techav-homebrew/PikaPC/README.md

PikaPC Logo

# PikaPC

A PowerPC 403GA Homebrew Computer
