techav-homebrew/PikaPC/Software/ppcforth-0.42b/ppcforth.pdf

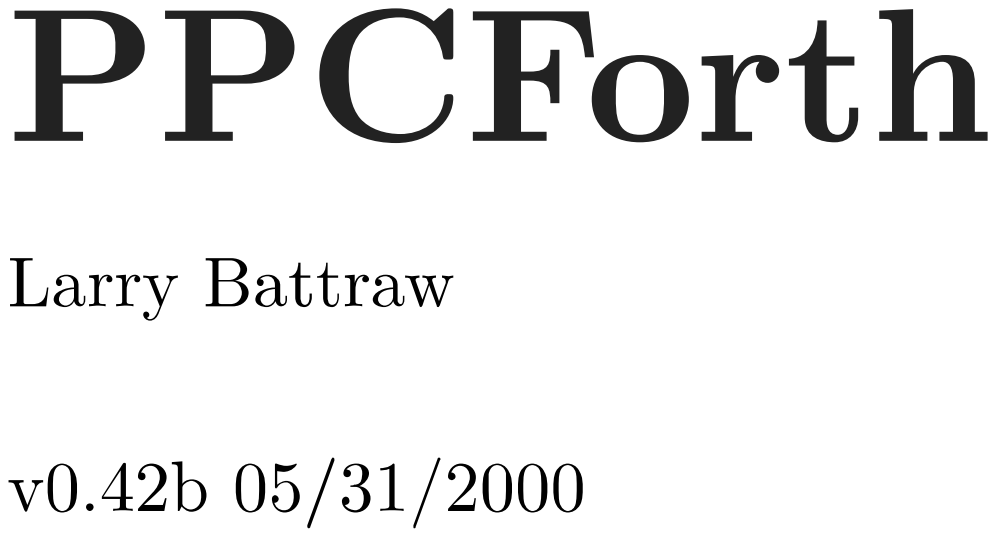
[picture p1: page 1]

@ | ! | emit | key

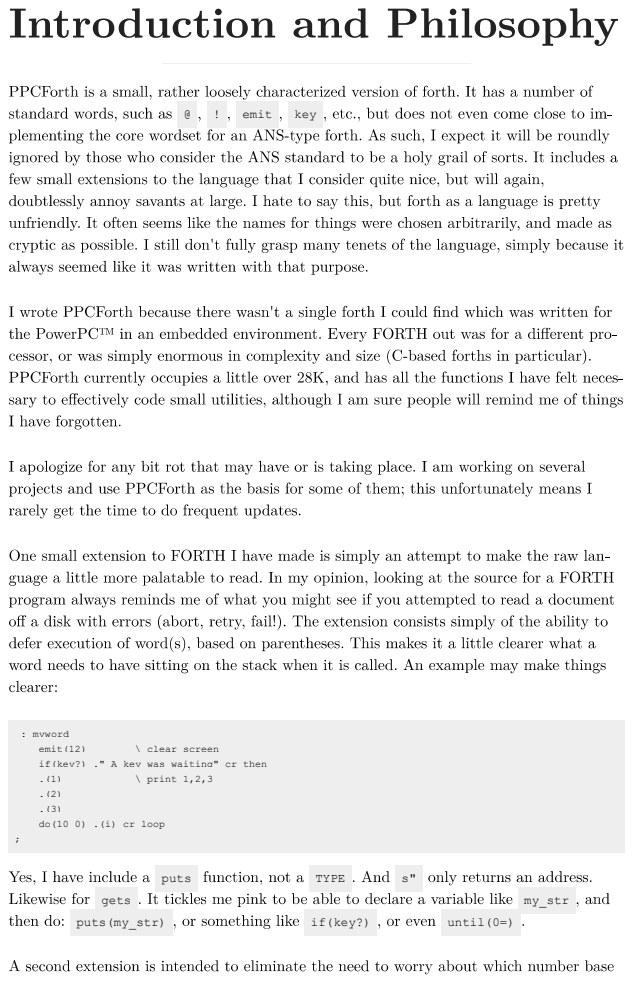
[picture p2: page 2]
emit(12); \ clear screen; \ print 1,2,3; puts; TYPE; gets; my_str; puts(my_str); if(key?); until(0=)

: myword
if(key?) ." A key was waiting" cr then
do(10 0) .(i) cr loop

0x | $
% | # | 0x | $ | #

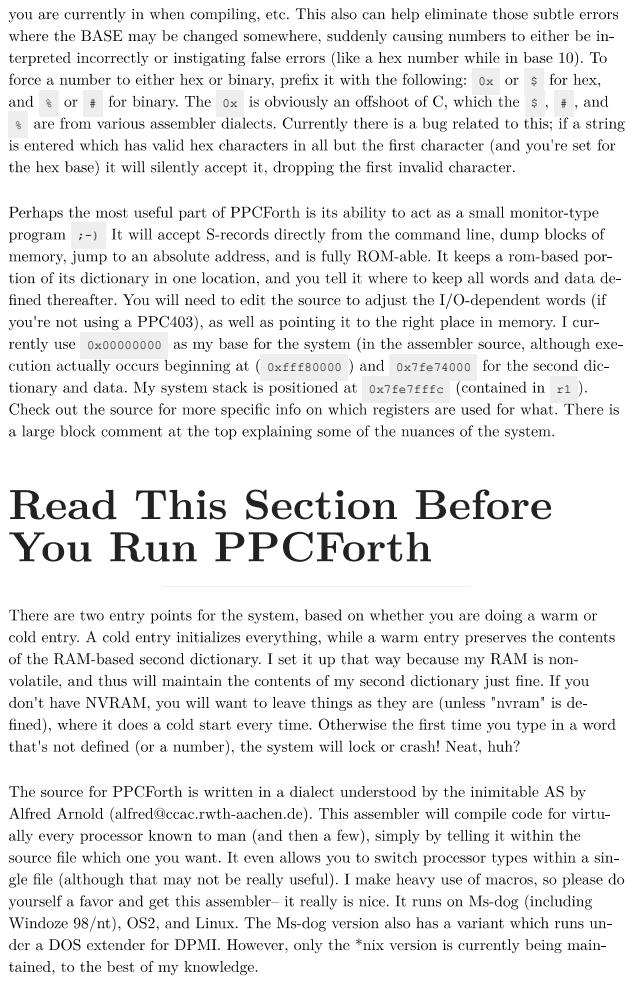
[picture p3: page 3]
0xfff80000; 0x7fe7fffc

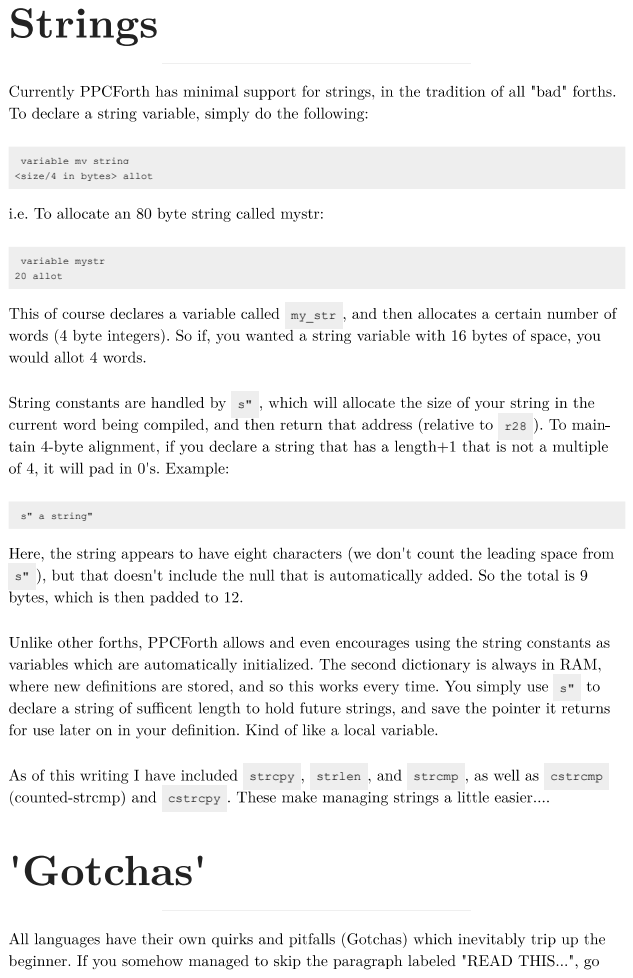
[picture p4: page 4]
variable mystr 20 allot; my_str; s" a string"; strcpy; strlen; strcmp; cstrcmp; cstrcpy

variable my_string
<size/4 in bytes> allot

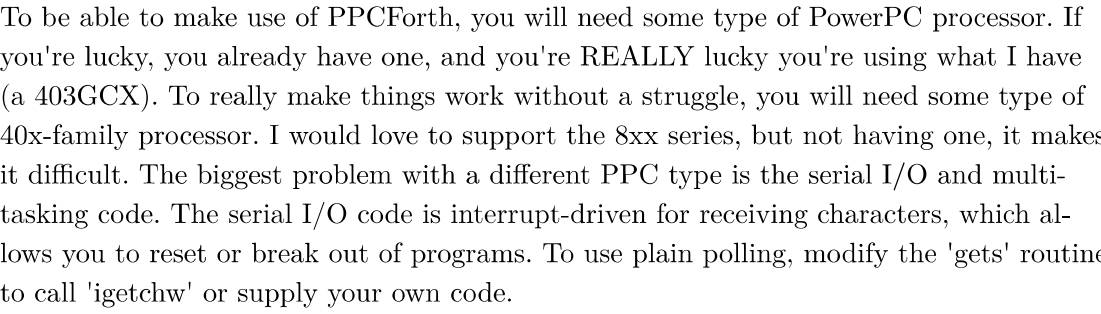
[picture p5: figure]

<32-bit value representing total length of word>
<32-bit value representing combined length of word's name and PFA> <null terminated ASCII string of word's name; padded to 4-alignment> <PFA- parameter field; contains flags specifying the word's type> <data or code field; contains the executable code or data of the word>

<callback time in clock ticks>
<preempt time in clock ticks>
<priority (lower number==greater priority)>

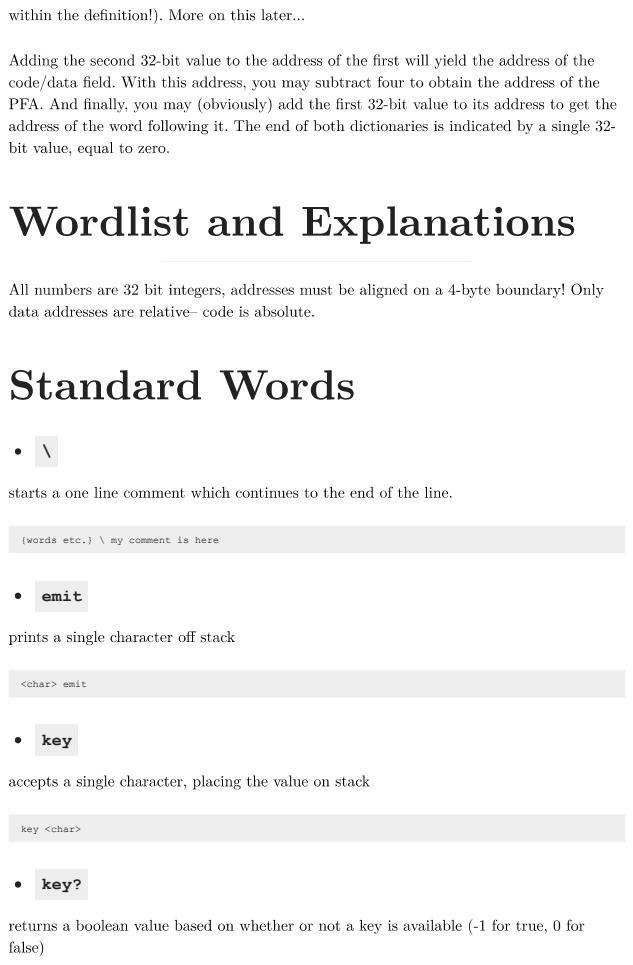
[picture p6: page 6]
emit; <char> emit; key; key <char>; key?

{words etc.} \ my comment is here

## cls

## puts

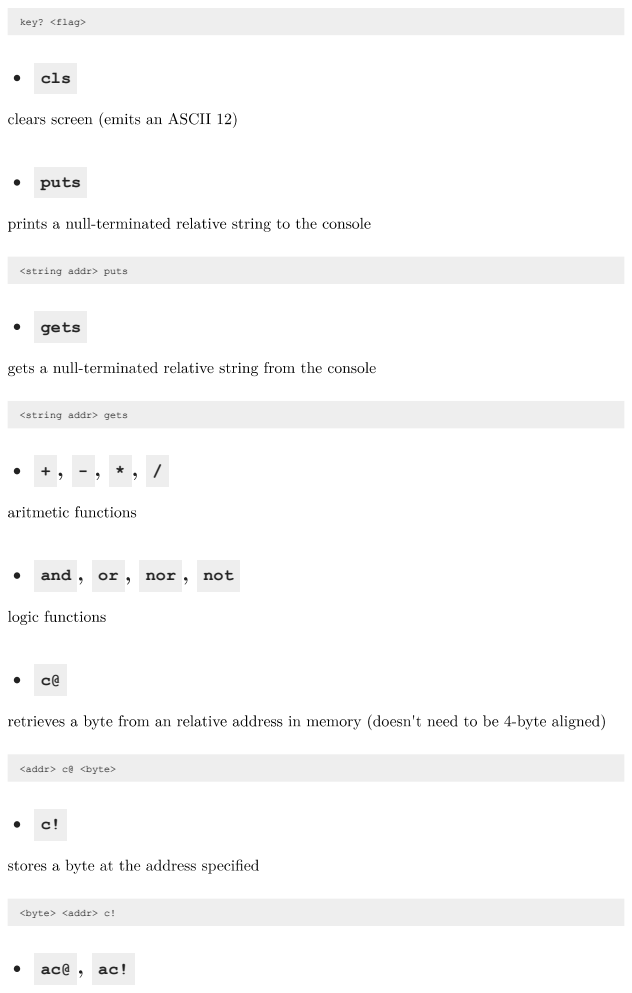
[picture p7: page 7]
key? <flag>; gets; and; nor; not; <addr> c@ <byte>; <byte> <addr> c!

<string addr> puts

<string addr> gets

@

!

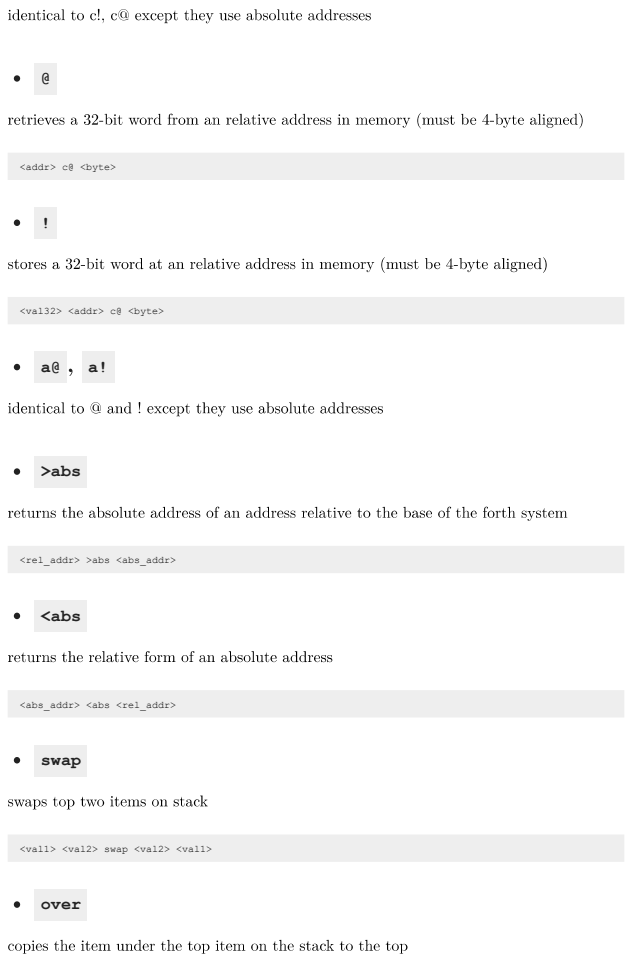
[picture p8: page 8]
<addr> c@ <byte>; <val32> <addr> c@ <byte>; >abs; <rel_addr> >abs <abs_addr>; <abs; <abs_addr> <abs <rel_addr>; swap; <val1> <val2> swap <val2> <val1>; over

>R

R>

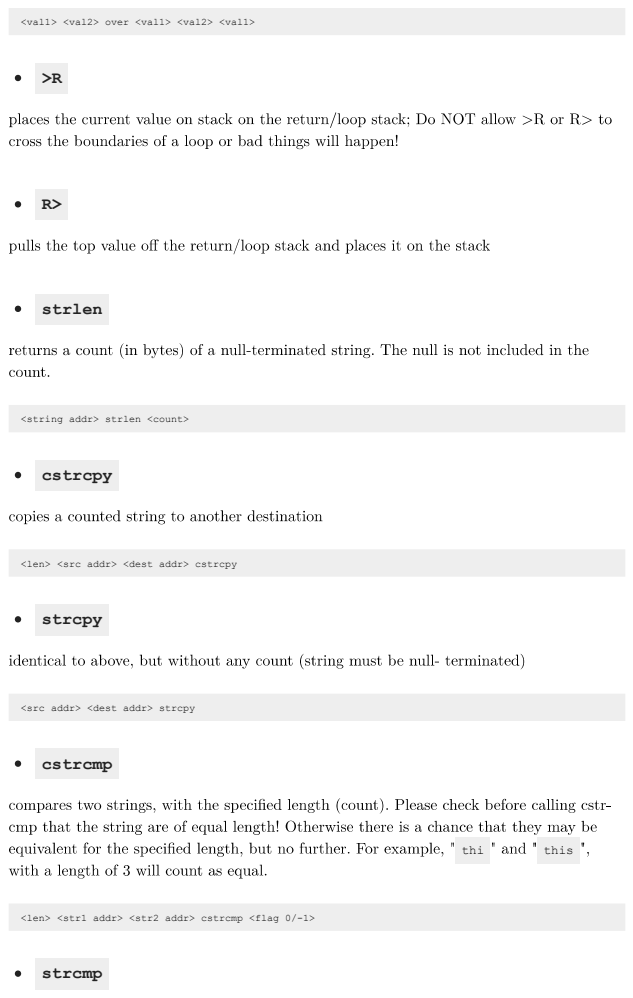
[picture p9: page 9]
<val1> <val2> over <val1> <val2> <val1>; strlen; cstrcpy; strcpy; cstrcmp; thi; this; strcmp

<string addr> strlen <count>

<len> <src addr> <dest addr> cstrcpy

<src addr> <dest addr> strcpy

<len> <str1 addr> <str2 addr> cstrcmp <flag 0/-1>

1- | 2- | 4- | 1+ | 2+ | 4+

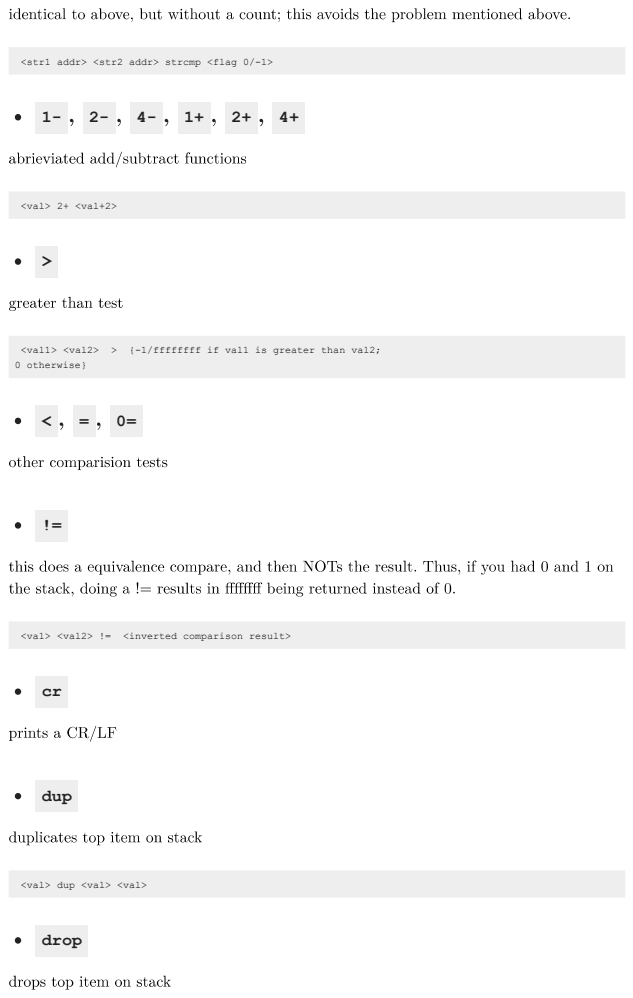
[picture p10: page 10]
<val> 2+ <val+2>; dup; drop

<str1 addr> <str2 addr> strcmp <flag 0/-1>

<val1> <val2> > {-1/ffffffff if val1 is greater than val2;
0 otherwise}

<va1> <val2> != <inverted comparison result>

<val> dup <val> <val>

## sbuf

## base

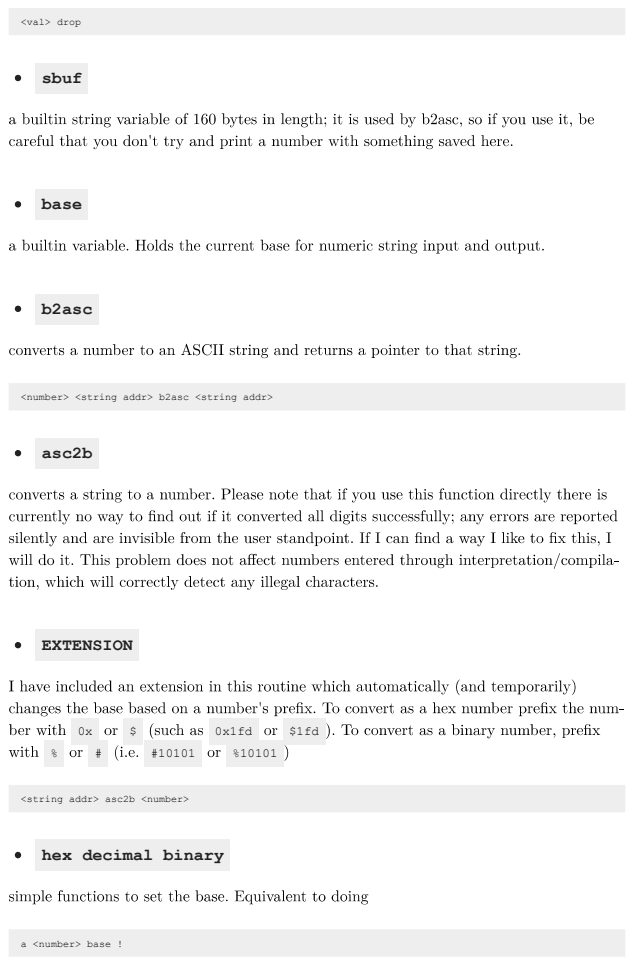
[picture p11: page 11]
<val> drop; b2asc; asc2b; EXTENSION; a <number> base !

<number> <string addr> b2asc <string addr>

<string addr> asc2b <number>

hex decimal binary

,

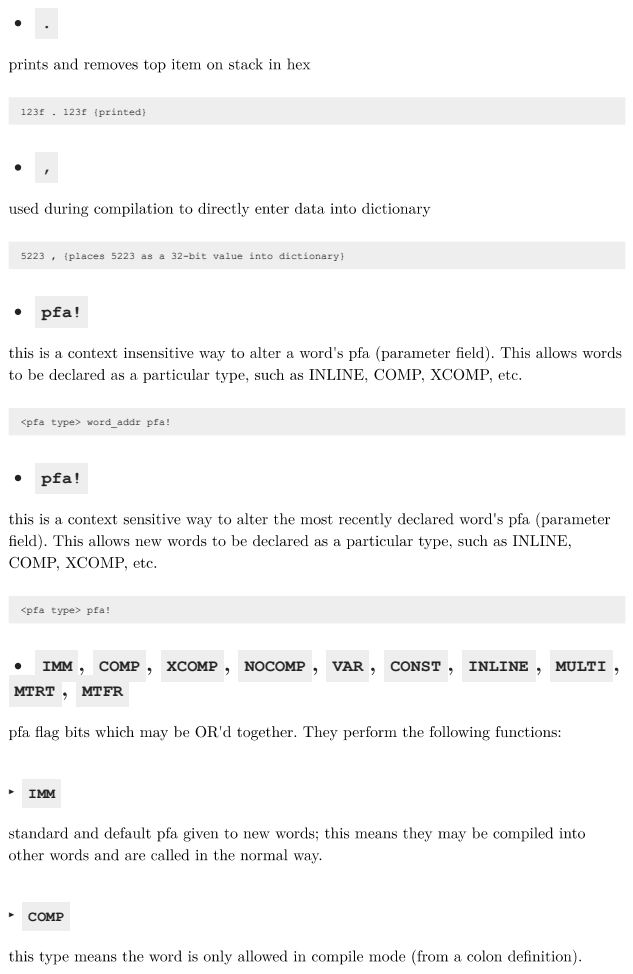
[picture p12: page 12]
123f . 123f {printed}; pfa!; IMM; COMP; XCOMP; NOCOMP; VAR; CONST; INLINE; MULTI; MTRT; MTFR; ‣ IMM; ‣ COMP

5223 , {places 5223 as a 32-bit value into dictionary}

<pfa type> word_addr pfa!

<pfa type> pfa!

## - XCOMP

## - NOCOMP

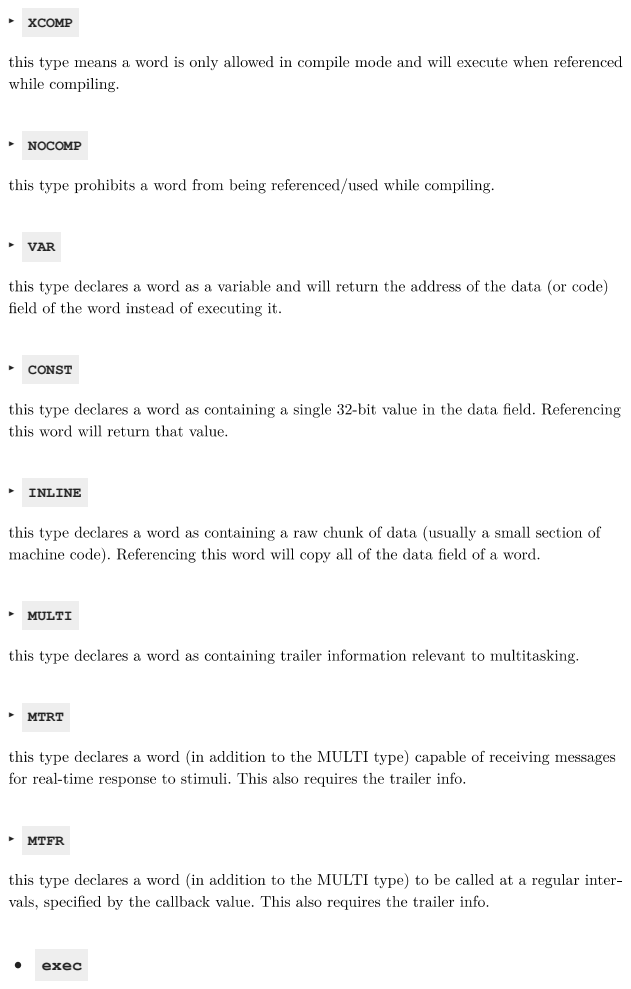
[picture p13: page 13]
‣ VAR; ‣ CONST; ‣ INLINE; ‣ MULTI; ‣ MTRT; ‣ MTFR; exec

## create

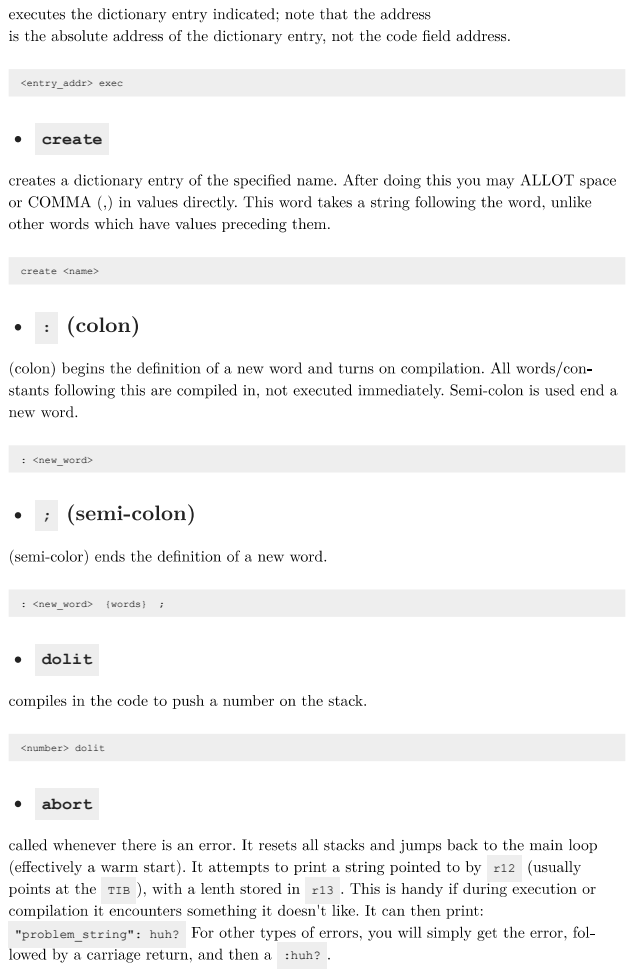
[picture p14: page 14]
<entry_addr> exec; create <name>; : <new_word>; : <new_word> {words} ;; dolit; <number> dolit; abort; TIB; "problem_string": huh?; :huh?

## if else then

### <flag> if {code} else {code} then

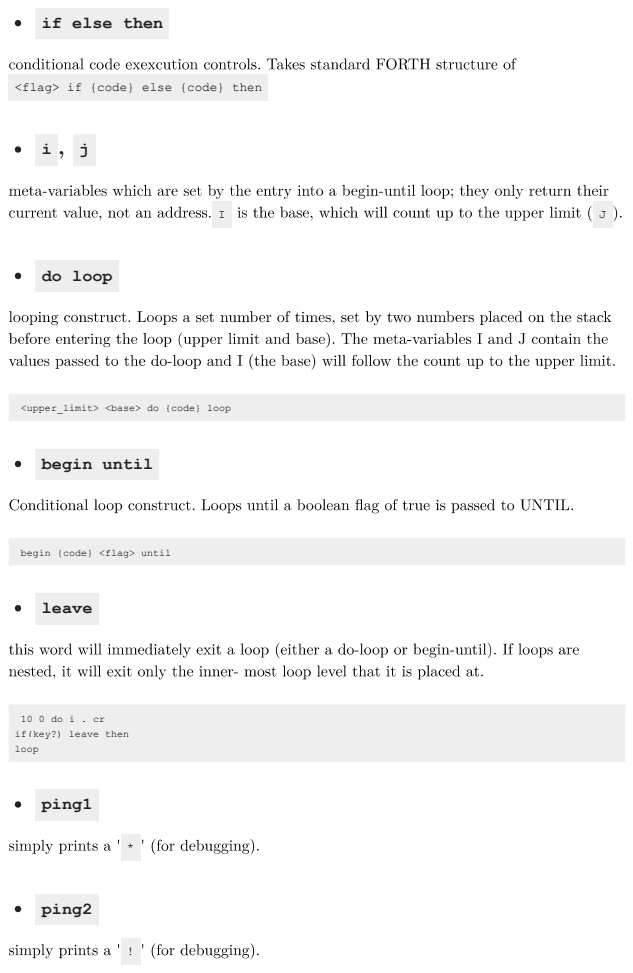
[picture p15: page 15]
do loop; begin until; leave; ping1; ping2

<upper_limit> <base> do {code} loop

begin {code} <flag> until

if(key?) leave then
loop

## words

.s

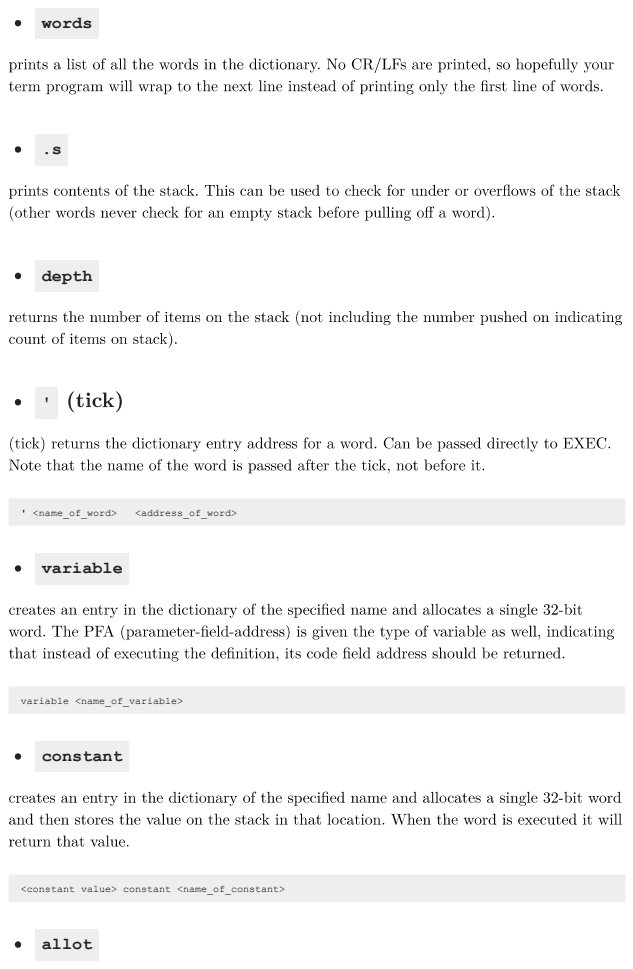
[picture p16: page 16]
depth; ' <name_of_word>; <address_of_word>; variable; variable <name_of_variable>; constant; allot

<constant value> constant <name_of_constant>

## string

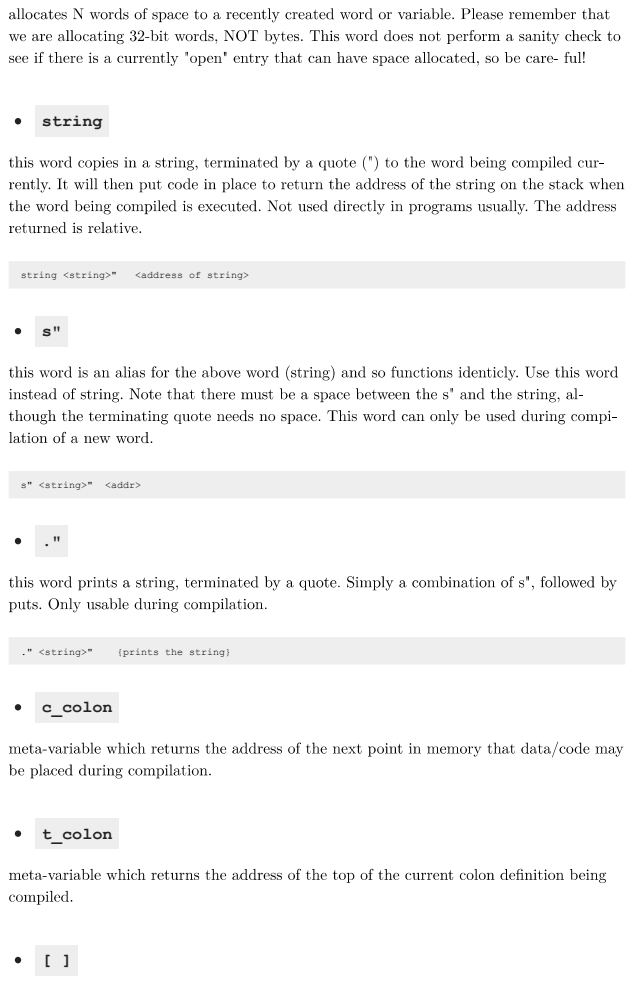
[picture p17: page 17]
string <string>"; <address of string>; s" <string>" <addr>; ." <string>"; {prints the string}; c_colon; t_colon

## forget

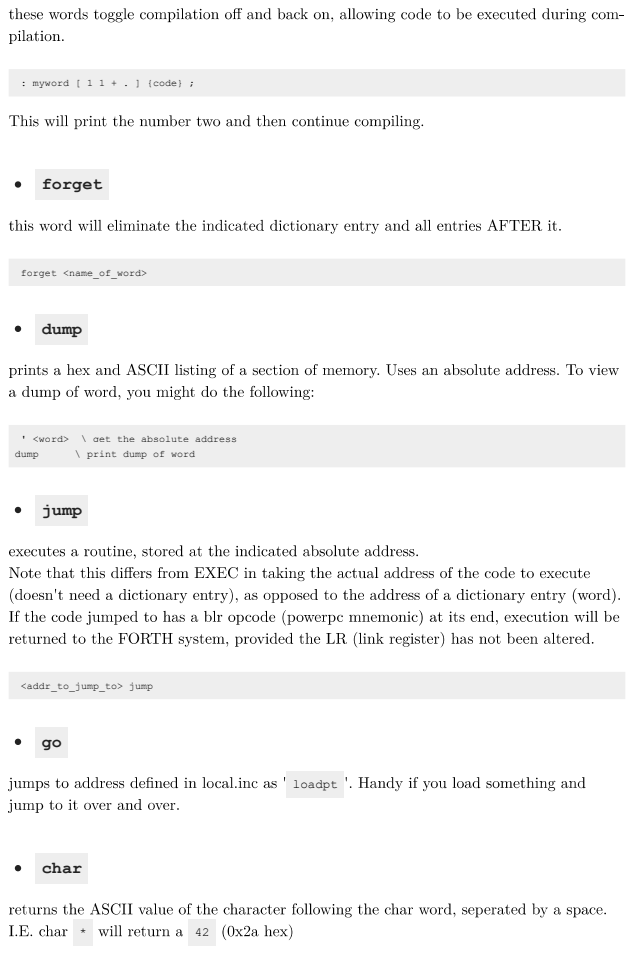
[picture p18: page 18]
: myword [ 1 1 + . ] {code} ;; forget <name_of_word>; dump; \ print dump of word; jump; <addr_to_jump_to> jump; loadpt; char

' <word> \ get the absolute address

## cold

## warm

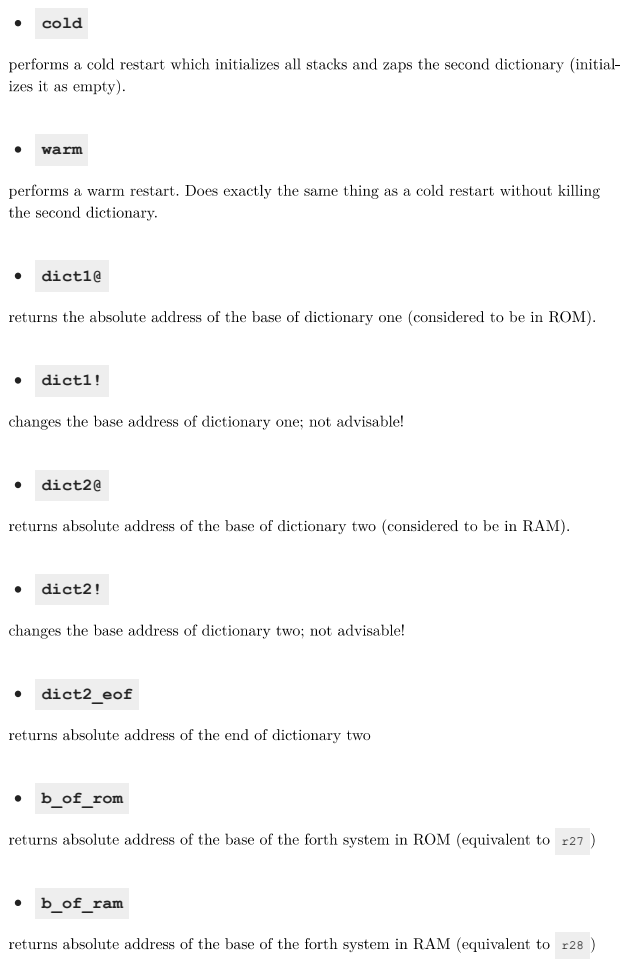
[picture p19: page 19]
dict1@; dict1!; dict2@; dict2!; dict2_eof; b_of_rom; b_of_ram

## <S Record>

S3 | S0

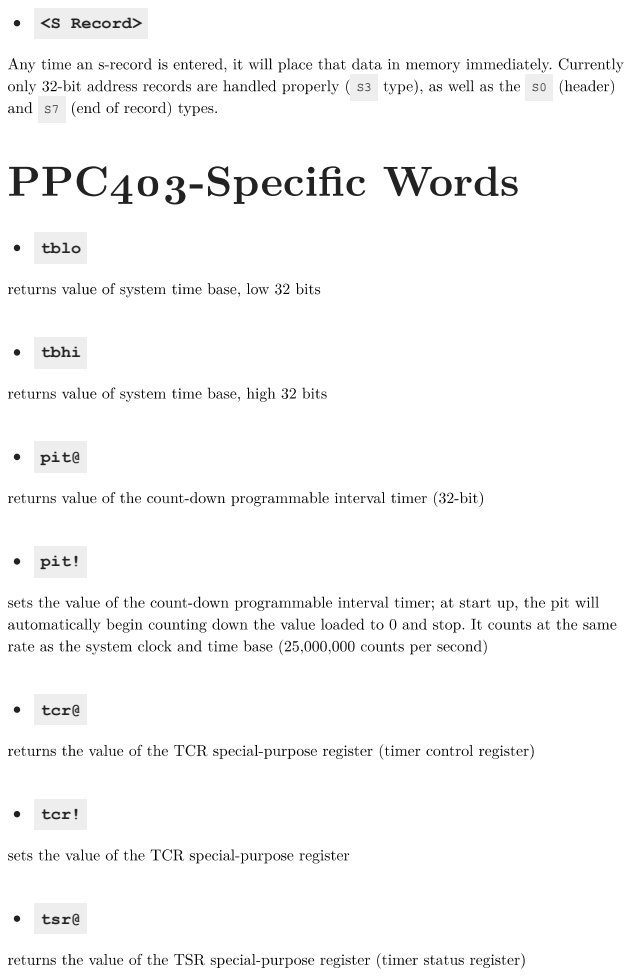
[picture p20: page 20]
tblo; tbhi; pit@; pit!; tcr@; tcr!; tsr@

## tsr!

## msr@

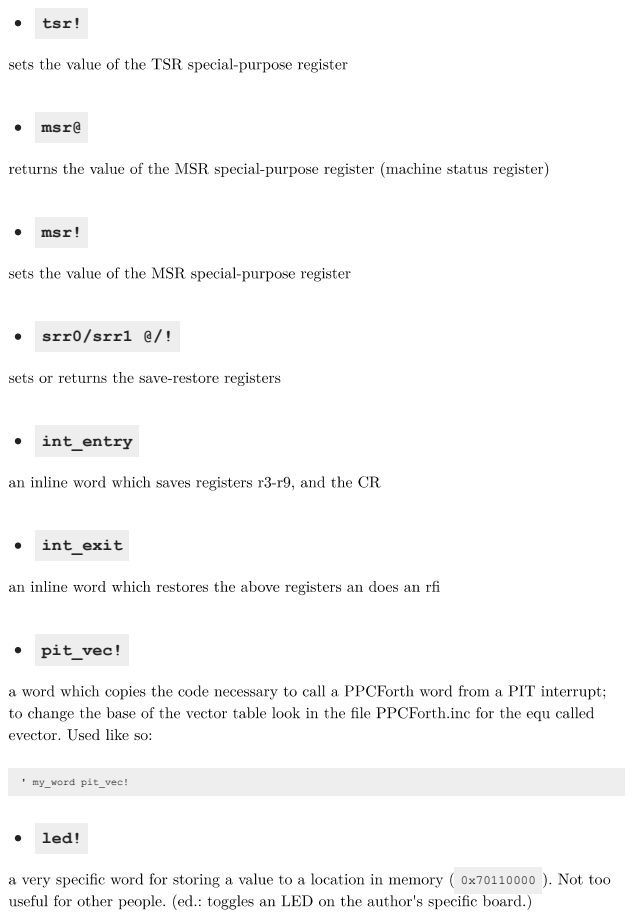
[picture p21: page 21]
msr!; srr0/srr1 @/!; int_entry; int_exit; pit_vec!; ' my_word pit_vec!; led!

## memcpy

## flashc!

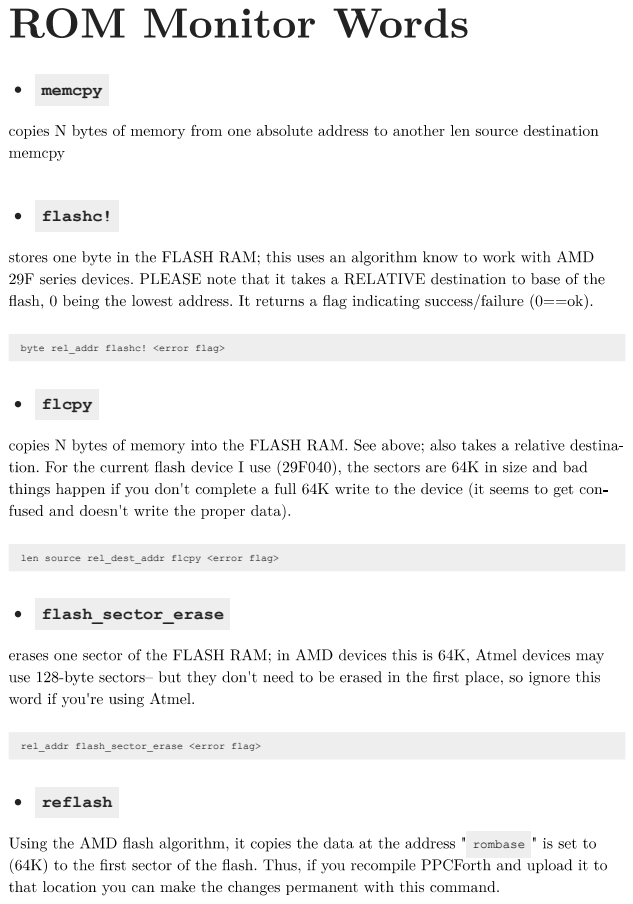
[picture p22: page 22]
flcpy; flash_sector_erase; rel_addr flash_sector_erase <error flag>; reflash; rombase

byte rel_addr flashc! <error flag>

len source rel_dest_addr flcpy <error flag>

## atmel_fwrite

### flcpy

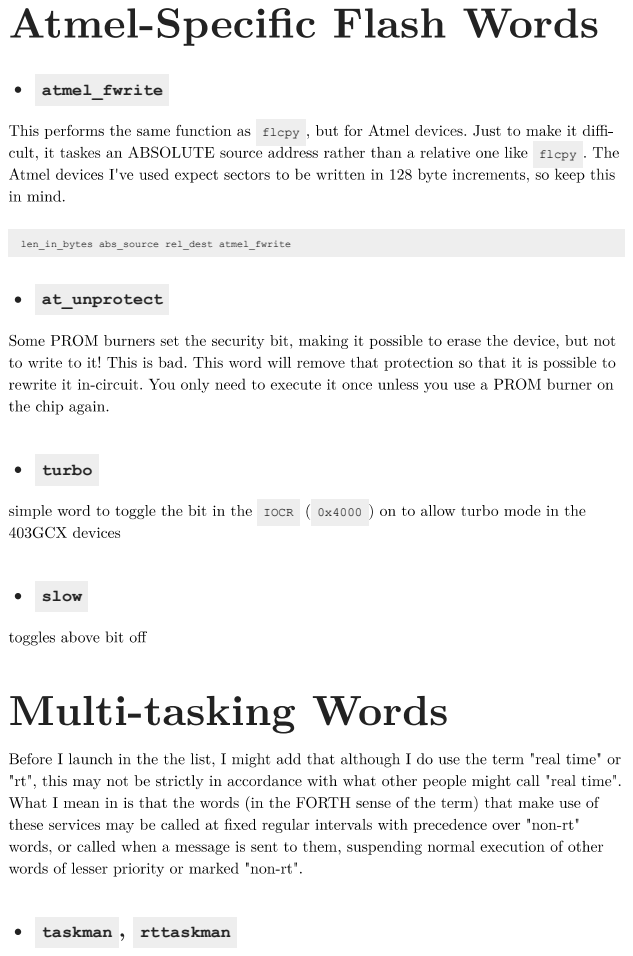
[picture p23: page 23]
flcpy; len_in_bytes abs_source rel_dest atmel_fwrite; at_unprotect; turbo; IOCR; slow; taskman; rttaskman

## sendmsg

### MTRT

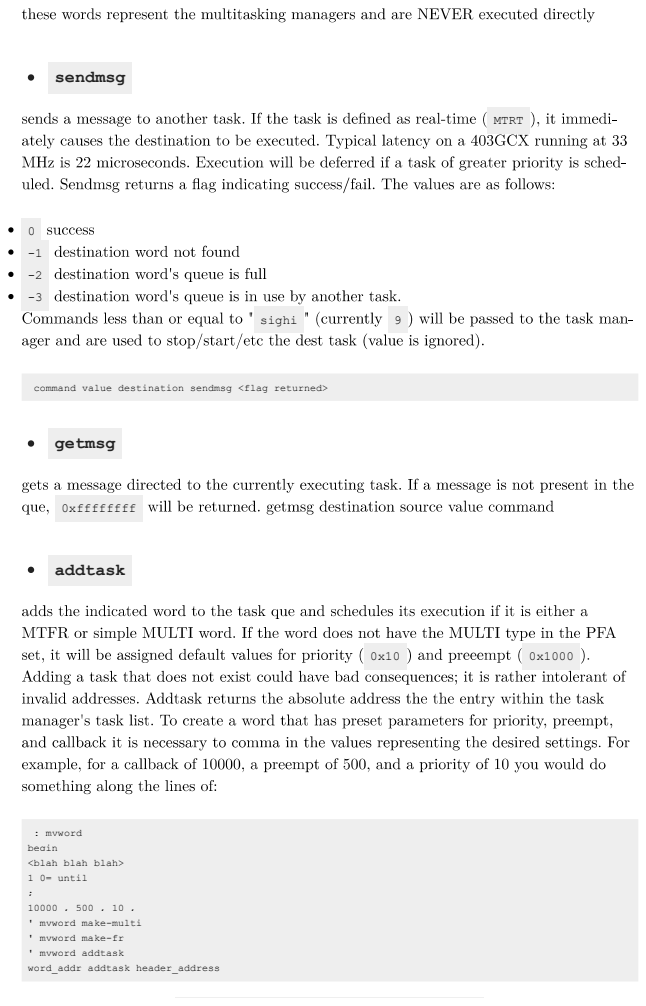
[picture p24: page 24]
sighi; getmsg; 0xffffffff; addtask

command value destination sendmsg <flag returned>

: myword
begin
<blah blah blah>
1 0= until
' myword make-multi
' myword make-fr
' myword addtask
word_addr addtask header_address
