techav-homebrew/PikaPC/Hardware/PikaPC_SRAM/PikaPC_SRAM.kicad_pcb

## KiCad design Hardware/PikaPC_SRAM/PikaPC_SRAM.kicad_pcb (2026-05-26)

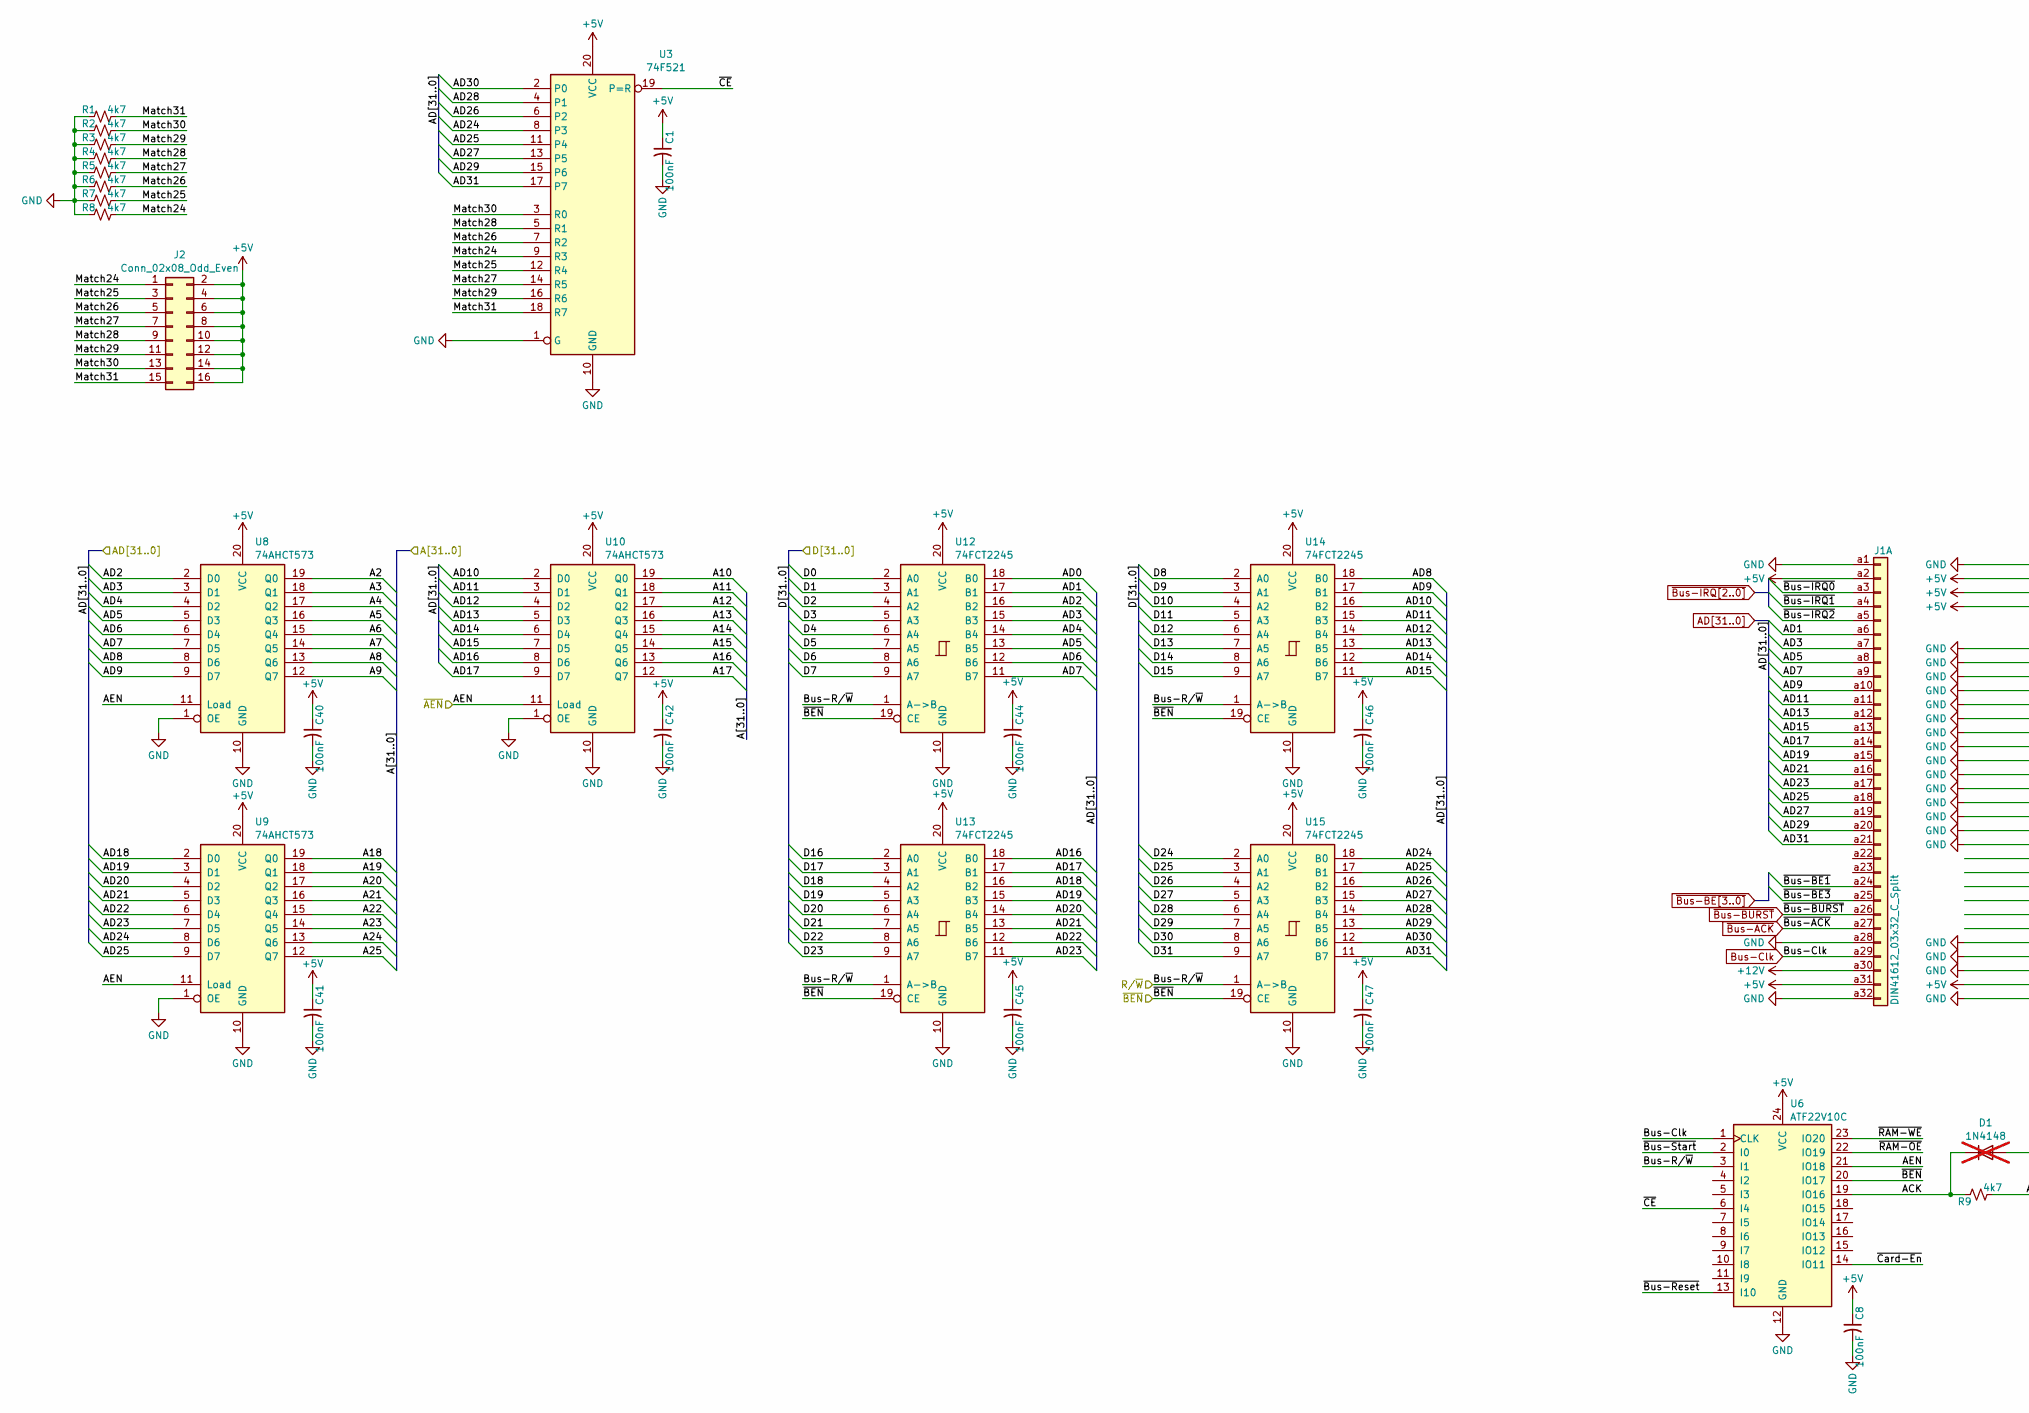
[picture p25: schematic PikaPC_SRAM.kicad_sch, part in row 1, column 1]

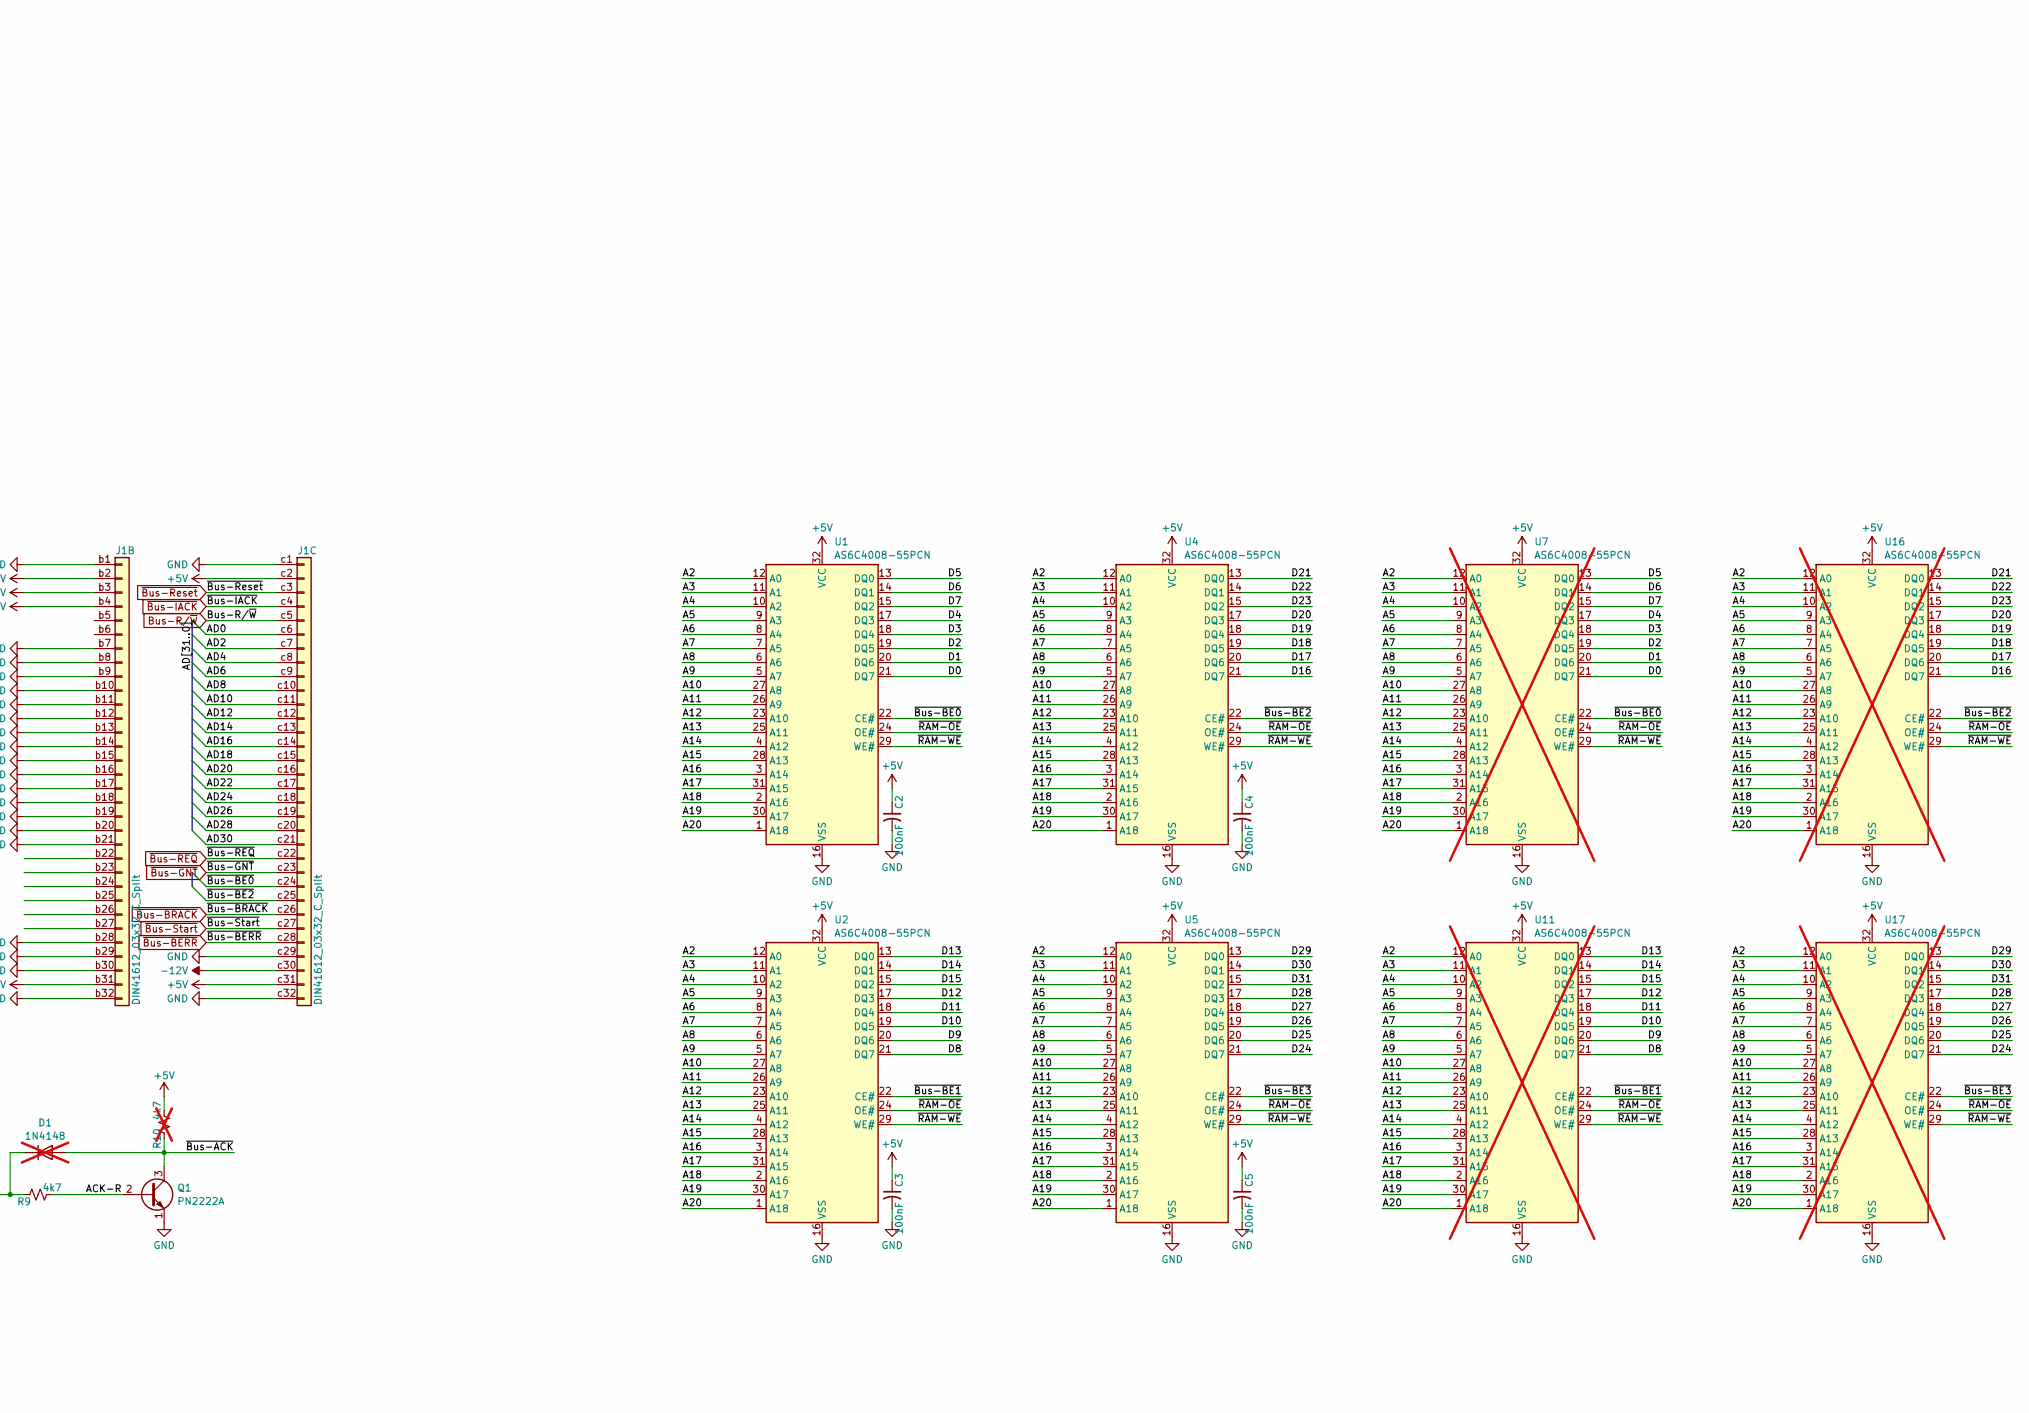
[picture p26: schematic PikaPC_SRAM.kicad_sch, part in row 1, column 2]

Parts:
C1, C2, C3, C4, C5, C8, C40, C41, C42, C44, C45, C46, C47: 100nF; C_0805_2012Metric; Mouser 187-CL21B104KACNNNC
D1: 1N4148; D_DO-35_SOD27_P7.62mm_Horizontal; not fitted
J1: DIN41612_03x32_C_Split; DIN41612_C_3x32_Male_Horizontal_THT
J2: Conn_02x08_Odd_Even; PinHeader_2x08_P2.54mm_Vertical
Q1: PN2222A; TO-92_Inline
R1, R2, R3, R4, R5, R6, R7, R8, R9: 4k7; R_0805_2012Metric; Mouser 303-0805W8J0472T5E
R10: 4k7; R_0805_2012Metric; Mouser 303-0805W8J0472T5E; not fitted
U1, U2, U4, U5: AS6C4008-55PCN; DIP-32_W15.24mm
U3: 74F521; SOIC-20W_7.5x12.8mm_P1.27mm; Mouser 595-SN74F521DWR
U6: ATF22V10C; DIP-24_W7.62mm_Socket; Mouser 556-ATF22V10C-10PU
U7, U11, U16, U17: AS6C4008-55PCN; SOP-32_11.305x20.495mm_P1.27mm; not fitted
U8, U9, U10: 74AHCT573; TSSOP-20_4.4x6.5mm_P0.65mm; Mouser 771-74AHCT573PW-T
U12, U13, U14, U15: 74FCT2245; SOIC-20W_7.5x12.8mm_P1.27mm; Mouser 595-CY74FCT2245TSOCT

Connections:
+5V: C1.1, C2.1, C3.1, C4.1, C5.1, C8.1, C40.1, C41.1, C42.1, C44.1, C45.1, C46.1, C47.1, J1.a2, J1.a31, J1.b2, J1.b3, J1.b4, J1.b31, J1.c2, J1.c31, J2.2, J2.4, J2.6, J2.8, J2.10, J2.12, J2.14, J2.16, R10.2, U1.32 (VCC), U2.32 (VCC), U3.20 (VCC), U4.32 (VCC), U5.32 (VCC), U6.24 (VCC), U7.32 (VCC), U8.20 (VCC), U9.20 (VCC), U10.20 (VCC), U11.32 (VCC), U12.20 (VCC), U13.20 (VCC), U14.20 (VCC), U15.20 (VCC), U16.32 (VCC), U17.32 (VCC)
+12V: J1.a30
-12V: J1.c30
/A2: U1.12 (A0), U2.12 (A0), U4.12 (A0), U5.12 (A0), U7.12 (A0), U8.19 (Q0), U11.12 (A0), U16.12 (A0), U17.12 (A0)
/A3: U1.11 (A1), U2.11 (A1), U4.11 (A1), U5.11 (A1), U7.11 (A1), U8.18 (Q1), U11.11 (A1), U16.11 (A1), U17.11 (A1)
/A4: U1.10 (A2), U2.10 (A2), U4.10 (A2), U5.10 (A2), U7.10 (A2), U8.17 (Q2), U11.10 (A2), U16.10 (A2), U17.10 (A2)
/A5: U1.9 (A3), U2.9 (A3), U4.9 (A3), U5.9 (A3), U7.9 (A3), U8.16 (Q3), U11.9 (A3), U16.9 (A3), U17.9 (A3)
/A6: U1.8 (A4), U2.8 (A4), U4.8 (A4), U5.8 (A4), U7.8 (A4), U8.15 (Q4), U11.8 (A4), U16.8 (A4), U17.8 (A4)
/A7: U1.7 (A5), U2.7 (A5), U4.7 (A5), U5.7 (A5), U7.7 (A5), U8.14 (Q5), U11.7 (A5), U16.7 (A5), U17.7 (A5)
/A8: U1.6 (A6), U2.6 (A6), U4.6 (A6), U5.6 (A6), U7.6 (A6), U8.13 (Q6), U11.6 (A6), U16.6 (A6), U17.6 (A6)
/A9: U1.5 (A7), U2.5 (A7), U4.5 (A7), U5.5 (A7), U7.5 (A7), U8.12 (Q7), U11.5 (A7), U16.5 (A7), U17.5 (A7)
/A10: U1.27 (A8), U2.27 (A8), U4.27 (A8), U5.27 (A8), U7.27 (A8), U10.19 (Q0), U11.27 (A8), U16.27 (A8), U17.27 (A8)
/A11: U1.26 (A9), U2.26 (A9), U4.26 (A9), U5.26 (A9), U7.26 (A9), U10.18 (Q1), U11.26 (A9), U16.26 (A9), U17.26 (A9)
/A12: U1.23 (A10), U2.23 (A10), U4.23 (A10), U5.23 (A10), U7.23 (A10), U10.17 (Q2), U11.23 (A10), U16.23 (A10), U17.23 (A10)
/A13: U1.25 (A11), U2.25 (A11), U4.25 (A11), U5.25 (A11), U7.25 (A11), U10.16 (Q3), U11.25 (A11), U16.25 (A11), U17.25 (A11)
/A14: U1.4 (A12), U2.4 (A12), U4.4 (A12), U5.4 (A12), U7.4 (A12), U10.15 (Q4), U11.4 (A12), U16.4 (A12), U17.4 (A12)
/A15: U1.28 (A13), U2.28 (A13), U4.28 (A13), U5.28 (A13), U7.28 (A13), U10.14 (Q5), U11.28 (A13), U16.28 (A13), U17.28 (A13)
/A16: U1.3 (A14), U2.3 (A14), U4.3 (A14), U5.3 (A14), U7.3 (A14), U10.13 (Q6), U11.3 (A14), U16.3 (A14), U17.3 (A14)
/A17: U1.31 (A15), U2.31 (A15), U4.31 (A15), U5.31 (A15), U7.31 (A15), U10.12 (Q7), U11.31 (A15), U16.31 (A15), U17.31 (A15)
/A18: U1.2 (A16), U2.2 (A16), U4.2 (A16), U5.2 (A16), U7.2 (A16), U9.19 (Q0), U11.2 (A16), U16.2 (A16), U17.2 (A16)
/A19: U1.30 (A17), U2.30 (A17), U4.30 (A17), U5.30 (A17), U7.30 (A17), U9.18 (Q1), U11.30 (A17), U16.30 (A17), U17.30 (A17)
/A20: U1.1 (A18), U2.1 (A18), U4.1 (A18), U5.1 (A18), U7.1 (A18), U9.17 (Q2), U11.1 (A18), U16.1 (A18), U17.1 (A18)
/A21: U9.16 (Q3)
/A22: U9.15 (Q4)
/A23: U9.14 (Q5)
/A24: U9.13 (Q6)
/A25: U9.12 (Q7)
/ACK: D1.1 (K), R9.1, U6.19 (IO16)
/ACK-R: Q1.2 (B), R9.2
/AEN: U6.21 (IO18), U8.11 (Load), U9.11 (Load), U10.11 (Load)
/D0: U1.21 (DQ7), U7.21 (DQ7), U12.2 (A0)
/D1: U1.20 (DQ6), U7.20 (DQ6), U12.3 (A1)
/D2: U1.19 (DQ5), U7.19 (DQ5), U12.4 (A2)
/D3: U1.18 (DQ4), U7.18 (DQ4), U12.5 (A3)
/D4: U1.17 (DQ3), U7.17 (DQ3), U12.6 (A4)
/D5: U1.13 (DQ0), U7.13 (DQ0), U12.7 (A5)
/D6: U1.14 (DQ1), U7.14 (DQ1), U12.8 (A6)
/D7: U1.15 (DQ2), U7.15 (DQ2), U12.9 (A7)
/D8: U2.21 (DQ7), U11.21 (DQ7), U14.2 (A0)
/D9: U2.20 (DQ6), U11.20 (DQ6), U14.3 (A1)
/D10: U2.19 (DQ5), U11.19 (DQ5), U14.4 (A2)
/D11: U2.18 (DQ4), U11.18 (DQ4), U14.5 (A3)
/D12: U2.17 (DQ3), U11.17 (DQ3), U14.6 (A4)
/D13: U2.13 (DQ0), U11.13 (DQ0), U14.7 (A5)
/D14: U2.14 (DQ1), U11.14 (DQ1), U14.8 (A6)
/D15: U2.15 (DQ2), U11.15 (DQ2), U14.9 (A7)
/D16: U4.21 (DQ7), U13.2 (A0), U16.21 (DQ7)
/D17: U4.20 (DQ6), U13.3 (A1), U16.20 (DQ6)
/D18: U4.19 (DQ5), U13.4 (A2), U16.19 (DQ5)
/D19: U4.18 (DQ4), U13.5 (A3), U16.18 (DQ4)
/D20: U4.17 (DQ3), U13.6 (A4), U16.17 (DQ3)
/D21: U4.13 (DQ0), U13.7 (A5), U16.13 (DQ0)
/D22: U4.14 (DQ1), U13.8 (A6), U16.14 (DQ1)
/D23: U4.15 (DQ2), U13.9 (A7), U16.15 (DQ2)
/D24: U5.21 (DQ7), U15.2 (A0), U17.21 (DQ7)
/D25: U5.20 (DQ6), U15.3 (A1), U17.20 (DQ6)
/D26: U5.19 (DQ5), U15.4 (A2), U17.19 (DQ5)
/D27: U5.18 (DQ4), U15.5 (A3), U17.18 (DQ4)
/D28: U5.17 (DQ3), U15.6 (A4), U17.17 (DQ3)
/D29: U5.13 (DQ0), U15.7 (A5), U17.13 (DQ0)
/D30: U5.14 (DQ1), U15.8 (A6), U17.14 (DQ1)
/D31: U5.15 (DQ2), U15.9 (A7), U17.15 (DQ2)
/Match24: J2.1, R8.2, U3.9 (R3)
/Match25: J2.3, R7.2, U3.12 (R4)
/Match26: J2.5, R6.2, U3.7 (R2)
/Match27: J2.7, R5.2, U3.14 (R5)
/Match28: J2.9, R4.2, U3.5 (R1)
/Match29: J2.11, R3.2, U3.16 (R6)
/Match30: J2.13, R2.2, U3.3 (R0)
/Match31: J2.15, R1.2, U3.18 (R7)
/~BEN: U6.20 (IO17), U12.19 (CE), U13.19 (CE), U14.19 (CE), U15.19 (CE)
/~CE: U3.19 (P=R), U6.6 (I4)
/~Card-En: U6.14 (IO11)
/~RAM-OE: U1.24 (OE#), U2.24 (OE#), U4.24 (OE#), U5.24 (OE#), U6.22 (IO19), U7.24 (OE#), U11.24 (OE#), U16.24 (OE#), U17.24 (OE#)
/~RAM-WE: U1.29 (WE#), U2.29 (WE#), U4.29 (WE#), U5.29 (WE#), U6.23 (IO20), U7.29 (WE#), U11.29 (WE#), U16.29 (WE#), U17.29 (WE#)
AD0: J1.c6, U12.18 (B0)
AD1: J1.a6, U12.17 (B1)
AD2: J1.c7, U8.2 (D0), U12.16 (B2)
AD3: J1.a7, U8.3 (D1), U12.15 (B3)
AD4: J1.c8, U8.4 (D2), U12.14 (B4)
AD5: J1.a8, U8.5 (D3), U12.13 (B5)
AD6: J1.c9, U8.6 (D4), U12.12 (B6)
AD7: J1.a9, U8.7 (D5), U12.11 (B7)
AD8: J1.c10, U8.8 (D6), U14.18 (B0)
AD9: J1.a10, U8.9 (D7), U14.17 (B1)
AD10: J1.c11, U10.2 (D0), U14.16 (B2)
AD11: J1.a11, U10.3 (D1), U14.15 (B3)
AD12: J1.c12, U10.4 (D2), U14.14 (B4)
AD13: J1.a12, U10.5 (D3), U14.13 (B5)
AD14: J1.c13, U10.6 (D4), U14.12 (B6)
AD15: J1.a13, U10.7 (D5), U14.11 (B7)
AD16: J1.c14, U10.8 (D6), U13.18 (B0)
AD17: J1.a14, U10.9 (D7), U13.17 (B1)
AD18: J1.c15, U9.2 (D0), U13.16 (B2)
AD19: J1.a15, U9.3 (D1), U13.15 (B3)
AD20: J1.c16, U9.4 (D2), U13.14 (B4)
AD21: J1.a16, U9.5 (D3), U13.13 (B5)
AD22: J1.c17, U9.6 (D4), U13.12 (B6)
AD23: J1.a17, U9.7 (D5), U13.11 (B7)
AD24: J1.c18, U3.8 (P3), U9.8 (D6), U15.18 (B0)
AD25: J1.a18, U3.11 (P4), U9.9 (D7), U15.17 (B1)
AD26: J1.c19, U3.6 (P2), U15.16 (B2)
AD27: J1.a19, U3.13 (P5), U15.15 (B3)
AD28: J1.c20, U3.4 (P1), U15.14 (B4)
AD29: J1.a20, U3.15 (P6), U15.13 (B5)
AD30: J1.c21, U3.2 (P0), U15.12 (B6)
AD31: J1.a21, U3.17 (P7), U15.11 (B7)
Bus-Clk: J1.a29, U6.1 (CLK)
Bus-R/~W: J1.c5, U6.3 (I1), U12.1 (A->B), U13.1 (A->B), U14.1 (A->B), U15.1 (A->B)
GND: C1.2, C2.2, C3.2, C4.2, C5.2, C8.2, C40.2, C41.2, C42.2, C44.2, C45.2, C46.2, C47.2, J1.a1, J1.a28, J1.a32, J1.b1, J1.b7, J1.b8, J1.b9, J1.b10, J1.b11, J1.b12, J1.b13, J1.b14, J1.b15, J1.b16, J1.b17, J1.b18, J1.b19, J1.b20, J1.b21, J1.b28, J1.b29, J1.b30, J1.b32, J1.c1, J1.c29, J1.c32, Q1.1 (E), R1.1, R2.1, R3.1, R4.1, R5.1, R6.1, R7.1, R8.1, U1.16 (VSS), U2.16 (VSS), U3.1 (G), U3.10 (GND), U4.16 (VSS), U5.16 (VSS), U6.12 (GND), U7.16 (VSS), U8.1 (OE), U8.10 (GND), U9.1 (OE), U9.10 (GND), U10.1 (OE), U10.10 (GND), U11.16 (VSS), U12.10 (GND), U13.10 (GND), U14.10 (GND), U15.10 (GND), U16.16 (VSS), U17.16 (VSS)
~Bus-ACK: D1.2 (A), J1.a27, Q1.3 (C), R10.1
~Bus-BE0: J1.c24, U1.22 (CE#), U7.22 (CE#)
~Bus-BE1: J1.a24, U2.22 (CE#), U11.22 (CE#)
~Bus-BE2: J1.c25, U4.22 (CE#), U16.22 (CE#)
~Bus-BE3: J1.a25, U5.22 (CE#), U17.22 (CE#)
~Bus-BERR: J1.c28
~Bus-BRACK: J1.c26
~Bus-BURST: J1.a26
~Bus-GNT: J1.c23
~Bus-IACK: J1.c4
~Bus-IRQ0: J1.a3
~Bus-IRQ1: J1.a4
~Bus-IRQ2: J1.a5
~Bus-REQ: J1.c22
~Bus-Reset: J1.c3, U6.13 (I10)
~Bus-Start: J1.c27, U6.2 (I0)

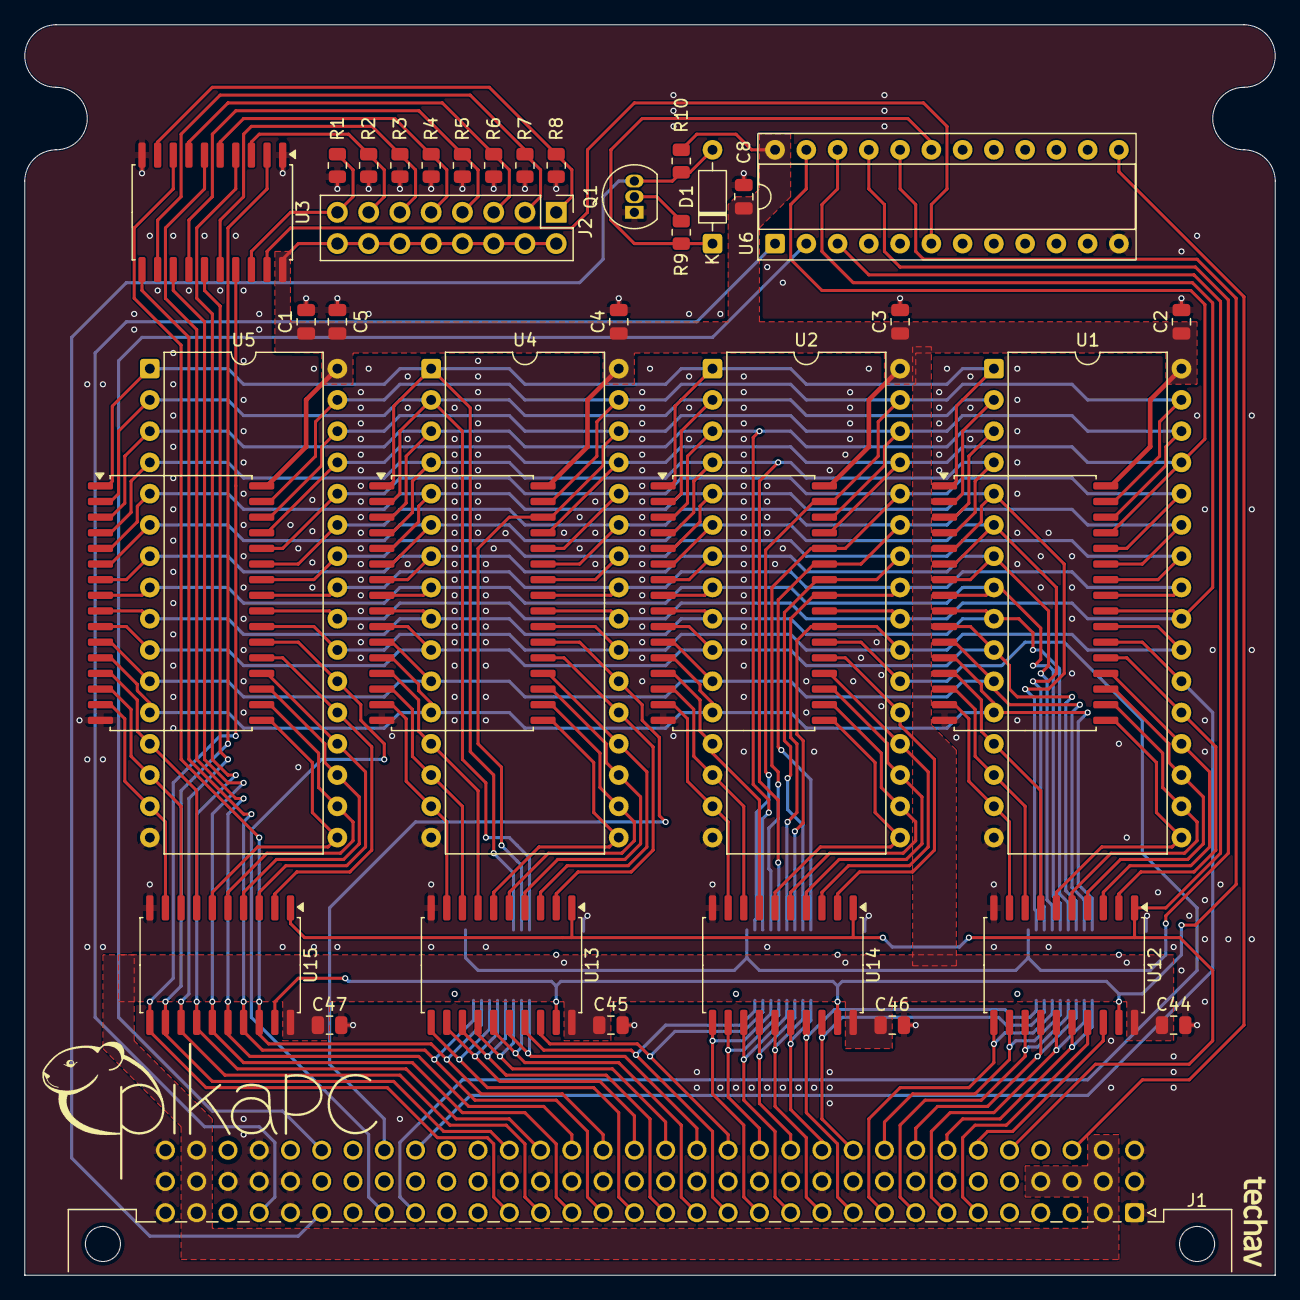
[picture p27: board PikaPC_SRAM.kicad_pcb from above]

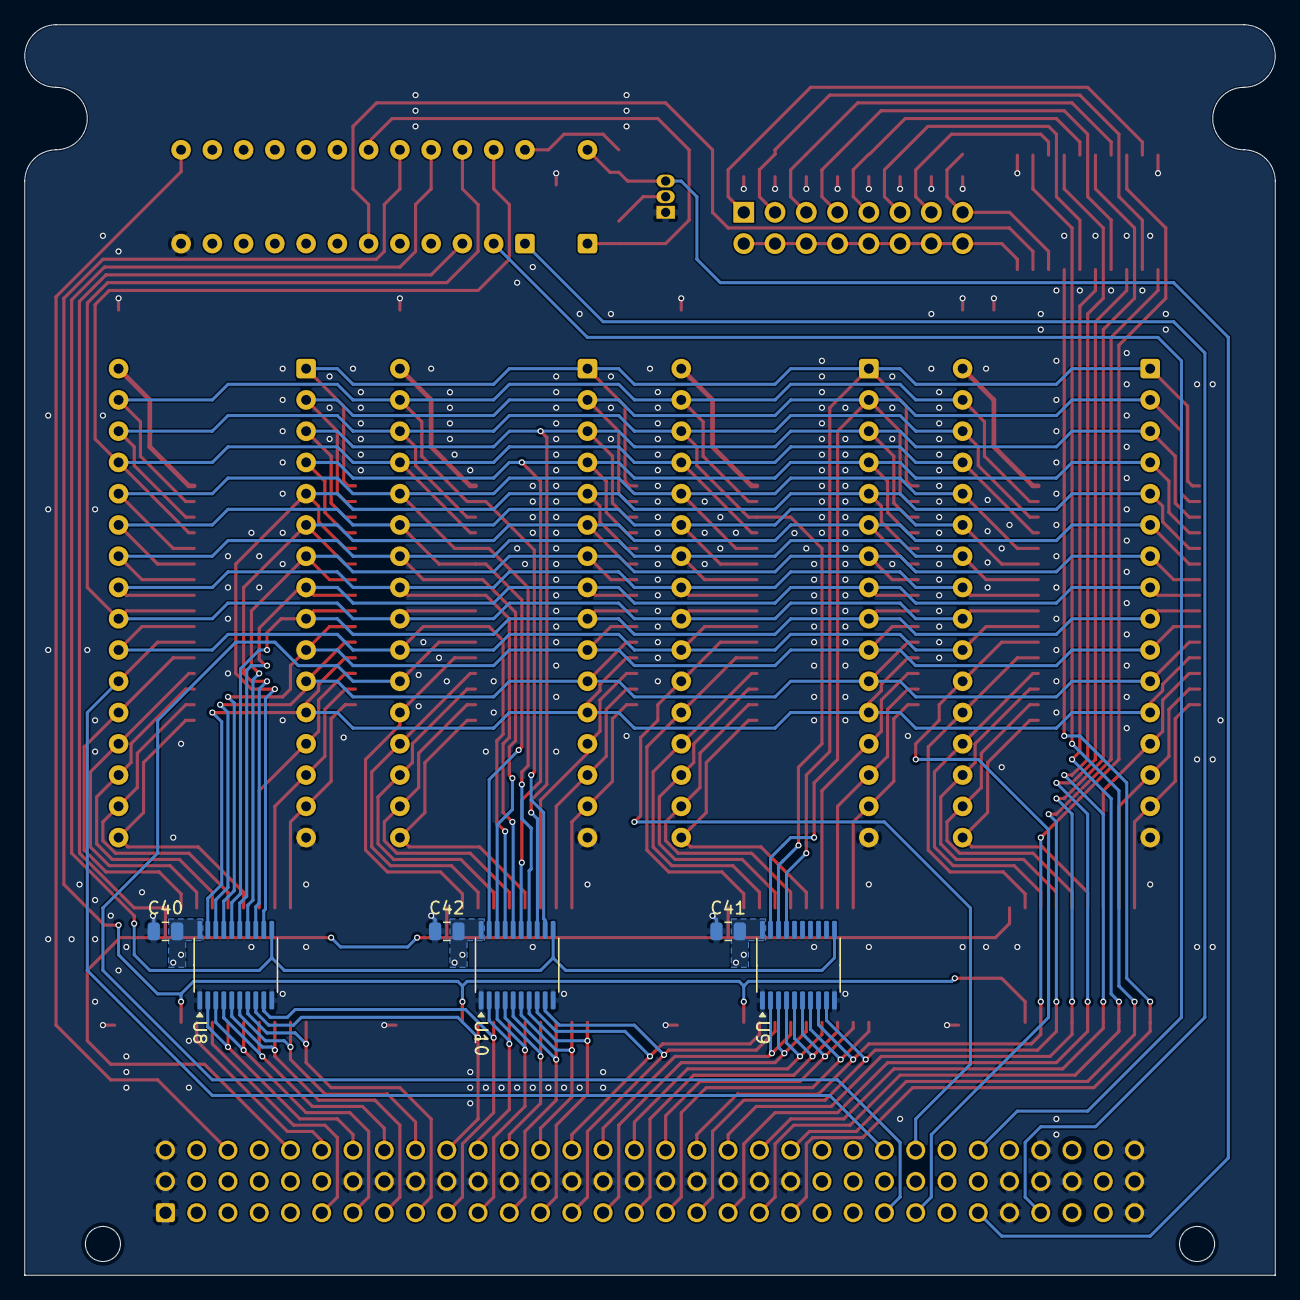
[picture p28: board PikaPC_SRAM.kicad_pcb from below]

Board: 2 copper layers, 101.6 x 101.6 mm, 44 parts (6 on the bottom side), 109 nets.
