techav-homebrew/PikaPC/Hardware/PikaPC_MiniBus/PikaPC_MiniBus.kicad_pcb

## KiCad design Hardware/PikaPC_MiniBus/PikaPC_MiniBus.kicad_pcb (2026-05-26)

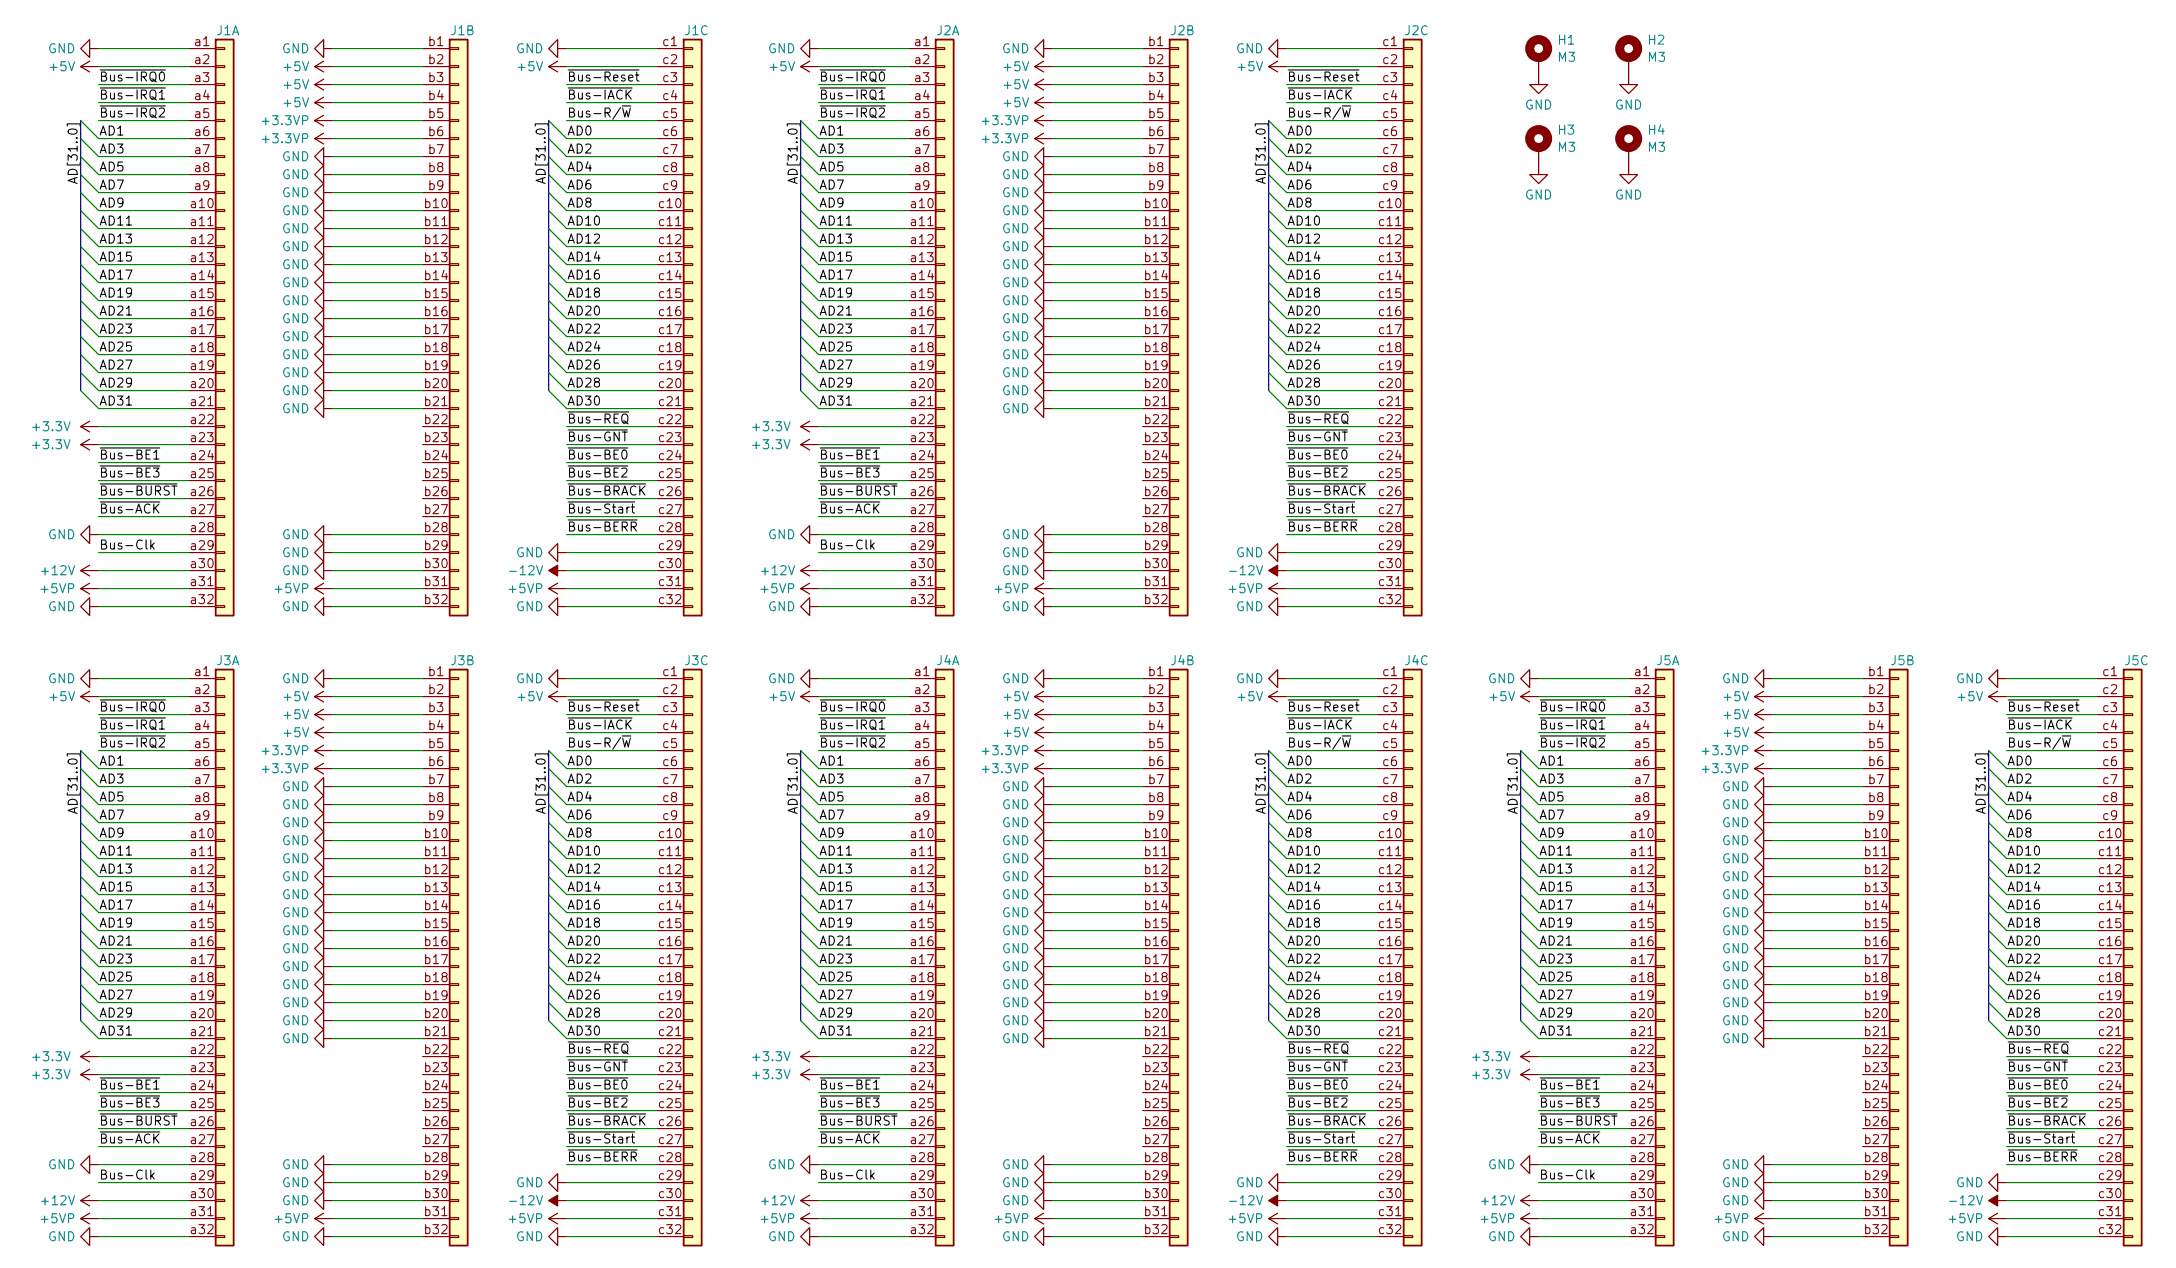
[picture p29: schematic PikaPC_MiniBus.kicad_sch]

Parts:
H1, H2, H3, H4: M3; MountingHole_3.2mm_M3_Pad_Via
J1, J2, J3, J4, J5: DIN41612_03x32_C_Split; DIN41612_C_3x32_Female_Vertical_THT

Connections:
+3.3V: J1.a22, J1.a23, J2.a22, J2.a23, J3.a22, J3.a23, J4.a22, J4.a23, J5.a22, J5.a23
+3.3VP: J1.b5, J1.b6, J2.b5, J2.b6, J3.b5, J3.b6, J4.b5, J4.b6, J5.b5, J5.b6
+5V: J1.a2, J1.b2, J1.b3, J1.b4, J1.c2, J2.a2, J2.b2, J2.b3, J2.b4, J2.c2, J3.a2, J3.b2, J3.b3, J3.b4, J3.c2, J4.a2, J4.b2, J4.b3, J4.b4, J4.c2, J5.a2, J5.b2, J5.b3, J5.b4, J5.c2
+5VP: J1.a31, J1.b31, J1.c31, J2.a31, J2.b31, J2.c31, J3.a31, J3.b31, J3.c31, J4.a31, J4.b31, J4.c31, J5.a31, J5.b31, J5.c31
+12V: J1.a30, J2.a30, J3.a30, J4.a30, J5.a30
-12V: J1.c30, J2.c30, J3.c30, J4.c30, J5.c30
/AD0: J1.c6, J2.c6, J3.c6, J4.c6, J5.c6
/AD1: J1.a6, J2.a6, J3.a6, J4.a6, J5.a6
/AD2: J1.c7, J2.c7, J3.c7, J4.c7, J5.c7
/AD3: J1.a7, J2.a7, J3.a7, J4.a7, J5.a7
/AD4: J1.c8, J2.c8, J3.c8, J4.c8, J5.c8
/AD5: J1.a8, J2.a8, J3.a8, J4.a8, J5.a8
/AD6: J1.c9, J2.c9, J3.c9, J4.c9, J5.c9
/AD7: J1.a9, J2.a9, J3.a9, J4.a9, J5.a9
/AD8: J1.c10, J2.c10, J3.c10, J4.c10, J5.c10
/AD9: J1.a10, J2.a10, J3.a10, J4.a10, J5.a10
/AD10: J1.c11, J2.c11, J3.c11, J4.c11, J5.c11
/AD11: J1.a11, J2.a11, J3.a11, J4.a11, J5.a11
/AD12: J1.c12, J2.c12, J3.c12, J4.c12, J5.c12
/AD13: J1.a12, J2.a12, J3.a12, J4.a12, J5.a12
/AD14: J1.c13, J2.c13, J3.c13, J4.c13, J5.c13
/AD15: J1.a13, J2.a13, J3.a13, J4.a13, J5.a13
/AD16: J1.c14, J2.c14, J3.c14, J4.c14, J5.c14
/AD17: J1.a14, J2.a14, J3.a14, J4.a14, J5.a14
/AD18: J1.c15, J2.c15, J3.c15, J4.c15, J5.c15
/AD19: J1.a15, J2.a15, J3.a15, J4.a15, J5.a15
/AD20: J1.c16, J2.c16, J3.c16, J4.c16, J5.c16
/AD21: J1.a16, J2.a16, J3.a16, J4.a16, J5.a16
/AD22: J1.c17, J2.c17, J3.c17, J4.c17, J5.c17
/AD23: J1.a17, J2.a17, J3.a17, J4.a17, J5.a17
/AD24: J1.c18, J2.c18, J3.c18, J4.c18, J5.c18
/AD25: J1.a18, J2.a18, J3.a18, J4.a18, J5.a18
/AD26: J1.c19, J2.c19, J3.c19, J4.c19, J5.c19
/AD27: J1.a19, J2.a19, J3.a19, J4.a19, J5.a19
/AD28: J1.c20, J2.c20, J3.c20, J4.c20, J5.c20
/AD29: J1.a20, J2.a20, J3.a20, J4.a20, J5.a20
/AD30: J1.c21, J2.c21, J3.c21, J4.c21, J5.c21
/AD31: J1.a21, J2.a21, J3.a21, J4.a21, J5.a21
/Bus-Clk: J1.a29, J2.a29, J3.a29, J4.a29, J5.a29
/Bus-R/~W: J1.c5, J2.c5, J3.c5, J4.c5, J5.c5
/~Bus-ACK: J1.a27, J2.a27, J3.a27, J4.a27, J5.a27
/~Bus-BE0: J1.c24, J2.c24, J3.c24, J4.c24, J5.c24
/~Bus-BE1: J1.a24, J2.a24, J3.a24, J4.a24, J5.a24
/~Bus-BE2: J1.c25, J2.c25, J3.c25, J4.c25, J5.c25
/~Bus-BE3: J1.a25, J2.a25, J3.a25, J4.a25, J5.a25
/~Bus-BERR: J1.c28, J2.c28, J3.c28, J4.c28, J5.c28
/~Bus-BRACK: J1.c26, J2.c26, J3.c26, J4.c26, J5.c26
/~Bus-BURST: J1.a26, J2.a26, J3.a26, J4.a26, J5.a26
/~Bus-GNT: J1.c23, J2.c23, J3.c23, J4.c23, J5.c23
/~Bus-IACK: J1.c4, J2.c4, J3.c4, J4.c4, J5.c4
/~Bus-IRQ0: J1.a3, J2.a3, J3.a3, J4.a3, J5.a3
/~Bus-IRQ1: J1.a4, J2.a4, J3.a4, J4.a4, J5.a4
/~Bus-IRQ2: J1.a5, J2.a5, J3.a5, J4.a5, J5.a5
/~Bus-REQ: J1.c22, J2.c22, J3.c22, J4.c22, J5.c22
/~Bus-Reset: J1.c3, J2.c3, J3.c3, J4.c3, J5.c3
/~Bus-Start: J1.c27, J2.c27, J3.c27, J4.c27, J5.c27
GND: H1.1, H2.1, H3.1, H4.1, J1.a1, J1.a28, J1.a32, J1.b1, J1.b7, J1.b8, J1.b9, J1.b10, J1.b11, J1.b12, J1.b13, J1.b14, J1.b15, J1.b16, J1.b17, J1.b18, J1.b19, J1.b20, J1.b21, J1.b28, J1.b29, J1.b30, J1.b32, J1.c1, J1.c29, J1.c32, J2.a1, J2.a28, J2.a32, J2.b1, J2.b7, J2.b8, J2.b9, J2.b10, J2.b11, J2.b12, J2.b13, J2.b14, J2.b15, J2.b16, J2.b17, J2.b18, J2.b19, J2.b20, J2.b21, J2.b28, J2.b29, J2.b30, J2.b32, J2.c1, J2.c29, J2.c32, J3.a1, J3.a28, J3.a32, J3.b1, J3.b7, J3.b8, J3.b9, J3.b10, J3.b11, J3.b12, J3.b13, J3.b14, J3.b15, J3.b16, J3.b17, J3.b18, J3.b19, J3.b20, J3.b21, J3.b28, J3.b29, J3.b30, J3.b32, J3.c1, J3.c29, J3.c32, J4.a1, J4.a28, J4.a32, J4.b1, J4.b7, J4.b8, J4.b9, J4.b10, J4.b11, J4.b12, J4.b13, J4.b14, J4.b15, J4.b16, J4.b17, J4.b18, J4.b19, J4.b20, J4.b21, J4.b28, J4.b29, J4.b30, J4.b32, J4.c1, J4.c29, J4.c32, J5.a1, J5.a28, J5.a32, J5.b1, J5.b7, J5.b8, J5.b9, J5.b10, J5.b11, J5.b12, J5.b13, J5.b14, J5.b15, J5.b16, J5.b17, J5.b18, J5.b19, J5.b20, J5.b21, J5.b28, J5.b29, J5.b30, J5.b32, J5.c1, J5.c29, J5.c32

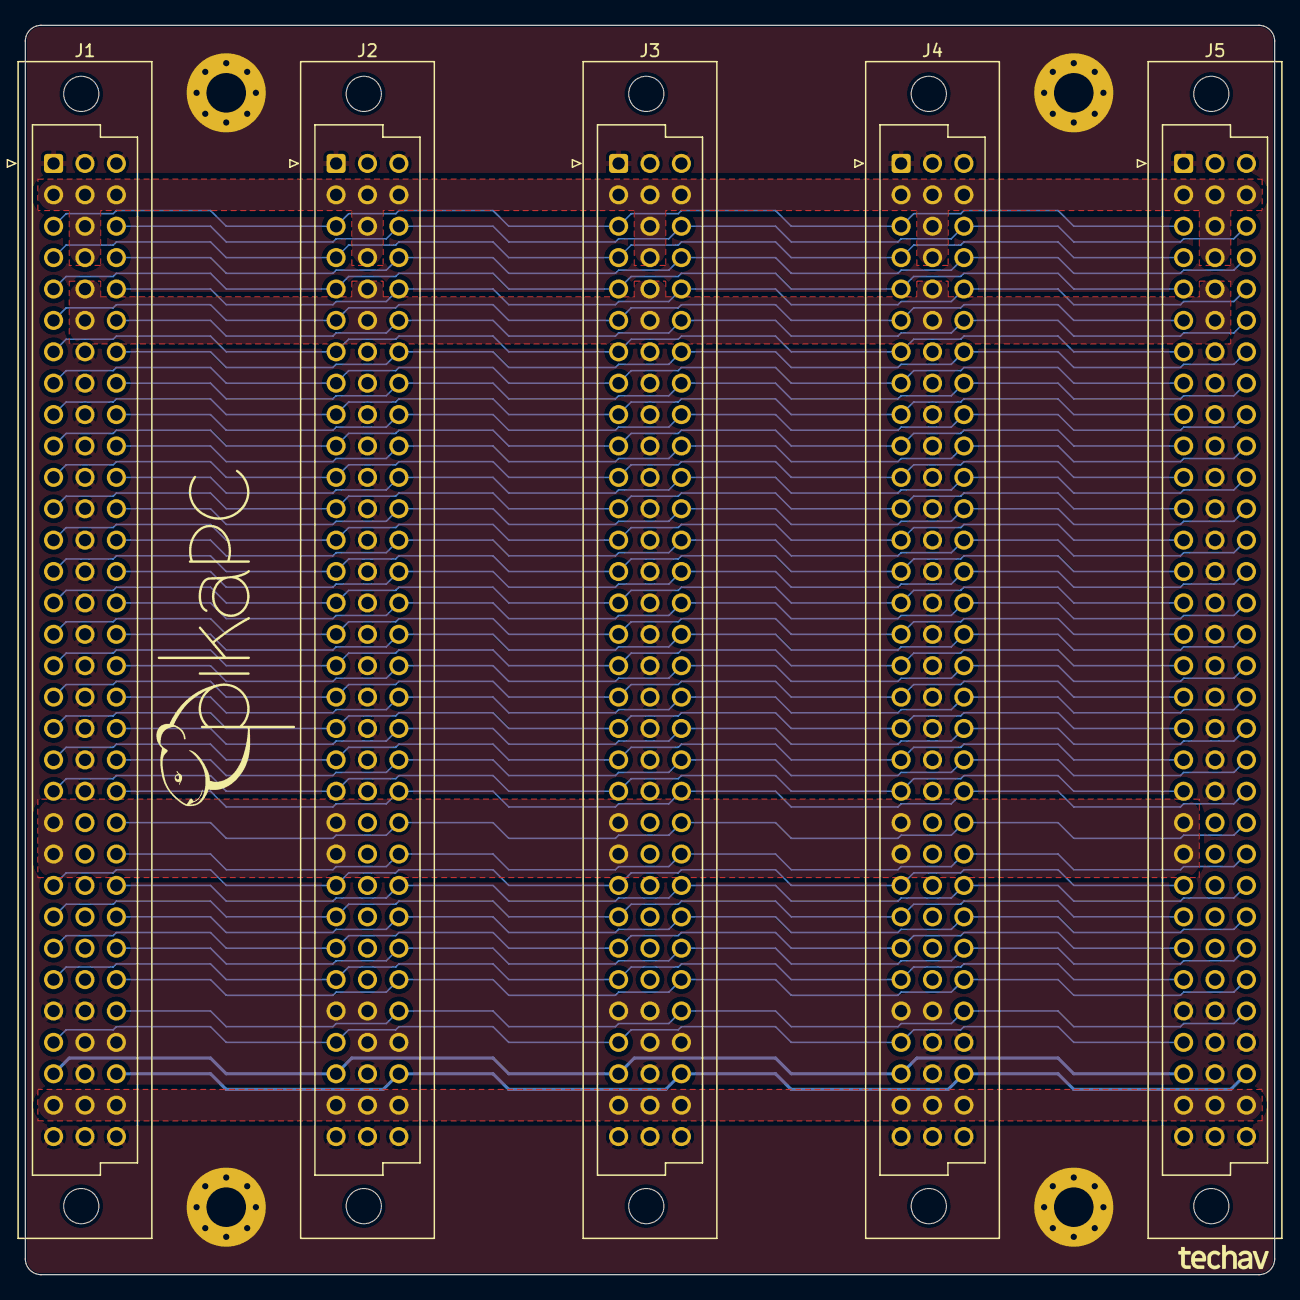
[picture p30: board PikaPC_MiniBus.kicad_pcb from above]

Board: 2 copper layers, 101.1 x 101.1 mm, 9 parts (0 on the bottom side), 57 nets.
