techav-homebrew/PikaPC/Hardware/PikaPC_Host/PikaPC_Host.kicad_pcb

## KiCad design Hardware/PikaPC_Host/PikaPC_Host.kicad_pcb (2026-05-26)

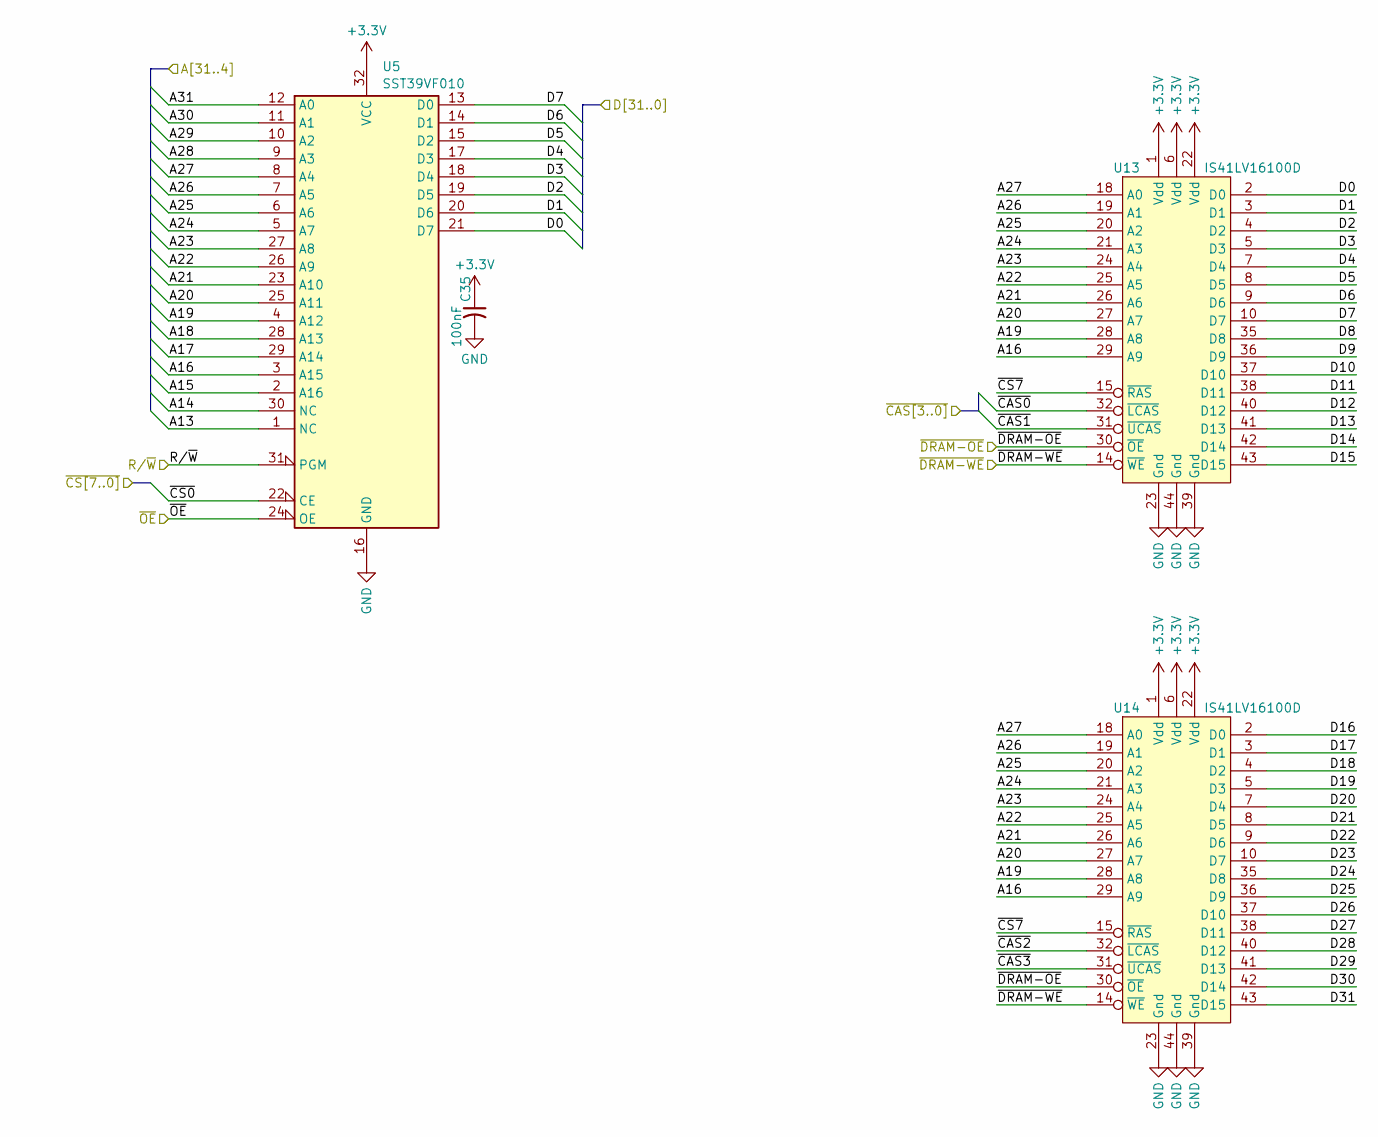
[picture p31: schematic rom.kicad_sch, PikaPC Host Card]

Parts:
C35: 100nF; C_0805_2012Metric; Mouser 187-CL21B104KACNNNC
U5: SST39VF010; PLCC-32_THT-Socket; Mouser 804-39VF0107INHE-T
U13, U14: IS41LV16100D; TSOP-II-44

Connections:
+3.3V: C35.1, U5.32 (VCC), U13.1 (Vdd), U13.6 (Vdd), U13.22 (Vdd), U14.1 (Vdd), U14.6 (Vdd), U14.22 (Vdd); also elsewhere on the board
/CPU Bus/D0: U5.21 (D7), U13.2 (D0); also elsewhere on the board
/CPU Bus/D1: U5.20 (D6), U13.3 (D1); also elsewhere on the board
/CPU Bus/D2: U5.19 (D5), U13.4 (D2); also elsewhere on the board
/CPU Bus/D3: U5.18 (D4), U13.5 (D3); also elsewhere on the board
/CPU Bus/D4: U5.17 (D3), U13.7 (D4); also elsewhere on the board
/CPU Bus/D5: U5.15 (D2), U13.8 (D5); also elsewhere on the board
/CPU Bus/D6: U5.14 (D1), U13.9 (D6); also elsewhere on the board
/CPU Bus/D7: U5.13 (D0), U13.10 (D7); also elsewhere on the board
/CPU Bus/D8: U13.35 (D8); also elsewhere on the board
/CPU Bus/D9: U13.36 (D9); also elsewhere on the board
/CPU Bus/D10: U13.37 (D10); also elsewhere on the board
/CPU Bus/D11: U13.38 (D11); also elsewhere on the board
/CPU Bus/D12: U13.40 (D12); also elsewhere on the board
/CPU Bus/D13: U13.41 (D13); also elsewhere on the board
/CPU Bus/D14: U13.42 (D14); also elsewhere on the board
/CPU Bus/D15: U13.43 (D15); also elsewhere on the board
/CPU Bus/D16: U14.2 (D0); also elsewhere on the board
/CPU Bus/D17: U14.3 (D1); also elsewhere on the board
/CPU Bus/D18: U14.4 (D2); also elsewhere on the board
/CPU Bus/D19: U14.5 (D3); also elsewhere on the board
/CPU Bus/D20: U14.7 (D4); also elsewhere on the board
/CPU Bus/D21: U14.8 (D5); also elsewhere on the board
/CPU Bus/D22: U14.9 (D6); also elsewhere on the board
/CPU Bus/D23: U14.10 (D7); also elsewhere on the board
/CPU Bus/D24: U14.35 (D8); also elsewhere on the board
/CPU Bus/D25: U14.36 (D9); also elsewhere on the board
/CPU Bus/D26: U14.37 (D10); also elsewhere on the board
/CPU Bus/D27: U14.38 (D11); also elsewhere on the board
/CPU Bus/D28: U14.40 (D12); also elsewhere on the board
/CPU Bus/D29: U14.41 (D13); also elsewhere on the board
/CPU Bus/D30: U14.42 (D14); also elsewhere on the board
/CPU Bus/D31: U14.43 (D15); also elsewhere on the board
/CPU Bus/~CAS0: U13.32 (~LCAS); also elsewhere on the board
/CPU Bus/~CAS1: U13.31 (~UCAS); also elsewhere on the board
/CPU Bus/~CAS2: U14.32 (~LCAS); also elsewhere on the board
/CPU Bus/~CAS3: U14.31 (~UCAS); also elsewhere on the board
/CPU Bus/~CS0: U5.22 (CE); also elsewhere on the board
/CPU Bus/~CS7: U13.15 (~RAS), U14.15 (~RAS); also elsewhere on the board
/CPU Bus/~DRAM-OE: U13.30 (~OE), U14.30 (~OE); also elsewhere on the board
/CPU Bus/~DRAM-WE: U13.14 (~WE), U14.14 (~WE); also elsewhere on the board
/CPU Bus/~OE: U5.24 (OE); also elsewhere on the board
/Main Bus/A13: U5.1 (NC); also elsewhere on the board
/Main Bus/A14: U5.30 (NC); also elsewhere on the board
/Main Bus/A15: U5.2 (A16); also elsewhere on the board
/Main Bus/A16: U5.3 (A15), U13.29 (A9), U14.29 (A9); also elsewhere on the board
/Main Bus/A17: U5.29 (A14); also elsewhere on the board
/Main Bus/A18: U5.28 (A13); also elsewhere on the board
/Main Bus/A19: U5.4 (A12), U13.28 (A8), U14.28 (A8); also elsewhere on the board
/Main Bus/A20: U5.25 (A11), U13.27 (A7), U14.27 (A7); also elsewhere on the board
/Main Bus/A21: U5.23 (A10), U13.26 (A6), U14.26 (A6); also elsewhere on the board
/Main Bus/A22: U5.26 (A9), U13.25 (A5), U14.25 (A5); also elsewhere on the board
/Main Bus/A23: U5.27 (A8), U13.24 (A4), U14.24 (A4); also elsewhere on the board
/Main Bus/A24: U5.5 (A7), U13.21 (A3), U14.21 (A3); also elsewhere on the board
/Main Bus/A25: U5.6 (A6), U13.20 (A2), U14.20 (A2); also elsewhere on the board
/Main Bus/A26: U5.7 (A5), U13.19 (A1), U14.19 (A1); also elsewhere on the board
/Main Bus/A27: U5.8 (A4), U13.18 (A0), U14.18 (A0); also elsewhere on the board
/Main Bus/A28: U5.9 (A3); also elsewhere on the board
/Main Bus/A29: U5.10 (A2); also elsewhere on the board
/Main Bus/A30: U5.11 (A1); also elsewhere on the board
/Main Bus/A31: U5.12 (A0); also elsewhere on the board
/R/~W: U5.31 (PGM); also elsewhere on the board
GND: C35.2, U5.16 (GND), U13.23 (Gnd), U13.39 (Gnd), U13.44 (Gnd), U14.23 (Gnd), U14.39 (Gnd), U14.44 (Gnd); also elsewhere on the board

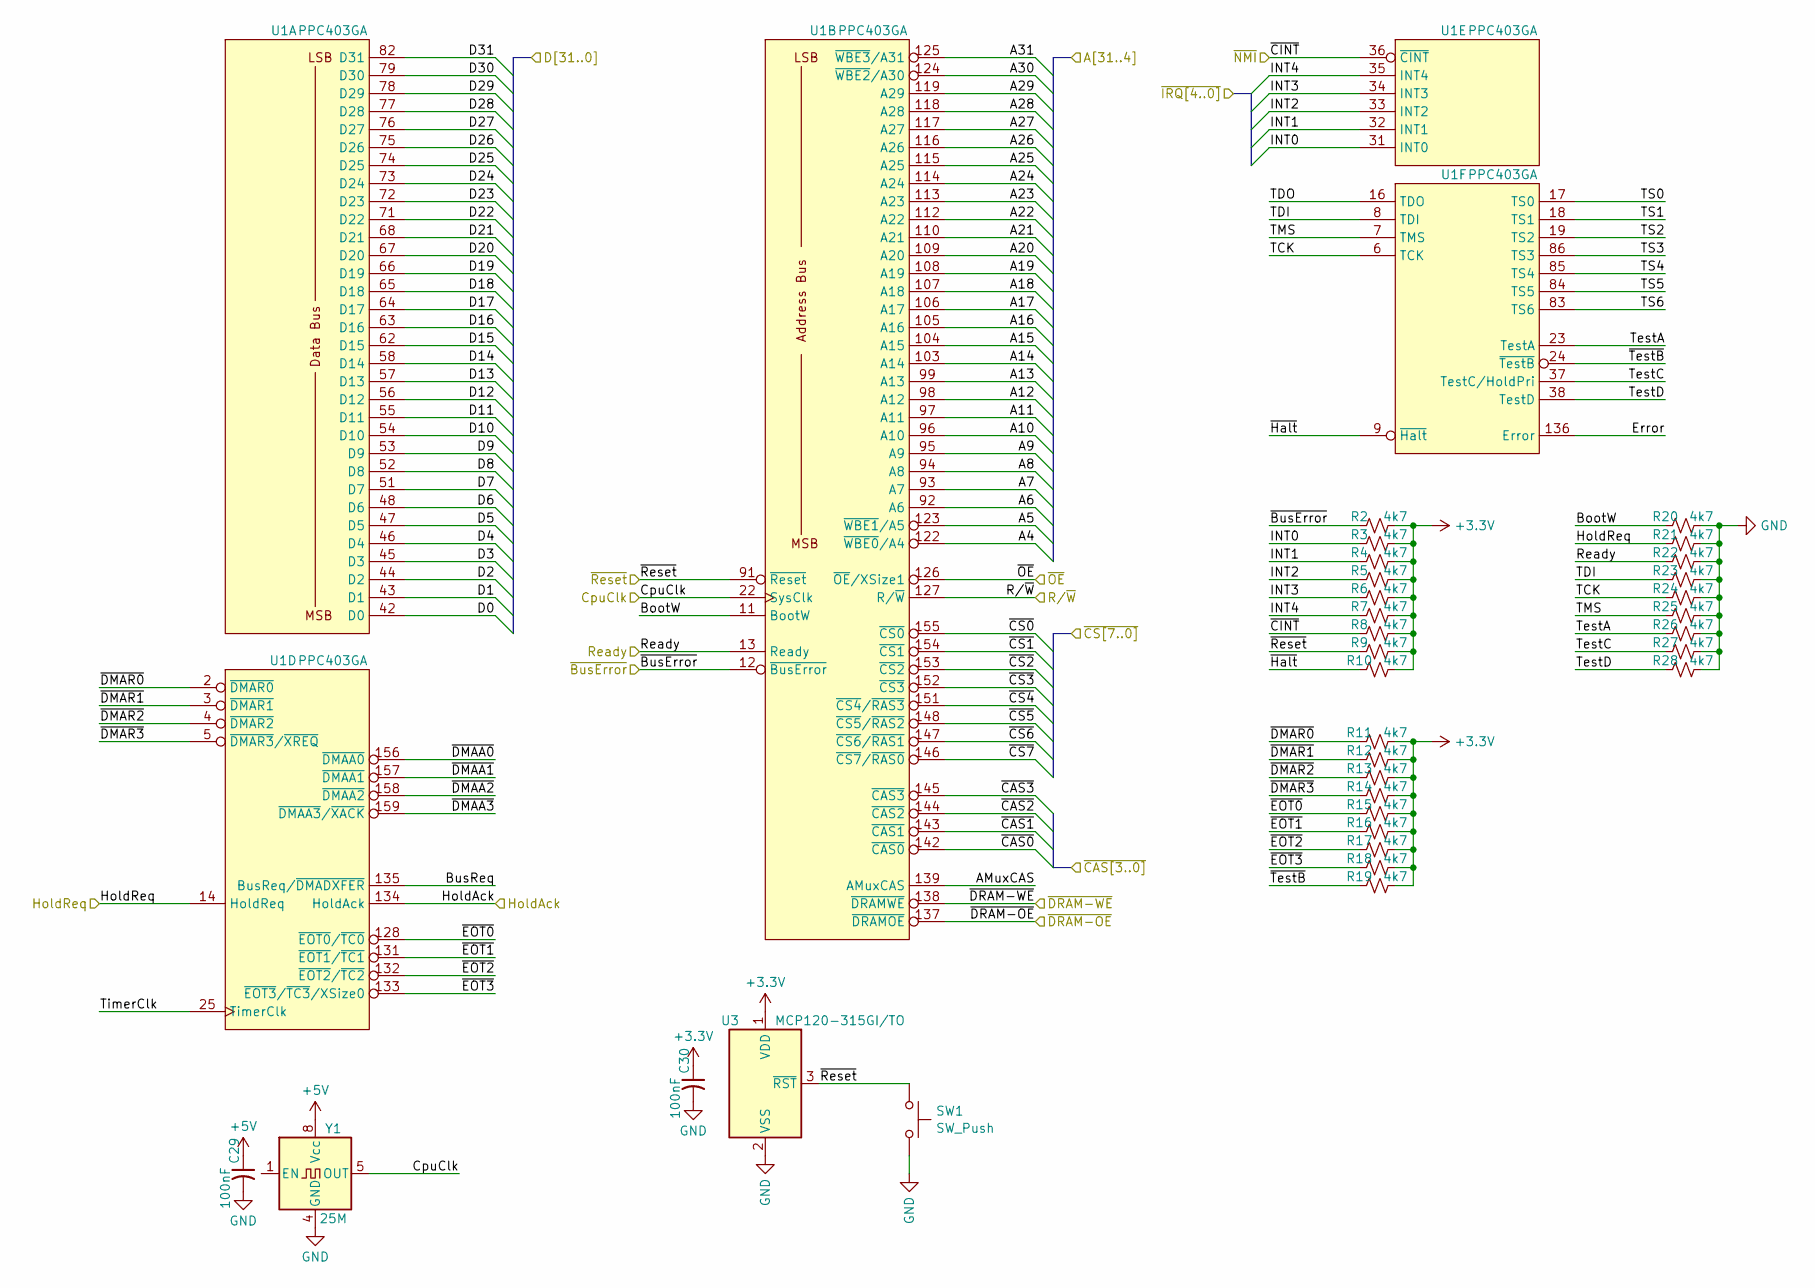
[picture p32: schematic cpu_bus.kicad_sch, PikaPC Host Card]

Parts:
C29, C30: 100nF; C_0805_2012Metric; Mouser 187-CL21B104KACNNNC
R2, R3, R4, R5, R6, R7, R8, R9, R10, R11, R12, R13, R14, R15, R16, R17, R18, R19, R20, R21, R22, R23, R24, R25, R26, R27, R28: 4k7; R_0805_2012Metric; Mouser 303-0805W8J0472T5E
SW1: SW_Push; SW_PUSH_6mm_H7.3mm
U1: PPC403GA; PQFP-160_28x28mm_P0.65mm
U3: MCP120-315GI/TO; TO-92_Inline_Wide; Mouser 579-MCP120-315GI/TO
Y1: 25M; Oscillator_DIP-8

Connections:
+3.3V: C30.1, R2.2, R3.2, R4.2, R5.2, R6.2, R7.2, R8.2, R9.2, R10.2, R11.2, R12.2, R13.2, R14.2, R15.2, R16.2, R17.2, R18.2, R19.2, U3.1 (VDD); also elsewhere on the board
+5V: C29.1, Y1.8 (Vcc); also elsewhere on the board
/CPU Bus/AMuxCAS: U1.139 (AMuxCAS)
/CPU Bus/BootW: R20.1, U1.11 (BootW)
/CPU Bus/BusReq: U1.135 (BusReq/~DMADXFER)
/CPU Bus/D0: U1.42 (D0); also elsewhere on the board
/CPU Bus/D1: U1.43 (D1); also elsewhere on the board
/CPU Bus/D2: U1.44 (D2); also elsewhere on the board
/CPU Bus/D3: U1.45 (D3); also elsewhere on the board
/CPU Bus/D4: U1.46 (D4); also elsewhere on the board
/CPU Bus/D5: U1.47 (D5); also elsewhere on the board
/CPU Bus/D6: U1.48 (D6); also elsewhere on the board
/CPU Bus/D7: U1.51 (D7); also elsewhere on the board
/CPU Bus/D8: U1.52 (D8); also elsewhere on the board
/CPU Bus/D9: U1.53 (D9); also elsewhere on the board
/CPU Bus/D10: U1.54 (D10); also elsewhere on the board
/CPU Bus/D11: U1.55 (D11); also elsewhere on the board
/CPU Bus/D12: U1.56 (D12); also elsewhere on the board
/CPU Bus/D13: U1.57 (D13); also elsewhere on the board
/CPU Bus/D14: U1.58 (D14); also elsewhere on the board
/CPU Bus/D15: U1.62 (D15); also elsewhere on the board
/CPU Bus/D16: U1.63 (D16); also elsewhere on the board
/CPU Bus/D17: U1.64 (D17); also elsewhere on the board
/CPU Bus/D18: U1.65 (D18); also elsewhere on the board
/CPU Bus/D19: U1.66 (D19); also elsewhere on the board
/CPU Bus/D20: U1.67 (D20); also elsewhere on the board
/CPU Bus/D21: U1.68 (D21); also elsewhere on the board
/CPU Bus/D22: U1.71 (D22); also elsewhere on the board
/CPU Bus/D23: U1.72 (D23); also elsewhere on the board
/CPU Bus/D24: U1.73 (D24); also elsewhere on the board
/CPU Bus/D25: U1.74 (D25); also elsewhere on the board
/CPU Bus/D26: U1.75 (D26); also elsewhere on the board
/CPU Bus/D27: U1.76 (D27); also elsewhere on the board
/CPU Bus/D28: U1.77 (D28); also elsewhere on the board
/CPU Bus/D29: U1.78 (D29); also elsewhere on the board
/CPU Bus/D30: U1.79 (D30); also elsewhere on the board
/CPU Bus/D31: U1.82 (D31); also elsewhere on the board
/CPU Bus/Error: U1.136 (Error)
/CPU Bus/HoldAck: U1.134 (HoldAck); also elsewhere on the board
/CPU Bus/HoldReq: R21.1, U1.14 (HoldReq); also elsewhere on the board
/CPU Bus/INT0: R3.1, U1.31 (INT0)
/CPU Bus/INT1: R4.1, U1.32 (INT1)
/CPU Bus/INT2: R5.1, U1.33 (INT2)
/CPU Bus/INT3: R6.1, U1.34 (INT3)
/CPU Bus/INT4: R7.1, U1.35 (INT4)
/CPU Bus/Ready: R22.1, U1.13 (Ready); also elsewhere on the board
/CPU Bus/TCK: R24.1, U1.6 (TCK)
/CPU Bus/TDI: R23.1, U1.8 (TDI)
/CPU Bus/TDO: U1.16 (TDO)
/CPU Bus/TMS: R25.1, U1.7 (TMS)
/CPU Bus/TS0: U1.17 (TS0)
/CPU Bus/TS1: U1.18 (TS1)
/CPU Bus/TS2: U1.19 (TS2)
/CPU Bus/TS3: U1.86 (TS3)
/CPU Bus/TS4: U1.85 (TS4)
/CPU Bus/TS5: U1.84 (TS5)
/CPU Bus/TS6: U1.83 (TS6)
/CPU Bus/TestA: R26.1, U1.23 (TestA)
/CPU Bus/TestC: R27.1, U1.37 (TestC/HoldPri)
/CPU Bus/TestD: R28.1, U1.38 (TestD)
/CPU Bus/TimerClk: U1.25 (TimerClk)
/CPU Bus/~BusError: R2.1, U1.12 (~BusError); also elsewhere on the board
/CPU Bus/~CAS0: U1.142 (~CAS0); also elsewhere on the board
/CPU Bus/~CAS1: U1.143 (~CAS1); also elsewhere on the board
/CPU Bus/~CAS2: U1.144 (~CAS2); also elsewhere on the board
/CPU Bus/~CAS3: U1.145 (~CAS3); also elsewhere on the board
/CPU Bus/~CINT: R8.1, U1.36 (~CINT); also elsewhere on the board
/CPU Bus/~CS0: U1.155 (~CS0); also elsewhere on the board
/CPU Bus/~CS1: U1.154 (~CS1); also elsewhere on the board
/CPU Bus/~CS2: U1.153 (~CS2); also elsewhere on the board
/CPU Bus/~CS3: U1.152 (~CS3); also elsewhere on the board
/CPU Bus/~CS4: U1.151 (~CS4/~RAS3); also elsewhere on the board
/CPU Bus/~CS5: U1.148 (~CS5/~RAS2); also elsewhere on the board
/CPU Bus/~CS6: U1.147 (~CS6/~RAS1); also elsewhere on the board
/CPU Bus/~CS7: U1.146 (~CS7/~RAS0); also elsewhere on the board
/CPU Bus/~DMAA0: U1.156 (~DMAA0)
/CPU Bus/~DMAA1: U1.157 (~DMAA1)
/CPU Bus/~DMAA2: U1.158 (~DMAA2)
/CPU Bus/~DMAA3: U1.159 (~DMAA3/~XACK)
/CPU Bus/~DMAR0: R11.1, U1.2 (~DMAR0)
/CPU Bus/~DMAR1: R12.1, U1.3 (~DMAR1)
/CPU Bus/~DMAR2: R13.1, U1.4 (~DMAR2)
/CPU Bus/~DMAR3: R14.1, U1.5 (~DMAR3/~XREQ)
/CPU Bus/~DRAM-OE: U1.137 (~DRAMOE); also elsewhere on the board
/CPU Bus/~DRAM-WE: U1.138 (~DRAMWE); also elsewhere on the board
/CPU Bus/~EOT0: R15.1, U1.128 (~EOT0/~TC0)
/CPU Bus/~EOT1: R16.1, U1.131 (~EOT1/~TC1)
/CPU Bus/~EOT2: R17.1, U1.132 (~EOT2/~TC2)
/CPU Bus/~EOT3: R18.1, U1.133 (~EOT3/~TC3/XSize0)
/CPU Bus/~Halt: R10.1, U1.9 (~Halt)
/CPU Bus/~OE: U1.126 (~OE/XSize1); also elsewhere on the board
/CPU Bus/~TestB: R19.1, U1.24 (~TestB)
/CpuClk: U1.22 (SysClk), Y1.5 (OUT); also elsewhere on the board
/Main Bus/A4: U1.122 (~WBE0/A4); also elsewhere on the board
/Main Bus/A5: U1.123 (~WBE1/A5); also elsewhere on the board
/Main Bus/A6: U1.92 (A6); also elsewhere on the board
/Main Bus/A7: U1.93 (A7); also elsewhere on the board
/Main Bus/A8: U1.94 (A8); also elsewhere on the board
/Main Bus/A9: U1.95 (A9); also elsewhere on the board
/Main Bus/A10: U1.96 (A10); also elsewhere on the board
/Main Bus/A11: U1.97 (A11); also elsewhere on the board
/Main Bus/A12: U1.98 (A12); also elsewhere on the board
/Main Bus/A13: U1.99 (A13); also elsewhere on the board
/Main Bus/A14: U1.103 (A14); also elsewhere on the board
/Main Bus/A15: U1.104 (A15); also elsewhere on the board
/Main Bus/A16: U1.105 (A16); also elsewhere on the board
/Main Bus/A17: U1.106 (A17); also elsewhere on the board
/Main Bus/A18: U1.107 (A18); also elsewhere on the board
/Main Bus/A19: U1.108 (A19); also elsewhere on the board
/Main Bus/A20: U1.109 (A20); also elsewhere on the board
/Main Bus/A21: U1.110 (A21); also elsewhere on the board
/Main Bus/A22: U1.112 (A22); also elsewhere on the board
/Main Bus/A23: U1.113 (A23); also elsewhere on the board
/Main Bus/A24: U1.114 (A24); also elsewhere on the board
/Main Bus/A25: U1.115 (A25); also elsewhere on the board
/Main Bus/A26: U1.116 (A26); also elsewhere on the board
/Main Bus/A27: U1.117 (A27); also elsewhere on the board
/Main Bus/A28: U1.118 (A28); also elsewhere on the board
/Main Bus/A29: U1.119 (A29); also elsewhere on the board
/Main Bus/A30: U1.124 (~WBE2/A30); also elsewhere on the board
/Main Bus/A31: U1.125 (~WBE3/A31); also elsewhere on the board
/R/~W: U1.127 (R/~W); also elsewhere on the board
/~Reset: R9.1, SW1.2, U1.91 (~Reset), U3.3 (~RST); also elsewhere on the board
GND: C29.2, C30.2, R20.2, R21.2, R22.2, R23.2, R24.2, R25.2, R26.2, R27.2, R28.2, SW1.1, U3.2 (VSS), Y1.4 (GND); also elsewhere on the board

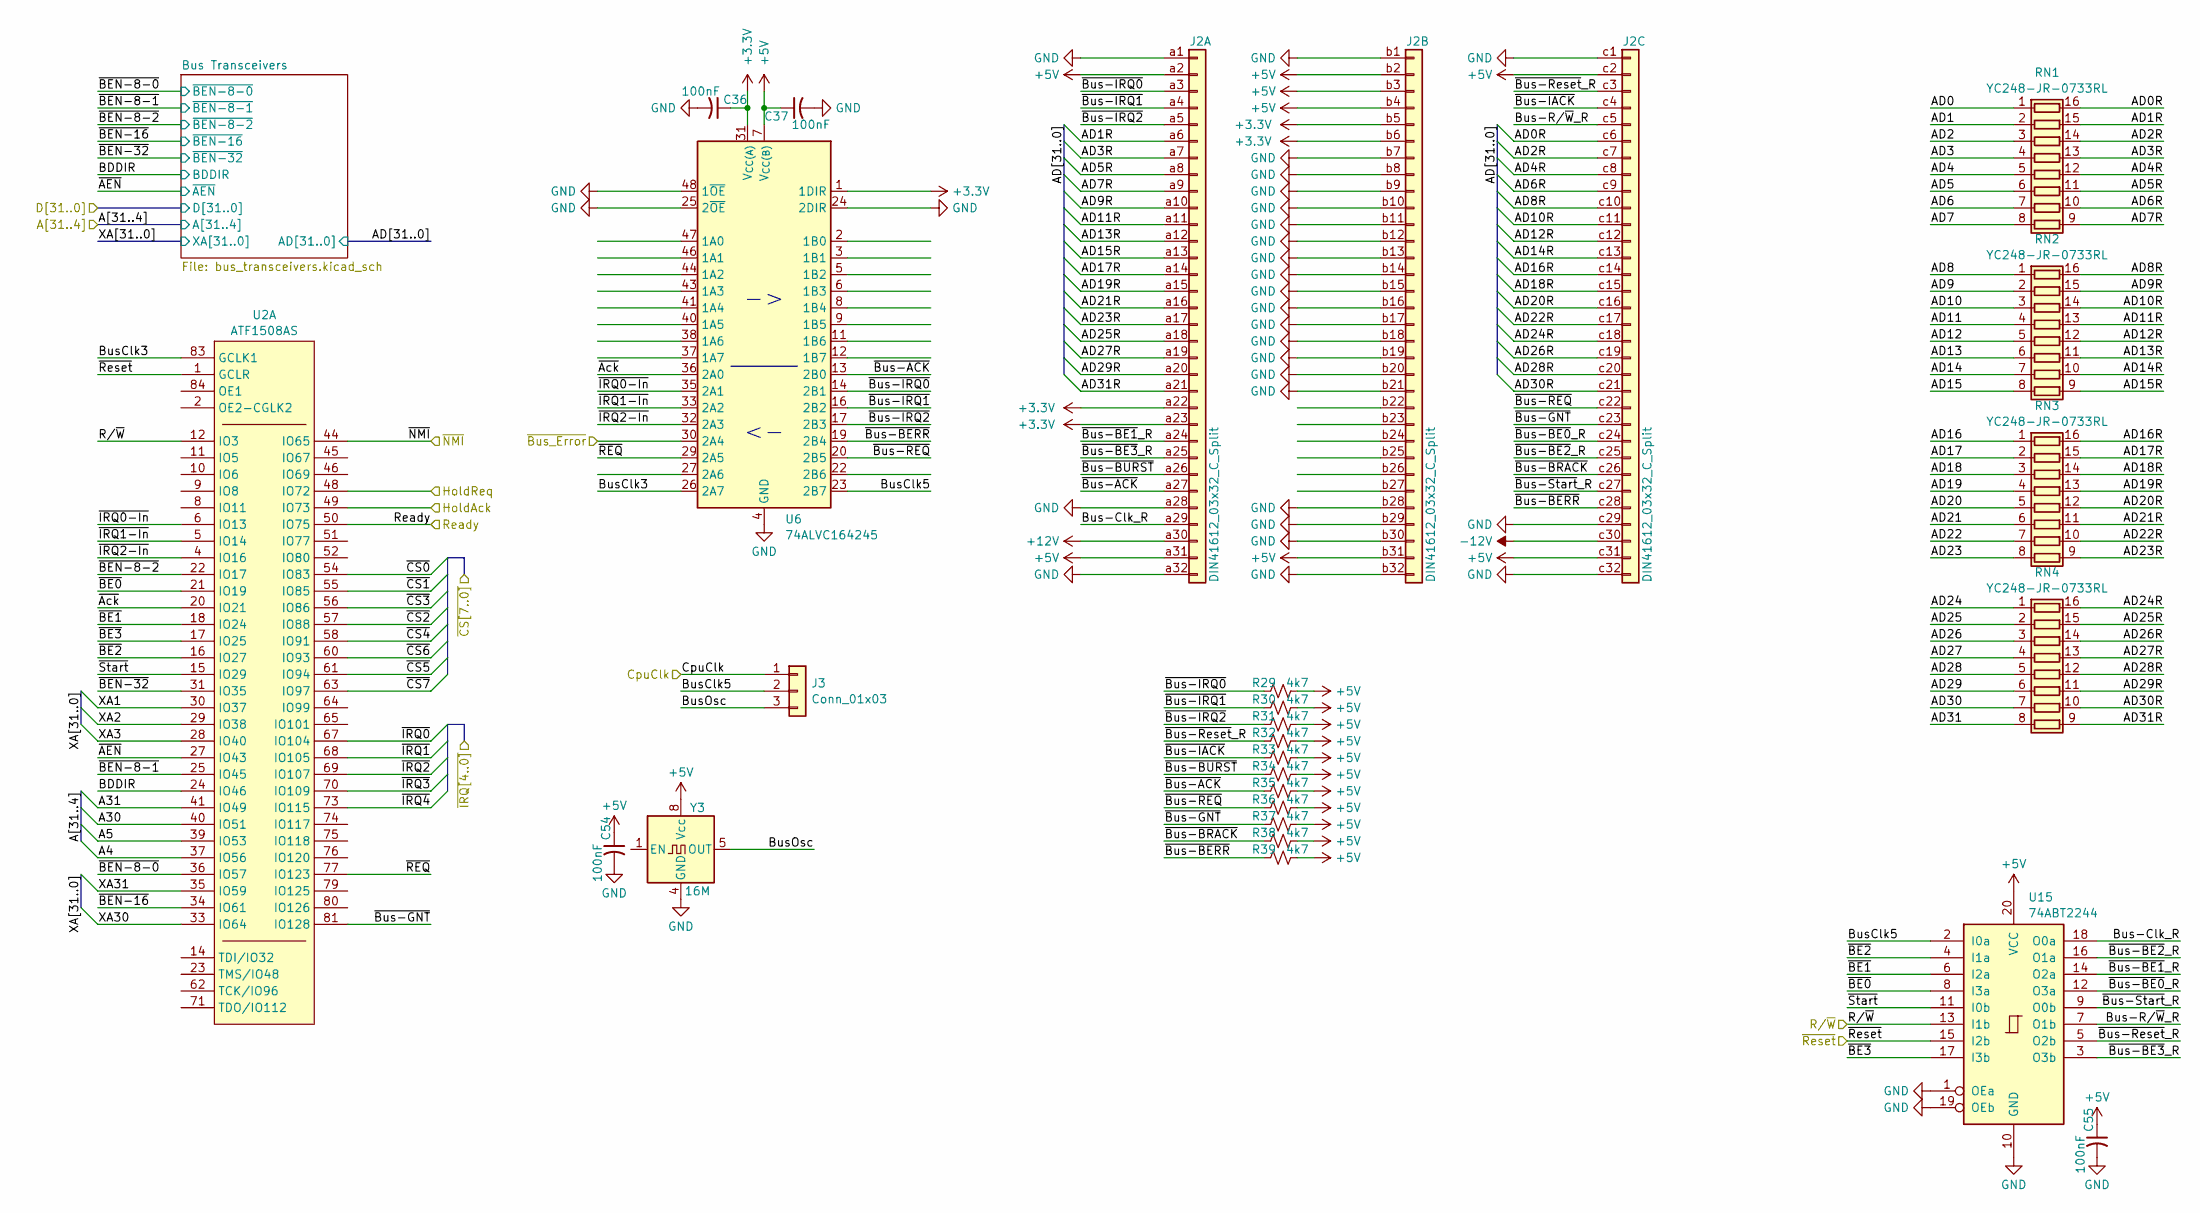
[picture p33: schematic main_bus.kicad_sch, PikaPC Host Card]

Parts:
C36, C37, C54, C55: 100nF; C_0805_2012Metric; Mouser 187-CL21B104KACNNNC
J2: DIN41612_03x32_C_Split; DIN41612_C_3x32_Male_Horizontal_THT
J3: Conn_01x03; PinHeader_1x03_P2.54mm_Vertical
R29, R30, R31, R32, R33, R34, R35, R36, R37, R38, R39: 4k7; R_0805_2012Metric; Mouser 303-0805W8J0472T5E
RN1, RN2, RN3, RN4: YC248-JR-0733RL; R_Array_Convex_8x0602
U2: ATF1508AS; PLCC-84_THT-Socket
U6: 74ALVC164245; TSSOP-48_6.1x12.5mm_P0.5mm; Mouser 972-74ALVC164245PAG8
U15: 74ABT2244; SOIC-20W_7.5x12.8mm_P1.27mm
Y3: 16M; Oscillator_DIP-8

Connections:
+3.3V: C36.1, J2.a22, J2.a23, J2.b5, J2.b6, U6.1 (1DIR), U6.31 (V_{CC(A)}), U6.42 (V_{CC(A)}); also elsewhere on the board
+5V: C37.1, C54.1, C55.1, J2.a2, J2.a31, J2.b2, J2.b3, J2.b4, J2.b31, J2.c2, J2.c31, R29.2, R30.2, R31.2, R32.2, R33.2, R34.2, R35.2, R36.2, R37.2, R38.2, R39.2, U6.7 (V_{CC(B)}), U6.18 (V_{CC(B)}), U15.20 (VCC), Y3.8 (Vcc); also elsewhere on the board
+12V: J2.a30; also elsewhere on the board
-12V: J2.c30; also elsewhere on the board
/CPU Bus/HoldAck: U2.49 (IO73); also elsewhere on the board
/CPU Bus/HoldReq: U2.48 (IO72); also elsewhere on the board
/CPU Bus/Ready: U2.50 (IO75); also elsewhere on the board
/CPU Bus/~BusError: U6.30 (2A4); also elsewhere on the board
/CPU Bus/~CINT: U2.44 (IO65); also elsewhere on the board
/CPU Bus/~CS0: U2.54 (IO83); also elsewhere on the board
/CPU Bus/~CS1: U2.55 (IO85); also elsewhere on the board
/CPU Bus/~CS2: U2.57 (IO88); also elsewhere on the board
/CPU Bus/~CS3: U2.56 (IO86); also elsewhere on the board
/CPU Bus/~CS4: U2.58 (IO91); also elsewhere on the board
/CPU Bus/~CS5: U2.61 (IO94); also elsewhere on the board
/CPU Bus/~CS6: U2.60 (IO93); also elsewhere on the board
/CPU Bus/~CS7: U2.63 (IO97); also elsewhere on the board
/CPU Bus/~IRQ0: U2.67 (IO104)
/CPU Bus/~IRQ1: U2.68 (IO105)
/CPU Bus/~IRQ2: U2.69 (IO107)
/CPU Bus/~IRQ3: U2.70 (IO109)
/CPU Bus/~IRQ4: U2.73 (IO115)
/CpuClk: J3.1; also elsewhere on the board
/Main Bus/A4: U2.37 (IO56); also elsewhere on the board
/Main Bus/A5: U2.39 (IO53); also elsewhere on the board
/Main Bus/A30: U2.40 (IO51); also elsewhere on the board
/Main Bus/A31: U2.41 (IO49); also elsewhere on the board
/Main Bus/AD0: RN1.1 (R1.1); also elsewhere on the board
/Main Bus/AD0R: J2.c6, RN1.16 (R1.2)
/Main Bus/AD1: RN1.2 (R2.1); also elsewhere on the board
/Main Bus/AD1R: J2.a6, RN1.15 (R2.2)
/Main Bus/AD2: RN1.3 (R3.1); also elsewhere on the board
/Main Bus/AD2R: J2.c7, RN1.14 (R3.2)
/Main Bus/AD3: RN1.4 (R4.1); also elsewhere on the board
/Main Bus/AD3R: J2.a7, RN1.13 (R4.2)
/Main Bus/AD4: RN1.5 (R5.1); also elsewhere on the board
/Main Bus/AD4R: J2.c8, RN1.12 (R5.2)
/Main Bus/AD5: RN1.6 (R6.1); also elsewhere on the board
/Main Bus/AD5R: J2.a8, RN1.11 (R6.2)
/Main Bus/AD6: RN1.7 (R7.1); also elsewhere on the board
/Main Bus/AD6R: J2.c9, RN1.10 (R7.2)
/Main Bus/AD7: RN1.8 (R8.1); also elsewhere on the board
/Main Bus/AD7R: J2.a9, RN1.9 (R8.2)
/Main Bus/AD8: RN2.1 (R1.1); also elsewhere on the board
/Main Bus/AD8R: J2.c10, RN2.16 (R1.2)
/Main Bus/AD9: RN2.2 (R2.1); also elsewhere on the board
/Main Bus/AD9R: J2.a10, RN2.15 (R2.2)
/Main Bus/AD10: RN2.3 (R3.1); also elsewhere on the board
/Main Bus/AD10R: J2.c11, RN2.14 (R3.2)
/Main Bus/AD11: RN2.4 (R4.1); also elsewhere on the board
/Main Bus/AD11R: J2.a11, RN2.13 (R4.2)
/Main Bus/AD12: RN2.5 (R5.1); also elsewhere on the board
/Main Bus/AD12R: J2.c12, RN2.12 (R5.2)
/Main Bus/AD13: RN2.6 (R6.1); also elsewhere on the board
/Main Bus/AD13R: J2.a12, RN2.11 (R6.2)
/Main Bus/AD14: RN2.7 (R7.1); also elsewhere on the board
/Main Bus/AD14R: J2.c13, RN2.10 (R7.2)
/Main Bus/AD15: RN2.8 (R8.1); also elsewhere on the board
/Main Bus/AD15R: J2.a13, RN2.9 (R8.2)
/Main Bus/AD16: RN3.1 (R1.1); also elsewhere on the board
/Main Bus/AD16R: J2.c14, RN3.16 (R1.2)
/Main Bus/AD17: RN3.2 (R2.1); also elsewhere on the board
/Main Bus/AD17R: J2.a14, RN3.15 (R2.2)
/Main Bus/AD18: RN3.3 (R3.1); also elsewhere on the board
/Main Bus/AD18R: J2.c15, RN3.14 (R3.2)
/Main Bus/AD19: RN3.4 (R4.1); also elsewhere on the board
/Main Bus/AD19R: J2.a15, RN3.13 (R4.2)
/Main Bus/AD20: RN3.5 (R5.1); also elsewhere on the board
/Main Bus/AD20R: J2.c16, RN3.12 (R5.2)
/Main Bus/AD21: RN3.6 (R6.1); also elsewhere on the board
/Main Bus/AD21R: J2.a16, RN3.11 (R6.2)
/Main Bus/AD22: RN3.7 (R7.1); also elsewhere on the board
/Main Bus/AD22R: J2.c17, RN3.10 (R7.2)
/Main Bus/AD23: RN3.8 (R8.1); also elsewhere on the board
/Main Bus/AD23R: J2.a17, RN3.9 (R8.2)
/Main Bus/AD24: RN4.1 (R1.1); also elsewhere on the board
/Main Bus/AD24R: J2.c18, RN4.16 (R1.2)
/Main Bus/AD25: RN4.2 (R2.1); also elsewhere on the board
/Main Bus/AD25R: J2.a18, RN4.15 (R2.2)
/Main Bus/AD26: RN4.3 (R3.1); also elsewhere on the board
/Main Bus/AD26R: J2.c19, RN4.14 (R3.2)
/Main Bus/AD27: RN4.4 (R4.1); also elsewhere on the board
/Main Bus/AD27R: J2.a19, RN4.13 (R4.2)
/Main Bus/AD28: RN4.5 (R5.1); also elsewhere on the board
/Main Bus/AD28R: J2.c20, RN4.12 (R5.2)
/Main Bus/AD29: RN4.6 (R6.1); also elsewhere on the board
/Main Bus/AD29R: J2.a20, RN4.11 (R6.2)
/Main Bus/AD30: RN4.7 (R7.1); also elsewhere on the board
/Main Bus/AD30R: J2.c21, RN4.10 (R7.2)
/Main Bus/AD31: RN4.8 (R8.1); also elsewhere on the board
/Main Bus/AD31R: J2.a21, RN4.9 (R8.2)
/Main Bus/BDDIR: U2.24 (IO46); also elsewhere on the board
/Main Bus/Bus-Clk_R: J2.a29, U15.18 (O0a)
/Main Bus/Bus-R/~W_R: J2.c5, U15.7 (O1b)
/Main Bus/BusClk3: U2.83 (GCLK1), U6.26 (2A7)
/Main Bus/BusClk5: J3.2, U6.23 (2B7), U15.2 (I0a)
/Main Bus/BusOsc: J3.3, Y3.5 (OUT)
/Main Bus/XA1: U2.30 (IO37); also elsewhere on the board
/Main Bus/XA2: U2.29 (IO38); also elsewhere on the board
/Main Bus/XA3: U2.28 (IO40); also elsewhere on the board
/Main Bus/XA30: U2.33 (IO64); also elsewhere on the board
/Main Bus/XA31: U2.35 (IO59); also elsewhere on the board
/Main Bus/~AEN: U2.27 (IO43); also elsewhere on the board
/Main Bus/~Ack: U2.20 (IO21), U6.36 (2A0)
/Main Bus/~BE0: U2.21 (IO19), U15.8 (I3a)
/Main Bus/~BE1: U2.18 (IO24), U15.6 (I2a)
/Main Bus/~BE2: U2.16 (IO27), U15.4 (I1a)
/Main Bus/~BE3: U2.17 (IO25), U15.17 (I3b)
/Main Bus/~BEN-8-0: U2.36 (IO57); also elsewhere on the board
/Main Bus/~BEN-8-1: U2.25 (IO45); also elsewhere on the board
/Main Bus/~BEN-8-2: U2.22 (IO17); also elsewhere on the board
/Main Bus/~BEN-16: U2.34 (IO61); also elsewhere on the board
/Main Bus/~BEN-32: U2.31 (IO35); also elsewhere on the board
/Main Bus/~Bus-ACK: J2.a27, R35.1, U6.13 (2B0)
/Main Bus/~Bus-BE0_R: J2.c24, U15.12 (O3a)
/Main Bus/~Bus-BE1_R: J2.a24, U15.14 (O2a)
/Main Bus/~Bus-BE2_R: J2.c25, U15.16 (O1a)
/Main Bus/~Bus-BE3_R: J2.a25, U15.3 (O3b)
/Main Bus/~Bus-BERR: J2.c28, R39.1, U6.19 (2B4)
/Main Bus/~Bus-BRACK: J2.c26, R38.1
/Main Bus/~Bus-BURST: J2.a26, R34.1
/Main Bus/~Bus-GNT: J2.c23, R37.1, U2.81 (IO128)
/Main Bus/~Bus-IACK: J2.c4, R33.1
/Main Bus/~Bus-IRQ0: J2.a3, R29.1, U6.14 (2B1)
/Main Bus/~Bus-IRQ1: J2.a4, R30.1, U6.16 (2B2)
/Main Bus/~Bus-IRQ2: J2.a5, R31.1, U6.17 (2B3)
/Main Bus/~Bus-REQ: J2.c22, R36.1, U6.20 (2B5)
/Main Bus/~Bus-Reset_R: J2.c3, R32.1, U15.5 (O2b)
/Main Bus/~Bus-Start_R: J2.c27, U15.9 (O0b)
/Main Bus/~IRQ0-In: U2.6 (IO13), U6.35 (2A1)
/Main Bus/~IRQ1-In: U2.5 (IO14), U6.33 (2A2)
/Main Bus/~IRQ2-In: U2.4 (IO16), U6.32 (2A3)
/Main Bus/~REQ: U2.77 (IO123), U6.29 (2A5)
/Main Bus/~Start: U2.15 (IO29), U15.11 (I0b)
/R/~W: U2.12 (IO3), U15.13 (I1b); also elsewhere on the board
/~Reset: U2.1 (GCLR), U15.15 (I2b); also elsewhere on the board
GND: C36.2, C37.2, C54.2, C55.2, J2.a1, J2.a28, J2.a32, J2.b1, J2.b7, J2.b8, J2.b9, J2.b10, J2.b11, J2.b12, J2.b13, J2.b14, J2.b15, J2.b16, J2.b17, J2.b18, J2.b19, J2.b20, J2.b21, J2.b28, J2.b29, J2.b30, J2.b32, J2.c1, J2.c29, J2.c32, U6.4 (GND), U6.10 (GND), U6.15 (GND), U6.21 (GND), U6.24 (2DIR), U6.25 (2~OE), U6.28 (GND), U6.34 (GND), U6.39 (GND), U6.45 (GND), U6.48 (1~OE), U15.1 (OEa), U15.10 (GND), U15.19 (OEb), Y3.4 (GND); also elsewhere on the board

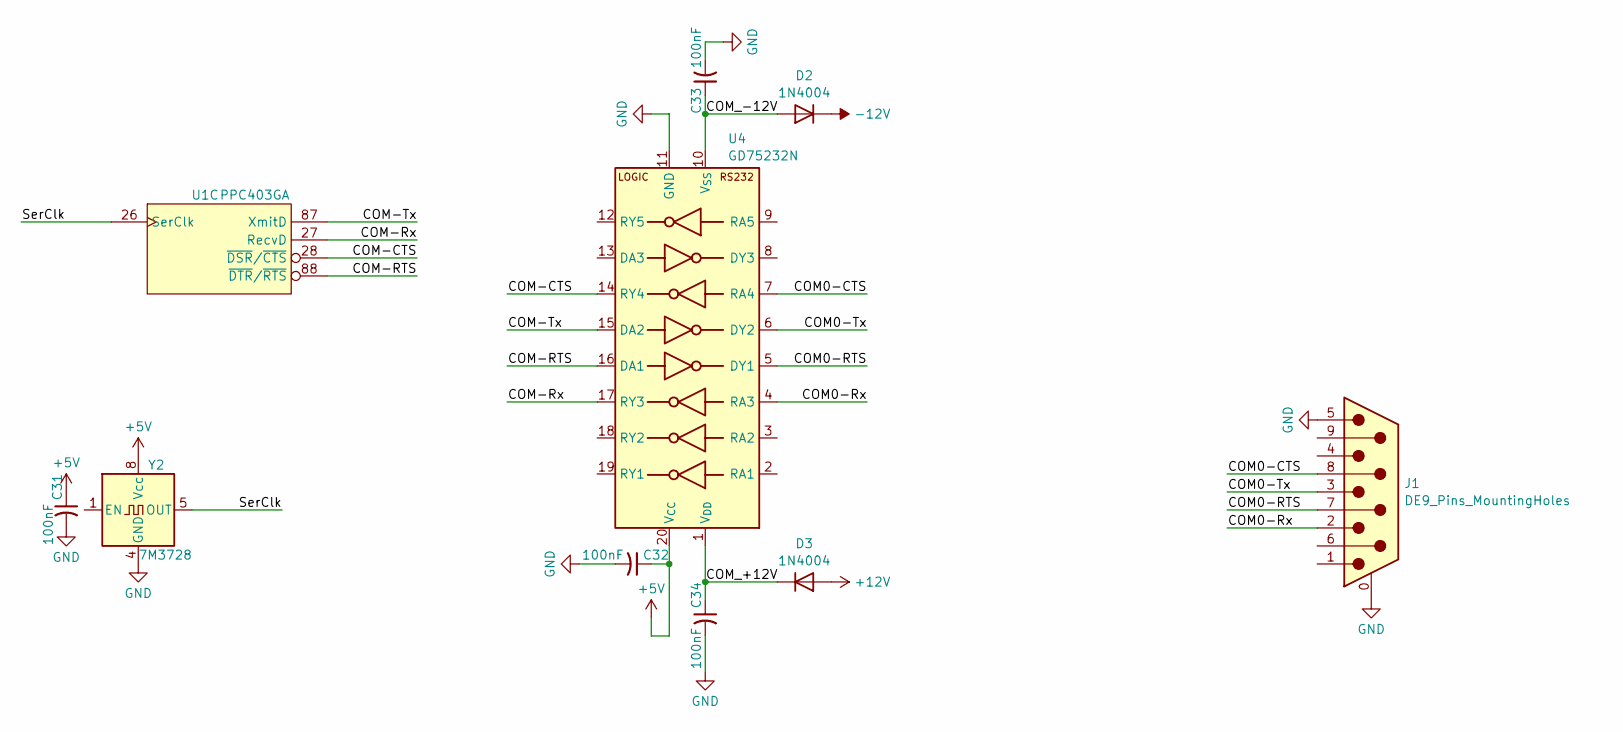
[picture p34: schematic serial.kicad_sch, PikaPC Host Card]

Parts:
C31, C32, C33, C34: 100nF; C_0805_2012Metric; Mouser 187-CL21B104KACNNNC
D2, D3: 1N4004; D_DO-41_SOD81_P7.62mm_Horizontal; Mouser 750-1N4004-G
J1: DE9_Pins_MountingHoles; DSUB-9_Pins_Horizontal_P2.77x2.84mm_EdgePinOffset4.94mm_Hou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
U1: PPC403GA; PQFP-160_28x28mm_P0.65mm
U4: GD75232N; DIP-20_W7.62mm; Mouser 595-GD75232N
Y2: 7M3728; Oscillator_DIP-8

Connections:
+5V: C31.1, C32.1, U4.20 (V_{CC}), Y2.8 (Vcc); also elsewhere on the board
+12V: D3.2 (A); also elsewhere on the board
-12V: D2.1 (K); also elsewhere on the board
/Serial/COM0-CTS: J1.8, U4.7 (RA4)
/Serial/COM0-RTS: J1.7, U4.5 (DY1)
/Serial/COM0-Rx: J1.2, U4.4 (RA3)
/Serial/COM0-Tx: J1.3, U4.6 (DY2)
/Serial/COM-CTS: U1.28 (~DSR/~CTS), U4.14 (RY4)
/Serial/COM-RTS: U1.88 (~DTR/~RTS), U4.16 (DA1)
/Serial/COM-Rx: U1.27 (RecvD), U4.17 (RY3)
/Serial/COM-Tx: U1.87 (XmitD), U4.15 (DA2)
/Serial/COM_+12V: C34.1, D3.1 (K), U4.1 (V_{DD})
/Serial/COM_-12V: C33.1, D2.2 (A), U4.10 (V_{SS})
/Serial/SerClk: U1.26 (SerClk), Y2.5 (OUT)
GND: C31.2, C32.2, C33.2, C34.2, J1.0 (PAD), J1.5, U4.11 (GND), Y2.4 (GND); also elsewhere on the board

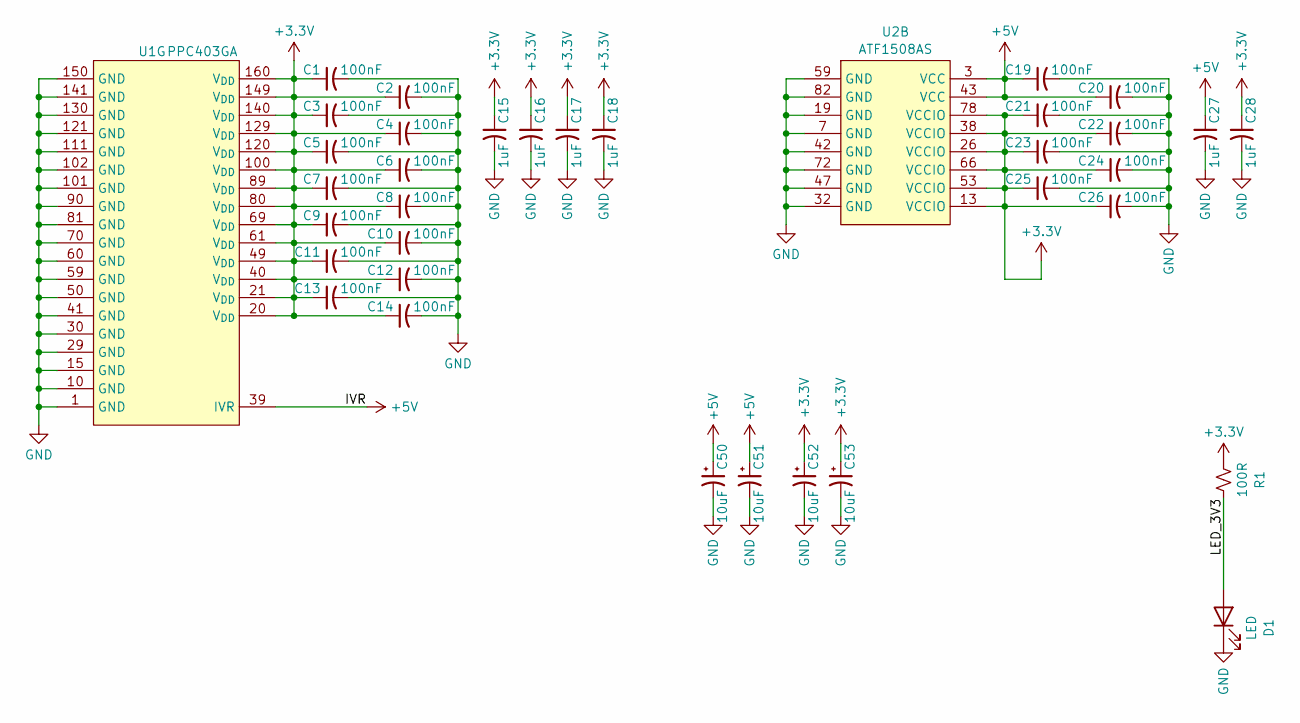
[picture p35: schematic power.kicad_sch, PikaPC Host Card]

Parts:
C1, C2, C3, C4, C5, C6, C7, C8, C9, C10, C11, C12, C13, C14, C19, C20, C21, C22, C23, C24, C25, C26: 100nF; C_0805_2012Metric; Mouser 187-CL21B104KACNNNC
C15, C16, C17, C18, C27, C28: 1uF; C_0805_2012Metric; Mouser 187-CL21B105KOFNNNG
C50, C51, C52, C53: 10uF; CP_Elec_4x5.7; Mouser 80-EDK106M016A9BAA
D1: LED; LED_D5.0mm_Horizontal_O3.81mm_Z3.0mm
R1: 100R; R_0805_2012Metric
U1: PPC403GA; PQFP-160_28x28mm_P0.65mm
U2: ATF1508AS; PLCC-84_THT-Socket

Connections:
+3.3V: C1.1, C2.1, C3.1, C4.1, C5.1, C6.1, C7.1, C8.1, C9.1, C10.1, C11.1, C12.1, C13.1, C14.1, C15.1, C16.1, C17.1, C18.1, C21.1, C22.1, C23.1, C24.1, C25.1, C26.1, C28.1, C52.1, C53.1, R1.1, U1.20 (V_{DD}), U1.21 (V_{DD}), U1.40 (V_{DD}), U1.49 (V_{DD}), U1.61 (V_{DD}), U1.69 (V_{DD}), U1.80 (V_{DD}), U1.89 (V_{DD}), U1.100 (V_{DD}), U1.120 (V_{DD}), U1.129 (V_{DD}), U1.140 (V_{DD}), U1.149 (V_{DD}), U1.160 (V_{DD}), U2.13 (VCCIO), U2.26 (VCCIO), U2.38 (VCCIO), U2.53 (VCCIO), U2.66 (VCCIO), U2.78 (VCCIO); also elsewhere on the board
+5V: C19.1, C20.1, C27.1, C50.1, C51.1, U1.39 (IVR), U2.3 (VCC), U2.43 (VCC); also elsewhere on the board
/Power/LED_3V3: D1.2 (A), R1.2
GND: C1.2, C2.2, C3.2, C4.2, C5.2, C6.2, C7.2, C8.2, C9.2, C10.2, C11.2, C12.2, C13.2, C14.2, C15.2, C16.2, C17.2, C18.2, C19.2, C20.2, C21.2, C22.2, C23.2, C24.2, C25.2, C26.2, C27.2, C28.2, C50.2, C51.2, C52.2, C53.2, D1.1 (K), U1.1 (GND), U1.10 (GND), U1.15 (GND), U1.29 (GND), U1.30 (GND), U1.41 (GND), U1.50 (GND), U1.59 (GND), U1.60 (GND), U1.70 (GND), U1.81 (GND), U1.90 (GND), U1.101 (GND), U1.102 (GND), U1.111 (GND), U1.121 (GND), U1.130 (GND), U1.141 (GND), U1.150 (GND), U2.7 (GND), U2.19 (GND), U2.32 (GND), U2.42 (GND), U2.47 (GND), U2.59 (GND), U2.72 (GND), U2.82 (GND); also elsewhere on the board
