techav-homebrew/PikaPC/Hardware/PikaPC_Host/PikaPC_Host.kicad_pcb

## KiCad design Hardware/PikaPC_Host/PikaPC_Host.kicad_pcb (continued)

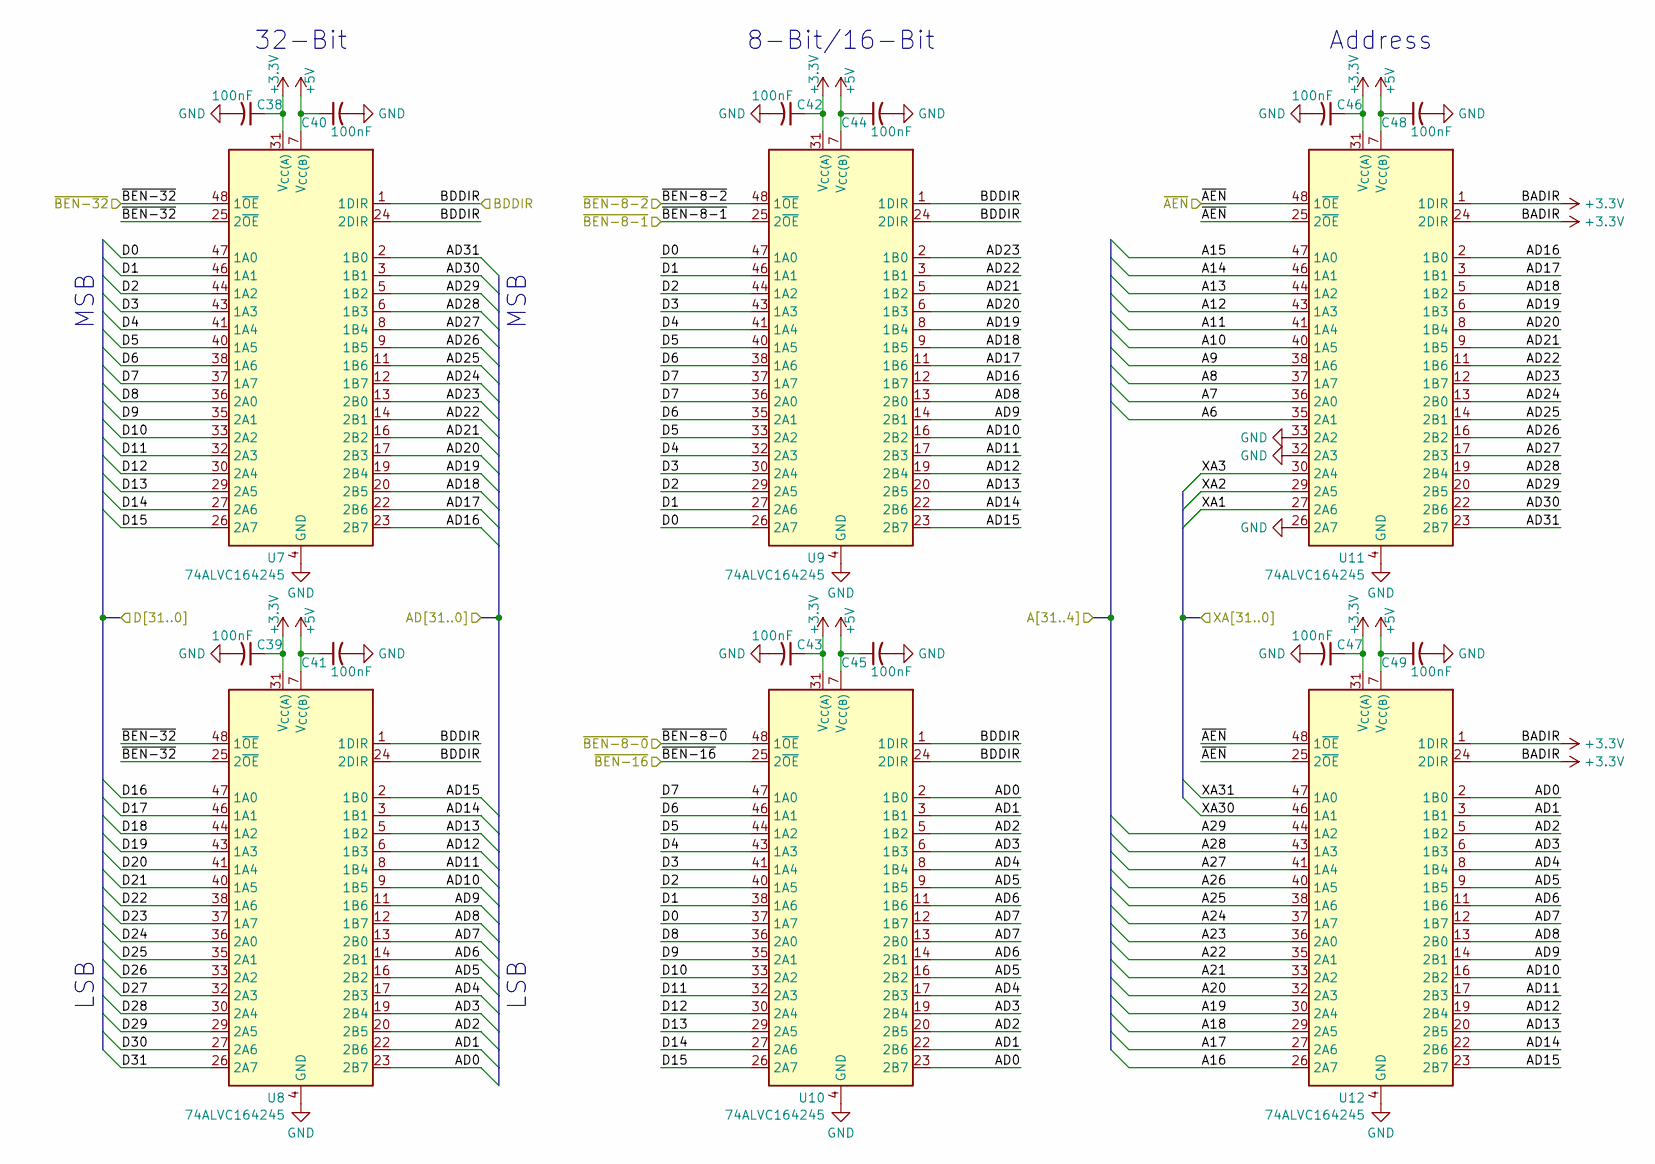
[picture p36: schematic bus_transceivers.kicad_sch, PikaPC Host Card]

Parts:
C38, C39, C40, C41, C42, C43, C44, C45, C46, C47, C48, C49: 100nF; C_0805_2012Metric; Mouser 187-CL21B104KACNNNC
U7, U8, U9, U10, U11, U12: 74ALVC164245; TSSOP-48_6.1x12.5mm_P0.5mm; Mouser 972-74ALVC164245PAG8

Connections:
+3.3V: C38.1, C39.1, C42.1, C43.1, C46.1, C47.1, U7.31 (V_{CC(A)}), U7.42 (V_{CC(A)}), U8.31 (V_{CC(A)}), U8.42 (V_{CC(A)}), U9.31 (V_{CC(A)}), U9.42 (V_{CC(A)}), U10.31 (V_{CC(A)}), U10.42 (V_{CC(A)}), U11.1 (1DIR), U11.24 (2DIR), U11.31 (V_{CC(A)}), U11.42 (V_{CC(A)}), U12.1 (1DIR), U12.24 (2DIR), U12.31 (V_{CC(A)}), U12.42 (V_{CC(A)}); also elsewhere on the board
+5V: C40.1, C41.1, C44.1, C45.1, C48.1, C49.1, U7.7 (V_{CC(B)}), U7.18 (V_{CC(B)}), U8.7 (V_{CC(B)}), U8.18 (V_{CC(B)}), U9.7 (V_{CC(B)}), U9.18 (V_{CC(B)}), U10.7 (V_{CC(B)}), U10.18 (V_{CC(B)}), U11.7 (V_{CC(B)}), U11.18 (V_{CC(B)}), U12.7 (V_{CC(B)}), U12.18 (V_{CC(B)}); also elsewhere on the board
/CPU Bus/D0: U7.47 (1A0), U9.26 (2A7), U9.47 (1A0), U10.37 (1A7); also elsewhere on the board
/CPU Bus/D1: U7.46 (1A1), U9.27 (2A6), U9.46 (1A1), U10.38 (1A6); also elsewhere on the board
/CPU Bus/D2: U7.44 (1A2), U9.29 (2A5), U9.44 (1A2), U10.40 (1A5); also elsewhere on the board
/CPU Bus/D3: U7.43 (1A3), U9.30 (2A4), U9.43 (1A3), U10.41 (1A4); also elsewhere on the board
/CPU Bus/D4: U7.41 (1A4), U9.32 (2A3), U9.41 (1A4), U10.43 (1A3); also elsewhere on the board
/CPU Bus/D5: U7.40 (1A5), U9.33 (2A2), U9.40 (1A5), U10.44 (1A2); also elsewhere on the board
/CPU Bus/D6: U7.38 (1A6), U9.35 (2A1), U9.38 (1A6), U10.46 (1A1); also elsewhere on the board
/CPU Bus/D7: U7.37 (1A7), U9.36 (2A0), U9.37 (1A7), U10.47 (1A0); also elsewhere on the board
/CPU Bus/D8: U7.36 (2A0), U10.36 (2A0); also elsewhere on the board
/CPU Bus/D9: U7.35 (2A1), U10.35 (2A1); also elsewhere on the board
/CPU Bus/D10: U7.33 (2A2), U10.33 (2A2); also elsewhere on the board
/CPU Bus/D11: U7.32 (2A3), U10.32 (2A3); also elsewhere on the board
/CPU Bus/D12: U7.30 (2A4), U10.30 (2A4); also elsewhere on the board
/CPU Bus/D13: U7.29 (2A5), U10.29 (2A5); also elsewhere on the board
/CPU Bus/D14: U7.27 (2A6), U10.27 (2A6); also elsewhere on the board
/CPU Bus/D15: U7.26 (2A7), U10.26 (2A7); also elsewhere on the board
/CPU Bus/D16: U8.47 (1A0); also elsewhere on the board
/CPU Bus/D17: U8.46 (1A1); also elsewhere on the board
/CPU Bus/D18: U8.44 (1A2); also elsewhere on the board
/CPU Bus/D19: U8.43 (1A3); also elsewhere on the board
/CPU Bus/D20: U8.41 (1A4); also elsewhere on the board
/CPU Bus/D21: U8.40 (1A5); also elsewhere on the board
/CPU Bus/D22: U8.38 (1A6); also elsewhere on the board
/CPU Bus/D23: U8.37 (1A7); also elsewhere on the board
/CPU Bus/D24: U8.36 (2A0); also elsewhere on the board
/CPU Bus/D25: U8.35 (2A1); also elsewhere on the board
/CPU Bus/D26: U8.33 (2A2); also elsewhere on the board
/CPU Bus/D27: U8.32 (2A3); also elsewhere on the board
/CPU Bus/D28: U8.30 (2A4); also elsewhere on the board
/CPU Bus/D29: U8.29 (2A5); also elsewhere on the board
/CPU Bus/D30: U8.27 (2A6); also elsewhere on the board
/CPU Bus/D31: U8.26 (2A7); also elsewhere on the board
/Main Bus/A6: U11.35 (2A1); also elsewhere on the board
/Main Bus/A7: U11.36 (2A0); also elsewhere on the board
/Main Bus/A8: U11.37 (1A7); also elsewhere on the board
/Main Bus/A9: U11.38 (1A6); also elsewhere on the board
/Main Bus/A10: U11.40 (1A5); also elsewhere on the board
/Main Bus/A11: U11.41 (1A4); also elsewhere on the board
/Main Bus/A12: U11.43 (1A3); also elsewhere on the board
/Main Bus/A13: U11.44 (1A2); also elsewhere on the board
/Main Bus/A14: U11.46 (1A1); also elsewhere on the board
/Main Bus/A15: U11.47 (1A0); also elsewhere on the board
/Main Bus/A16: U12.26 (2A7); also elsewhere on the board
/Main Bus/A17: U12.27 (2A6); also elsewhere on the board
/Main Bus/A18: U12.29 (2A5); also elsewhere on the board
/Main Bus/A19: U12.30 (2A4); also elsewhere on the board
/Main Bus/A20: U12.32 (2A3); also elsewhere on the board
/Main Bus/A21: U12.33 (2A2); also elsewhere on the board
/Main Bus/A22: U12.35 (2A1); also elsewhere on the board
/Main Bus/A23: U12.36 (2A0); also elsewhere on the board
/Main Bus/A24: U12.37 (1A7); also elsewhere on the board
/Main Bus/A25: U12.38 (1A6); also elsewhere on the board
/Main Bus/A26: U12.40 (1A5); also elsewhere on the board
/Main Bus/A27: U12.41 (1A4); also elsewhere on the board
/Main Bus/A28: U12.43 (1A3); also elsewhere on the board
/Main Bus/A29: U12.44 (1A2); also elsewhere on the board
/Main Bus/AD0: U8.23 (2B7), U10.2 (1B0), U10.23 (2B7), U12.2 (1B0); also elsewhere on the board
/Main Bus/AD1: U8.22 (2B6), U10.3 (1B1), U10.22 (2B6), U12.3 (1B1); also elsewhere on the board
/Main Bus/AD2: U8.20 (2B5), U10.5 (1B2), U10.20 (2B5), U12.5 (1B2); also elsewhere on the board
/Main Bus/AD3: U8.19 (2B4), U10.6 (1B3), U10.19 (2B4), U12.6 (1B3); also elsewhere on the board
/Main Bus/AD4: U8.17 (2B3), U10.8 (1B4), U10.17 (2B3), U12.8 (1B4); also elsewhere on the board
/Main Bus/AD5: U8.16 (2B2), U10.9 (1B5), U10.16 (2B2), U12.9 (1B5); also elsewhere on the board
/Main Bus/AD6: U8.14 (2B1), U10.11 (1B6), U10.14 (2B1), U12.11 (1B6); also elsewhere on the board
/Main Bus/AD7: U8.13 (2B0), U10.12 (1B7), U10.13 (2B0), U12.12 (1B7); also elsewhere on the board
/Main Bus/AD8: U8.12 (1B7), U9.13 (2B0), U12.13 (2B0); also elsewhere on the board
/Main Bus/AD9: U8.11 (1B6), U9.14 (2B1), U12.14 (2B1); also elsewhere on the board
/Main Bus/AD10: U8.9 (1B5), U9.16 (2B2), U12.16 (2B2); also elsewhere on the board
/Main Bus/AD11: U8.8 (1B4), U9.17 (2B3), U12.17 (2B3); also elsewhere on the board
/Main Bus/AD12: U8.6 (1B3), U9.19 (2B4), U12.19 (2B4); also elsewhere on the board
/Main Bus/AD13: U8.5 (1B2), U9.20 (2B5), U12.20 (2B5); also elsewhere on the board
/Main Bus/AD14: U8.3 (1B1), U9.22 (2B6), U12.22 (2B6); also elsewhere on the board
/Main Bus/AD15: U8.2 (1B0), U9.23 (2B7), U12.23 (2B7); also elsewhere on the board
/Main Bus/AD16: U7.23 (2B7), U9.12 (1B7), U11.2 (1B0); also elsewhere on the board
/Main Bus/AD17: U7.22 (2B6), U9.11 (1B6), U11.3 (1B1); also elsewhere on the board
/Main Bus/AD18: U7.20 (2B5), U9.9 (1B5), U11.5 (1B2); also elsewhere on the board
/Main Bus/AD19: U7.19 (2B4), U9.8 (1B4), U11.6 (1B3); also elsewhere on the board
/Main Bus/AD20: U7.17 (2B3), U9.6 (1B3), U11.8 (1B4); also elsewhere on the board
/Main Bus/AD21: U7.16 (2B2), U9.5 (1B2), U11.9 (1B5); also elsewhere on the board
/Main Bus/AD22: U7.14 (2B1), U9.3 (1B1), U11.11 (1B6); also elsewhere on the board
/Main Bus/AD23: U7.13 (2B0), U9.2 (1B0), U11.12 (1B7); also elsewhere on the board
/Main Bus/AD24: U7.12 (1B7), U11.13 (2B0); also elsewhere on the board
/Main Bus/AD25: U7.11 (1B6), U11.14 (2B1); also elsewhere on the board
/Main Bus/AD26: U7.9 (1B5), U11.16 (2B2); also elsewhere on the board
/Main Bus/AD27: U7.8 (1B4), U11.17 (2B3); also elsewhere on the board
/Main Bus/AD28: U7.6 (1B3), U11.19 (2B4); also elsewhere on the board
/Main Bus/AD29: U7.5 (1B2), U11.20 (2B5); also elsewhere on the board
/Main Bus/AD30: U7.3 (1B1), U11.22 (2B6); also elsewhere on the board
/Main Bus/AD31: U7.2 (1B0), U11.23 (2B7); also elsewhere on the board
/Main Bus/BDDIR: U7.1 (1DIR), U7.24 (2DIR), U8.1 (1DIR), U8.24 (2DIR), U9.1 (1DIR), U9.24 (2DIR), U10.1 (1DIR), U10.24 (2DIR); also elsewhere on the board
/Main Bus/XA1: U11.27 (2A6); also elsewhere on the board
/Main Bus/XA2: U11.29 (2A5); also elsewhere on the board
/Main Bus/XA3: U11.30 (2A4); also elsewhere on the board
/Main Bus/XA30: U12.46 (1A1); also elsewhere on the board
/Main Bus/XA31: U12.47 (1A0); also elsewhere on the board
/Main Bus/~AEN: U11.25 (2~OE), U11.48 (1~OE), U12.25 (2~OE), U12.48 (1~OE); also elsewhere on the board
/Main Bus/~BEN-8-0: U10.48 (1~OE); also elsewhere on the board
/Main Bus/~BEN-8-1: U9.25 (2~OE); also elsewhere on the board
/Main Bus/~BEN-8-2: U9.48 (1~OE); also elsewhere on the board
/Main Bus/~BEN-16: U10.25 (2~OE); also elsewhere on the board
/Main Bus/~BEN-32: U7.25 (2~OE), U7.48 (1~OE), U8.25 (2~OE), U8.48 (1~OE); also elsewhere on the board
GND: C38.2, C39.2, C40.2, C41.2, C42.2, C43.2, C44.2, C45.2, C46.2, C47.2, C48.2, C49.2, U7.4 (GND), U7.10 (GND), U7.15 (GND), U7.21 (GND), U7.28 (GND), U7.34 (GND), U7.39 (GND), U7.45 (GND), U8.4 (GND), U8.10 (GND), U8.15 (GND), U8.21 (GND), U8.28 (GND), U8.34 (GND), U8.39 (GND), U8.45 (GND), U9.4 (GND), U9.10 (GND), U9.15 (GND), U9.21 (GND), U9.28 (GND), U9.34 (GND), U9.39 (GND), U9.45 (GND), U10.4 (GND), U10.10 (GND), U10.15 (GND), U10.21 (GND), U10.28 (GND), U10.34 (GND), U10.39 (GND), U10.45 (GND), U11.4 (GND), U11.10 (GND), U11.15 (GND), U11.21 (GND), U11.26 (2A7), U11.28 (GND), U11.32 (2A3), U11.33 (2A2), U11.34 (GND), U11.39 (GND), U11.45 (GND), U12.4 (GND), U12.10 (GND), U12.15 (GND), U12.21 (GND), U12.28 (GND), U12.34 (GND), U12.39 (GND), U12.45 (GND); also elsewhere on the board

Notes on the sheet:
LSB
MSB
8-Bit/16-Bit
Address
32-Bit

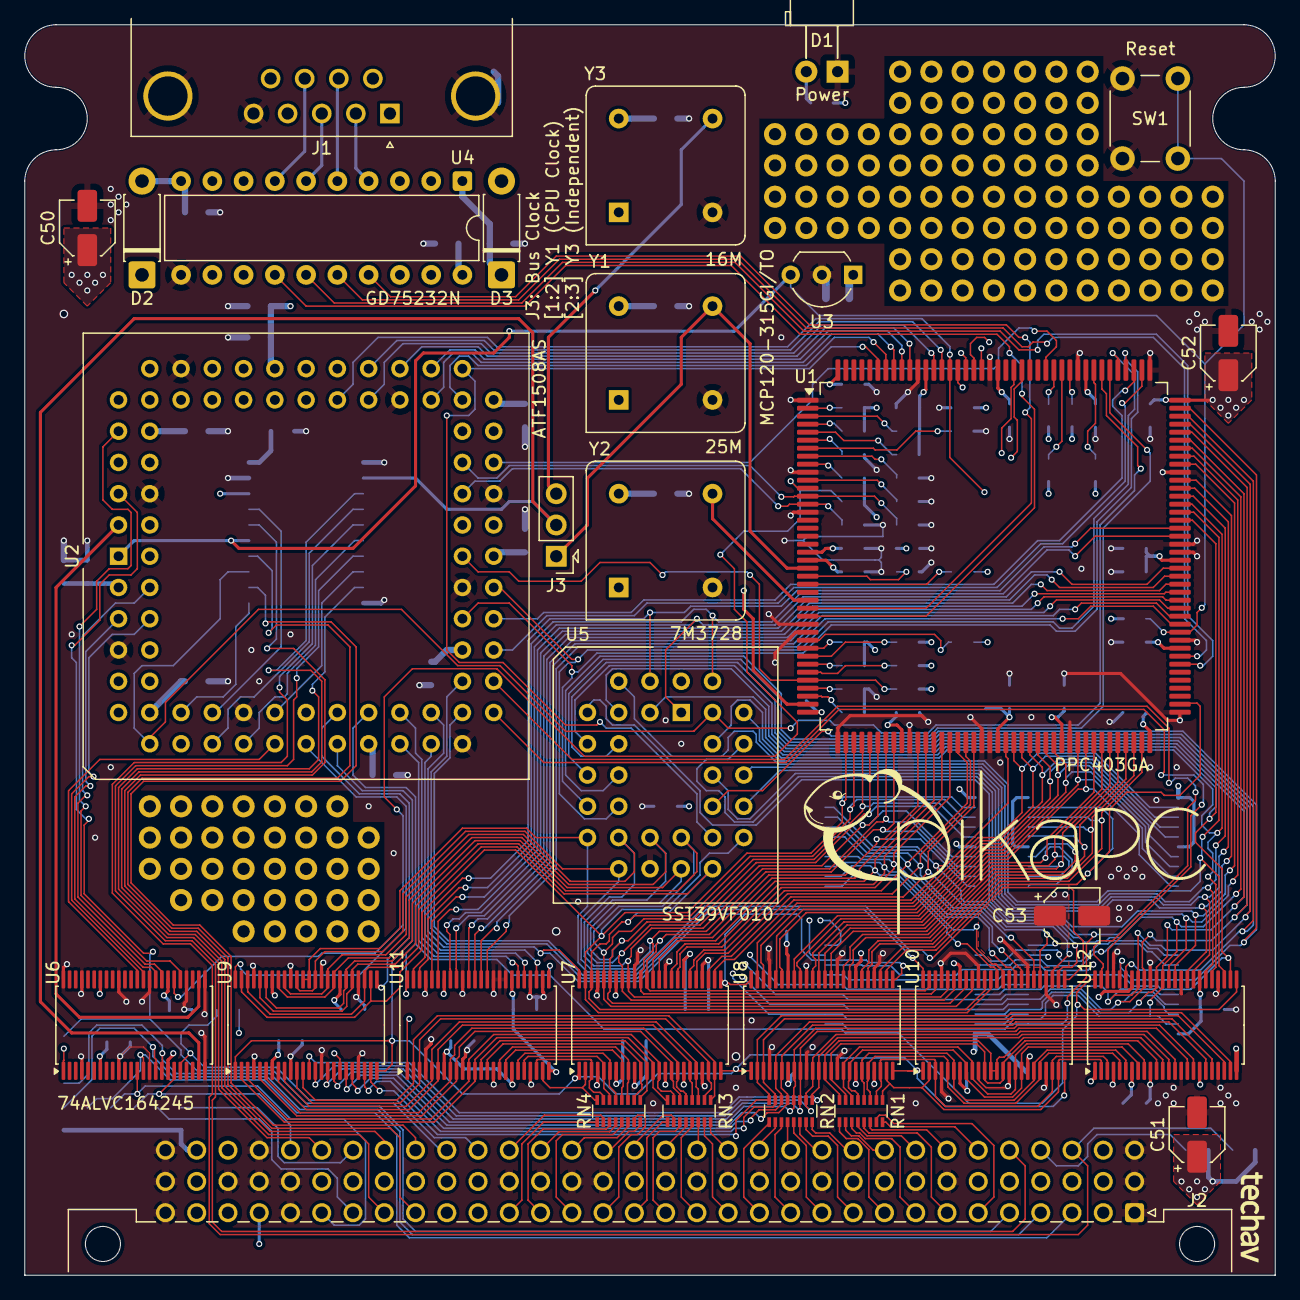
[picture p37: board PikaPC_Host.kicad_pcb from above]

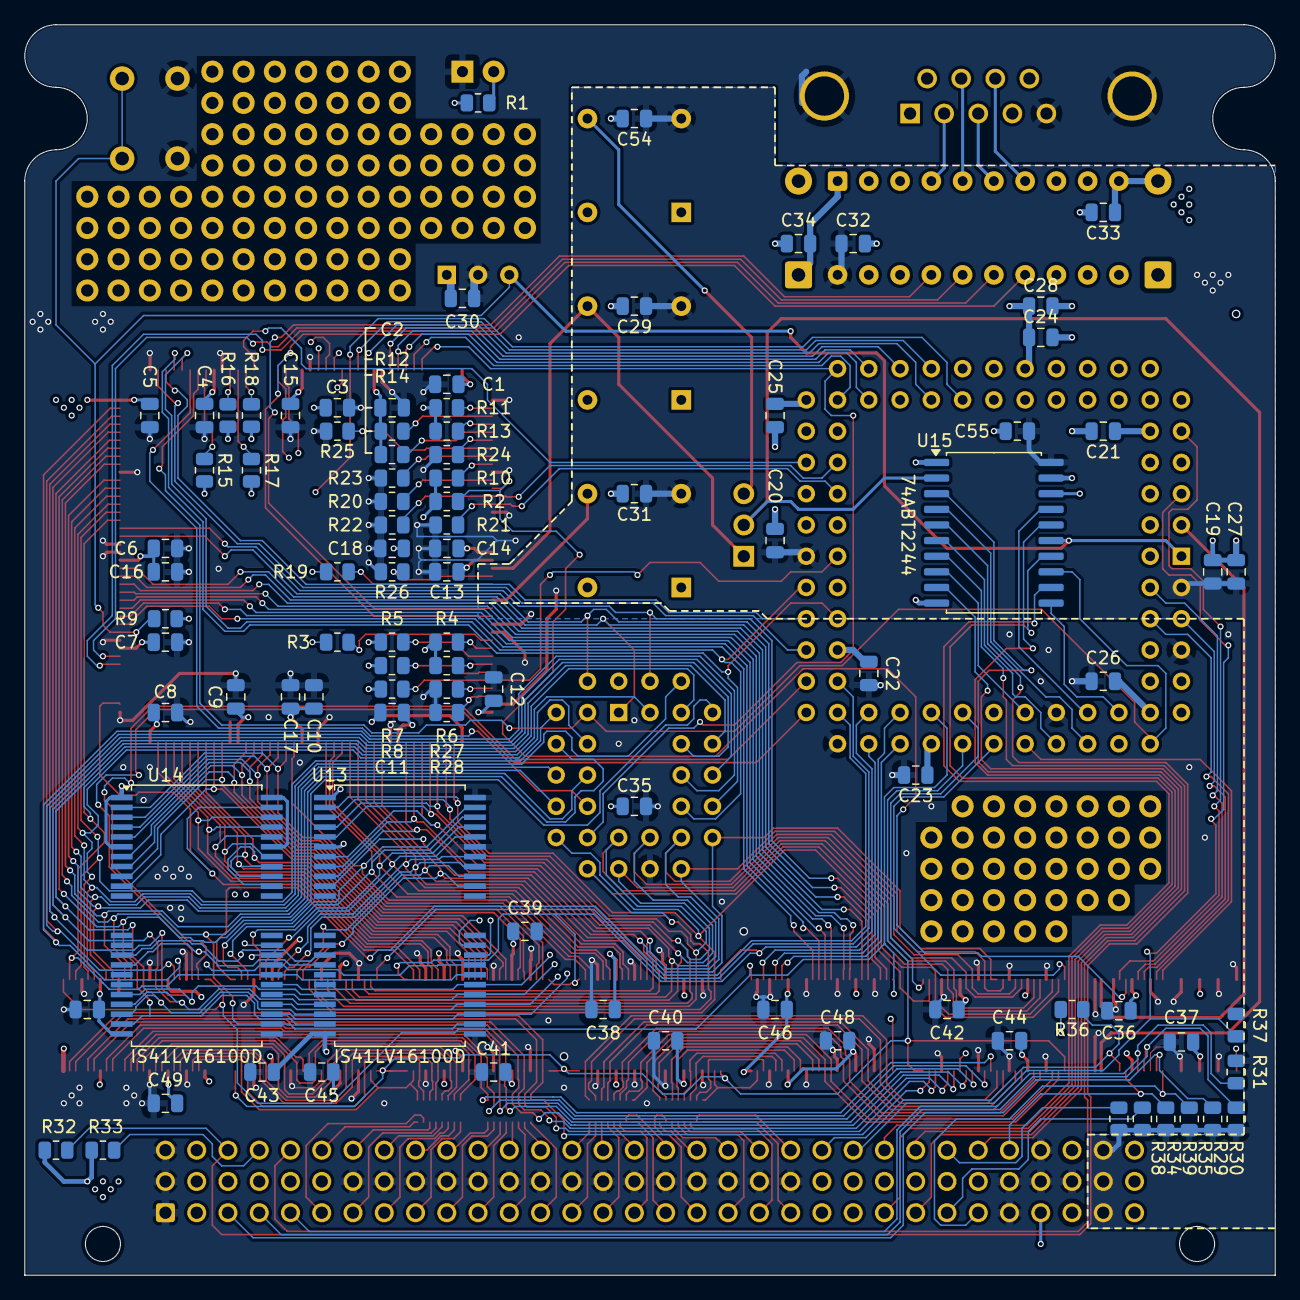
[picture p38: board PikaPC_Host.kicad_pcb from below]

Board: 4 copper layers, 101.6 x 101.6 mm, 123 parts (93 on the bottom side), 229 nets.
