techav-homebrew/PikaPC/Hardware/PikaPC_SIMM72/PikaPC_SIMM72.kicad_pcb

## KiCad design Hardware/PikaPC_SIMM72/PikaPC_SIMM72.kicad_pcb (2026-05-26)

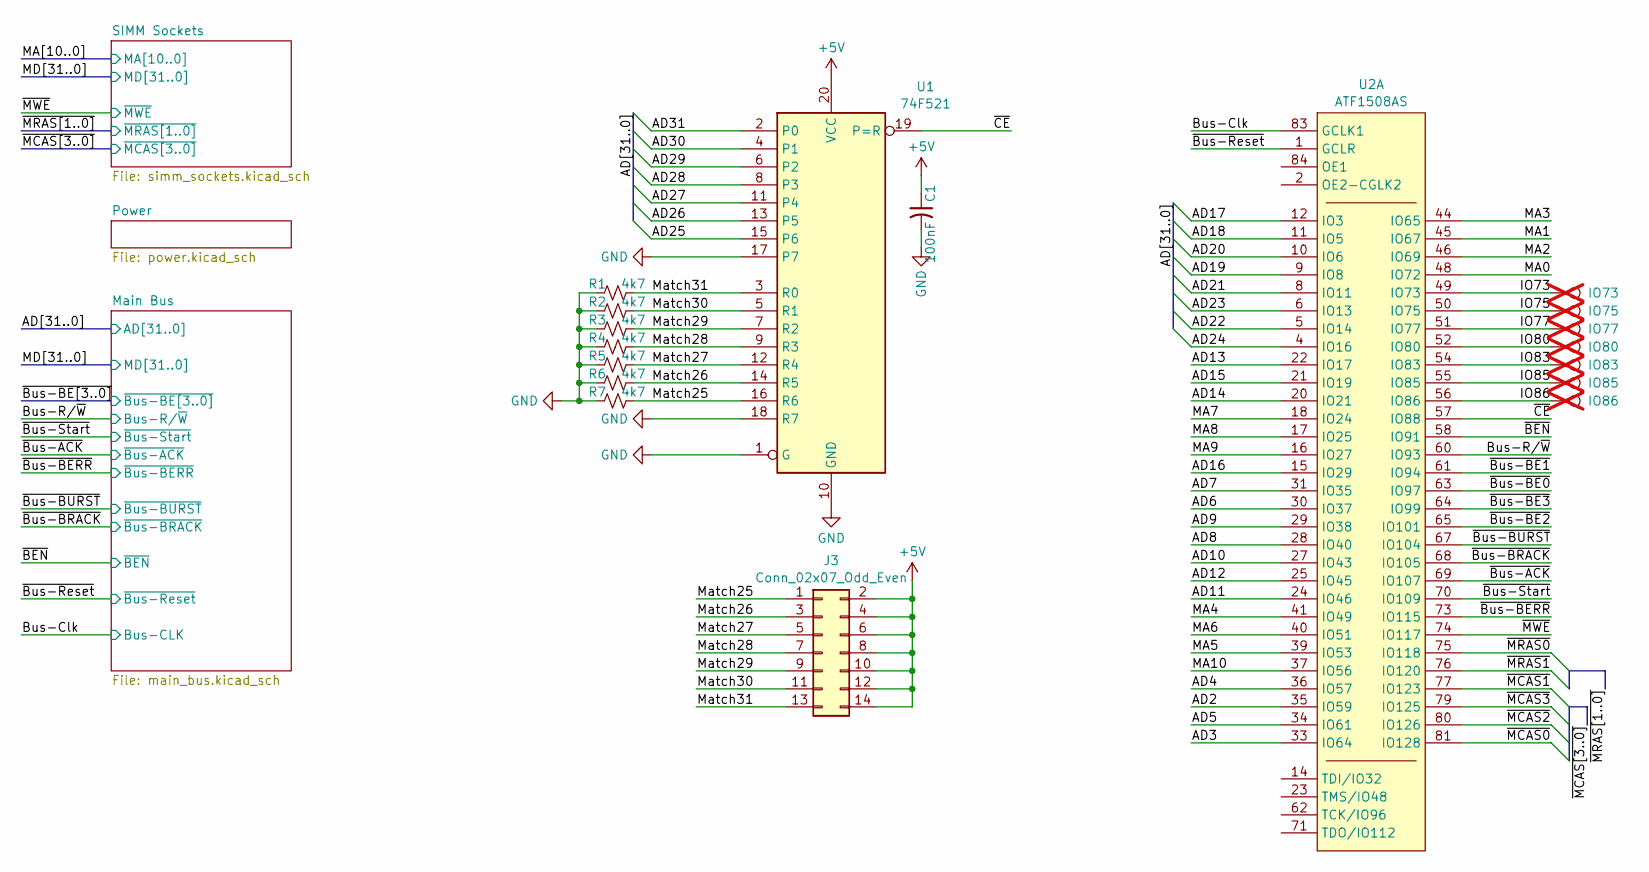
[picture p39: schematic PikaPC_SIMM72.kicad_sch, PikaPC 72-Pin SIMM Card]

Parts:
C1: 100nF; C_0805_2012Metric; Mouser 187-CL21B104KACNNNC
IO73, IO75, IO77, IO80, IO83, IO85, IO86: TestPoint; PinHeader_1x01_P2.54mm_Vertical; not fitted
J3: Conn_02x07_Odd_Even; PinHeader_2x07_P2.54mm_Vertical
R1, R2, R3, R4, R5, R6, R7: 4k7; R_0805_2012Metric; Mouser 303-0805W8J0472T5E
U1: 74F521; SOIC-20W_7.5x12.8mm_P1.27mm; Mouser 595-SN74F521DWR
U2: ATF1508AS; PLCC-84_THT-Socket

Connections:
+5V: C1.1, J3.2, J3.4, J3.6, J3.8, J3.10, J3.12, J3.14, U1.20 (VCC); also elsewhere on the board
/AD2: U2.35 (IO59); also elsewhere on the board
/AD3: U2.33 (IO64); also elsewhere on the board
/AD4: U2.36 (IO57); also elsewhere on the board
/AD5: U2.34 (IO61); also elsewhere on the board
/AD6: U2.30 (IO37); also elsewhere on the board
/AD7: U2.31 (IO35); also elsewhere on the board
/AD8: U2.28 (IO40); also elsewhere on the board
/AD9: U2.29 (IO38); also elsewhere on the board
/AD10: U2.27 (IO43); also elsewhere on the board
/AD11: U2.24 (IO46); also elsewhere on the board
/AD12: U2.25 (IO45); also elsewhere on the board
/AD13: U2.22 (IO17); also elsewhere on the board
/AD14: U2.20 (IO21); also elsewhere on the board
/AD15: U2.21 (IO19); also elsewhere on the board
/AD16: U2.15 (IO29); also elsewhere on the board
/AD17: U2.12 (IO3); also elsewhere on the board
/AD18: U2.11 (IO5); also elsewhere on the board
/AD19: U2.9 (IO8); also elsewhere on the board
/AD20: U2.10 (IO6); also elsewhere on the board
/AD21: U2.8 (IO11); also elsewhere on the board
/AD22: U2.5 (IO14); also elsewhere on the board
/AD23: U2.6 (IO13); also elsewhere on the board
/AD24: U2.4 (IO16); also elsewhere on the board
/AD25: U1.15 (P6); also elsewhere on the board
/AD26: U1.13 (P5); also elsewhere on the board
/AD27: U1.11 (P4); also elsewhere on the board
/AD28: U1.8 (P3); also elsewhere on the board
/AD29: U1.6 (P2); also elsewhere on the board
/AD30: U1.4 (P1); also elsewhere on the board
/AD31: U1.2 (P0); also elsewhere on the board
/Bus-Clk: U2.83 (GCLK1); also elsewhere on the board
/Bus-R/~W: U2.60 (IO93); also elsewhere on the board
/IO73: IO73.1, U2.49 (IO73)
/IO75: IO75.1, U2.50 (IO75)
/IO77: IO77.1, U2.51 (IO77)
/IO80: IO80.1, U2.52 (IO80)
/IO83: IO83.1, U2.54 (IO83)
/IO85: IO85.1, U2.55 (IO85)
/IO86: IO86.1, U2.56 (IO86)
/MA0: U2.48 (IO72); also elsewhere on the board
/MA1: U2.45 (IO67); also elsewhere on the board
/MA2: U2.46 (IO69); also elsewhere on the board
/MA3: U2.44 (IO65); also elsewhere on the board
/MA4: U2.41 (IO49); also elsewhere on the board
/MA5: U2.39 (IO53); also elsewhere on the board
/MA6: U2.40 (IO51); also elsewhere on the board
/MA7: U2.18 (IO24); also elsewhere on the board
/MA8: U2.17 (IO25); also elsewhere on the board
/MA9: U2.16 (IO27); also elsewhere on the board
/MA10: U2.37 (IO56); also elsewhere on the board
/Match25: J3.1, R7.2, U1.16 (R6)
/Match26: J3.3, R6.2, U1.14 (R5)
/Match27: J3.5, R5.2, U1.12 (R4)
/Match28: J3.7, R4.2, U1.9 (R3)
/Match29: J3.9, R3.2, U1.7 (R2)
/Match30: J3.11, R2.2, U1.5 (R1)
/Match31: J3.13, R1.2, U1.3 (R0)
/~BEN: U2.58 (IO91); also elsewhere on the board
/~Bus-ACK: U2.69 (IO107); also elsewhere on the board
/~Bus-BE0: U2.63 (IO97); also elsewhere on the board
/~Bus-BE1: U2.61 (IO94); also elsewhere on the board
/~Bus-BE2: U2.65 (IO101); also elsewhere on the board
/~Bus-BE3: U2.64 (IO99); also elsewhere on the board
/~Bus-BERR: U2.73 (IO115); also elsewhere on the board
/~Bus-BRACK: U2.68 (IO105); also elsewhere on the board
/~Bus-BURST: U2.67 (IO104); also elsewhere on the board
/~Bus-Reset: U2.1 (GCLR); also elsewhere on the board
/~Bus-Start: U2.70 (IO109); also elsewhere on the board
/~CE: U1.19 (P=R), U2.57 (IO88)
/~MCAS0: U2.81 (IO128); also elsewhere on the board
/~MCAS1: U2.77 (IO123); also elsewhere on the board
/~MCAS2: U2.80 (IO126); also elsewhere on the board
/~MCAS3: U2.79 (IO125); also elsewhere on the board
/~MRAS0: U2.75 (IO118); also elsewhere on the board
/~MRAS1: U2.76 (IO120); also elsewhere on the board
/~MWE: U2.74 (IO117); also elsewhere on the board
GND: C1.2, R1.1, R2.1, R3.1, R4.1, R5.1, R6.1, R7.1, U1.1 (G), U1.10 (GND), U1.17 (P7), U1.18 (R7); also elsewhere on the board

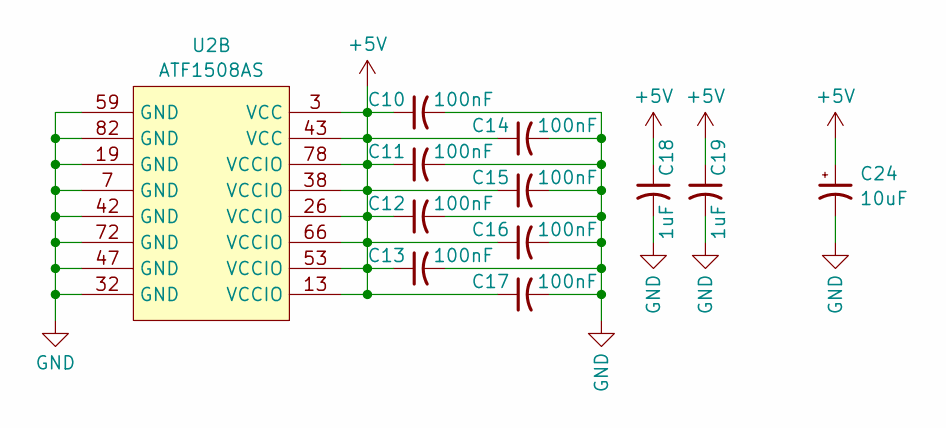
[picture p40: schematic power.kicad_sch]

Parts:
C10, C11, C12, C13, C14, C15, C16, C17: 100nF; C_0805_2012Metric; Mouser 187-CL21B104KACNNNC
C18, C19: 1uF; C_0805_2012Metric; Mouser 187-CL21B105KOFNNNG
C24: 10uF; CP_Elec_4x5.7; Mouser 80-EDK106M016A9BAA
U2: ATF1508AS; PLCC-84_THT-Socket

Connections:
+5V: C10.1, C11.1, C12.1, C13.1, C14.1, C15.1, C16.1, C17.1, C18.1, C19.1, C24.1, U2.3 (VCC), U2.13 (VCCIO), U2.26 (VCCIO), U2.38 (VCCIO), U2.43 (VCC), U2.53 (VCCIO), U2.66 (VCCIO), U2.78 (VCCIO); also elsewhere on the board
GND: C10.2, C11.2, C12.2, C13.2, C14.2, C15.2, C16.2, C17.2, C18.2, C19.2, C24.2, U2.7 (GND), U2.19 (GND), U2.32 (GND), U2.42 (GND), U2.47 (GND), U2.59 (GND), U2.72 (GND), U2.82 (GND); also elsewhere on the board

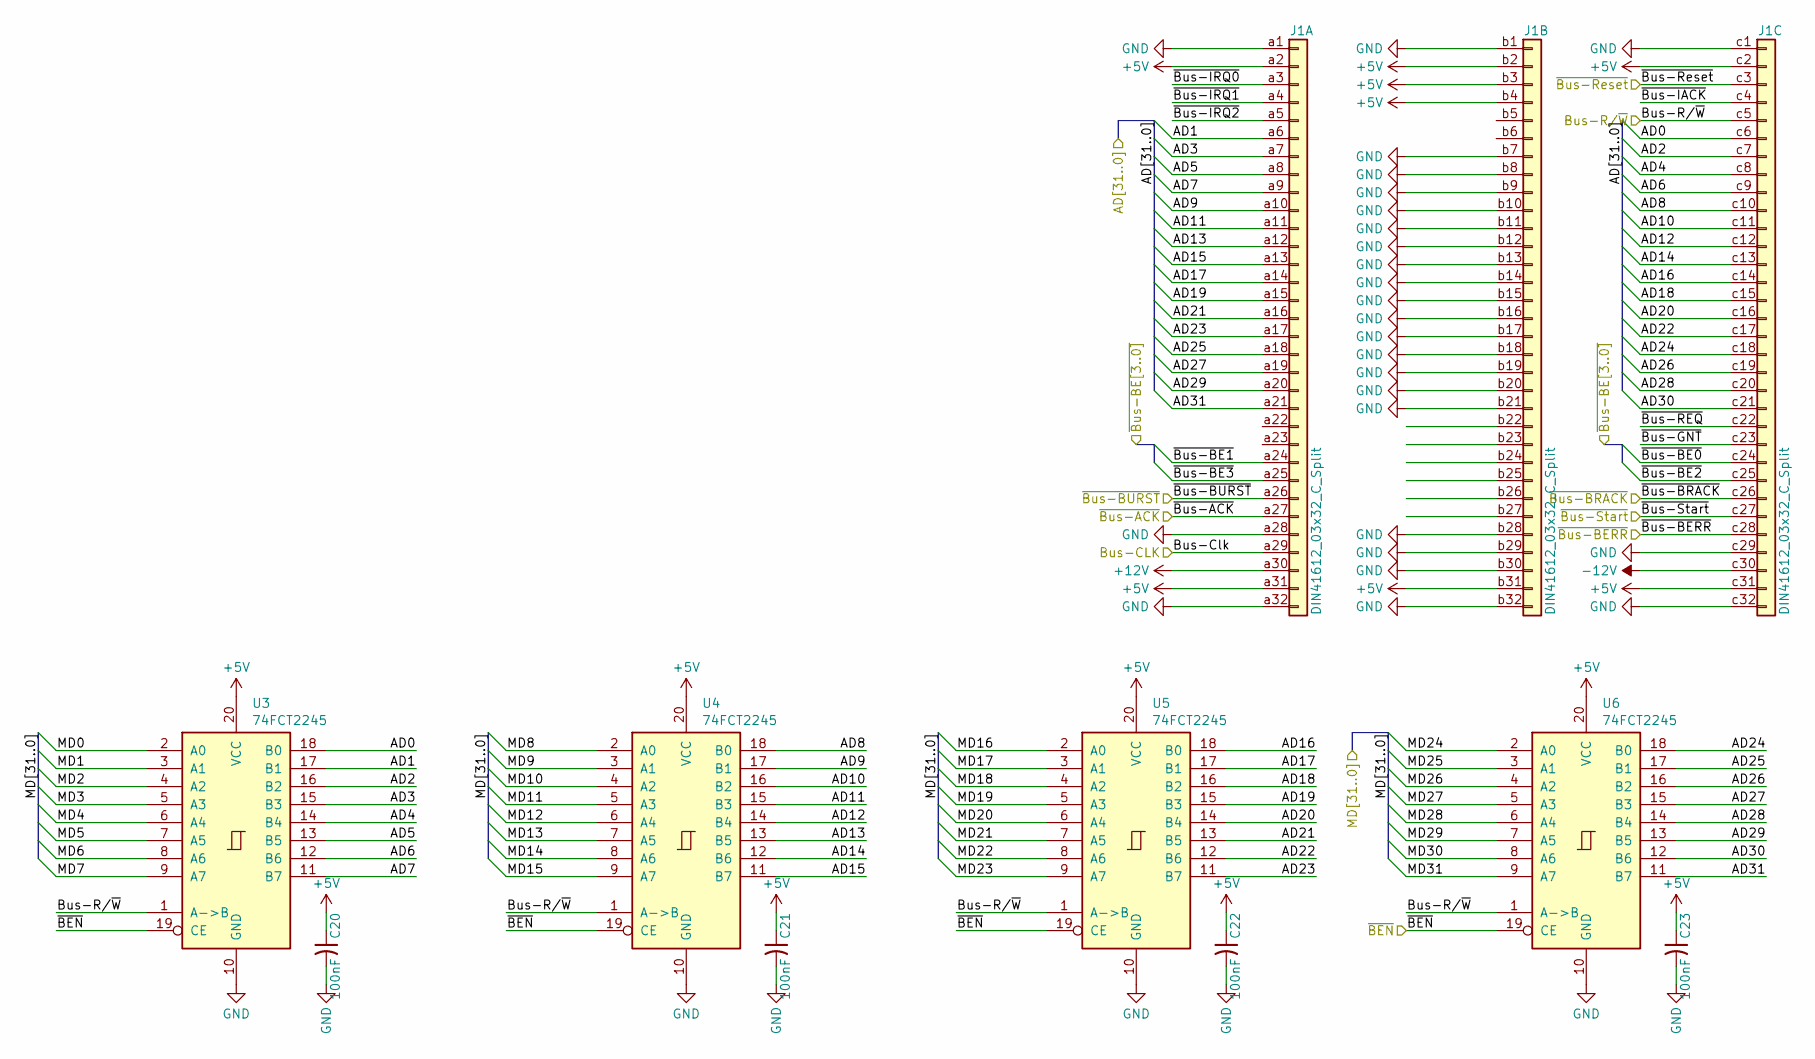
[picture p41: schematic main_bus.kicad_sch]

Parts:
C20, C21, C22, C23: 100nF; C_0805_2012Metric; Mouser 187-CL21B104KACNNNC
J1: DIN41612_03x32_C_Split; DIN41612_C_3x32_Male_Horizontal_THT
U3, U4, U5, U6: 74FCT2245; SOIC-20W_7.5x12.8mm_P1.27mm; Mouser 595-CY74FCT2245TSOCT

Connections:
+5V: C20.1, C21.1, C22.1, C23.1, J1.a2, J1.a31, J1.b2, J1.b3, J1.b4, J1.b31, J1.c2, J1.c31, U3.20 (VCC), U4.20 (VCC), U5.20 (VCC), U6.20 (VCC); also elsewhere on the board
+12V: J1.a30
-12V: J1.c30
/AD0: J1.c6, U3.18 (B0)
/AD1: J1.a6, U3.17 (B1)
/AD2: J1.c7, U3.16 (B2); also elsewhere on the board
/AD3: J1.a7, U3.15 (B3); also elsewhere on the board
/AD4: J1.c8, U3.14 (B4); also elsewhere on the board
/AD5: J1.a8, U3.13 (B5); also elsewhere on the board
/AD6: J1.c9, U3.12 (B6); also elsewhere on the board
/AD7: J1.a9, U3.11 (B7); also elsewhere on the board
/AD8: J1.c10, U4.18 (B0); also elsewhere on the board
/AD9: J1.a10, U4.17 (B1); also elsewhere on the board
/AD10: J1.c11, U4.16 (B2); also elsewhere on the board
/AD11: J1.a11, U4.15 (B3); also elsewhere on the board
/AD12: J1.c12, U4.14 (B4); also elsewhere on the board
/AD13: J1.a12, U4.13 (B5); also elsewhere on the board
/AD14: J1.c13, U4.12 (B6); also elsewhere on the board
/AD15: J1.a13, U4.11 (B7); also elsewhere on the board
/AD16: J1.c14, U5.18 (B0); also elsewhere on the board
/AD17: J1.a14, U5.17 (B1); also elsewhere on the board
/AD18: J1.c15, U5.16 (B2); also elsewhere on the board
/AD19: J1.a15, U5.15 (B3); also elsewhere on the board
/AD20: J1.c16, U5.14 (B4); also elsewhere on the board
/AD21: J1.a16, U5.13 (B5); also elsewhere on the board
/AD22: J1.c17, U5.12 (B6); also elsewhere on the board
/AD23: J1.a17, U5.11 (B7); also elsewhere on the board
/AD24: J1.c18, U6.18 (B0); also elsewhere on the board
/AD25: J1.a18, U6.17 (B1); also elsewhere on the board
/AD26: J1.c19, U6.16 (B2); also elsewhere on the board
/AD27: J1.a19, U6.15 (B3); also elsewhere on the board
/AD28: J1.c20, U6.14 (B4); also elsewhere on the board
/AD29: J1.a20, U6.13 (B5); also elsewhere on the board
/AD30: J1.c21, U6.12 (B6); also elsewhere on the board
/AD31: J1.a21, U6.11 (B7); also elsewhere on the board
/Bus-Clk: J1.a29; also elsewhere on the board
/Bus-R/~W: J1.c5, U3.1 (A->B), U4.1 (A->B), U5.1 (A->B), U6.1 (A->B); also elsewhere on the board
/MD0: U3.2 (A0); also elsewhere on the board
/MD1: U3.3 (A1); also elsewhere on the board
/MD2: U3.4 (A2); also elsewhere on the board
/MD3: U3.5 (A3); also elsewhere on the board
/MD4: U3.6 (A4); also elsewhere on the board
/MD5: U3.7 (A5); also elsewhere on the board
/MD6: U3.8 (A6); also elsewhere on the board
/MD7: U3.9 (A7); also elsewhere on the board
/MD8: U4.2 (A0); also elsewhere on the board
/MD9: U4.3 (A1); also elsewhere on the board
/MD10: U4.4 (A2); also elsewhere on the board
/MD11: U4.5 (A3); also elsewhere on the board
/MD12: U4.6 (A4); also elsewhere on the board
/MD13: U4.7 (A5); also elsewhere on the board
/MD14: U4.8 (A6); also elsewhere on the board
/MD15: U4.9 (A7); also elsewhere on the board
/MD16: U5.2 (A0); also elsewhere on the board
/MD17: U5.3 (A1); also elsewhere on the board
/MD18: U5.4 (A2); also elsewhere on the board
/MD19: U5.5 (A3); also elsewhere on the board
/MD20: U5.6 (A4); also elsewhere on the board
/MD21: U5.7 (A5); also elsewhere on the board
/MD22: U5.8 (A6); also elsewhere on the board
/MD23: U5.9 (A7); also elsewhere on the board
/MD24: U6.2 (A0); also elsewhere on the board
/MD25: U6.3 (A1); also elsewhere on the board
/MD26: U6.4 (A2); also elsewhere on the board
/MD27: U6.5 (A3); also elsewhere on the board
/MD28: U6.6 (A4); also elsewhere on the board
/MD29: U6.7 (A5); also elsewhere on the board
/MD30: U6.8 (A6); also elsewhere on the board
/MD31: U6.9 (A7); also elsewhere on the board
/Main Bus/~Bus-GNT: J1.c23
/Main Bus/~Bus-IACK: J1.c4
/Main Bus/~Bus-IRQ0: J1.a3
/Main Bus/~Bus-IRQ1: J1.a4
/Main Bus/~Bus-IRQ2: J1.a5
/Main Bus/~Bus-REQ: J1.c22
/~BEN: U3.19 (CE), U4.19 (CE), U5.19 (CE), U6.19 (CE); also elsewhere on the board
/~Bus-ACK: J1.a27; also elsewhere on the board
/~Bus-BE0: J1.c24; also elsewhere on the board
/~Bus-BE1: J1.a24; also elsewhere on the board
/~Bus-BE2: J1.c25; also elsewhere on the board
/~Bus-BE3: J1.a25; also elsewhere on the board
/~Bus-BERR: J1.c28; also elsewhere on the board
/~Bus-BRACK: J1.c26; also elsewhere on the board
/~Bus-BURST: J1.a26; also elsewhere on the board
/~Bus-Reset: J1.c3; also elsewhere on the board
/~Bus-Start: J1.c27; also elsewhere on the board
GND: C20.2, C21.2, C22.2, C23.2, J1.a1, J1.a28, J1.a32, J1.b1, J1.b7, J1.b8, J1.b9, J1.b10, J1.b11, J1.b12, J1.b13, J1.b14, J1.b15, J1.b16, J1.b17, J1.b18, J1.b19, J1.b20, J1.b21, J1.b28, J1.b29, J1.b30, J1.b32, J1.c1, J1.c29, J1.c32, U3.10 (GND), U4.10 (GND), U5.10 (GND), U6.10 (GND); also elsewhere on the board
