techav-homebrew/PikaPC/Hardware/PikaPC_SIMM72/PikaPC_SIMM72.kicad_pcb

## KiCad design Hardware/PikaPC_SIMM72/PikaPC_SIMM72.kicad_pcb (continued)

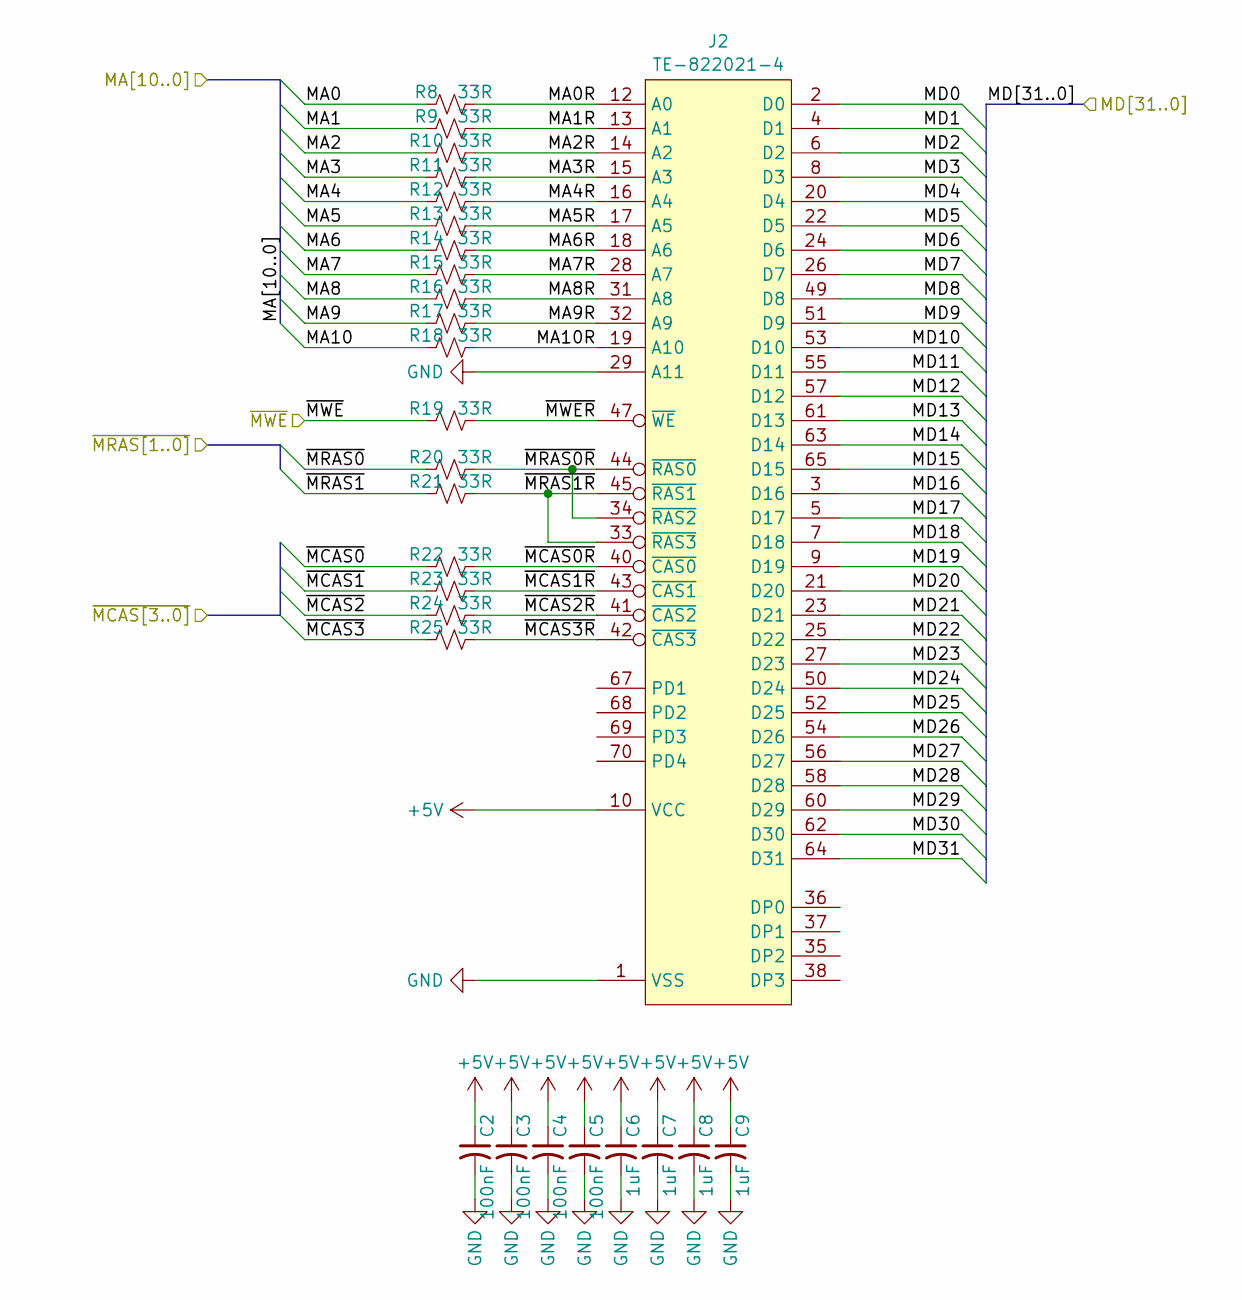
[picture p42: schematic simm_sockets.kicad_sch]

Parts:
C2, C3, C4, C5: 100nF; C_0805_2012Metric; Mouser 187-CL21B104KACNNNC
C6, C7, C8, C9: 1uF; C_0805_2012Metric; Mouser 187-CL21B105KOFNNNG
J2: TE-822021-4; SIMM72
R8, R9, R10, R11, R12, R13, R14, R15, R16, R17, R18, R19, R20, R21, R22, R23, R24, R25: 33R; R_0805_2012Metric; Mouser 603-RC0805JR-1033RL

Connections:
+5V: C2.1, C3.1, C4.1, C5.1, C6.1, C7.1, C8.1, C9.1, J2.10 (VCC), J2.30 (VCC), J2.59 (VCC); also elsewhere on the board
/MA0: R8.1; also elsewhere on the board
/MA1: R9.1; also elsewhere on the board
/MA2: R10.1; also elsewhere on the board
/MA3: R11.1; also elsewhere on the board
/MA4: R12.1; also elsewhere on the board
/MA5: R13.1; also elsewhere on the board
/MA6: R14.1; also elsewhere on the board
/MA7: R15.1; also elsewhere on the board
/MA8: R16.1; also elsewhere on the board
/MA9: R17.1; also elsewhere on the board
/MA10: R18.1; also elsewhere on the board
/MD0: J2.2 (D0); also elsewhere on the board
/MD1: J2.4 (D1); also elsewhere on the board
/MD2: J2.6 (D2); also elsewhere on the board
/MD3: J2.8 (D3); also elsewhere on the board
/MD4: J2.20 (D4); also elsewhere on the board
/MD5: J2.22 (D5); also elsewhere on the board
/MD6: J2.24 (D6); also elsewhere on the board
/MD7: J2.26 (D7); also elsewhere on the board
/MD8: J2.49 (D8); also elsewhere on the board
/MD9: J2.51 (D9); also elsewhere on the board
/MD10: J2.53 (D10); also elsewhere on the board
/MD11: J2.55 (D11); also elsewhere on the board
/MD12: J2.57 (D12); also elsewhere on the board
/MD13: J2.61 (D13); also elsewhere on the board
/MD14: J2.63 (D14); also elsewhere on the board
/MD15: J2.65 (D15); also elsewhere on the board
/MD16: J2.3 (D16); also elsewhere on the board
/MD17: J2.5 (D17); also elsewhere on the board
/MD18: J2.7 (D18); also elsewhere on the board
/MD19: J2.9 (D19); also elsewhere on the board
/MD20: J2.21 (D20); also elsewhere on the board
/MD21: J2.23 (D21); also elsewhere on the board
/MD22: J2.25 (D22); also elsewhere on the board
/MD23: J2.27 (D23); also elsewhere on the board
/MD24: J2.50 (D24); also elsewhere on the board
/MD25: J2.52 (D25); also elsewhere on the board
/MD26: J2.54 (D26); also elsewhere on the board
/MD27: J2.56 (D27); also elsewhere on the board
/MD28: J2.58 (D28); also elsewhere on the board
/MD29: J2.60 (D29); also elsewhere on the board
/MD30: J2.62 (D30); also elsewhere on the board
/MD31: J2.64 (D31); also elsewhere on the board
/SIMM Sockets/MA0R: J2.12 (A0), R8.2
/SIMM Sockets/MA1R: J2.13 (A1), R9.2
/SIMM Sockets/MA2R: J2.14 (A2), R10.2
/SIMM Sockets/MA3R: J2.15 (A3), R11.2
/SIMM Sockets/MA4R: J2.16 (A4), R12.2
/SIMM Sockets/MA5R: J2.17 (A5), R13.2
/SIMM Sockets/MA6R: J2.18 (A6), R14.2
/SIMM Sockets/MA7R: J2.28 (A7), R15.2
/SIMM Sockets/MA8R: J2.31 (A8), R16.2
/SIMM Sockets/MA9R: J2.32 (A9), R17.2
/SIMM Sockets/MA10R: J2.19 (A10), R18.2
/SIMM Sockets/~MCAS0R: J2.40 (~CAS0), R22.2
/SIMM Sockets/~MCAS1R: J2.43 (~CAS1), R23.2
/SIMM Sockets/~MCAS2R: J2.41 (~CAS2), R24.2
/SIMM Sockets/~MCAS3R: J2.42 (~CAS3), R25.2
/SIMM Sockets/~MRAS0R: J2.34 (~RAS2), J2.44 (~RAS0), R20.2
/SIMM Sockets/~MRAS1R: J2.33 (~RAS3), J2.45 (~RAS1), R21.2
/SIMM Sockets/~MWER: J2.47 (~WE), R19.2
/~MCAS0: R22.1; also elsewhere on the board
/~MCAS1: R23.1; also elsewhere on the board
/~MCAS2: R24.1; also elsewhere on the board
/~MCAS3: R25.1; also elsewhere on the board
/~MRAS0: R20.1; also elsewhere on the board
/~MRAS1: R21.1; also elsewhere on the board
/~MWE: R19.1; also elsewhere on the board
GND: C2.2, C3.2, C4.2, C5.2, C6.2, C7.2, C8.2, C9.2, J2.1 (VSS), J2.29 (A11), J2.39 (VSS), J2.72 (VSS); also elsewhere on the board

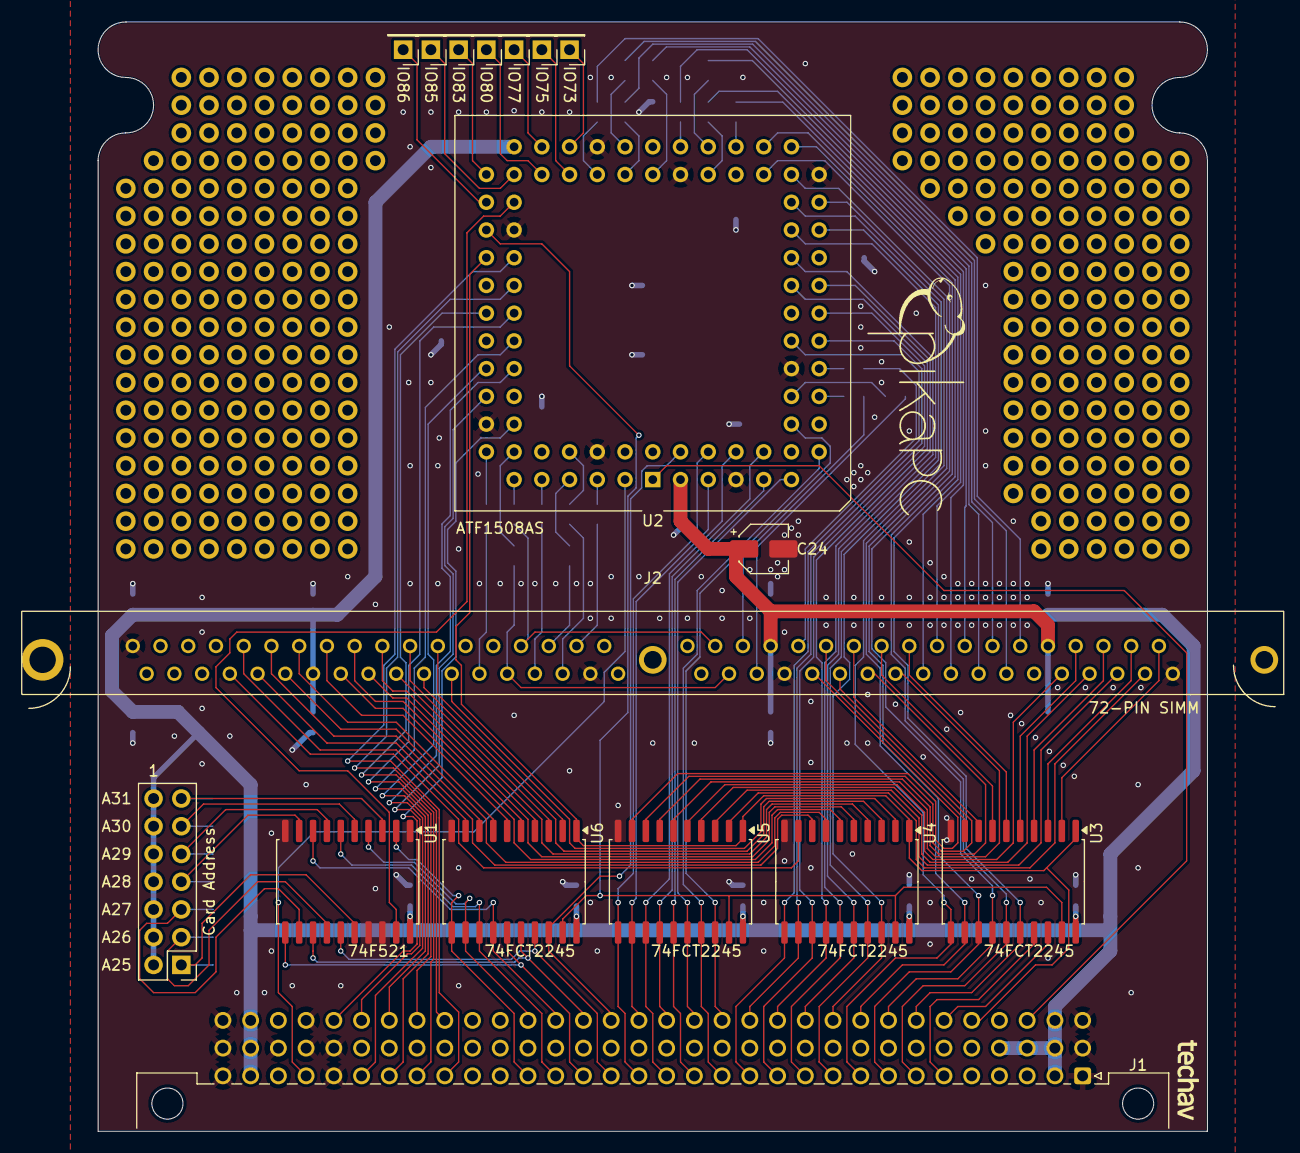
[picture p43: board PikaPC_SIMM72.kicad_pcb from above]

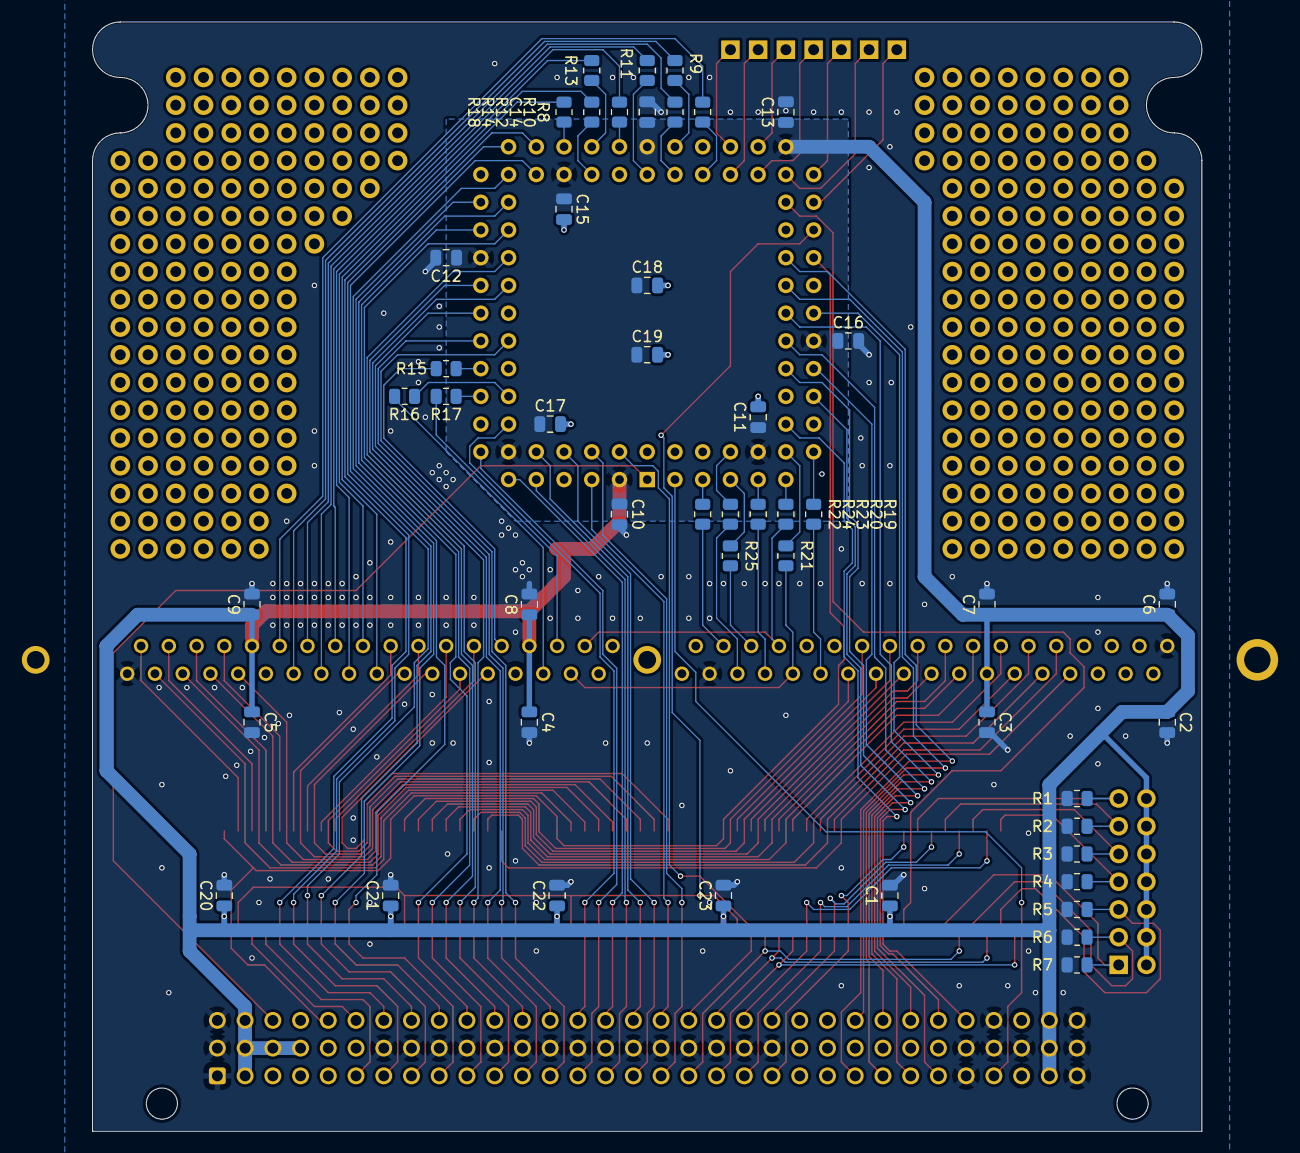
[picture p44: board PikaPC_SIMM72.kicad_pcb from below]

Board: 2 copper layers, 101.6 x 101.6 mm, 65 parts (48 on the bottom side), 130 nets.
