techav-homebrew/PikaPC/Mainboard/PikaPC_Mainboard.kicad_pcb

## KiCad design Mainboard/PikaPC_Mainboard.kicad_pcb (2026-05-26)

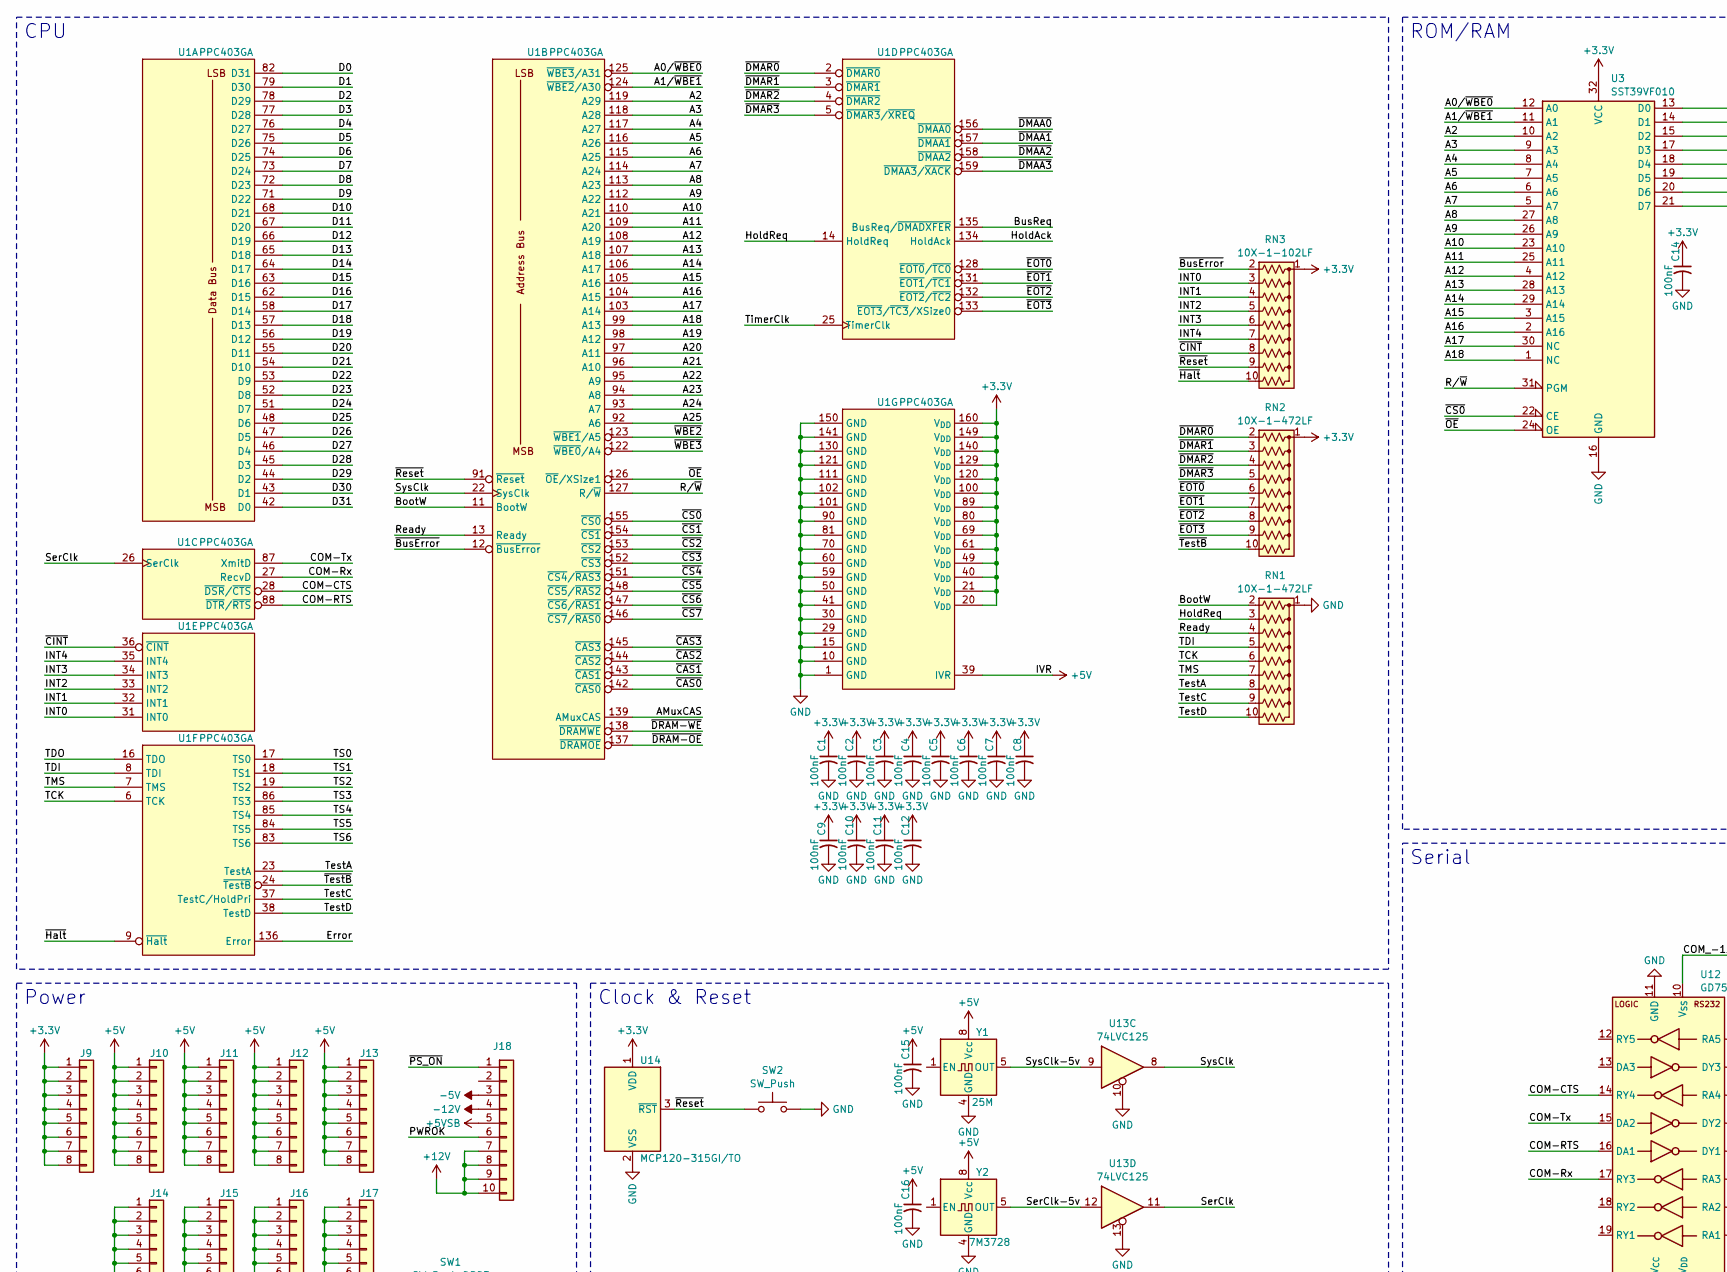
[picture p45: schematic PikaPC_Mainboard.kicad_sch, part in row 1, column 1]

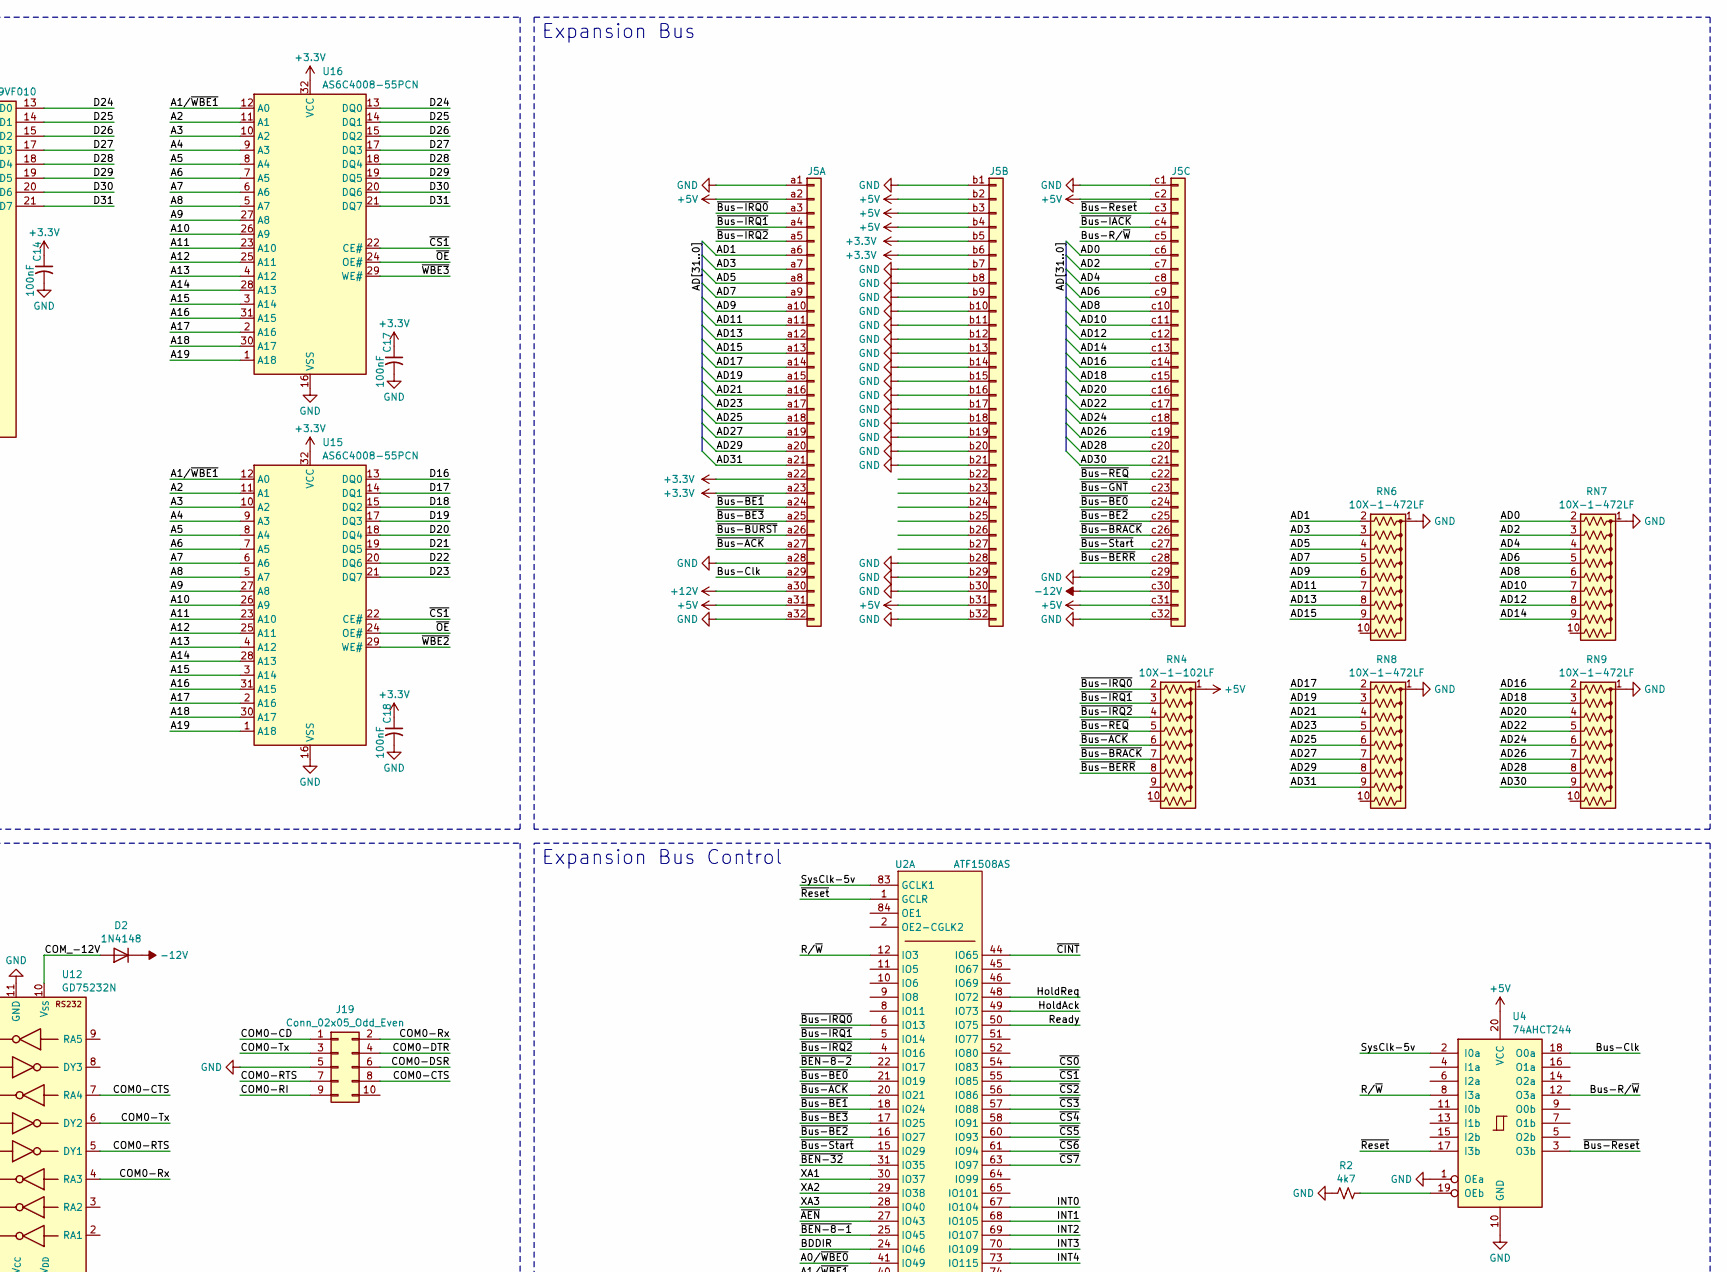
[picture p46: schematic PikaPC_Mainboard.kicad_sch, part in row 1, column 2]

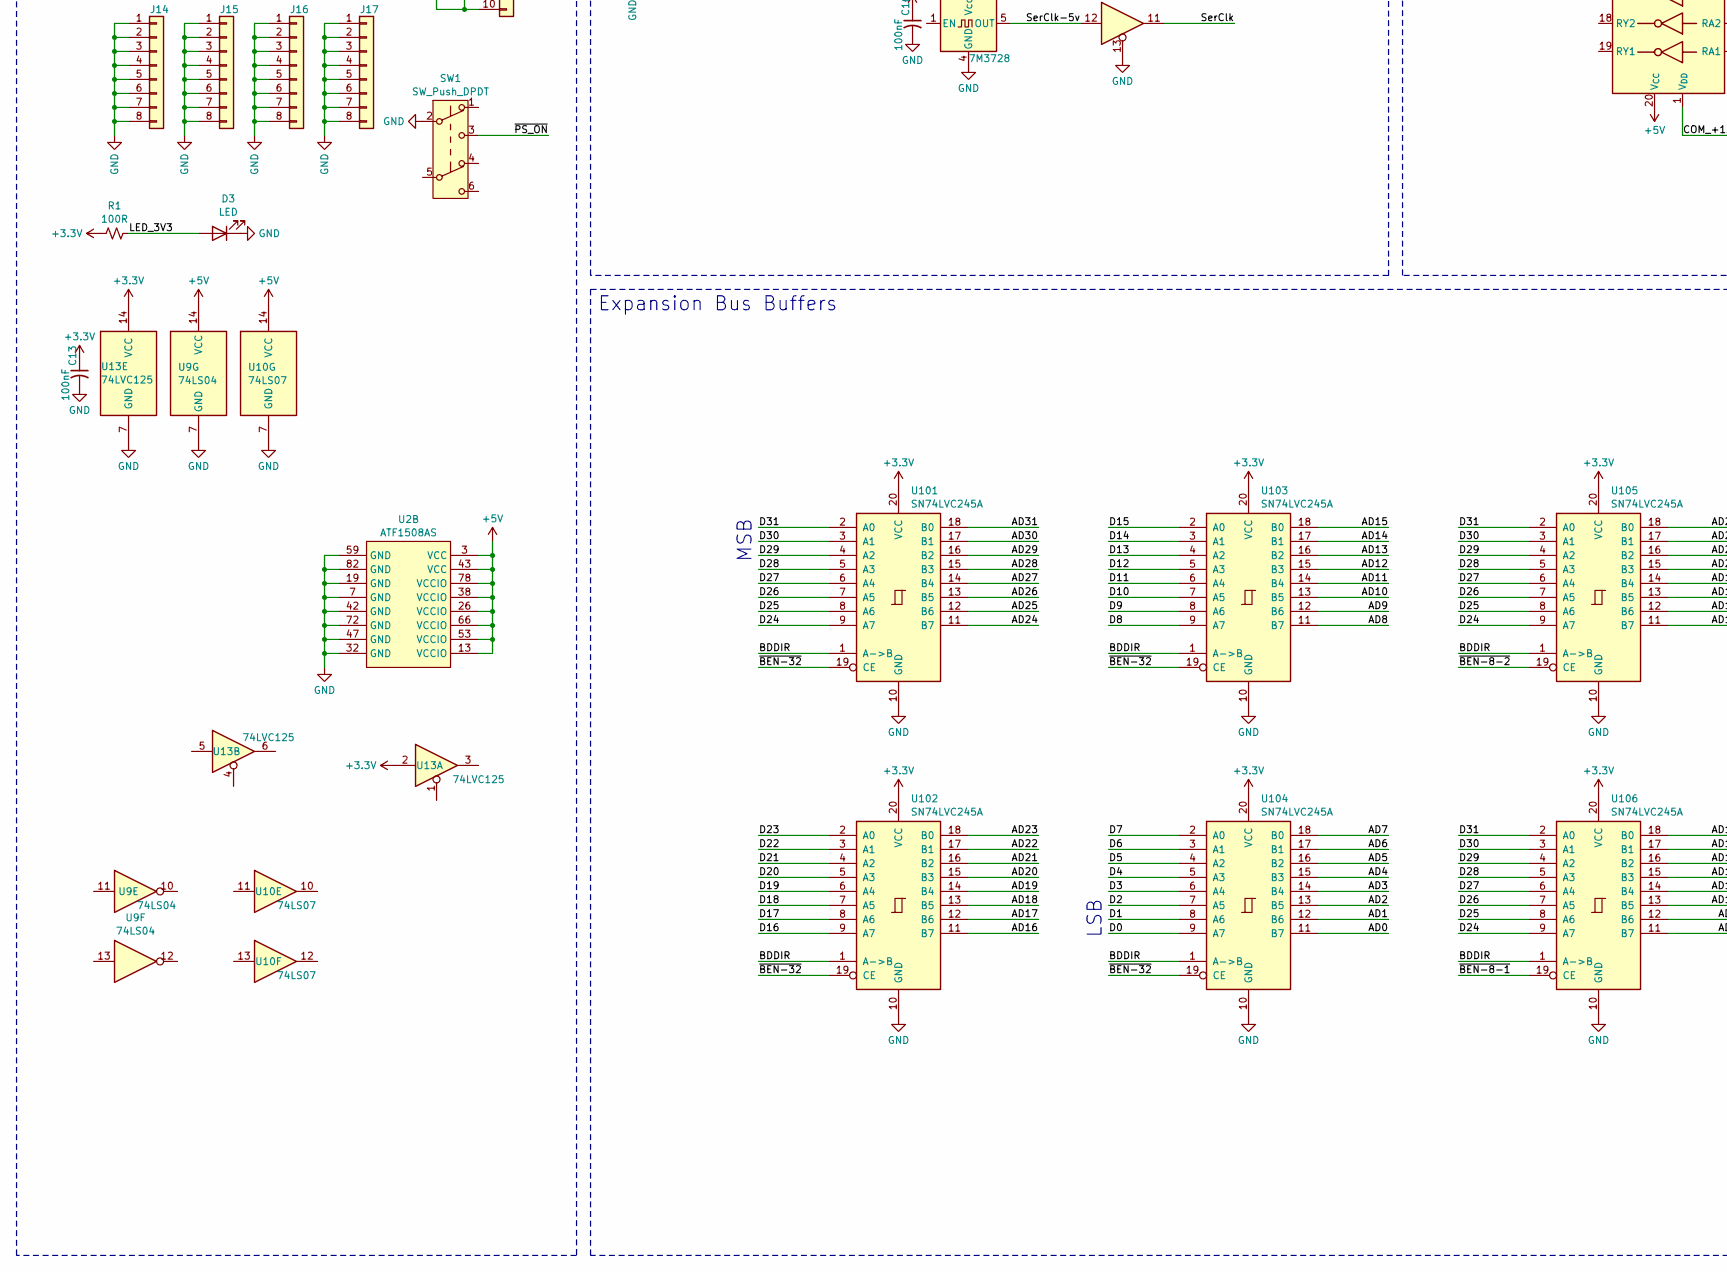
[picture p47: schematic PikaPC_Mainboard.kicad_sch, part in row 2, column 1]

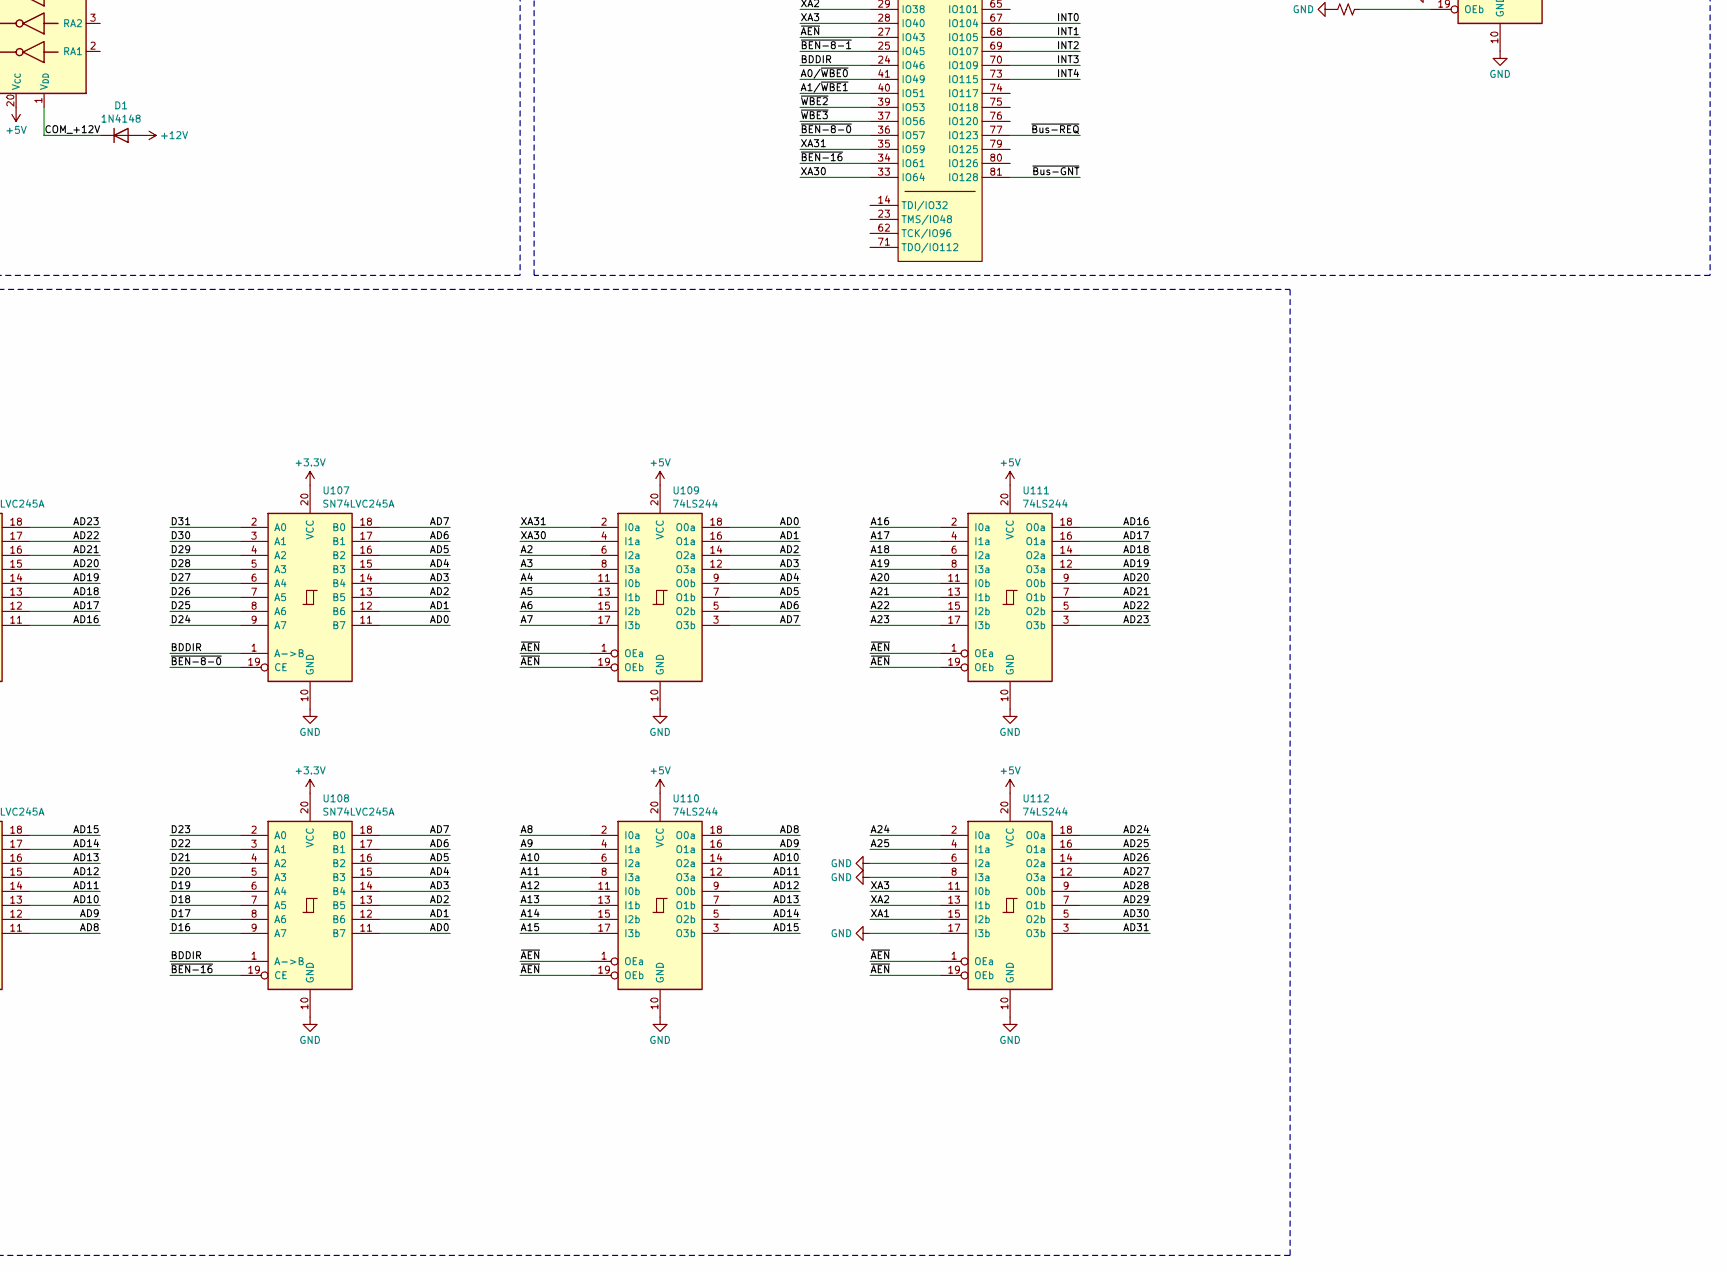
[picture p48: schematic PikaPC_Mainboard.kicad_sch, part in row 2, column 2]

Parts:
C1, C2, C3, C4, C5, C6, C7, C8: 100nF; C_0805_2012Metric
C9, C10, C11, C12, C13: 100nF; C_Disc_D7.5mm_W5.0mm_P7.50mm
C14, C15, C16, C17, C18: 100nF; C_Disc_D3.0mm_W2.0mm_P2.50mm
D1, D2: 1N4148; D_DO-35_SOD27_P7.62mm_Horizontal
D3: LED; LED_D5.0mm
J5: DIN41612_03x32_C_Split; DIN41612_C_3x32_Female_Vertical_THT
J9, J10, J11, J12, J13, J14, J15, J16, J17: Conn_01x08; PinHeader_1x08_P2.54mm_Vertical
J18: Conn_01x10; PinHeader_1x10_P2.54mm_Vertical
J19: Conn_02x05_Odd_Even; PinHeader_2x05_P2.54mm_Vertical
R1: 100R; R_Axial_DIN0204_L3.6mm_D1.6mm_P2.54mm_Vertical
R2: 4k7; R_Axial_DIN0204_L3.6mm_D1.6mm_P7.62mm_Horizontal
RN1, RN2, RN6, RN7, RN8, RN9: 10X-1-472LF; R_Array_SIP10
RN3, RN4: 10X-1-102LF; R_Array_SIP10
SW1: SW_Push_DPDT; SW_CK_JS202011CQN_DPDT_Straight
SW2: SW_Push; SW_PUSH_6mm_H7.3mm
U1: PPC403GA; PQFP-160_28x28mm_P0.65mm
U2: ATF1508AS; PLCC-84_THT-Socket
U3: SST39VF010; PLCC-32_THT-Socket
U4: 74AHCT244; DIP-20_W7.62mm_Socket
U9: 74LS04; DIP-14_W7.62mm_Socket
U10: 74LS07; DIP-14_W7.62mm_Socket
U12: GD75232N; DIP-20_W7.62mm
U13: 74LVC125; DIP-14_W7.62mm_Socket
U14: MCP120-315GI/TO; TO-92_Inline_Wide
U15, U16: AS6C4008-55PCN; DIP-32_W15.24mm
U101, U102, U103, U104, U105, U106, U107, U108: SN74LVC245A; DIP-20_W7.62mm_Socket
U109, U110, U111, U112: 74LS244; DIP-20_W7.62mm_Socket
Y1: 25M; Oscillator_DIP-8
Y2: 7M3728; Oscillator_DIP-8

Connections:
+3.3V: C1.1, C2.1, C3.1, C4.1, C5.1, C6.1, C7.1, C8.1, C9.1, C10.1, C11.1, C12.1, C13.1, C14.1, C17.1, C18.1, J5.a22, J5.a23, J5.b5, J5.b6, J9.1, J9.2, J9.3, J9.4, J9.5, J9.6, J9.7, J9.8, R1.1, RN2.1 (common), RN3.1 (common), U1.20 (V_{DD}), U1.21 (V_{DD}), U1.40 (V_{DD}), U1.49 (V_{DD}), U1.61 (V_{DD}), U1.69 (V_{DD}), U1.80 (V_{DD}), U1.89 (V_{DD}), U1.100 (V_{DD}), U1.120 (V_{DD}), U1.129 (V_{DD}), U1.140 (V_{DD}), U1.149 (V_{DD}), U1.160 (V_{DD}), U3.32 (VCC), U13.2, U13.14 (VCC), U14.1 (VDD), U15.32 (VCC), U16.32 (VCC), U101.20 (VCC), U102.20 (VCC), U103.20 (VCC), U104.20 (VCC), U105.20 (VCC), U106.20 (VCC), U107.20 (VCC), U108.20 (VCC)
+5V: C15.1, C16.1, J5.a2, J5.a31, J5.b2, J5.b3, J5.b4, J5.b31, J5.c2, J5.c31, J10.1, J10.2, J10.3, J10.4, J10.5, J10.6, J10.7, J10.8, J11.1, J11.2, J11.3, J11.4, J11.5, J11.6, J11.7, J11.8, J12.1, J12.2, J12.3, J12.4, J12.5, J12.6, J12.7, J12.8, J13.1, J13.2, J13.3, J13.4, J13.5, J13.6, J13.7, J13.8, RN4.1 (common), U1.39 (IVR), U2.3 (VCC), U2.13 (VCCIO), U2.26 (VCCIO), U2.38 (VCCIO), U2.43 (VCC), U2.53 (VCCIO), U2.66 (VCCIO), U2.78 (VCCIO), U4.20 (VCC), U9.14 (VCC), U10.14 (VCC), U12.20 (V_{CC}), U109.20 (VCC), U110.20 (VCC), U111.20 (VCC), U112.20 (VCC), Y1.8 (Vcc), Y2.8 (Vcc)
+5VSB: J18.5
+12V: D1.2 (A), J5.a30, J18.7, J18.8, J18.9, J18.10
-5V: J18.3
-12V: D2.1 (K), J5.c30, J18.4
/A0/~WBE0: U1.125 (~WBE3/A31), U2.41 (IO49), U3.12 (A0)
/A1/~WBE1: U1.124 (~WBE2/A30), U2.40 (IO51), U3.11 (A1), U15.12 (A0), U16.12 (A0)
/A2: U1.119 (A29), U3.10 (A2), U15.11 (A1), U16.11 (A1), U109.6 (I2a)
/A3: U1.118 (A28), U3.9 (A3), U15.10 (A2), U16.10 (A2), U109.8 (I3a)
/A4: U1.117 (A27), U3.8 (A4), U15.9 (A3), U16.9 (A3), U109.11 (I0b)
/A5: U1.116 (A26), U3.7 (A5), U15.8 (A4), U16.8 (A4), U109.13 (I1b)
/A6: U1.115 (A25), U3.6 (A6), U15.7 (A5), U16.7 (A5), U109.15 (I2b)
/A7: U1.114 (A24), U3.5 (A7), U15.6 (A6), U16.6 (A6), U109.17 (I3b)
/A8: U1.113 (A23), U3.27 (A8), U15.5 (A7), U16.5 (A7), U110.2 (I0a)
/A9: U1.112 (A22), U3.26 (A9), U15.27 (A8), U16.27 (A8), U110.4 (I1a)
/A10: U1.110 (A21), U3.23 (A10), U15.26 (A9), U16.26 (A9), U110.6 (I2a)
/A11: U1.109 (A20), U3.25 (A11), U15.23 (A10), U16.23 (A10), U110.8 (I3a)
/A12: U1.108 (A19), U3.4 (A12), U15.25 (A11), U16.25 (A11), U110.11 (I0b)
/A13: U1.107 (A18), U3.28 (A13), U15.4 (A12), U16.4 (A12), U110.13 (I1b)
/A14: U1.106 (A17), U3.29 (A14), U15.28 (A13), U16.28 (A13), U110.15 (I2b)
/A15: U1.105 (A16), U3.3 (A15), U15.3 (A14), U16.3 (A14), U110.17 (I3b)
/A16: U1.104 (A15), U3.2 (A16), U15.31 (A15), U16.31 (A15), U111.2 (I0a)
/A17: U1.103 (A14), U3.30 (NC), U15.2 (A16), U16.2 (A16), U111.4 (I1a)
/A18: U1.99 (A13), U3.1 (NC), U15.30 (A17), U16.30 (A17), U111.6 (I2a)
/A19: U1.98 (A12), U15.1 (A18), U16.1 (A18), U111.8 (I3a)
/A20: U1.97 (A11), U111.11 (I0b)
/A21: U1.96 (A10), U111.13 (I1b)
/A22: U1.95 (A9), U111.15 (I2b)
/A23: U1.94 (A8), U111.17 (I3b)
/A24: U1.93 (A7), U112.2 (I0a)
/A25: U1.92 (A6), U112.4 (I1a)
/AD0: J5.c6, RN7.2 (R1), U104.11 (B7), U107.11 (B7), U108.11 (B7), U109.18 (O0a)
/AD1: J5.a6, RN6.2 (R1), U104.12 (B6), U107.12 (B6), U108.12 (B6), U109.16 (O1a)
/AD2: J5.c7, RN7.3 (R2), U104.13 (B5), U107.13 (B5), U108.13 (B5), U109.14 (O2a)
/AD3: J5.a7, RN6.3 (R2), U104.14 (B4), U107.14 (B4), U108.14 (B4), U109.12 (O3a)
/AD4: J5.c8, RN7.4 (R3), U104.15 (B3), U107.15 (B3), U108.15 (B3), U109.9 (O0b)
/AD5: J5.a8, RN6.4 (R3), U104.16 (B2), U107.16 (B2), U108.16 (B2), U109.7 (O1b)
/AD6: J5.c9, RN7.5 (R4), U104.17 (B1), U107.17 (B1), U108.17 (B1), U109.5 (O2b)
/AD7: J5.a9, RN6.5 (R4), U104.18 (B0), U107.18 (B0), U108.18 (B0), U109.3 (O3b)
/AD8: J5.c10, RN7.6 (R5), U103.11 (B7), U106.11 (B7), U110.18 (O0a)
/AD9: J5.a10, RN6.6 (R5), U103.12 (B6), U106.12 (B6), U110.16 (O1a)
/AD10: J5.c11, RN7.7 (R6), U103.13 (B5), U106.13 (B5), U110.14 (O2a)
/AD11: J5.a11, RN6.7 (R6), U103.14 (B4), U106.14 (B4), U110.12 (O3a)
/AD12: J5.c12, RN7.8 (R7), U103.15 (B3), U106.15 (B3), U110.9 (O0b)
/AD13: J5.a12, RN6.8 (R7), U103.16 (B2), U106.16 (B2), U110.7 (O1b)
/AD14: J5.c13, RN7.9 (R8), U103.17 (B1), U106.17 (B1), U110.5 (O2b)
/AD15: J5.a13, RN6.9 (R8), U103.18 (B0), U106.18 (B0), U110.3 (O3b)
/AD16: J5.c14, RN9.2 (R1), U102.11 (B7), U105.11 (B7), U111.18 (O0a)
/AD17: J5.a14, RN8.2 (R1), U102.12 (B6), U105.12 (B6), U111.16 (O1a)
/AD18: J5.c15, RN9.3 (R2), U102.13 (B5), U105.13 (B5), U111.14 (O2a)
/AD19: J5.a15, RN8.3 (R2), U102.14 (B4), U105.14 (B4), U111.12 (O3a)
/AD20: J5.c16, RN9.4 (R3), U102.15 (B3), U105.15 (B3), U111.9 (O0b)
/AD21: J5.a16, RN8.4 (R3), U102.16 (B2), U105.16 (B2), U111.7 (O1b)
/AD22: J5.c17, RN9.5 (R4), U102.17 (B1), U105.17 (B1), U111.5 (O2b)
/AD23: J5.a17, RN8.5 (R4), U102.18 (B0), U105.18 (B0), U111.3 (O3b)
/AD24: J5.c18, RN9.6 (R5), U101.11 (B7), U112.18 (O0a)
/AD25: J5.a18, RN8.6 (R5), U101.12 (B6), U112.16 (O1a)
/AD26: J5.c19, RN9.7 (R6), U101.13 (B5), U112.14 (O2a)
/AD27: J5.a19, RN8.7 (R6), U101.14 (B4), U112.12 (O3a)
/AD28: J5.c20, RN9.8 (R7), U101.15 (B3), U112.9 (O0b)
/AD29: J5.a20, RN8.8 (R7), U101.16 (B2), U112.7 (O1b)
/AD30: J5.c21, RN9.9 (R8), U101.17 (B1), U112.5 (O2b)
/AD31: J5.a21, RN8.9 (R8), U101.18 (B0), U112.3 (O3b)
/AMuxCAS: U1.139 (AMuxCAS)
/BDDIR: U2.24 (IO46), U101.1 (A->B), U102.1 (A->B), U103.1 (A->B), U104.1 (A->B), U105.1 (A->B), U106.1 (A->B), U107.1 (A->B), U108.1 (A->B)
/BootW: RN1.2 (R1), U1.11 (BootW)
/Bus-Clk: J5.a29, U4.18 (O0a)
/Bus-R/~W: J5.c5, U4.12 (O3a)
/BusReq: U1.135 (BusReq/~DMADXFER)
/COM0-CD: J19.1
/COM0-CTS: J19.8, U12.7 (RA4)
/COM0-DSR: J19.6
/COM0-DTR: J19.4
/COM0-RI: J19.9
/COM0-RTS: J19.7, U12.5 (DY1)
/COM0-Rx: J19.2, U12.4 (RA3)
/COM0-Tx: J19.3, U12.6 (DY2)
/COM-CTS: U1.28 (~DSR/~CTS), U12.14 (RY4)
/COM-RTS: U1.88 (~DTR/~RTS), U12.16 (DA1)
/COM-Rx: U1.27 (RecvD), U12.17 (RY3)
/COM-Tx: U1.87 (XmitD), U12.15 (DA2)
/COM_+12V: D1.1 (K), U12.1 (V_{DD})
/COM_-12V: D2.2 (A), U12.10 (V_{SS})
/D0: U1.82 (D31), U104.9 (A7)
/D1: U1.79 (D30), U104.8 (A6)
/D2: U1.78 (D29), U104.7 (A5)
/D3: U1.77 (D28), U104.6 (A4)
/D4: U1.76 (D27), U104.5 (A3)
/D5: U1.75 (D26), U104.4 (A2)
/D6: U1.74 (D25), U104.3 (A1)
/D7: U1.73 (D24), U104.2 (A0)
/D8: U1.72 (D23), U103.9 (A7)
/D9: U1.71 (D22), U103.8 (A6)
/D10: U1.68 (D21), U103.7 (A5)
/D11: U1.67 (D20), U103.6 (A4)
/D12: U1.66 (D19), U103.5 (A3)
/D13: U1.65 (D18), U103.4 (A2)
/D14: U1.64 (D17), U103.3 (A1)
/D15: U1.63 (D16), U103.2 (A0)
/D16: U1.62 (D15), U15.13 (DQ0), U102.9 (A7), U108.9 (A7)
/D17: U1.58 (D14), U15.14 (DQ1), U102.8 (A6), U108.8 (A6)
/D18: U1.57 (D13), U15.15 (DQ2), U102.7 (A5), U108.7 (A5)
/D19: U1.56 (D12), U15.17 (DQ3), U102.6 (A4), U108.6 (A4)
/D20: U1.55 (D11), U15.18 (DQ4), U102.5 (A3), U108.5 (A3)
/D21: U1.54 (D10), U15.19 (DQ5), U102.4 (A2), U108.4 (A2)
/D22: U1.53 (D9), U15.20 (DQ6), U102.3 (A1), U108.3 (A1)
/D23: U1.52 (D8), U15.21 (DQ7), U102.2 (A0), U108.2 (A0)
/D24: U1.51 (D7), U3.13 (D0), U16.13 (DQ0), U101.9 (A7), U105.9 (A7), U106.9 (A7), U107.9 (A7)
/D25: U1.48 (D6), U3.14 (D1), U16.14 (DQ1), U101.8 (A6), U105.8 (A6), U106.8 (A6), U107.8 (A6)
/D26: U1.47 (D5), U3.15 (D2), U16.15 (DQ2), U101.7 (A5), U105.7 (A5), U106.7 (A5), U107.7 (A5)
/D27: U1.46 (D4), U3.17 (D3), U16.17 (DQ3), U101.6 (A4), U105.6 (A4), U106.6 (A4), U107.6 (A4)
/D28: U1.45 (D3), U3.18 (D4), U16.18 (DQ4), U101.5 (A3), U105.5 (A3), U106.5 (A3), U107.5 (A3)
/D29: U1.44 (D2), U3.19 (D5), U16.19 (DQ5), U101.4 (A2), U105.4 (A2), U106.4 (A2), U107.4 (A2)
/D30: U1.43 (D1), U3.20 (D6), U16.20 (DQ6), U101.3 (A1), U105.3 (A1), U106.3 (A1), U107.3 (A1)
/D31: U1.42 (D0), U3.21 (D7), U16.21 (DQ7), U101.2 (A0), U105.2 (A0), U106.2 (A0), U107.2 (A0)
/Error: U1.136 (Error)
/HoldAck: U1.134 (HoldAck), U2.49 (IO73)
/HoldReq: RN1.3 (R2), U1.14 (HoldReq), U2.48 (IO72)
/INT0: RN3.3 (R2), U1.31 (INT0), U2.67 (IO104); also elsewhere on the board
/INT1: RN3.4 (R3), U1.32 (INT1), U2.68 (IO105); also elsewhere on the board
/INT2: RN3.5 (R4), U1.33 (INT2), U2.69 (IO107); also elsewhere on the board
/INT3: RN3.6 (R5), U1.34 (INT3), U2.70 (IO109)
/INT4: RN3.7 (R6), U1.35 (INT4), U2.73 (IO115)
/LED_3V3: D3.2 (A), R1.2
/PWROK: J18.6
/Ready: RN1.4 (R3), U1.13 (Ready), U2.50 (IO75)
/R/~W: U1.127 (R/~W), U2.12 (IO3), U3.31 (PGM), U4.8 (I3a)
/SerClk: U1.26 (SerClk), U13.11
/SerClk-5v: U13.12, Y2.5 (OUT)
/SysClk: U1.22 (SysClk), U13.8
/SysClk-5v: U2.83 (GCLK1), U4.2 (I0a), U13.9, Y1.5 (OUT)
/TCK: RN1.6 (R5), U1.6 (TCK)
/TDI: RN1.5 (R4), U1.8 (TDI)
/TDO: U1.16 (TDO)
/TMS: RN1.7 (R6), U1.7 (TMS)
/TS0: U1.17 (TS0)
/TS1: U1.18 (TS1)
/TS2: U1.19 (TS2)
/TS3: U1.86 (TS3)
/TS4: U1.85 (TS4)
/TS5: U1.84 (TS5)
/TS6: U1.83 (TS6)
/TestA: RN1.8 (R7), U1.23 (TestA)
/TestC: RN1.9 (R8), U1.37 (TestC/HoldPri)
/TestD: RN1.10 (R9), U1.38 (TestD)
/TimerClk: U1.25 (TimerClk)
/XA1: U2.30 (IO37), U112.15 (I2b)
/XA2: U2.29 (IO38), U112.13 (I1b)
/XA3: U2.28 (IO40), U112.11 (I0b)
/XA30: U2.33 (IO64), U109.4 (I1a)
/XA31: U2.35 (IO59), U109.2 (I0a)
/~AEN: U2.27 (IO43), U109.1 (OEa), U109.19 (OEb), U110.1 (OEa), U110.19 (OEb), U111.1 (OEa), U111.19 (OEb), U112.1 (OEa), U112.19 (OEb)
/~BEN-8-0: U2.36 (IO57), U107.19 (CE)
/~BEN-8-1: U2.25 (IO45), U106.19 (CE)
/~BEN-8-2: U2.22 (IO17), U105.19 (CE)
/~BEN-16: U2.34 (IO61), U108.19 (CE)
/~BEN-32: U2.31 (IO35), U101.19 (CE), U102.19 (CE), U103.19 (CE), U104.19 (CE)
/~Bus-ACK: J5.a27, RN4.6 (R5), U2.20 (IO21)
/~Bus-BE0: J5.c24, U2.21 (IO19)
/~Bus-BE1: J5.a24, U2.18 (IO24)
/~Bus-BE2: J5.c25, U2.16 (IO27)
/~Bus-BE3: J5.a25, U2.17 (IO25)
/~Bus-BERR: J5.c28, RN4.8 (R7)
/~Bus-BRACK: J5.c26, RN4.7 (R6)
/~Bus-BURST: J5.a26
/~Bus-GNT: J5.c23, U2.81 (IO128)
/~Bus-IACK: J5.c4
/~Bus-IRQ0: J5.a3, RN4.2 (R1), U2.6 (IO13)
/~Bus-IRQ1: J5.a4, RN4.3 (R2), U2.5 (IO14)
/~Bus-IRQ2: J5.a5, RN4.4 (R3), U2.4 (IO16)
/~Bus-REQ: J5.c22, RN4.5 (R4), U2.77 (IO123)
/~Bus-Reset: J5.c3, U4.3 (O3b)
/~Bus-Start: J5.c27, U2.15 (IO29)
/~BusError: RN3.2 (R1), U1.12 (~BusError)
/~CAS0: U1.142 (~CAS0)
/~CAS1: U1.143 (~CAS1)
/~CAS2: U1.144 (~CAS2)
/~CAS3: U1.145 (~CAS3)
/~CINT: RN3.8 (R7), U1.36 (~CINT), U2.44 (IO65)
/~CS0: U1.155 (~CS0), U2.54 (IO83), U3.22 (CE)
/~CS1: U1.154 (~CS1), U2.55 (IO85), U15.22 (CE#), U16.22 (CE#)
/~CS2: U1.153 (~CS2), U2.56 (IO86)
/~CS3: U1.152 (~CS3), U2.57 (IO88)
/~CS4: U1.151 (~CS4/~RAS3), U2.58 (IO91)
/~CS5: U1.148 (~CS5/~RAS2), U2.60 (IO93)
/~CS6: U1.147 (~CS6/~RAS1), U2.61 (IO94)
/~CS7: U1.146 (~CS7/~RAS0), U2.63 (IO97)
/~DMAA0: U1.156 (~DMAA0)
/~DMAA1: U1.157 (~DMAA1)
/~DMAA2: U1.158 (~DMAA2)
/~DMAA3: U1.159 (~DMAA3/~XACK)
/~DMAR0: RN2.2 (R1), U1.2 (~DMAR0)
/~DMAR1: RN2.3 (R2), U1.3 (~DMAR1)
/~DMAR2: RN2.4 (R3), U1.4 (~DMAR2)
/~DMAR3: RN2.5 (R4), U1.5 (~DMAR3/~XREQ)
/~DRAM-OE: U1.137 (~DRAMOE)
/~DRAM-WE: U1.138 (~DRAMWE)
/~EOT0: RN2.6 (R5), U1.128 (~EOT0/~TC0)
/~EOT1: RN2.7 (R6), U1.131 (~EOT1/~TC1)
/~EOT2: RN2.8 (R7), U1.132 (~EOT2/~TC2)
/~EOT3: RN2.9 (R8), U1.133 (~EOT3/~TC3/XSize0)
/~Halt: RN3.10 (R9), U1.9 (~Halt)
/~OE: U1.126 (~OE/XSize1), U3.24 (OE), U15.24 (OE#), U16.24 (OE#)
/~PS_ON: J18.1, SW1.3 (C)
/~Reset: RN3.9 (R8), SW2.2, U1.91 (~Reset), U2.1 (GCLR), U4.17 (I3b), U14.3 (~RST)
/~TestB: RN2.10 (R9), U1.24 (~TestB)
/~WBE2: U1.123 (~WBE1/A5), U2.39 (IO53), U15.29 (WE#)
/~WBE3: U1.122 (~WBE0/A4), U2.37 (IO56), U16.29 (WE#)
GND: C1.2, C2.2, C3.2, C4.2, C5.2, C6.2, C7.2, C8.2, C9.2, C10.2, C11.2, C12.2, C13.2, C14.2, C15.2, C16.2, C17.2, C18.2, D3.1 (K), J5.a1, J5.a28, J5.a32, J5.b1, J5.b7, J5.b8, J5.b9, J5.b10, J5.b11, J5.b12, J5.b13, J5.b14, J5.b15, J5.b16, J5.b17, J5.b18, J5.b19, J5.b20, J5.b21, J5.b28, J5.b29, J5.b30, J5.b32, J5.c1, J5.c29, J5.c32, J14.1, J14.2, J14.3, J14.4, J14.5, J14.6, J14.7, J14.8, J15.1, J15.2, J15.3, J15.4, J15.5, J15.6, J15.7, J15.8, J16.1, J16.2, J16.3, J16.4, J16.5, J16.6, J16.7, J16.8, J17.1, J17.2, J17.3, J17.4, J17.5, J17.6, J17.7, J17.8, J19.5, R2.1, RN1.1 (common), RN6.1 (common), RN7.1 (common), RN8.1 (common), RN9.1 (common), SW1.2 (B), SW2.1, U1.1 (GND), U1.10 (GND), U1.15 (GND), U1.29 (GND), U1.30 (GND), U1.41 (GND), U1.50 (GND), U1.59 (GND), U1.60 (GND), U1.70 (GND), U1.81 (GND), U1.90 (GND), U1.101 (GND), U1.102 (GND), U1.111 (GND), U1.121 (GND), U1.130 (GND), U1.141 (GND), U1.150 (GND), U2.7 (GND), U2.19 (GND), U2.32 (GND), U2.42 (GND), U2.47 (GND), U2.59 (GND), U2.72 (GND), U2.82 (GND), U3.16 (GND), U4.1 (OEa), U4.10 (GND), U9.7 (GND), U10.7 (GND), U12.11 (GND), U13.7 (GND), U13.10, U13.13, U14.2 (VSS), U15.16 (VSS), U16.16 (VSS), U101.10 (GND), U102.10 (GND), U103.10 (GND), U104.10 (GND), U105.10 (GND), U106.10 (GND), U107.10 (GND), U108.10 (GND), U109.10 (GND), U110.10 (GND), U111.10 (GND), U112.6 (I2a), U112.8 (I3a), U112.10 (GND), U112.17 (I3b), Y1.4 (GND), Y2.4 (GND); also elsewhere on the board
unnamed: R2.2, U4.19 (OEb)

Notes on the sheet:
Power
Expansion Bus Control
LSB
CPU
ROM/RAM
Serial
Expansion Bus
MSB
Clock & Reset
Expansion Bus Buffers

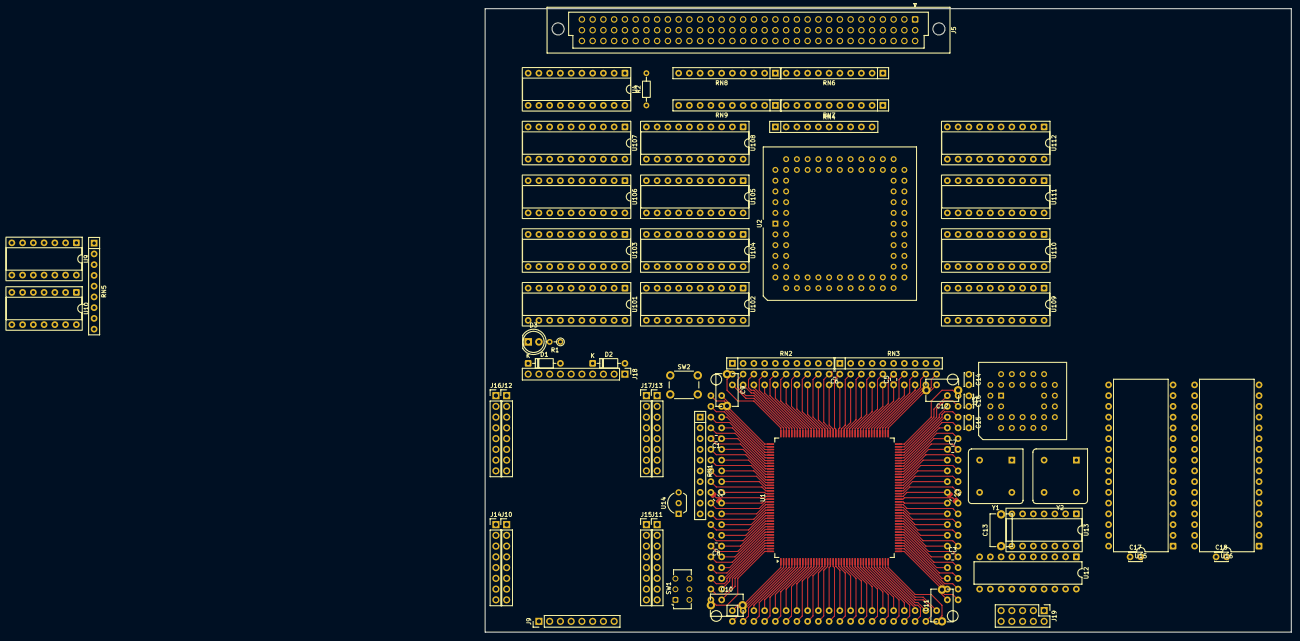
[picture p49: board PikaPC_Mainboard.kicad_pcb from above]

Board: 2 copper layers, 190.5 x 147.3 mm, 71 parts (0 on the bottom side), 180 nets.

Other parts of the board:
RN5: 9A103J; R_Array_SIP9

Their connections:
/INT0: RN5.7 (R6); also elsewhere on the board
/INT1: RN5.8 (R7); also elsewhere on the board
/INT2: RN5.9 (R8); also elsewhere on the board
GND: RN5.1 (common); also elsewhere on the board
