techav-homebrew/PikaPC/Hardware/PikaPC_KBC/PikaPC_KBC.kicad_pcb

## KiCad design Hardware/PikaPC_KBC/PikaPC_KBC.kicad_pcb (2026-05-26)

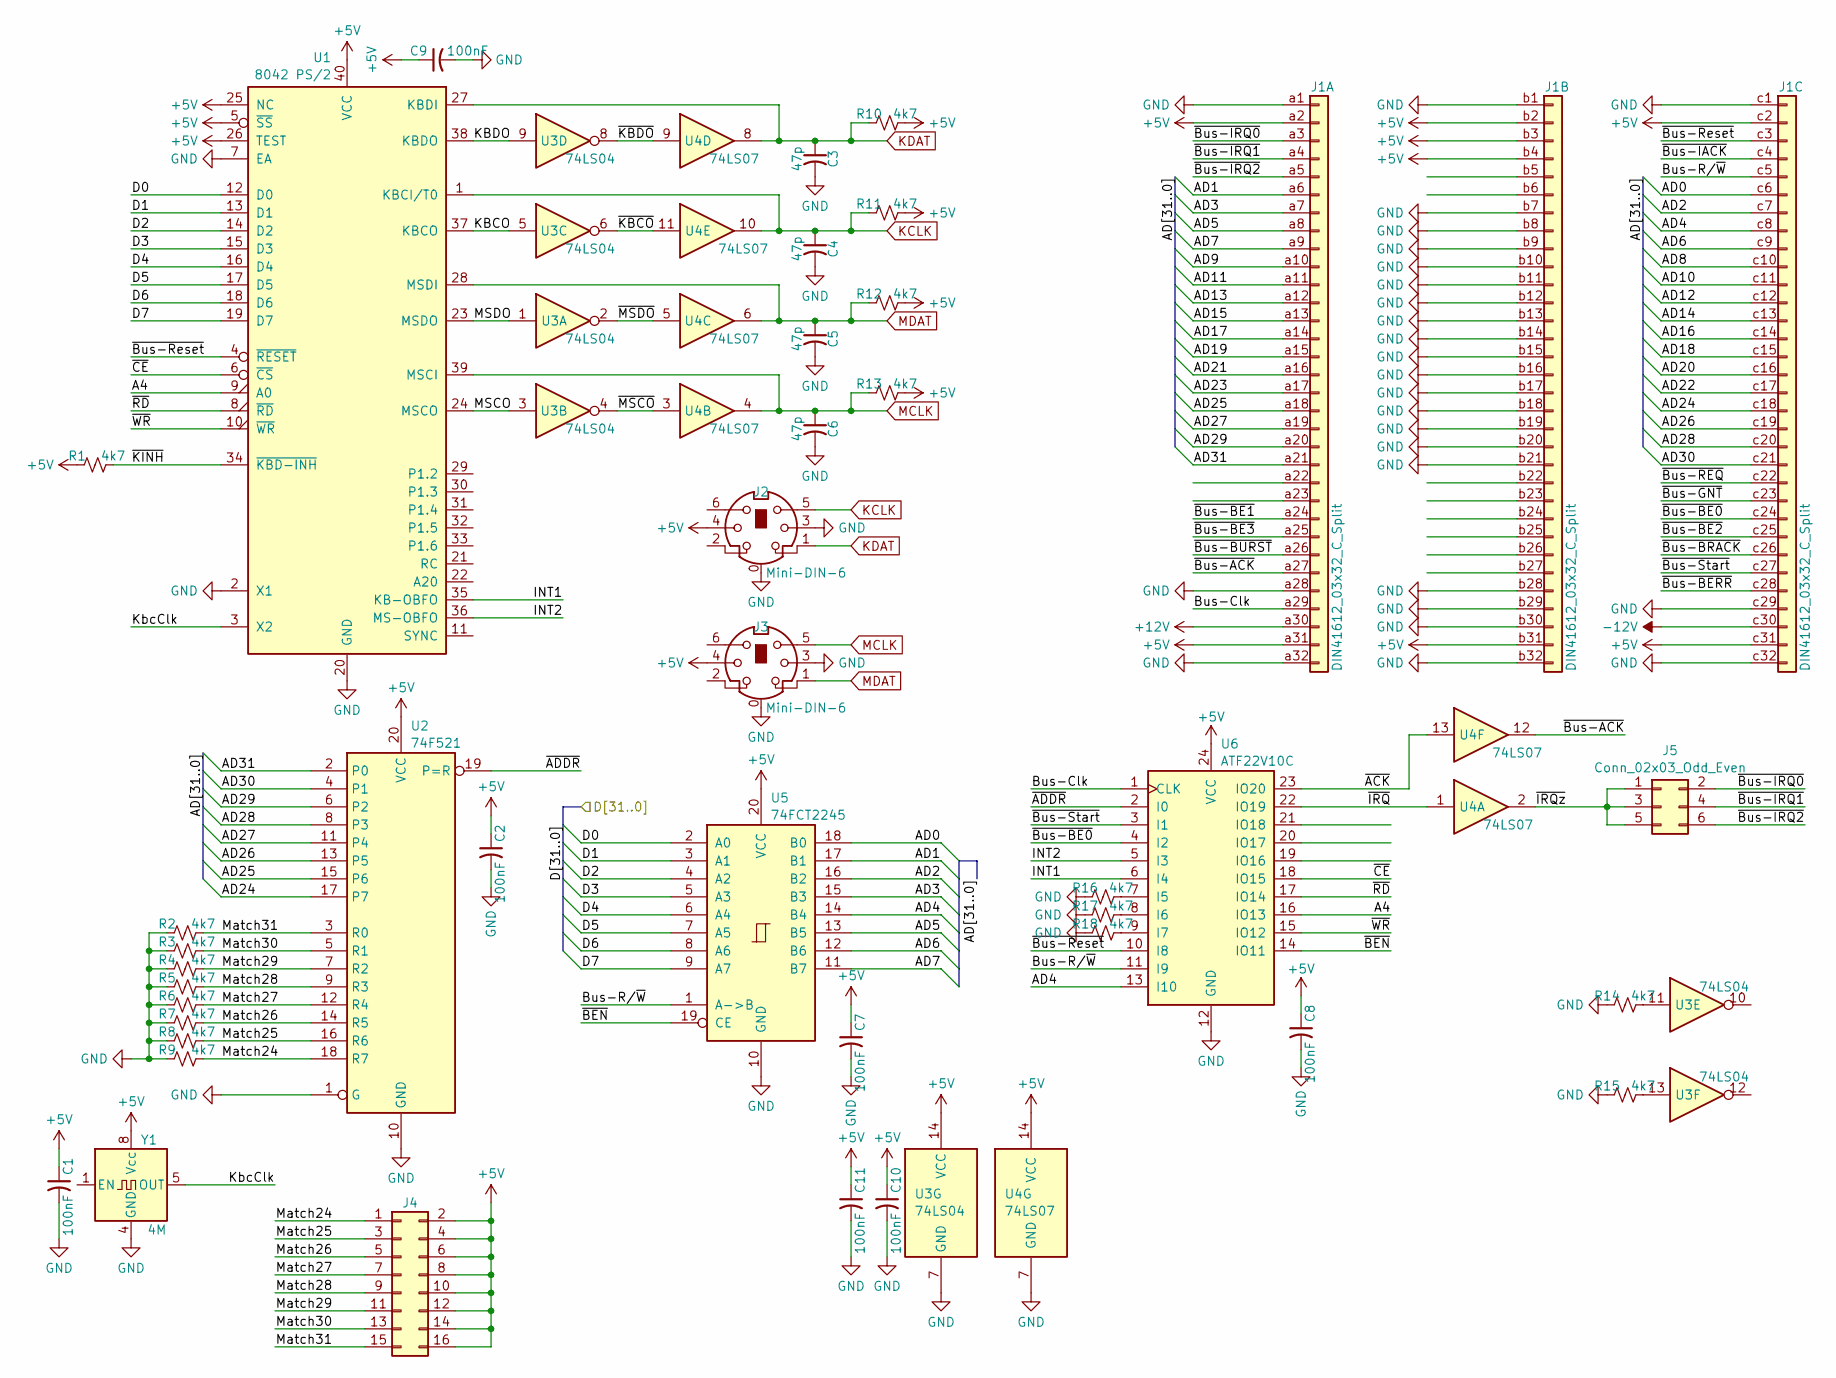
[picture p50: schematic PikaPC_KBC.kicad_sch]

Parts:
C1, C2, C7, C8, C9, C10, C11: 100nF; C_0805_2012Metric; Mouser 187-CL21B104KACNNNC
C3, C4, C5, C6: 47p; C_Disc_D3.0mm_W2.0mm_P2.50mm; Mouser 810-FG18C0G1H470JNT6
J1: DIN41612_03x32_C_Split; DIN41612_C_3x32_Male_Horizontal_THT
J2, J3: Mini-DIN-6; MiniDIN6
J4: Conn_02x08_Odd_Even; PinHeader_2x08_P2.54mm_Vertical
J5: Conn_02x03_Odd_Even; PinHeader_2x03_P2.54mm_Vertical
R1, R2, R3, R4, R5, R6, R7, R8, R9, R10, R11, R12, R13, R14, R15, R16, R17, R18: 4k7; R_0805_2012Metric; Mouser 303-0805W8J0472T5E
U1: 8042 PS/2; DIP-40_W15.24mm_Socket
U2: 74F521; SOIC-20W_7.5x12.8mm_P1.27mm; Mouser 595-SN74F521DWR
U3: 74LS04; DIP-14_W7.62mm_Socket; Mouser 595-SN74LS04N
U4: 74LS07; DIP-14_W7.62mm_Socket; Mouser 595-SN74LS07N
U5: 74FCT2245; SOIC-20W_7.5x12.8mm_P1.27mm; Mouser 595-CY74FCT2245TSOCT
U6: ATF22V10C; DIP-24_W7.62mm_Socket; Mouser 556-ATF22V10C-10PU
Y1: 4M; Oscillator_DIP-8

Connections:
+5V: C1.1, C2.1, C7.1, C8.1, C9.1, C10.1, C11.1, J1.a2, J1.a31, J1.b2, J1.b3, J1.b4, J1.b31, J1.c2, J1.c31, J2.4, J3.4, J4.2, J4.4, J4.6, J4.8, J4.10, J4.12, J4.14, J4.16, R1.1, R10.2, R11.2, R12.2, R13.2, U1.5 (~SS), U1.25 (NC), U1.26 (TEST), U1.40 (VCC), U2.20 (VCC), U3.14 (VCC), U4.14 (VCC), U5.20 (VCC), U6.24 (VCC), Y1.8 (Vcc)
+12V: J1.a30
-12V: J1.c30
/A4: U1.9 (A0), U6.16 (IO13)
/AD0: J1.c6, U5.18 (B0)
/AD1: J1.a6, U5.17 (B1)
/AD2: J1.c7, U5.16 (B2)
/AD3: J1.a7, U5.15 (B3)
/AD4: J1.c8, U5.14 (B4), U6.13 (I10)
/AD5: J1.a8, U5.13 (B5)
/AD6: J1.c9, U5.12 (B6)
/AD7: J1.a9, U5.11 (B7)
/AD8: J1.c10
/AD9: J1.a10
/AD10: J1.c11
/AD11: J1.a11
/AD12: J1.c12
/AD13: J1.a12
/AD14: J1.c13
/AD15: J1.a13
/AD16: J1.c14
/AD17: J1.a14
/AD18: J1.c15
/AD19: J1.a15
/AD20: J1.c16
/AD21: J1.a16
/AD22: J1.c17
/AD23: J1.a17
/AD24: J1.c18, U2.17 (P7)
/AD25: J1.a18, U2.15 (P6)
/AD26: J1.c19, U2.13 (P5)
/AD27: J1.a19, U2.11 (P4)
/AD28: J1.c20, U2.8 (P3)
/AD29: J1.a20, U2.6 (P2)
/AD30: J1.c21, U2.4 (P1)
/AD31: J1.a21, U2.2 (P0)
/Bus-Clk: J1.a29, U6.1 (CLK)
/Bus-R/~W: J1.c5, U5.1 (A->B), U6.11 (I9)
/D0: U1.12 (D0), U5.2 (A0)
/D1: U1.13 (D1), U5.3 (A1)
/D2: U1.14 (D2), U5.4 (A2)
/D3: U1.15 (D3), U5.5 (A3)
/D4: U1.16 (D4), U5.6 (A4)
/D5: U1.17 (D5), U5.7 (A5)
/D6: U1.18 (D6), U5.8 (A6)
/D7: U1.19 (D7), U5.9 (A7)
/INT1: U1.35 (KB-OBFO), U6.6 (I4)
/INT2: U1.36 (MS-OBFO), U6.5 (I3)
/KBCO: U1.37 (KBCO), U3.5
/KBDO: U1.38 (KBDO), U3.9
/KbcClk: U1.3 (X2), Y1.5 (OUT)
/MSCO: U1.24 (MSCO), U3.3
/MSDO: U1.23 (MSDO), U3.1
/Match24: J4.1, R9.2, U2.18 (R7)
/Match25: J4.3, R8.2, U2.16 (R6)
/Match26: J4.5, R7.2, U2.14 (R5)
/Match27: J4.7, R6.2, U2.12 (R4)
/Match28: J4.9, R5.2, U2.9 (R3)
/Match29: J4.11, R4.2, U2.7 (R2)
/Match30: J4.13, R3.2, U2.5 (R1)
/Match31: J4.15, R2.2, U2.3 (R0)
/~ACK: U4.13, U6.23 (IO20)
/~ADDR: U2.19 (P=R), U6.2 (I0)
/~BEN: U5.19 (CE), U6.14 (IO11)
/~Bus-ACK: J1.a27, U4.12
/~Bus-BE0: J1.c24, U6.4 (I2)
/~Bus-BE1: J1.a24
/~Bus-BE2: J1.c25
/~Bus-BE3: J1.a25
/~Bus-BERR: J1.c28
/~Bus-BRACK: J1.c26
/~Bus-BURST: J1.a26
/~Bus-GNT: J1.c23
/~Bus-IACK: J1.c4
/~Bus-IRQ0: J1.a3, J5.2
/~Bus-IRQ1: J1.a4, J5.4
/~Bus-IRQ2: J1.a5, J5.6
/~Bus-REQ: J1.c22
/~Bus-Reset: J1.c3, U1.4 (~RESET), U6.10 (I8)
/~Bus-Start: J1.c27, U6.3 (I1)
/~CE: U1.6 (~CS), U6.18 (IO15)
/~IRQz: J5.1, J5.3, J5.5, U4.2
/~IRQ: U4.1, U6.22 (IO19)
/~KBCO: U3.6, U4.11
/~KBDO: U3.8, U4.9
/~KINH: R1.2, U1.34 (~KBD-INH)
/~MSCO: U3.4, U4.3
/~MSDO: U3.2, U4.5
/~RD: U1.8 (~RD), U6.17 (IO14)
/~WR: U1.10 (~WR), U6.15 (IO12)
GND: C1.2, C2.2, C3.2, C4.2, C5.2, C6.2, C7.2, C8.2, C9.2, C10.2, C11.2, J1.a1, J1.a28, J1.a32, J1.b1, J1.b7, J1.b8, J1.b9, J1.b10, J1.b11, J1.b12, J1.b13, J1.b14, J1.b15, J1.b16, J1.b17, J1.b18, J1.b19, J1.b20, J1.b21, J1.b28, J1.b29, J1.b30, J1.b32, J1.c1, J1.c29, J1.c32, J2.0, J2.3, J3.0, J3.3, R2.1, R3.1, R4.1, R5.1, R6.1, R7.1, R8.1, R9.1, R14.1, R15.1, R16.1, R17.1, R18.1, U1.2 (X1), U1.7 (EA), U1.20 (GND), U2.1 (G), U2.10 (GND), U3.7 (GND), U4.7 (GND), U5.10 (GND), U6.12 (GND), Y1.4 (GND)
KCLK: C4.1, J2.5, R11.1, U1.1 (KBCI/T0), U4.10
KDAT: C3.1, J2.1, R10.1, U1.27 (KBDI), U4.8
MCLK: C6.1, J3.5, R13.1, U1.39 (MSCI), U4.4
MDAT: C5.1, J3.1, R12.1, U1.28 (MSDI), U4.6
unnamed: R14.2, U3.11
unnamed: R15.2, U3.13
unnamed: R16.2, U6.7 (I5)
unnamed: R17.2, U6.8 (I6)
unnamed: R18.2, U6.9 (I7)

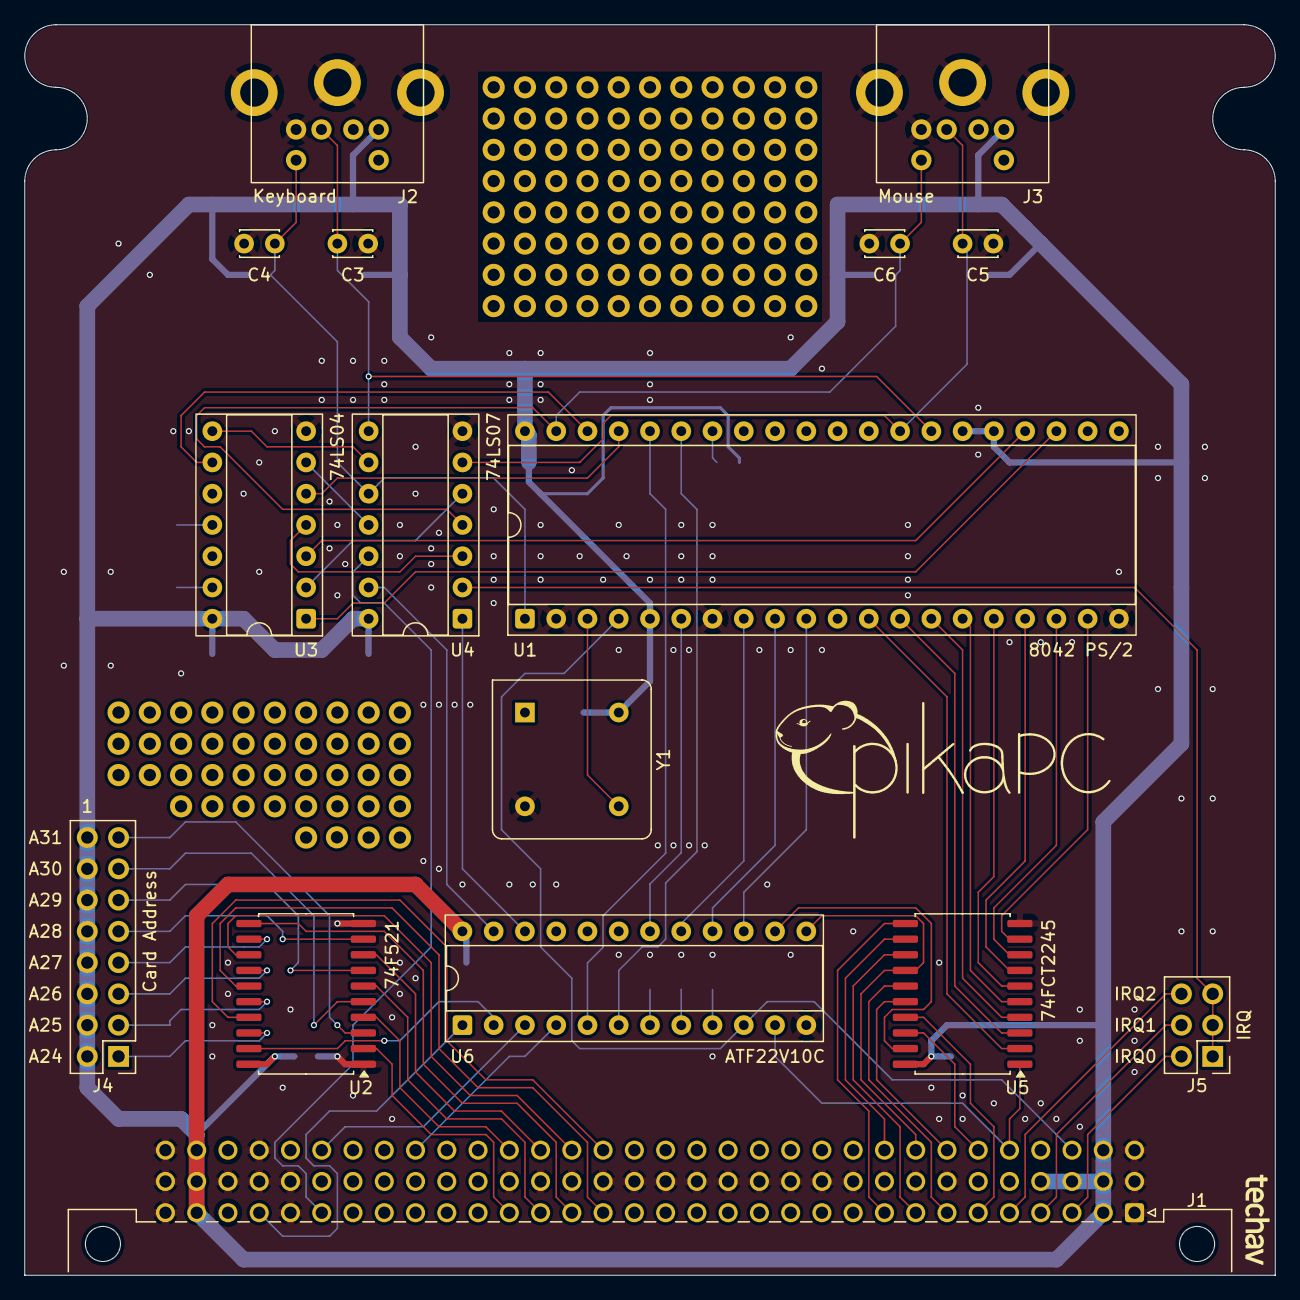
[picture p51: board PikaPC_KBC.kicad_pcb from above]

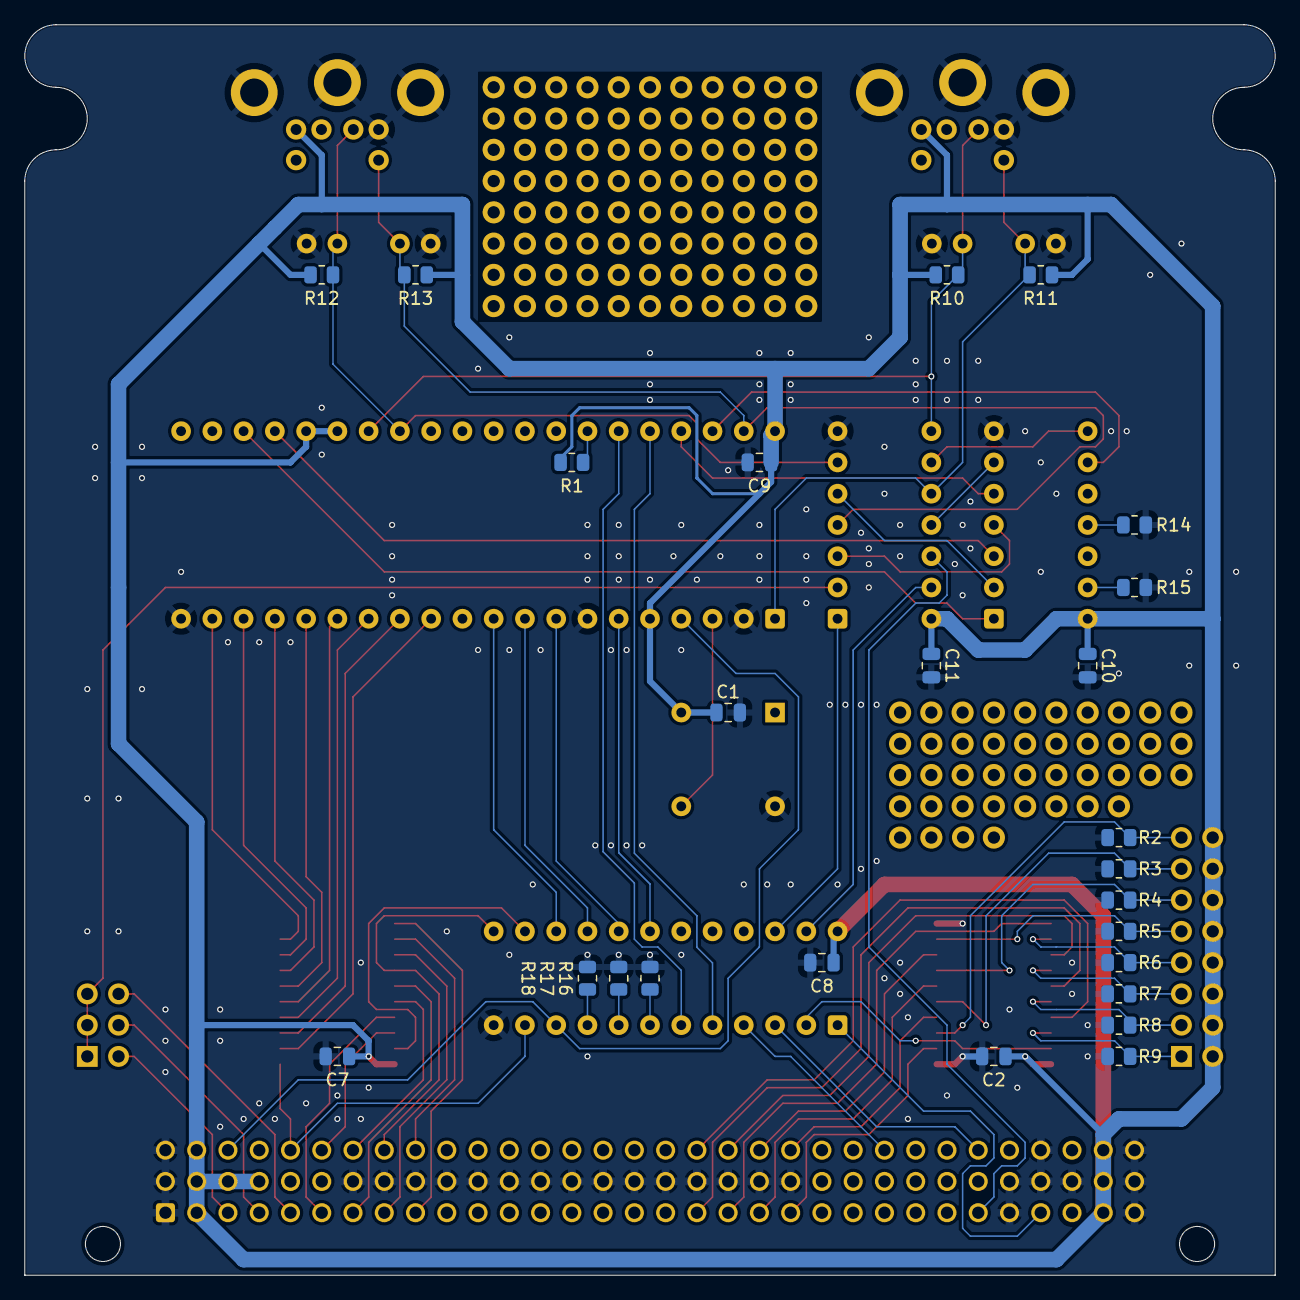
[picture p52: board PikaPC_KBC.kicad_pcb from below]

Board: 2 copper layers, 101.6 x 101.6 mm, 41 parts (25 on the bottom side), 73 nets.
