techav-homebrew/PikaPC/Hardware/PikaPC_Power/PikaPC_Power.kicad_pcb

## KiCad design Hardware/PikaPC_Power/PikaPC_Power.kicad_pcb (2026-05-26)

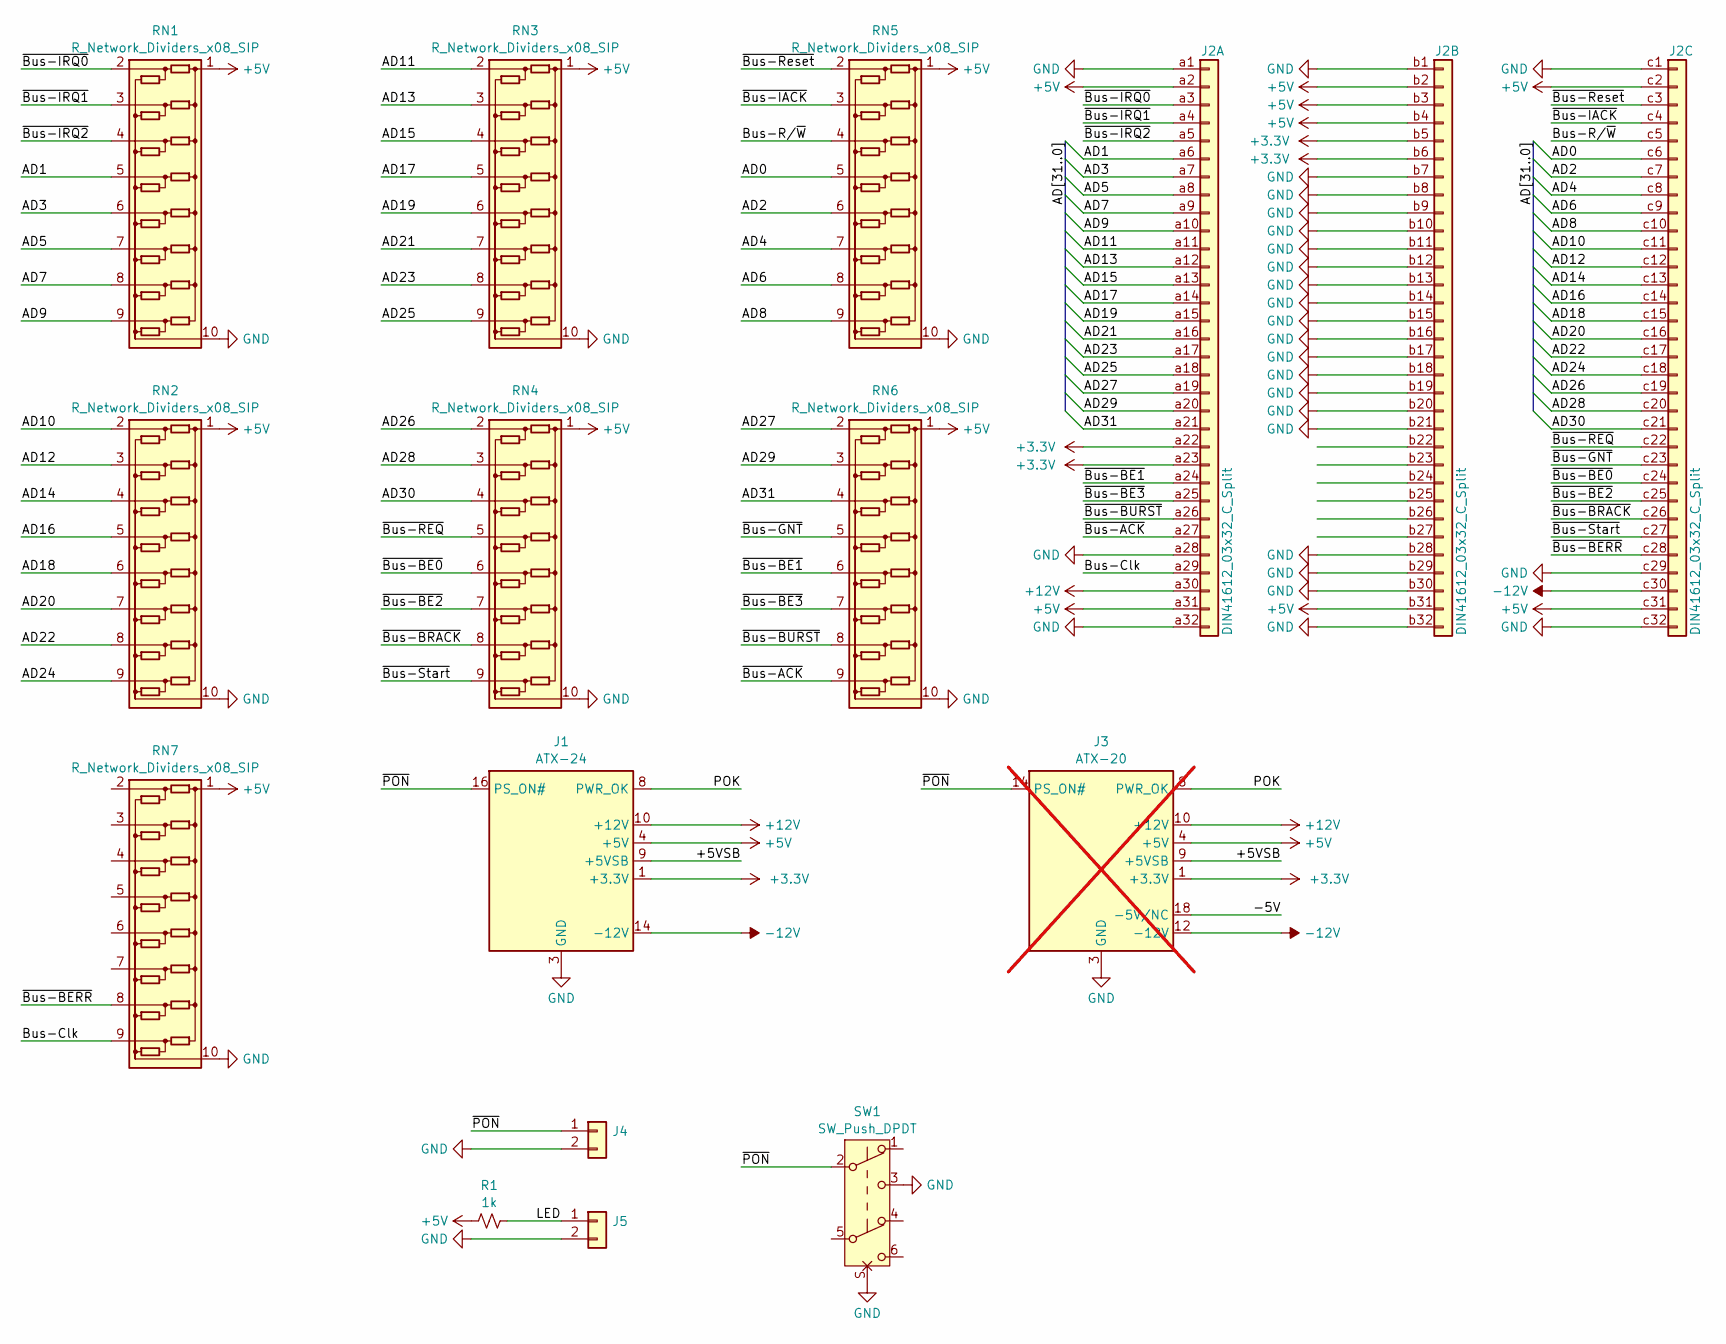
[picture p53: schematic PikaPC_Power.kicad_sch]

Parts:
J1: ATX-24; Molex_Mini-Fit_Jr_5569-24A2_2x12_P4.20mm_Horizontal
J2: DIN41612_03x32_C_Split; DIN41612_C_3x32_Male_Horizontal_THT
J3: ATX-20; Molex_Mini-Fit_Jr_5566-20A2_2x10_P4.20mm_Vertical; not fitted
J4, J5: Conn_01x02; PinHeader_1x02_P2.54mm_Vertical
R1: 1k; R_Axial_DIN0204_L3.6mm_D1.6mm_P7.62mm_Horizontal
RN1, RN2, RN3, RN4, RN5, RN6, RN7: R_Network_Dividers_x08_SIP; R_Array_SIP10
SW1: SW_Push_DPDT; SW_NKK_G1xJP

Connections:
+3.3V: J1.1 (+3.3V), J1.2 (+3.3V), J1.12 (+3.3V), J1.13 (+3.3V), J2.a22, J2.a23, J2.b5, J2.b6, J3.1 (+3.3V), J3.2 (+3.3V), J3.11 (+3.3V)
+5V: J1.4 (+5V), J1.6 (+5V), J1.21 (+5V), J1.22 (+5V), J1.23 (+5V), J2.a2, J2.a31, J2.b2, J2.b3, J2.b4, J2.b31, J2.c2, J2.c31, J3.4 (+5V), J3.6 (+5V), J3.19 (+5V), J3.20 (+5V), R1.1, RN1.1 (COM1), RN2.1 (COM1), RN3.1 (COM1), RN4.1 (COM1), RN5.1 (COM1), RN6.1 (COM1), RN7.1 (COM1)
+12V: J1.10 (+12V), J1.11 (+12V), J2.a30, J3.10 (+12V)
-12V: J1.14 (-12V), J2.c30, J3.12 (-12V)
/+5VSB: J1.9 (+5VSB), J3.9 (+5VSB)
/-5V: J3.18 (-5V/NC)
/AD0: J2.c6, RN5.5 (R4)
/AD1: J2.a6, RN1.5 (R4)
/AD2: J2.c7, RN5.6 (R5)
/AD3: J2.a7, RN1.6 (R5)
/AD4: J2.c8, RN5.7 (R6)
/AD5: J2.a8, RN1.7 (R6)
/AD6: J2.c9, RN5.8 (R7)
/AD7: J2.a9, RN1.8 (R7)
/AD8: J2.c10, RN5.9 (R8)
/AD9: J2.a10, RN1.9 (R8)
/AD10: J2.c11, RN2.2 (R1)
/AD11: J2.a11, RN3.2 (R1)
/AD12: J2.c12, RN2.3 (R2)
/AD13: J2.a12, RN3.3 (R2)
/AD14: J2.c13, RN2.4 (R3)
/AD15: J2.a13, RN3.4 (R3)
/AD16: J2.c14, RN2.5 (R4)
/AD17: J2.a14, RN3.5 (R4)
/AD18: J2.c15, RN2.6 (R5)
/AD19: J2.a15, RN3.6 (R5)
/AD20: J2.c16, RN2.7 (R6)
/AD21: J2.a16, RN3.7 (R6)
/AD22: J2.c17, RN2.8 (R7)
/AD23: J2.a17, RN3.8 (R7)
/AD24: J2.c18, RN2.9 (R8)
/AD25: J2.a18, RN3.9 (R8)
/AD26: J2.c19, RN4.2 (R1)
/AD27: J2.a19, RN6.2 (R1)
/AD28: J2.c20, RN4.3 (R2)
/AD29: J2.a20, RN6.3 (R2)
/AD30: J2.c21, RN4.4 (R3)
/AD31: J2.a21, RN6.4 (R3)
/Bus-Clk: J2.a29, RN7.9 (R8)
/Bus-R/~W: J2.c5, RN5.4 (R3)
/LED: J5.1, R1.2
/POK: J1.8 (PWR_OK), J3.8 (PWR_OK)
/~Bus-ACK: J2.a27, RN6.9 (R8)
/~Bus-BE0: J2.c24, RN4.6 (R5)
/~Bus-BE1: J2.a24, RN6.6 (R5)
/~Bus-BE2: J2.c25, RN4.7 (R6)
/~Bus-BE3: J2.a25, RN6.7 (R6)
/~Bus-BERR: J2.c28, RN7.8 (R7)
/~Bus-BRACK: J2.c26, RN4.8 (R7)
/~Bus-BURST: J2.a26, RN6.8 (R7)
/~Bus-GNT: J2.c23, RN6.5 (R4)
/~Bus-IACK: J2.c4, RN5.3 (R2)
/~Bus-IRQ0: J2.a3, RN1.2 (R1)
/~Bus-IRQ1: J2.a4, RN1.3 (R2)
/~Bus-IRQ2: J2.a5, RN1.4 (R3)
/~Bus-REQ: J2.c22, RN4.5 (R4)
/~Bus-Reset: J2.c3, RN5.2 (R1)
/~Bus-Start: J2.c27, RN4.9 (R8)
/~PON: J1.16 (PS_ON#), J3.14 (PS_ON#), J4.1, SW1.2 (B)
GND: J1.3 (GND), J1.5 (GND), J1.7 (GND), J1.15 (GND), J1.17 (GND), J1.18 (GND), J1.19 (GND), J1.24 (GND), J2.a1, J2.a28, J2.a32, J2.b1, J2.b7, J2.b8, J2.b9, J2.b10, J2.b11, J2.b12, J2.b13, J2.b14, J2.b15, J2.b16, J2.b17, J2.b18, J2.b19, J2.b20, J2.b21, J2.b28, J2.b29, J2.b30, J2.b32, J2.c1, J2.c29, J2.c32, J3.3 (GND), J3.5 (GND), J3.7 (GND), J3.13 (GND), J3.15 (GND), J3.16 (GND), J3.17 (GND), J4.2, J5.2, RN1.10 (COM2), RN2.10 (COM2), RN3.10 (COM2), RN4.10 (COM2), RN5.10 (COM2), RN6.10 (COM2), RN7.10 (COM2), SW1.3 (C), SW1.S

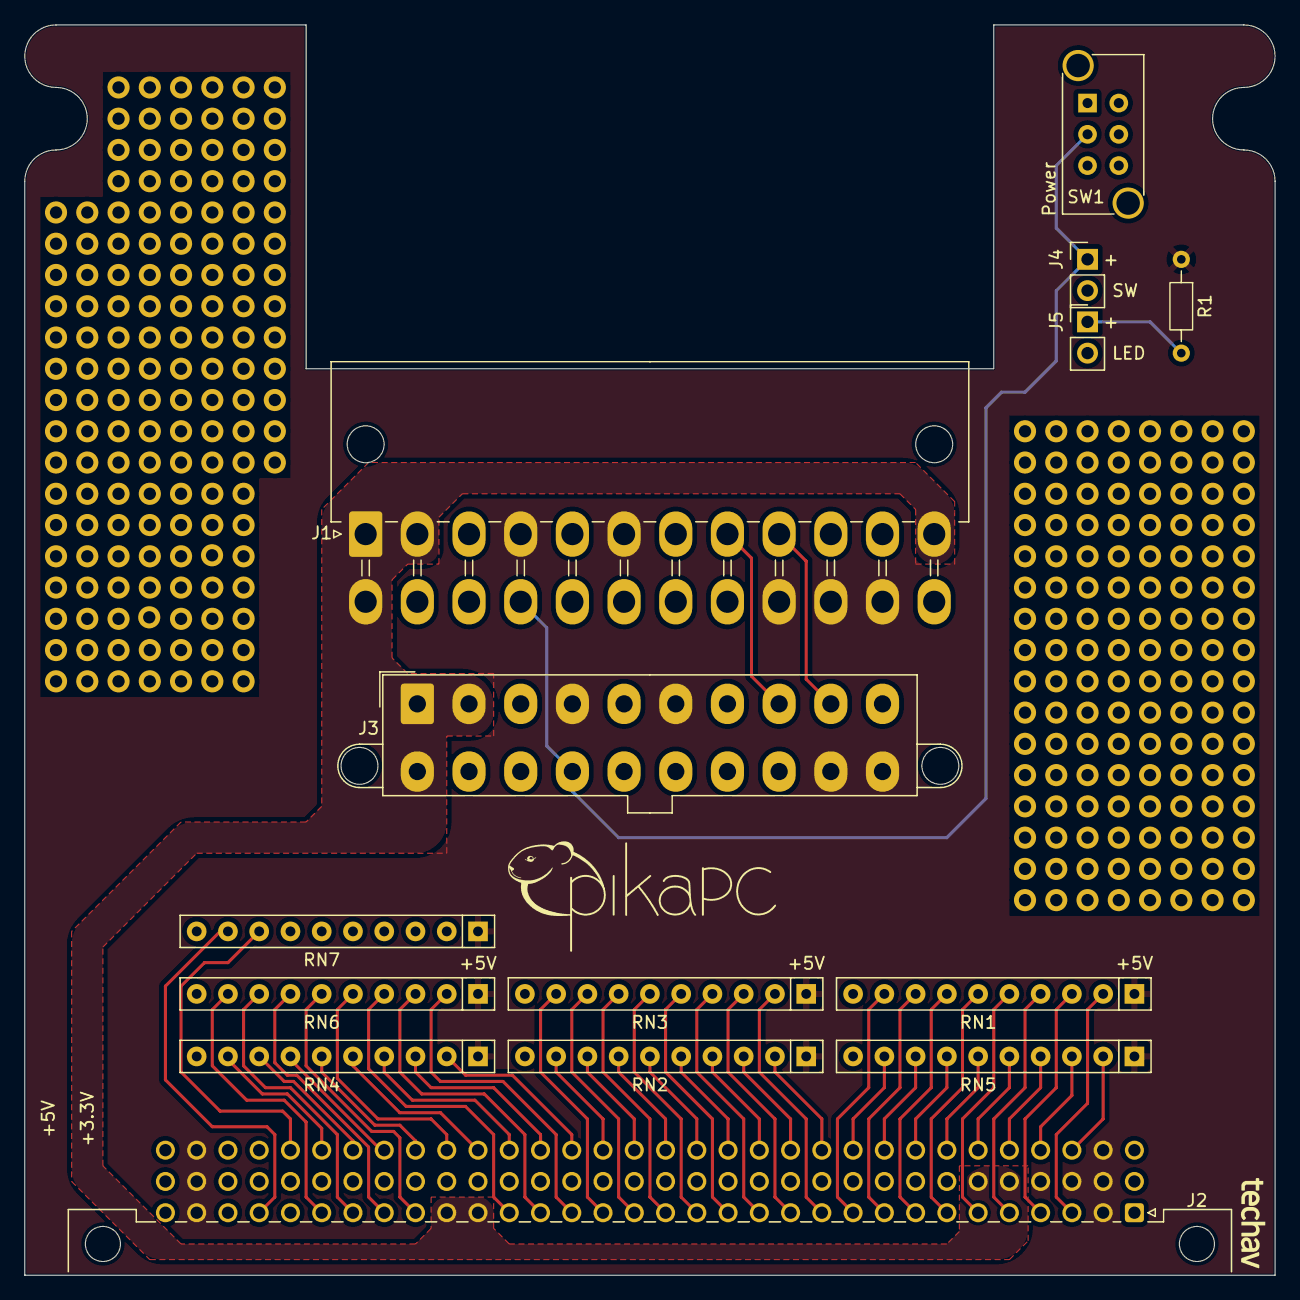
[picture p54: board PikaPC_Power.kicad_pcb from above]

Board: 2 copper layers, 101.6 x 101.6 mm, 14 parts (0 on the bottom side), 59 nets.
