techav-homebrew/PikaPC/Hardware/PikaPC_IDE/PikaPC_IDE.kicad_pcb

## KiCad design Hardware/PikaPC_IDE/PikaPC_IDE.kicad_pcb (2026-05-26)

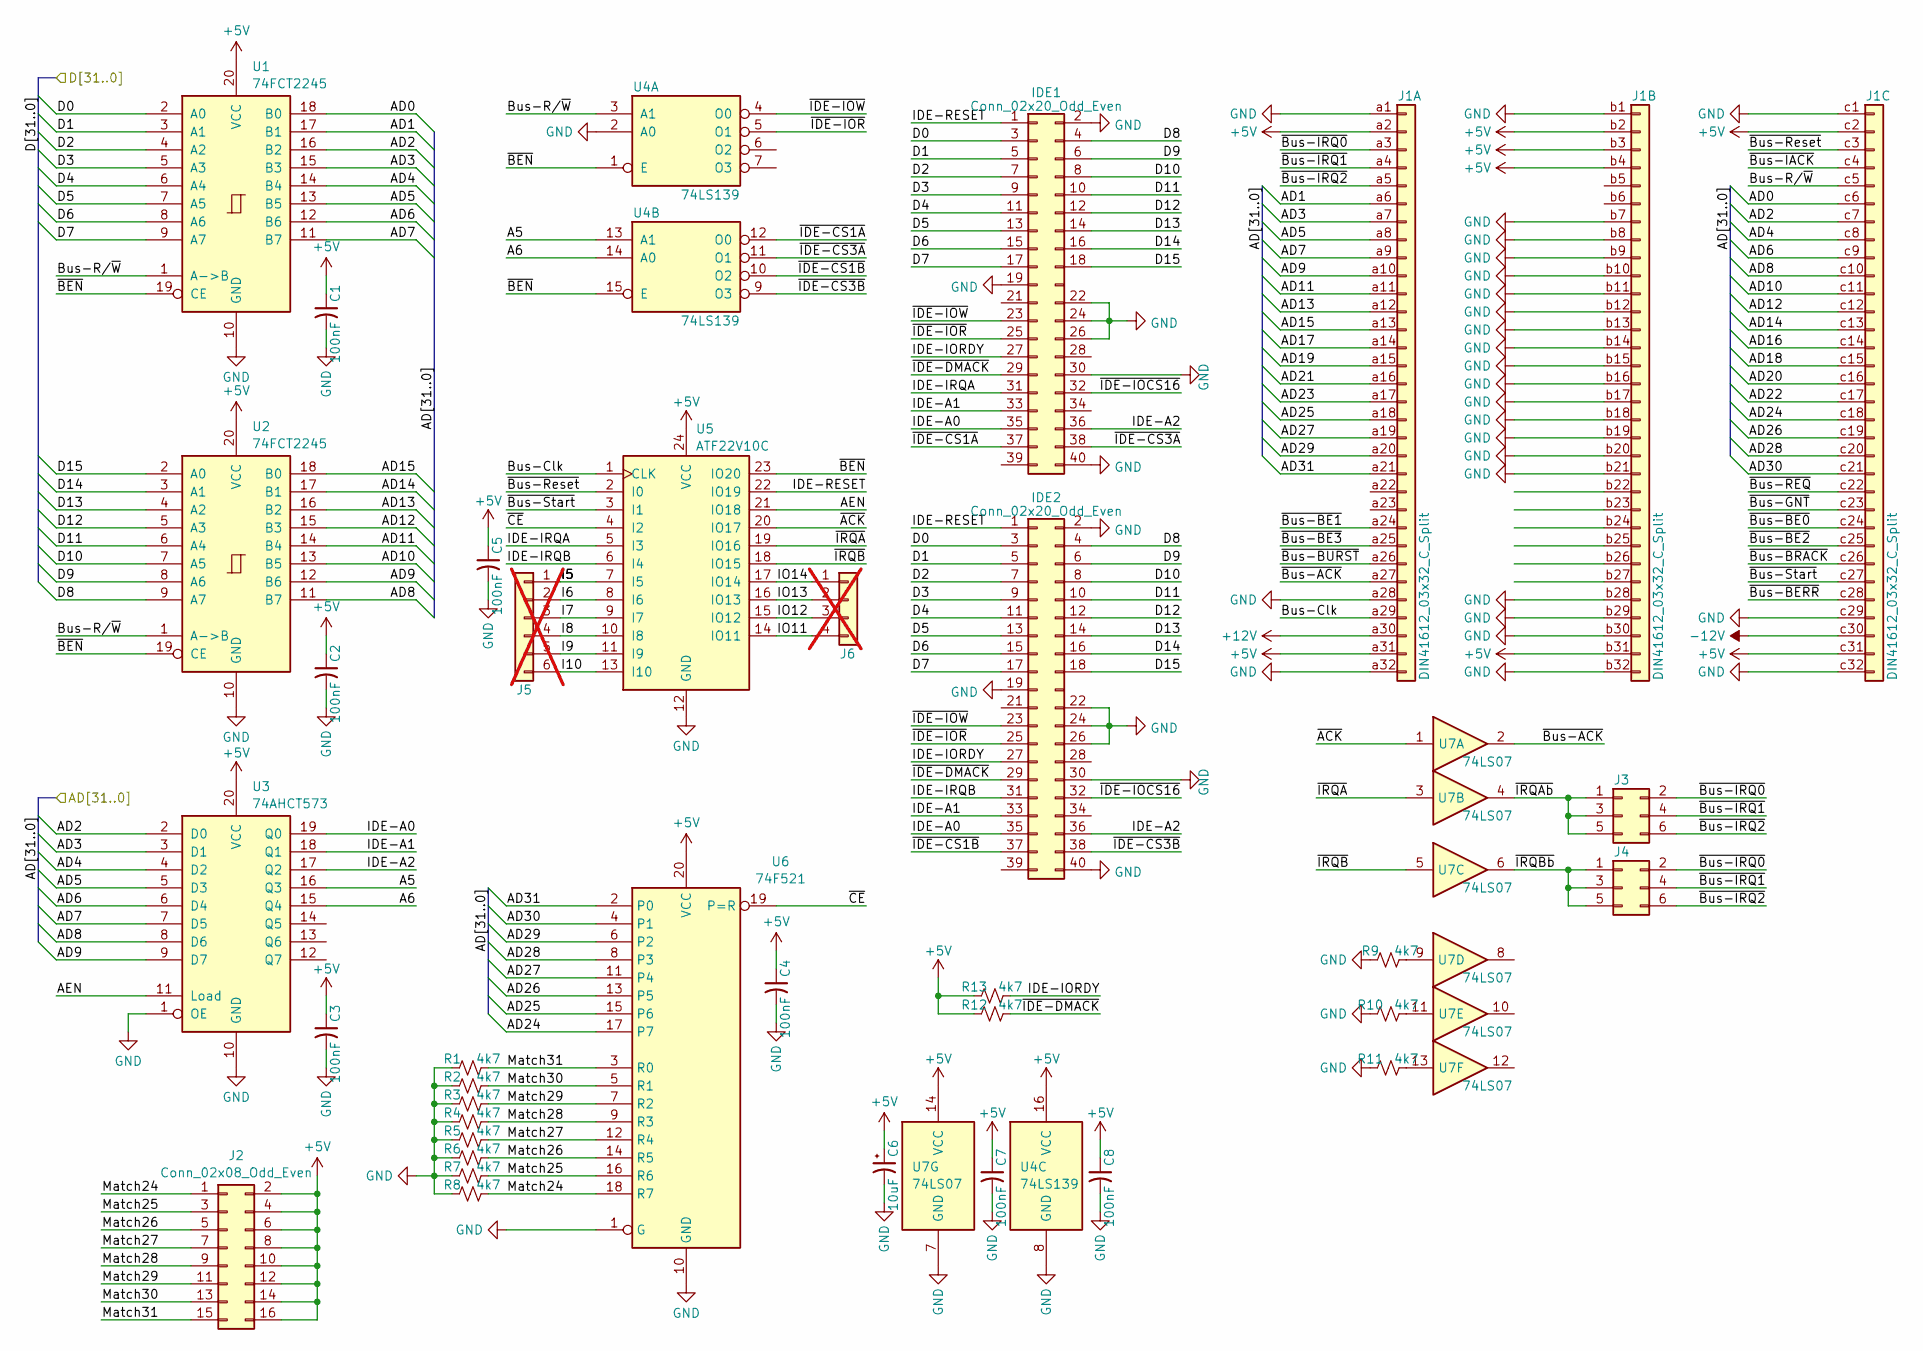
[picture p55: schematic PikaPC_IDE.kicad_sch]

Parts:
C1, C2, C3, C4, C5, C7, C8: 100nF; C_0805_2012Metric; Mouser 187-CL21B104KACNNNC
C6: 10uF; CP_Elec_4x5.7; Mouser 80-EDK106M016A9BAA
IDE1, IDE2: Conn_02x20_Odd_Even; IDC-Header_2x20_P2.54mm_Vertical; Mouser-Part 710-61203921621
J1: DIN41612_03x32_C_Split; DIN41612_C_3x32_Male_Horizontal_THT
J2: Conn_02x08_Odd_Even; PinHeader_2x08_P2.54mm_Vertical
J3, J4: Conn_02x03_Odd_Even; PinHeader_2x03_P2.54mm_Vertical
J5: Conn_01x06; PinHeader_1x06_P2.54mm_Vertical; not fitted
J6: Conn_01x04; PinHeader_1x04_P2.54mm_Vertical; not fitted
R1, R2, R3, R4, R5, R6, R7, R8, R9, R10, R11, R12, R13: 4k7; R_0805_2012Metric; Mouser 303-0805W8J0472T5E
U1, U2: 74FCT2245; SOIC-20W_7.5x12.8mm_P1.27mm; Mouser 595-CY74FCT2245TSOCT
U3: 74AHCT573; TSSOP-20_4.4x6.5mm_P0.65mm; Mouser 771-74AHCT573PW-T
U4: 74LS139; DIP-16_W7.62mm_Socket
U5: ATF22V10C; DIP-24_W7.62mm_Socket; Mouser 556-ATF22V10C-10PU
U6: 74F521; SOIC-20W_7.5x12.8mm_P1.27mm; Mouser 595-SN74F521DWR
U7: 74LS07; DIP-14_W7.62mm_Socket; Mouser 595-SN74LS07N

Connections:
+5V: C1.1, C2.1, C3.1, C4.1, C5.1, C6.1, C7.1, C8.1, J1.a2, J1.a31, J1.b2, J1.b3, J1.b4, J1.b31, J1.c2, J1.c31, J2.2, J2.4, J2.6, J2.8, J2.10, J2.12, J2.14, J2.16, R12.1, R13.1, U1.20 (VCC), U2.20 (VCC), U3.20 (VCC), U4.16 (VCC), U5.24 (VCC), U6.20 (VCC), U7.14 (VCC)
+12V: J1.a30
-12V: J1.c30
/A5: U3.16 (Q3), U4.13 (A1)
/A6: U3.15 (Q4), U4.14 (A0)
/AD0: J1.c6, U1.18 (B0)
/AD1: J1.a6, U1.17 (B1)
/AD2: J1.c7, U1.16 (B2), U3.2 (D0)
/AD3: J1.a7, U1.15 (B3), U3.3 (D1)
/AD4: J1.c8, U1.14 (B4), U3.4 (D2)
/AD5: J1.a8, U1.13 (B5), U3.5 (D3)
/AD6: J1.c9, U1.12 (B6), U3.6 (D4)
/AD7: J1.a9, U1.11 (B7), U3.7 (D5)
/AD8: J1.c10, U2.11 (B7), U3.8 (D6)
/AD9: J1.a10, U2.12 (B6), U3.9 (D7)
/AD10: J1.c11, U2.13 (B5)
/AD11: J1.a11, U2.14 (B4)
/AD12: J1.c12, U2.15 (B3)
/AD13: J1.a12, U2.16 (B2)
/AD14: J1.c13, U2.17 (B1)
/AD15: J1.a13, U2.18 (B0)
/AD16: J1.c14
/AD17: J1.a14
/AD18: J1.c15
/AD19: J1.a15
/AD20: J1.c16
/AD21: J1.a16
/AD22: J1.c17
/AD23: J1.a17
/AD24: J1.c18, U6.17 (P7)
/AD25: J1.a18, U6.15 (P6)
/AD26: J1.c19, U6.13 (P5)
/AD27: J1.a19, U6.11 (P4)
/AD28: J1.c20, U6.8 (P3)
/AD29: J1.a20, U6.6 (P2)
/AD30: J1.c21, U6.4 (P1)
/AD31: J1.a21, U6.2 (P0)
/AEN: U3.11 (Load), U5.21 (IO18)
/Bus-Clk: J1.a29, U5.1 (CLK)
/Bus-R/~W: J1.c5, U1.1 (A->B), U2.1 (A->B), U4.3 (A1)
/D0: IDE1.3, IDE2.3, U1.2 (A0)
/D1: IDE1.5, IDE2.5, U1.3 (A1)
/D2: IDE1.7, IDE2.7, U1.4 (A2)
/D3: IDE1.9, IDE2.9, U1.5 (A3)
/D4: IDE1.11, IDE2.11, U1.6 (A4)
/D5: IDE1.13, IDE2.13, U1.7 (A5)
/D6: IDE1.15, IDE2.15, U1.8 (A6)
/D7: IDE1.17, IDE2.17, U1.9 (A7)
/D8: IDE1.4, IDE2.4, U2.9 (A7)
/D9: IDE1.6, IDE2.6, U2.8 (A6)
/D10: IDE1.8, IDE2.8, U2.7 (A5)
/D11: IDE1.10, IDE2.10, U2.6 (A4)
/D12: IDE1.12, IDE2.12, U2.5 (A3)
/D13: IDE1.14, IDE2.14, U2.4 (A2)
/D14: IDE1.16, IDE2.16, U2.3 (A1)
/D15: IDE1.18, IDE2.18, U2.2 (A0)
/I5: J5.1, U5.7 (I5)
/I6: J5.2, U5.8 (I6)
/I7: J5.3, U5.9 (I7)
/I8: J5.4, U5.10 (I8)
/I9: J5.5, U5.11 (I9)
/I10: J5.6, U5.13 (I10)
/IDE-A0: IDE1.35, IDE2.35, U3.19 (Q0)
/IDE-A1: IDE1.33, IDE2.33, U3.18 (Q1)
/IDE-A2: IDE1.36, IDE2.36, U3.17 (Q2)
/IDE-IORDY: IDE1.27, IDE2.27, R13.2
/IDE-IRQA: IDE1.31, U5.5 (I3)
/IDE-IRQB: IDE2.31, U5.6 (I4)
/IDE-RESET: IDE1.1, IDE2.1, U5.22 (IO19)
/IO11: J6.4, U5.14 (IO11)
/IO12: J6.3, U5.15 (IO12)
/IO13: J6.2, U5.16 (IO13)
/IO14: J6.1, U5.17 (IO14)
/Match24: J2.1, R8.2, U6.18 (R7)
/Match25: J2.3, R7.2, U6.16 (R6)
/Match26: J2.5, R6.2, U6.14 (R5)
/Match27: J2.7, R5.2, U6.12 (R4)
/Match28: J2.9, R4.2, U6.9 (R3)
/Match29: J2.11, R3.2, U6.7 (R2)
/Match30: J2.13, R2.2, U6.5 (R1)
/Match31: J2.15, R1.2, U6.3 (R0)
/~ACK: U5.20 (IO17), U7.1
/~BEN: U1.19 (CE), U2.19 (CE), U4.1 (E), U4.15 (E), U5.23 (IO20)
/~Bus-ACK: J1.a27, U7.2
/~Bus-BE0: J1.c24
/~Bus-BE1: J1.a24
/~Bus-BE2: J1.c25
/~Bus-BE3: J1.a25
/~Bus-BERR: J1.c28
/~Bus-BRACK: J1.c26
/~Bus-BURST: J1.a26
/~Bus-GNT: J1.c23
/~Bus-IACK: J1.c4
/~Bus-IRQ0: J1.a3, J3.2, J4.2
/~Bus-IRQ1: J1.a4, J3.4, J4.4
/~Bus-IRQ2: J1.a5, J3.6, J4.6
/~Bus-REQ: J1.c22
/~Bus-Reset: J1.c3, U5.2 (I0)
/~Bus-Start: J1.c27, U5.3 (I1)
/~CE: U5.4 (I2), U6.19 (P=R)
/~IDE-CS1A: IDE1.37, U4.12 (O0)
/~IDE-CS1B: IDE2.37, U4.10 (O2)
/~IDE-CS3A: IDE1.38, U4.11 (O1)
/~IDE-CS3B: IDE2.38, U4.9 (O3)
/~IDE-DMACK: IDE1.29, IDE2.29, R12.2
/~IDE-IOCS16: IDE1.32, IDE2.32
/~IDE-IOR: IDE1.25, IDE2.25, U4.5 (O1)
/~IDE-IOW: IDE1.23, IDE2.23, U4.4 (O0)
/~IRQAb: J3.1, J3.3, J3.5, U7.4
/~IRQA: U5.19 (IO16), U7.3
/~IRQBb: J4.1, J4.3, J4.5, U7.6
/~IRQB: U5.18 (IO15), U7.5
GND: C1.2, C2.2, C3.2, C4.2, C5.2, C6.2, C7.2, C8.2, IDE1.2, IDE1.19, IDE1.22, IDE1.24, IDE1.26, IDE1.30, IDE1.40, IDE2.2, IDE2.19, IDE2.22, IDE2.24, IDE2.26, IDE2.30, IDE2.40, J1.a1, J1.a28, J1.a32, J1.b1, J1.b7, J1.b8, J1.b9, J1.b10, J1.b11, J1.b12, J1.b13, J1.b14, J1.b15, J1.b16, J1.b17, J1.b18, J1.b19, J1.b20, J1.b21, J1.b28, J1.b29, J1.b30, J1.b32, J1.c1, J1.c29, J1.c32, R1.1, R2.1, R3.1, R4.1, R5.1, R6.1, R7.1, R8.1, R9.1, R10.1, R11.1, U1.10 (GND), U2.10 (GND), U3.1 (OE), U3.10 (GND), U4.2 (A0), U4.8 (GND), U5.12 (GND), U6.1 (G), U6.10 (GND), U7.7 (GND)
unnamed: R9.2, U7.9
unnamed: R10.2, U7.11
unnamed: R11.2, U7.13
