techav-homebrew/PikaPC/Hardware/PikaPC_IDE/PikaPC_IDE.kicad_pcb

## KiCad design Hardware/PikaPC_IDE/PikaPC_IDE.kicad_pcb (continued)

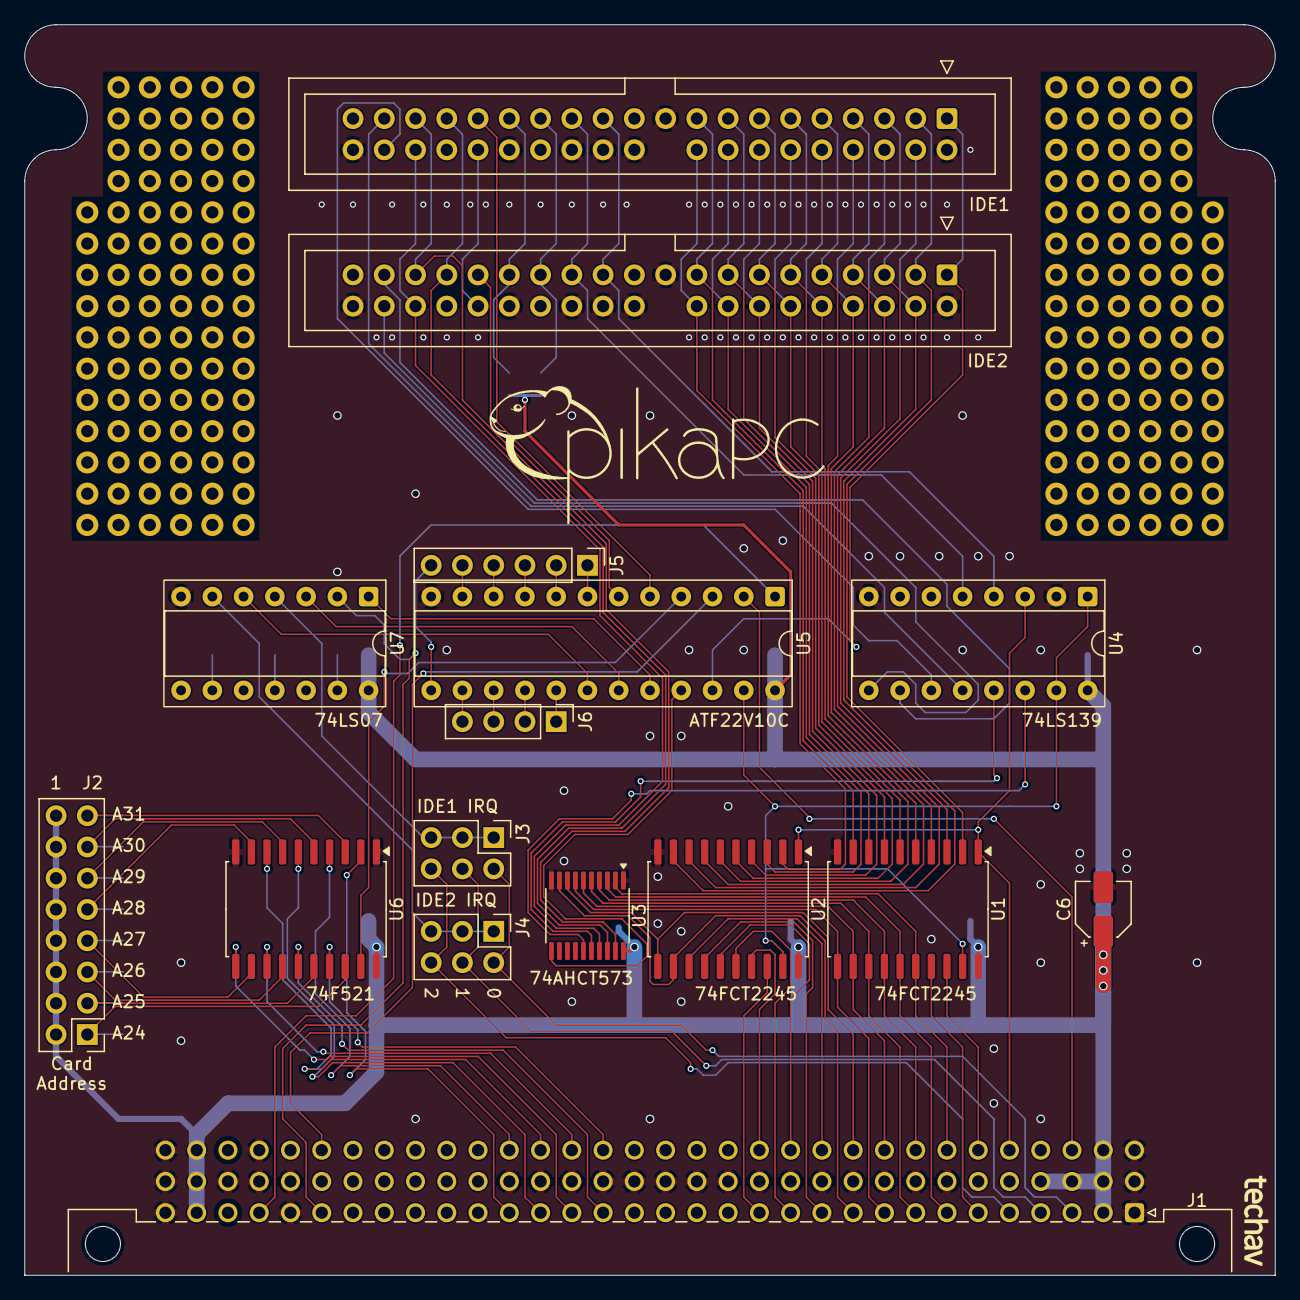
[picture p56: board PikaPC_IDE.kicad_pcb from above]

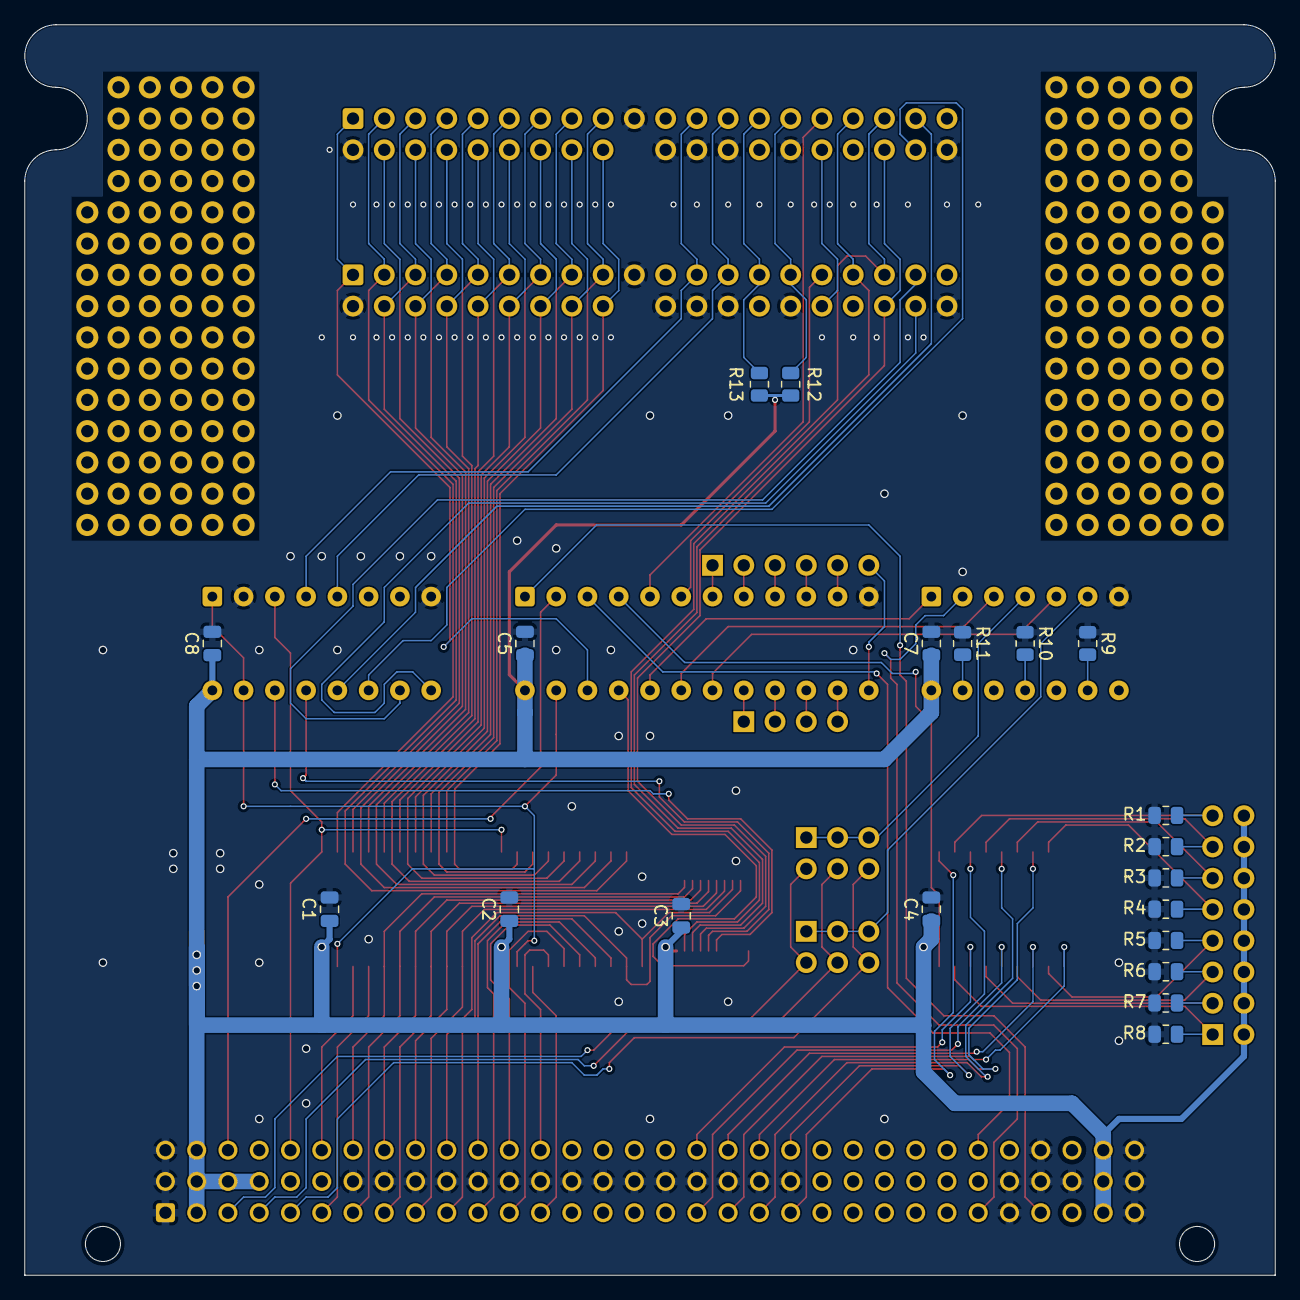
[picture p57: board PikaPC_IDE.kicad_pcb from below]

Board: 2 copper layers, 101.6 x 101.6 mm, 36 parts (20 on the bottom side), 96 nets.
