techav-homebrew/PikaPC/Hardware/PikaPC_ViRGE/PikaPC_ViRGE.kicad_pcb

## KiCad design Hardware/PikaPC_ViRGE/PikaPC_ViRGE.kicad_pcb (2026-05-26)

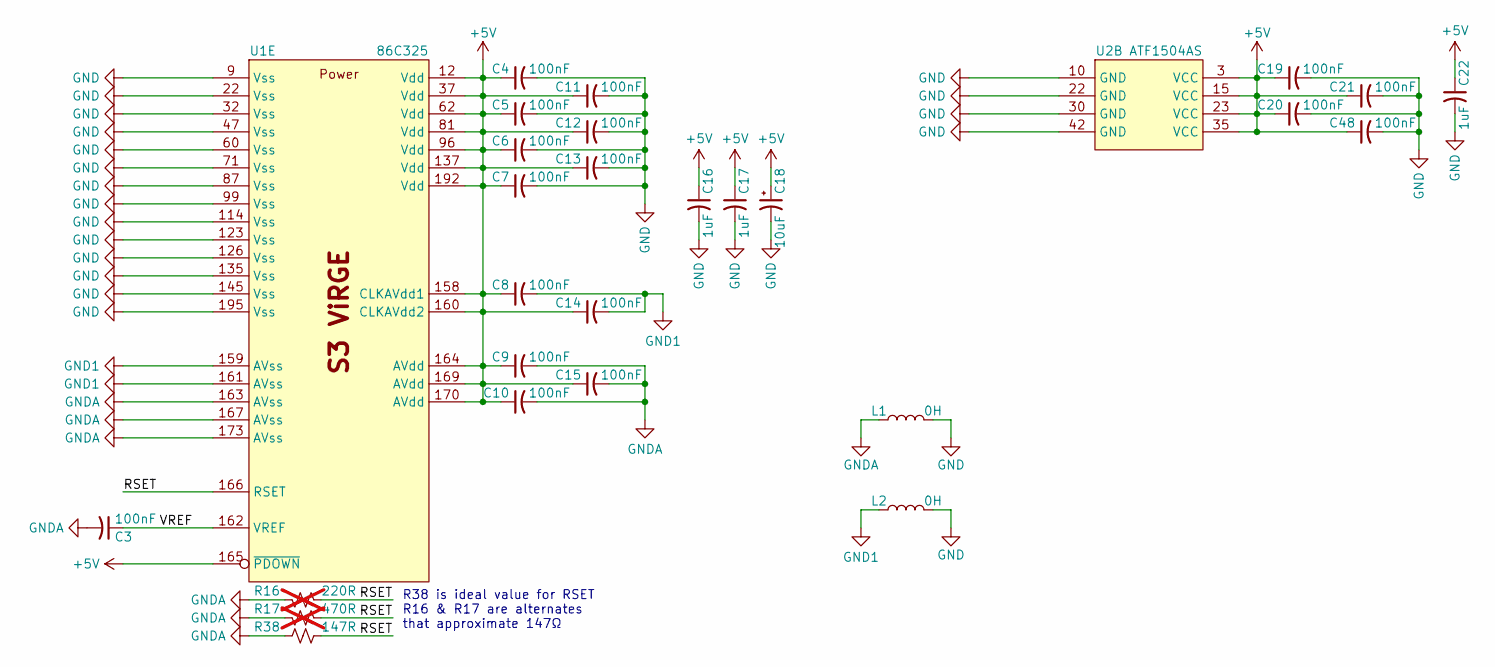
[picture p58: schematic power.kicad_sch]

Parts:
C3, C4, C5, C6, C7, C8, C9, C10, C11, C12, C13, C14, C15, C19, C20, C21, C48: 100nF; C_0805_2012Metric; Mouser 187-CL21B104KACNNNC
C16, C17, C22: 1uF; C_0805_2012Metric; Mouser 187-CL21B105KOFNNNG
C18: 10uF; CP_Elec_4x5.7; Mouser 80-EDK106M016A9BAA
L1, L2: 0H; L_1210_3225Metric; Mouser 708-RMCF1210ZT0R00
R16: 220R; R_Axial_DIN0204_L3.6mm_D1.6mm_P2.54mm_Vertical; not fitted
R17: 470R; R_Axial_DIN0204_L3.6mm_D1.6mm_P2.54mm_Vertical; not fitted
R38: 147R; R_0805_2012Metric; Mouser 603-AC0805FR-07147RL
U1: 86C325; PQFP-208_28x28mm_P0.5mm
U2: ATF1504AS; PLCC-44_THT-Socket

Connections:
+5V: C4.1, C5.1, C6.1, C7.1, C8.1, C9.1, C10.1, C11.1, C12.1, C13.1, C14.1, C15.1, C16.1, C17.1, C18.1, C19.1, C20.1, C21.1, C22.1, C48.1, U1.12 (Vdd), U1.37 (Vdd), U1.62 (Vdd), U1.81 (Vdd), U1.96 (Vdd), U1.137 (Vdd), U1.158 (CLKAVdd1), U1.160 (CLKAVdd2), U1.164 (AVdd), U1.165 (~PDOWN), U1.169 (AVdd), U1.170 (AVdd), U1.192 (Vdd), U2.3 (VCC), U2.15 (VCC), U2.23 (VCC), U2.35 (VCC); also elsewhere on the board
/Power/RSET: R16.1, R17.1, R38.2, U1.166 (RSET)
/Power/VREF: C3.1, U1.162 (VREF)
GND: C4.2, C5.2, C6.2, C7.2, C11.2, C12.2, C13.2, C16.2, C17.2, C18.2, C19.2, C20.2, C21.2, C22.2, C48.2, L1.2, L2.2, U1.9 (Vss), U1.22 (Vss), U1.32 (Vss), U1.47 (Vss), U1.60 (Vss), U1.71 (Vss), U1.87 (Vss), U1.99 (Vss), U1.114 (Vss), U1.123 (Vss), U1.126 (Vss), U1.135 (Vss), U1.145 (Vss), U1.195 (Vss), U2.10 (GND), U2.22 (GND), U2.30 (GND), U2.42 (GND); also elsewhere on the board
GND1: C8.2, C14.2, L2.1, U1.159 (AVss), U1.161 (AVss); also elsewhere on the board
GNDA: C3.2, C9.2, C10.2, C15.2, L1.1, R16.2, R17.2, R38.1, U1.163 (AVss), U1.167 (AVss), U1.173 (AVss); also elsewhere on the board

Notes on the sheet:
R38 is ideal value for RSET R16 & R17 are alternates that approximate 147Ω

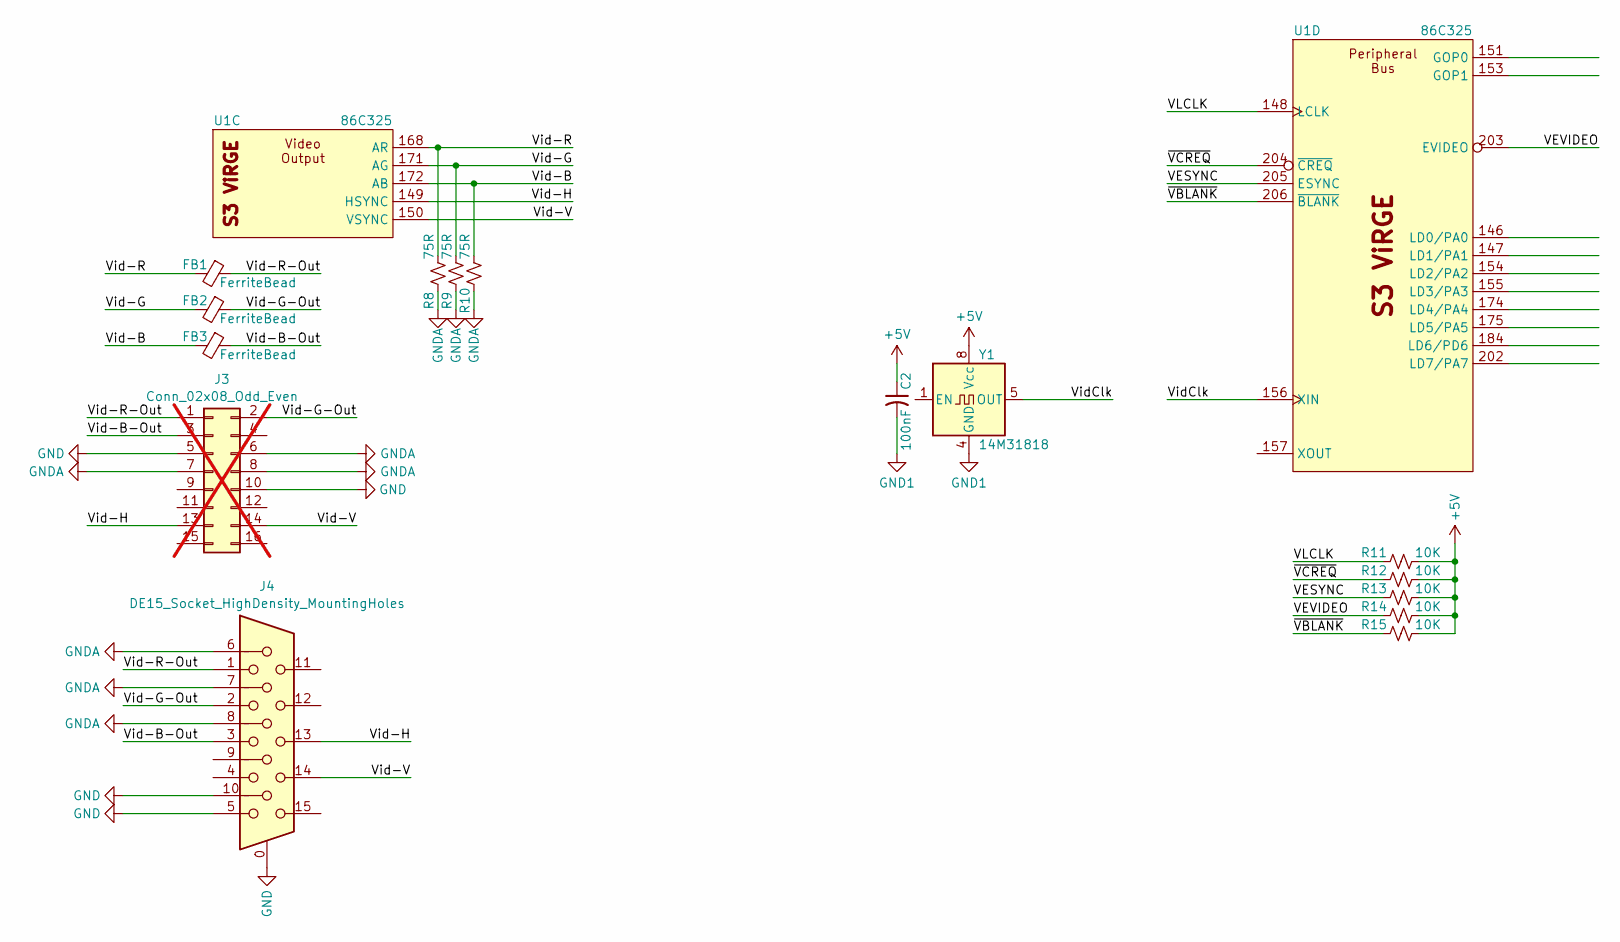
[picture p59: schematic Video.kicad_sch]

Parts:
C2: 100nF; C_0805_2012Metric; Mouser 187-CL21B104KACNNNC
FB1, FB2, FB3: FerriteBead; L_Axial_L5.3mm_D2.2mm_P2.54mm_Vertical_Vishay_IM-1
J3: Conn_02x08_Odd_Even; PinHeader_2x08_P2.54mm_Vertical; not fitted
J4: DE15_Socket_HighDensity_MountingHoles; DE15 (EDAC 634-015); Mouser 587-634-015-263-032
R8, R9, R10: 75R; R_0805_2012Metric; Mouser 603-RC0805FR-1375RL
R11, R12, R13, R14, R15: 10K; R_0805_2012Metric; Mouser 303-0805S8J0103T5E
U1: 86C325; PQFP-208_28x28mm_P0.5mm
Y1: 14M31818; Oscillator_DIP-8

Connections:
+5V: C2.1, R11.2, R12.2, R13.2, R14.2, R15.2, Y1.8 (Vcc); also elsewhere on the board
/Video/VESYNC: R13.1, U1.205 (ESYNC)
/Video/VEVIDEO: R14.1, U1.203 (EVIDEO)
/Video/VLCLK: R11.1, U1.148 (LCLK)
/Video/Vid-B: FB3.2, R10.2, U1.172 (AB)
/Video/Vid-B-Out: FB3.1, J3.3, J4.3
/Video/Vid-G: FB2.2, R9.2, U1.171 (AG)
/Video/Vid-G-Out: FB2.1, J3.2, J4.2
/Video/Vid-H: J3.13, J4.13, U1.149 (HSYNC)
/Video/Vid-R: FB1.2, R8.2, U1.168 (AR)
/Video/Vid-R-Out: FB1.1, J3.1, J4.1
/Video/Vid-V: J3.14, J4.14, U1.150 (VSYNC)
/Video/VidClk: U1.156 (XIN), Y1.5 (OUT)
/Video/~VBLANK: R15.1, U1.206 (~BLANK)
/Video/~VCREQ: R12.1, U1.204 (~CREQ)
GND: J3.5, J3.10, J4.0, J4.5, J4.10; also elsewhere on the board
GND1: C2.2, Y1.4 (GND); also elsewhere on the board
GNDA: J3.6, J3.7, J3.8, J4.6, J4.7, J4.8, R8.1, R9.1, R10.1; also elsewhere on the board

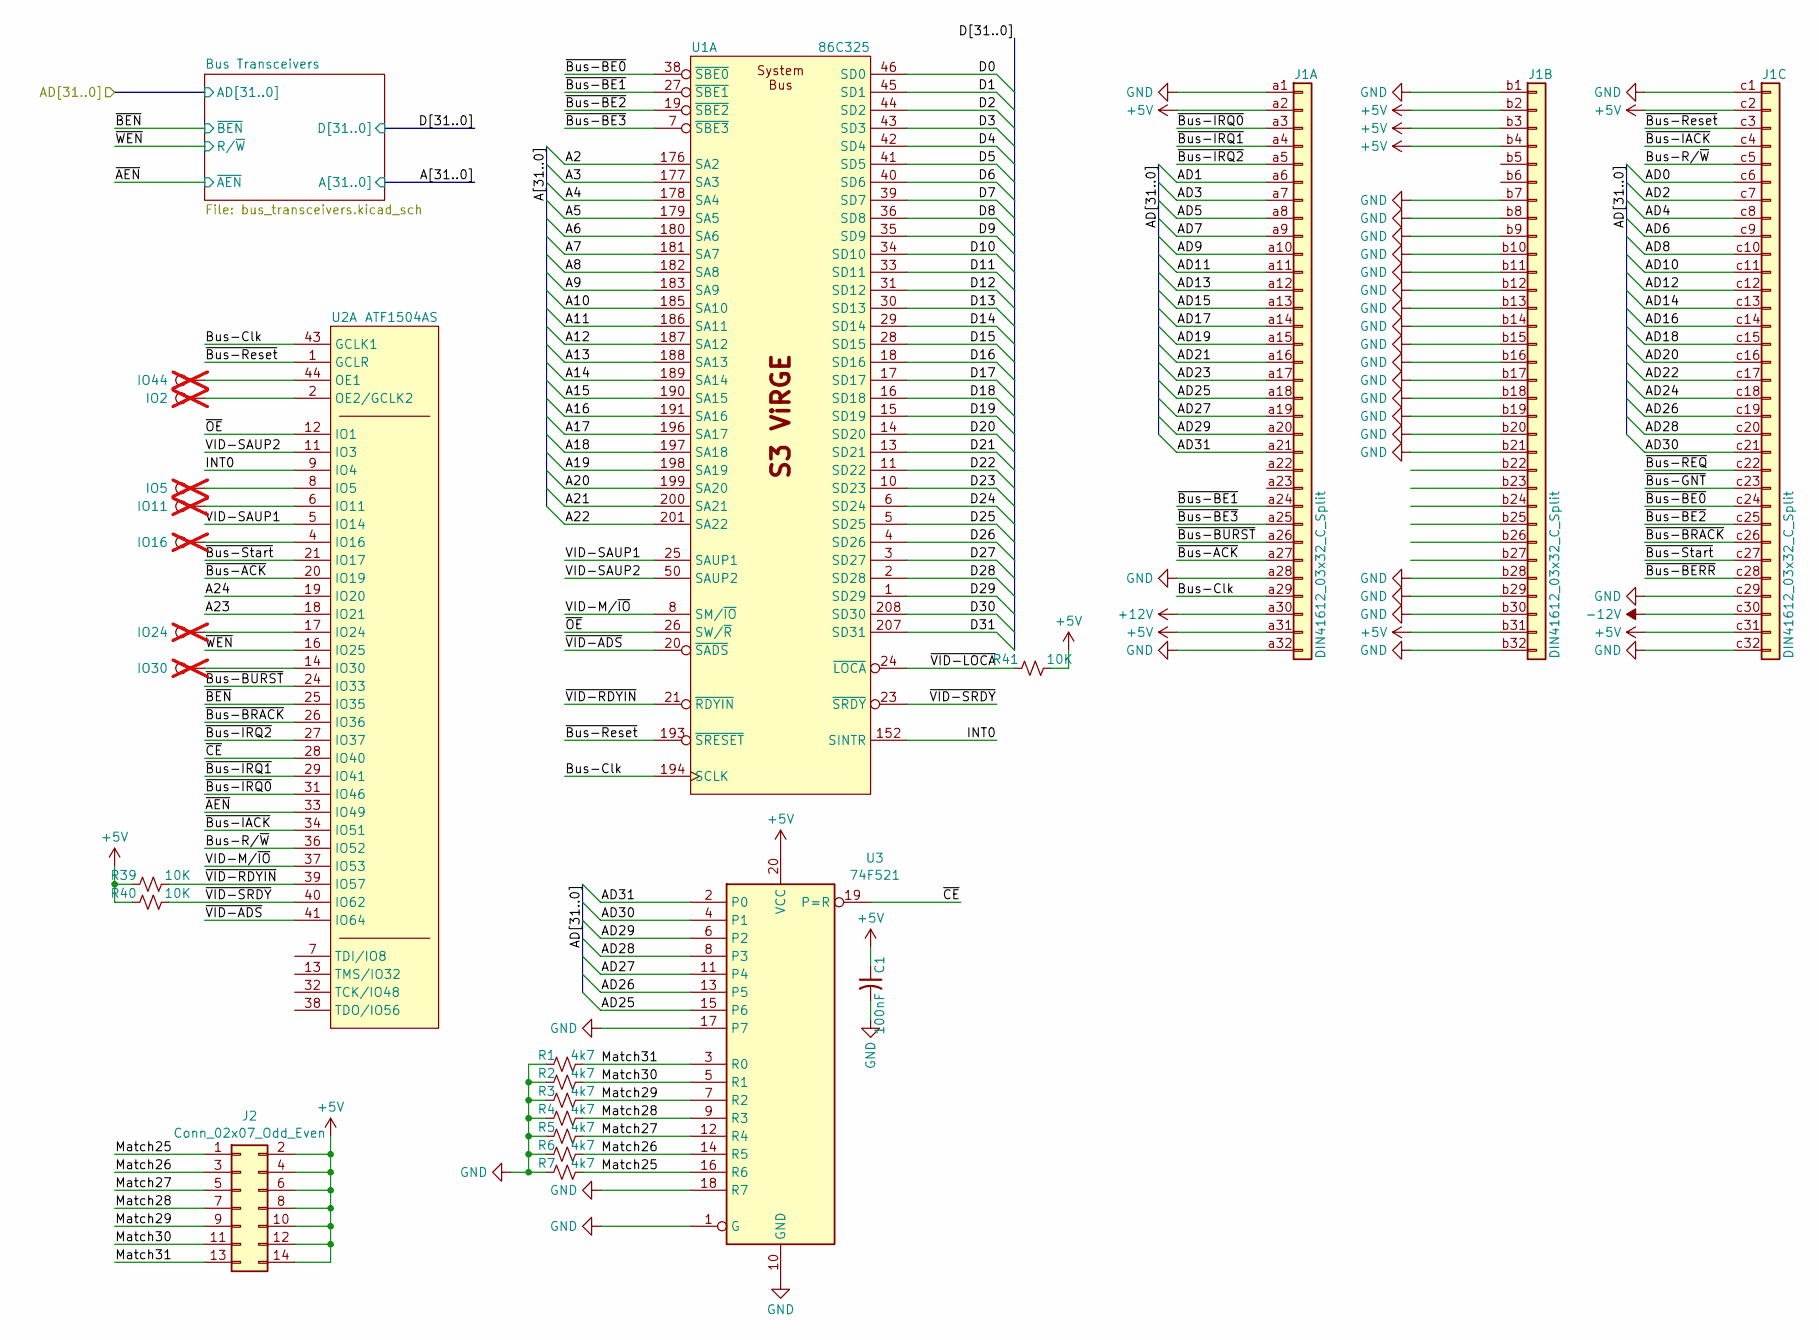
[picture p60: schematic main_bus.kicad_sch]

Parts:
C1: 100nF; C_0805_2012Metric; Mouser 187-CL21B104KACNNNC
IO2, IO5, IO11, IO16, IO24, IO30, IO44: TestPoint; PinHeader_1x01_P2.54mm_Vertical; not fitted
J1: DIN41612_03x32_C_Split; DIN41612_C_3x32_Male_Horizontal_THT
J2: Conn_02x07_Odd_Even; PinHeader_2x07_P2.54mm_Vertical
R1, R2, R3, R4, R5, R6, R7: 4k7; R_0805_2012Metric; Mouser 303-0805W8J0472T5E
R39, R40, R41: 10K; R_0805_2012Metric; Mouser 303-0805S8J0103T5E
U1: 86C325; PQFP-208_28x28mm_P0.5mm
U2: ATF1504AS; PLCC-44_THT-Socket
U3: 74F521; SOIC-20W_7.5x12.8mm_P1.27mm; Mouser 595-SN74F521DWR

Connections:
+5V: C1.1, J1.a2, J1.a31, J1.b2, J1.b3, J1.b4, J1.b31, J1.c2, J1.c31, J2.2, J2.4, J2.6, J2.8, J2.10, J2.12, J2.14, R39.1, R40.1, R41.2, U1.12 (Vdd), U1.37 (Vdd), U3.20 (VCC); also elsewhere on the board
+12V: J1.a30
-12V: J1.c30
/Main Bus/A2: U1.176 (SA2); also elsewhere on the board
/Main Bus/A3: U1.177 (SA3); also elsewhere on the board
/Main Bus/A4: U1.178 (SA4); also elsewhere on the board
/Main Bus/A5: U1.179 (SA5); also elsewhere on the board
/Main Bus/A6: U1.180 (SA6); also elsewhere on the board
/Main Bus/A7: U1.181 (SA7); also elsewhere on the board
/Main Bus/A8: U1.182 (SA8); also elsewhere on the board
/Main Bus/A9: U1.183 (SA9); also elsewhere on the board
/Main Bus/A10: U1.185 (SA10); also elsewhere on the board
/Main Bus/A11: U1.186 (SA11); also elsewhere on the board
/Main Bus/A12: U1.187 (SA12); also elsewhere on the board
/Main Bus/A13: U1.188 (SA13); also elsewhere on the board
/Main Bus/A14: U1.189 (SA14); also elsewhere on the board
/Main Bus/A15: U1.190 (SA15); also elsewhere on the board
/Main Bus/A16: U1.191 (SA16); also elsewhere on the board
/Main Bus/A17: U1.196 (SA17); also elsewhere on the board
/Main Bus/A18: U1.197 (SA18); also elsewhere on the board
/Main Bus/A19: U1.198 (SA19); also elsewhere on the board
/Main Bus/A20: U1.199 (SA20); also elsewhere on the board
/Main Bus/A21: U1.200 (SA21); also elsewhere on the board
/Main Bus/A22: U1.201 (SA22); also elsewhere on the board
/Main Bus/A23: U2.18 (IO21); also elsewhere on the board
/Main Bus/A24: U2.19 (IO20); also elsewhere on the board
/Main Bus/AD0: J1.c6; also elsewhere on the board
/Main Bus/AD1: J1.a6; also elsewhere on the board
/Main Bus/AD2: J1.c7; also elsewhere on the board
/Main Bus/AD3: J1.a7; also elsewhere on the board
/Main Bus/AD4: J1.c8; also elsewhere on the board
/Main Bus/AD5: J1.a8; also elsewhere on the board
/Main Bus/AD6: J1.c9; also elsewhere on the board
/Main Bus/AD7: J1.a9; also elsewhere on the board
/Main Bus/AD8: J1.c10; also elsewhere on the board
/Main Bus/AD9: J1.a10; also elsewhere on the board
/Main Bus/AD10: J1.c11; also elsewhere on the board
/Main Bus/AD11: J1.a11; also elsewhere on the board
/Main Bus/AD12: J1.c12; also elsewhere on the board
/Main Bus/AD13: J1.a12; also elsewhere on the board
/Main Bus/AD14: J1.c13; also elsewhere on the board
/Main Bus/AD15: J1.a13; also elsewhere on the board
/Main Bus/AD16: J1.c14; also elsewhere on the board
/Main Bus/AD17: J1.a14; also elsewhere on the board
/Main Bus/AD18: J1.c15; also elsewhere on the board
/Main Bus/AD19: J1.a15; also elsewhere on the board
/Main Bus/AD20: J1.c16; also elsewhere on the board
/Main Bus/AD21: J1.a16; also elsewhere on the board
/Main Bus/AD22: J1.c17; also elsewhere on the board
/Main Bus/AD23: J1.a17; also elsewhere on the board
/Main Bus/AD24: J1.c18; also elsewhere on the board
/Main Bus/AD25: J1.a18, U3.15 (P6); also elsewhere on the board
/Main Bus/AD26: J1.c19, U3.13 (P5); also elsewhere on the board
/Main Bus/AD27: J1.a19, U3.11 (P4); also elsewhere on the board
/Main Bus/AD28: J1.c20, U3.8 (P3); also elsewhere on the board
/Main Bus/AD29: J1.a20, U3.6 (P2); also elsewhere on the board
/Main Bus/AD30: J1.c21, U3.4 (P1); also elsewhere on the board
/Main Bus/AD31: J1.a21, U3.2 (P0); also elsewhere on the board
/Main Bus/Bus-Clk: J1.a29, U1.194 (SCLK), U2.43 (GCLK1)
/Main Bus/Bus-R/~W: J1.c5, U2.36 (IO52)
/Main Bus/D0: U1.46 (SD0); also elsewhere on the board
/Main Bus/D1: U1.45 (SD1); also elsewhere on the board
/Main Bus/D2: U1.44 (SD2); also elsewhere on the board
/Main Bus/D3: U1.43 (SD3); also elsewhere on the board
/Main Bus/D4: U1.42 (SD4); also elsewhere on the board
/Main Bus/D5: U1.41 (SD5); also elsewhere on the board
/Main Bus/D6: U1.40 (SD6); also elsewhere on the board
/Main Bus/D7: U1.39 (SD7); also elsewhere on the board
/Main Bus/D8: U1.36 (SD8); also elsewhere on the board
/Main Bus/D9: U1.35 (SD9); also elsewhere on the board
/Main Bus/D10: U1.34 (SD10); also elsewhere on the board
/Main Bus/D11: U1.33 (SD11); also elsewhere on the board
/Main Bus/D12: U1.31 (SD12); also elsewhere on the board
/Main Bus/D13: U1.30 (SD13); also elsewhere on the board
/Main Bus/D14: U1.29 (SD14); also elsewhere on the board
/Main Bus/D15: U1.28 (SD15); also elsewhere on the board
/Main Bus/D16: U1.18 (SD16); also elsewhere on the board
/Main Bus/D17: U1.17 (SD17); also elsewhere on the board
/Main Bus/D18: U1.16 (SD18); also elsewhere on the board
/Main Bus/D19: U1.15 (SD19); also elsewhere on the board
/Main Bus/D20: U1.14 (SD20); also elsewhere on the board
/Main Bus/D21: U1.13 (SD21); also elsewhere on the board
/Main Bus/D22: U1.11 (SD22); also elsewhere on the board
/Main Bus/D23: U1.10 (SD23); also elsewhere on the board
/Main Bus/D24: U1.6 (SD24); also elsewhere on the board
/Main Bus/D25: U1.5 (SD25); also elsewhere on the board
/Main Bus/D26: U1.4 (SD26); also elsewhere on the board
/Main Bus/D27: U1.3 (SD27); also elsewhere on the board
/Main Bus/D28: U1.2 (SD28); also elsewhere on the board
/Main Bus/D29: U1.1 (SD29); also elsewhere on the board
/Main Bus/D30: U1.208 (SD30); also elsewhere on the board
/Main Bus/D31: U1.207 (SD31); also elsewhere on the board
/Main Bus/INT0: U1.152 (SINTR), U2.9 (IO4)
/Main Bus/Match25: J2.1, R7.2, U3.16 (R6)
/Main Bus/Match26: J2.3, R6.2, U3.14 (R5)
/Main Bus/Match27: J2.5, R5.2, U3.12 (R4)
/Main Bus/Match28: J2.7, R4.2, U3.9 (R3)
/Main Bus/Match29: J2.9, R3.2, U3.7 (R2)
/Main Bus/Match30: J2.11, R2.2, U3.5 (R1)
/Main Bus/Match31: J2.13, R1.2, U3.3 (R0)
/Main Bus/VID-M/~IO: U1.8 (SM/~IO), U2.37 (IO53)
/Main Bus/VID-SAUP1: U1.25 (SAUP1), U2.5 (IO14)
/Main Bus/VID-SAUP2: U1.50 (SAUP2), U2.11 (IO3)
/Main Bus/~AEN: U2.33 (IO49); also elsewhere on the board
/Main Bus/~BEN: U2.25 (IO35); also elsewhere on the board
/Main Bus/~Bus-ACK: J1.a27, U2.20 (IO19)
/Main Bus/~Bus-BE0: J1.c24, U1.38 (~SBE0)
/Main Bus/~Bus-BE1: J1.a24, U1.27 (~SBE1)
/Main Bus/~Bus-BE2: J1.c25, U1.19 (~SBE2)
/Main Bus/~Bus-BE3: J1.a25, U1.7 (~SBE3)
/Main Bus/~Bus-BERR: J1.c28
/Main Bus/~Bus-BRACK: J1.c26, U2.26 (IO36)
/Main Bus/~Bus-BURST: J1.a26, U2.24 (IO33)
/Main Bus/~Bus-GNT: J1.c23
/Main Bus/~Bus-IACK: J1.c4, U2.34 (IO51)
/Main Bus/~Bus-IRQ0: J1.a3, U2.31 (IO46)
/Main Bus/~Bus-IRQ1: J1.a4, U2.29 (IO41)
/Main Bus/~Bus-IRQ2: J1.a5, U2.27 (IO37)
/Main Bus/~Bus-REQ: J1.c22
/Main Bus/~Bus-Reset: J1.c3, U1.193 (~SRESET), U2.1 (GCLR)
/Main Bus/~Bus-Start: J1.c27, U2.21 (IO17)
/Main Bus/~CE: U2.28 (IO40), U3.19 (P=R)
/Main Bus/~OE: U1.26 (SW/~R), U2.12 (IO1)
/Main Bus/~VID-ADS: U1.20 (~SADS), U2.41 (IO64)
/Main Bus/~VID-LOCA: R41.1, U1.24 (~LOCA)
/Main Bus/~VID-RDYIN: R39.2, U1.21 (~RDYIN), U2.39 (IO57)
/Main Bus/~VID-SRDY: R40.2, U1.23 (~SRDY), U2.40 (IO62)
/Main Bus/~WEN: U2.16 (IO25); also elsewhere on the board
GND: C1.2, J1.a1, J1.a28, J1.a32, J1.b1, J1.b7, J1.b8, J1.b9, J1.b10, J1.b11, J1.b12, J1.b13, J1.b14, J1.b15, J1.b16, J1.b17, J1.b18, J1.b19, J1.b20, J1.b21, J1.b28, J1.b29, J1.b30, J1.b32, J1.c1, J1.c29, J1.c32, R1.1, R2.1, R3.1, R4.1, R5.1, R6.1, R7.1, U1.9 (Vss), U1.32 (Vss), U3.1 (G), U3.10 (GND), U3.17 (P7), U3.18 (R7); also elsewhere on the board
unnamed: IO5.1, U2.8 (IO5)
unnamed: IO11.1, U2.6 (IO11)
unnamed: IO16.1, U2.4 (IO16)
unnamed: IO24.1, U2.17 (IO24)
unnamed: IO30.1, U2.14 (IO30)
unnamed: IO44.1, U2.44 (OE1)
unnamed: IO2.1, U2.2 (OE2/GCLK2)

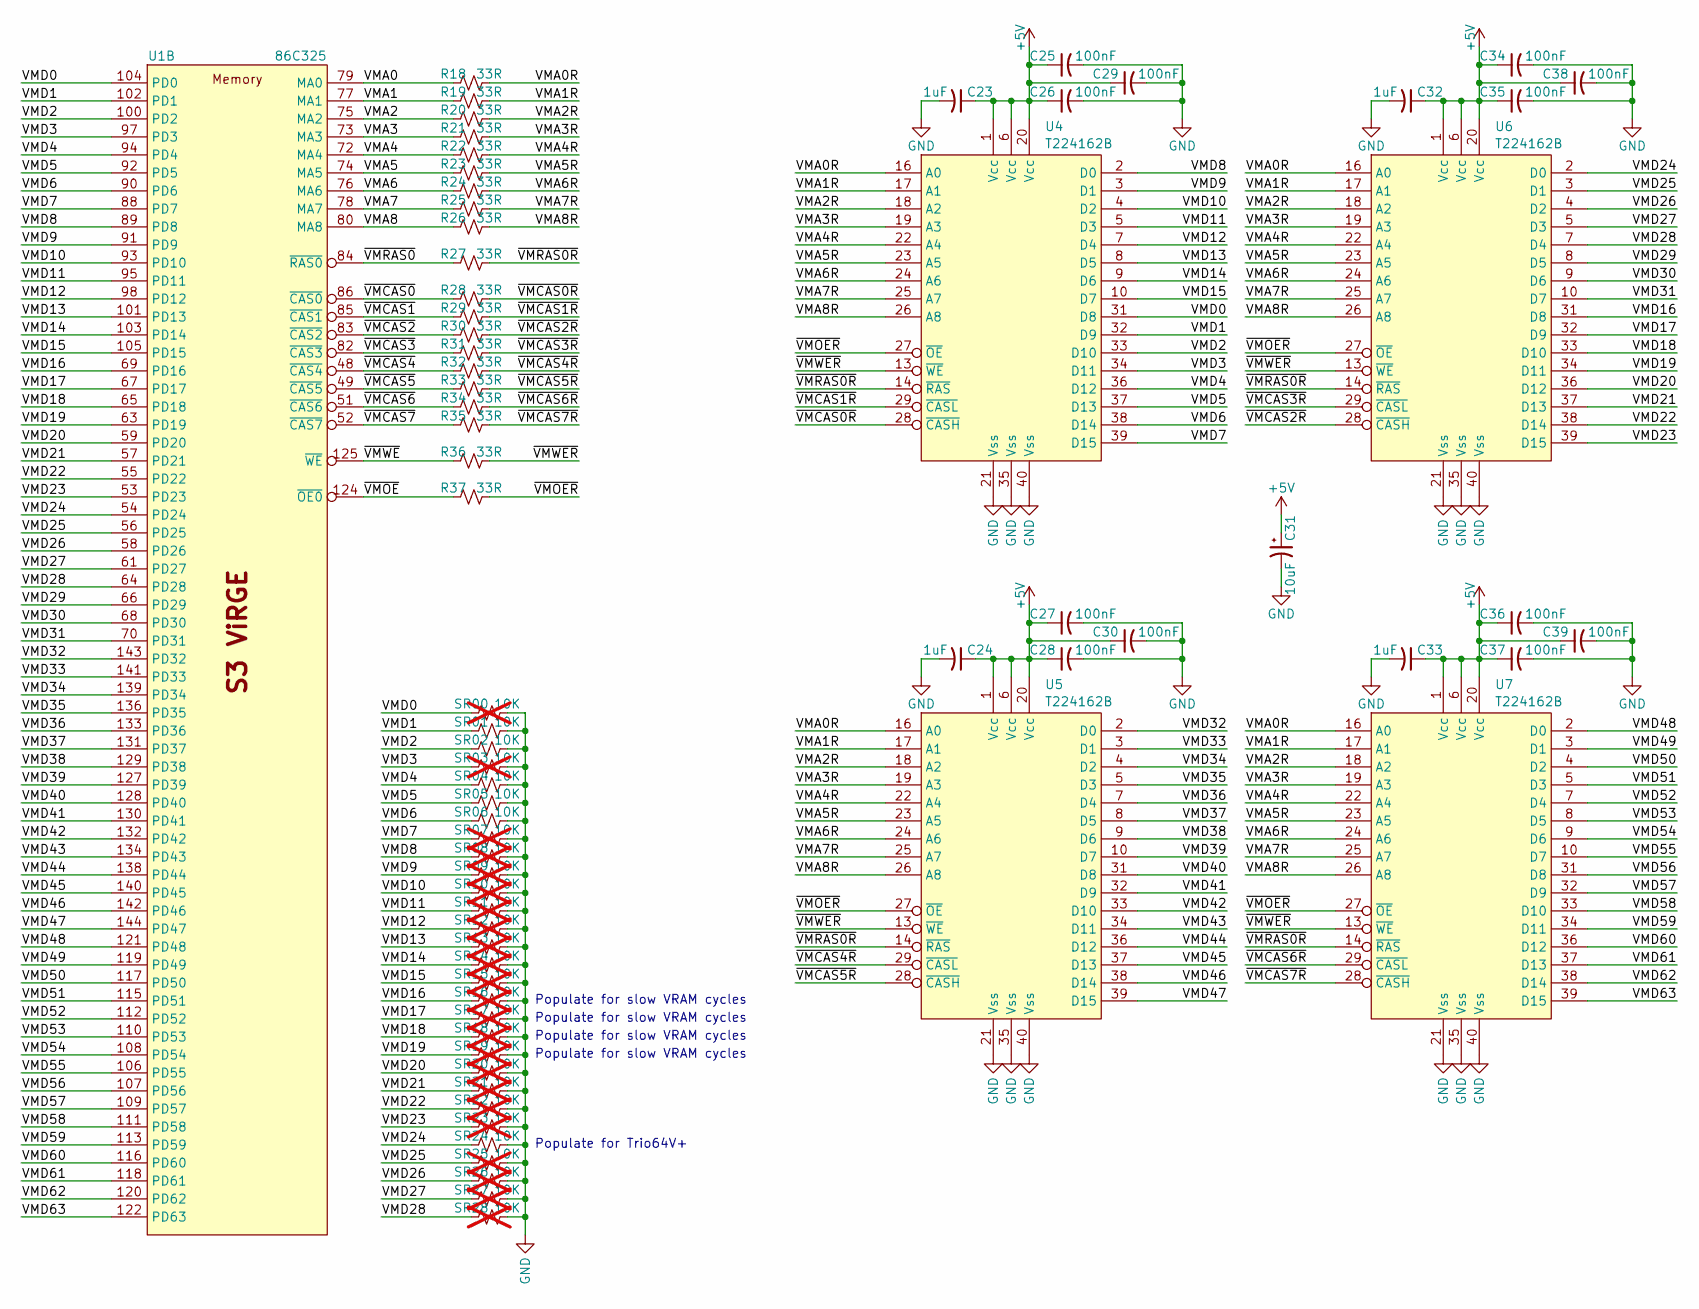
[picture p61: schematic vram.kicad_sch]

Parts:
C23, C24, C32, C33: 1uF; C_0805_2012Metric; Mouser 187-CL21B105KOFNNNG
C25, C26, C27, C28, C29, C30, C34, C35, C36, C37, C38, C39: 100nF; C_0805_2012Metric; Mouser 187-CL21B104KACNNNC
C31: 10uF; CP_Elec_4x5.7; Mouser 80-EDK106M016A9BAA
R18, R19, R20, R21, R22, R23, R24, R25, R26, R27, R28, R29, R30, R31, R32, R33, R34, R35, R36, R37: 33R; R_0805_2012Metric; Mouser 603-RC0805JR-1033RL
SR00, SR03, SR07, SR08, SR09, SR10, SR11, SR12, SR13, SR14, SR15, SR16, SR17, SR18, SR19, SR20, SR21, SR22, SR23, SR25, SR26, SR27, SR28: 10K; R_0805_2012Metric; Mouser 303-0805S8J0103T5E; not fitted
SR01, SR02, SR04, SR05, SR06, SR24: 10K; R_0805_2012Metric; Mouser 303-0805S8J0103T5E
U1: 86C325; PQFP-208_28x28mm_P0.5mm
U4, U5, U6, U7: T224162B; SOJ-44_10.16x28.575mm_P1.27mm

Connections:
+5V: C23.1, C24.1, C25.1, C26.1, C27.1, C28.1, C29.1, C30.1, C31.1, C32.1, C33.1, C34.1, C35.1, C36.1, C37.1, C38.1, C39.1, U4.1 (Vcc), U4.6 (Vcc), U4.20 (Vcc), U5.1 (Vcc), U5.6 (Vcc), U5.20 (Vcc), U6.1 (Vcc), U6.6 (Vcc), U6.20 (Vcc), U7.1 (Vcc), U7.6 (Vcc), U7.20 (Vcc); also elsewhere on the board
/VRAM/VMA0: R18.1, U1.79 (MA0)
/VRAM/VMA0R: R18.2, U4.16 (A0), U5.16 (A0), U6.16 (A0), U7.16 (A0)
/VRAM/VMA1: R19.1, U1.77 (MA1)
/VRAM/VMA1R: R19.2, U4.17 (A1), U5.17 (A1), U6.17 (A1), U7.17 (A1)
/VRAM/VMA2: R20.1, U1.75 (MA2)
/VRAM/VMA2R: R20.2, U4.18 (A2), U5.18 (A2), U6.18 (A2), U7.18 (A2)
/VRAM/VMA3: R21.1, U1.73 (MA3)
/VRAM/VMA3R: R21.2, U4.19 (A3), U5.19 (A3), U6.19 (A3), U7.19 (A3)
/VRAM/VMA4: R22.1, U1.72 (MA4)
/VRAM/VMA4R: R22.2, U4.22 (A4), U5.22 (A4), U6.22 (A4), U7.22 (A4)
/VRAM/VMA5: R23.1, U1.74 (MA5)
/VRAM/VMA5R: R23.2, U4.23 (A5), U5.23 (A5), U6.23 (A5), U7.23 (A5)
/VRAM/VMA6: R24.1, U1.76 (MA6)
/VRAM/VMA6R: R24.2, U4.24 (A6), U5.24 (A6), U6.24 (A6), U7.24 (A6)
/VRAM/VMA7: R25.1, U1.78 (MA7)
/VRAM/VMA7R: R25.2, U4.25 (A7), U5.25 (A7), U6.25 (A7), U7.25 (A7)
/VRAM/VMA8: R26.1, U1.80 (MA8)
/VRAM/VMA8R: R26.2, U4.26 (A8), U5.26 (A8), U6.26 (A8), U7.26 (A8)
/VRAM/VMD0: SR00.1, U1.104 (PD0), U4.31 (D8)
/VRAM/VMD1: SR01.1, U1.102 (PD1), U4.32 (D9)
/VRAM/VMD2: SR02.1, U1.100 (PD2), U4.33 (D10)
/VRAM/VMD3: SR03.1, U1.97 (PD3), U4.34 (D11)
/VRAM/VMD4: SR04.1, U1.94 (PD4), U4.36 (D12)
/VRAM/VMD5: SR05.1, U1.92 (PD5), U4.37 (D13)
/VRAM/VMD6: SR06.1, U1.90 (PD6), U4.38 (D14)
/VRAM/VMD7: SR07.1, U1.88 (PD7), U4.39 (D15)
/VRAM/VMD8: SR08.1, U1.89 (PD8), U4.2 (D0)
/VRAM/VMD9: SR09.1, U1.91 (PD9), U4.3 (D1)
/VRAM/VMD10: SR10.1, U1.93 (PD10), U4.4 (D2)
/VRAM/VMD11: SR11.1, U1.95 (PD11), U4.5 (D3)
/VRAM/VMD12: SR12.1, U1.98 (PD12), U4.7 (D4)
/VRAM/VMD13: SR13.1, U1.101 (PD13), U4.8 (D5)
/VRAM/VMD14: SR14.1, U1.103 (PD14), U4.9 (D6)
/VRAM/VMD15: SR15.1, U1.105 (PD15), U4.10 (D7)
/VRAM/VMD16: SR16.1, U1.69 (PD16), U6.31 (D8)
/VRAM/VMD17: SR17.1, U1.67 (PD17), U6.32 (D9)
/VRAM/VMD18: SR18.1, U1.65 (PD18), U6.33 (D10)
/VRAM/VMD19: SR19.1, U1.63 (PD19), U6.34 (D11)
/VRAM/VMD20: SR20.1, U1.59 (PD20), U6.36 (D12)
/VRAM/VMD21: SR21.1, U1.57 (PD21), U6.37 (D13)
/VRAM/VMD22: SR22.1, U1.55 (PD22), U6.38 (D14)
/VRAM/VMD23: SR23.1, U1.53 (PD23), U6.39 (D15)
/VRAM/VMD24: SR24.1, U1.54 (PD24), U6.2 (D0)
/VRAM/VMD25: SR25.1, U1.56 (PD25), U6.3 (D1)
/VRAM/VMD26: SR26.1, U1.58 (PD26), U6.4 (D2)
/VRAM/VMD27: SR27.1, U1.61 (PD27), U6.5 (D3)
/VRAM/VMD28: SR28.1, U1.64 (PD28), U6.7 (D4)
/VRAM/VMD29: U1.66 (PD29), U6.8 (D5)
/VRAM/VMD30: U1.68 (PD30), U6.9 (D6)
/VRAM/VMD31: U1.70 (PD31), U6.10 (D7)
/VRAM/VMD32: U1.143 (PD32), U5.2 (D0)
/VRAM/VMD33: U1.141 (PD33), U5.3 (D1)
/VRAM/VMD34: U1.139 (PD34), U5.4 (D2)
/VRAM/VMD35: U1.136 (PD35), U5.5 (D3)
/VRAM/VMD36: U1.133 (PD36), U5.7 (D4)
/VRAM/VMD37: U1.131 (PD37), U5.8 (D5)
/VRAM/VMD38: U1.129 (PD38), U5.9 (D6)
/VRAM/VMD39: U1.127 (PD39), U5.10 (D7)
/VRAM/VMD40: U1.128 (PD40), U5.31 (D8)
/VRAM/VMD41: U1.130 (PD41), U5.32 (D9)
/VRAM/VMD42: U1.132 (PD42), U5.33 (D10)
/VRAM/VMD43: U1.134 (PD43), U5.34 (D11)
/VRAM/VMD44: U1.138 (PD44), U5.36 (D12)
/VRAM/VMD45: U1.140 (PD45), U5.37 (D13)
/VRAM/VMD46: U1.142 (PD46), U5.38 (D14)
/VRAM/VMD47: U1.144 (PD47), U5.39 (D15)
/VRAM/VMD48: U1.121 (PD48), U7.2 (D0)
/VRAM/VMD49: U1.119 (PD49), U7.3 (D1)
/VRAM/VMD50: U1.117 (PD50), U7.4 (D2)
/VRAM/VMD51: U1.115 (PD51), U7.5 (D3)
/VRAM/VMD52: U1.112 (PD52), U7.7 (D4)
/VRAM/VMD53: U1.110 (PD53), U7.8 (D5)
/VRAM/VMD54: U1.108 (PD54), U7.9 (D6)
/VRAM/VMD55: U1.106 (PD55), U7.10 (D7)
/VRAM/VMD56: U1.107 (PD56), U7.31 (D8)
/VRAM/VMD57: U1.109 (PD57), U7.32 (D9)
/VRAM/VMD58: U1.111 (PD58), U7.33 (D10)
/VRAM/VMD59: U1.113 (PD59), U7.34 (D11)
/VRAM/VMD60: U1.116 (PD60), U7.36 (D12)
/VRAM/VMD61: U1.118 (PD61), U7.37 (D13)
/VRAM/VMD62: U1.120 (PD62), U7.38 (D14)
/VRAM/VMD63: U1.122 (PD63), U7.39 (D15)
/VRAM/~VMCAS0R: R28.2, U4.28 (~CASH)
/VRAM/~VMCAS0: R28.1, U1.86 (~CAS0)
/VRAM/~VMCAS1R: R29.2, U4.29 (~CASL)
/VRAM/~VMCAS1: R29.1, U1.85 (~CAS1)
/VRAM/~VMCAS2R: R30.2, U6.28 (~CASH)
/VRAM/~VMCAS2: R30.1, U1.83 (~CAS2)
/VRAM/~VMCAS3R: R31.2, U6.29 (~CASL)
/VRAM/~VMCAS3: R31.1, U1.82 (~CAS3)
/VRAM/~VMCAS4R: R32.2, U5.29 (~CASL)
/VRAM/~VMCAS4: R32.1, U1.48 (~CAS4)
/VRAM/~VMCAS5R: R33.2, U5.28 (~CASH)
/VRAM/~VMCAS5: R33.1, U1.49 (~CAS5)
/VRAM/~VMCAS6R: R34.2, U7.29 (~CASL)
/VRAM/~VMCAS6: R34.1, U1.51 (~CAS6)
/VRAM/~VMCAS7R: R35.2, U7.28 (~CASH)
/VRAM/~VMCAS7: R35.1, U1.52 (~CAS7)
/VRAM/~VMOER: R37.2, U4.27 (~OE), U5.27 (~OE), U6.27 (~OE), U7.27 (~OE)
/VRAM/~VMOE: R37.1, U1.124 (~OE0)
/VRAM/~VMRAS0R: R27.2, U4.14 (~RAS), U5.14 (~RAS), U6.14 (~RAS), U7.14 (~RAS)
/VRAM/~VMRAS0: R27.1, U1.84 (~RAS0)
/VRAM/~VMWER: R36.2, U4.13 (~WE), U5.13 (~WE), U6.13 (~WE), U7.13 (~WE)
/VRAM/~VMWE: R36.1, U1.125 (~WE)
GND: C23.2, C24.2, C25.2, C26.2, C27.2, C28.2, C29.2, C30.2, C31.2, C32.2, C33.2, C34.2, C35.2, C36.2, C37.2, C38.2, C39.2, SR00.2, SR01.2, SR02.2, SR03.2, SR04.2, SR05.2, SR06.2, SR07.2, SR08.2, SR09.2, SR10.2, SR11.2, SR12.2, SR13.2, SR14.2, SR15.2, SR16.2, SR17.2, SR18.2, SR19.2, SR20.2, SR21.2, SR22.2, SR23.2, SR24.2, SR25.2, SR26.2, SR27.2, SR28.2, U4.21 (Vss), U4.35 (Vss), U4.40 (Vss), U5.21 (Vss), U5.35 (Vss), U5.40 (Vss), U6.21 (Vss), U6.35 (Vss), U6.40 (Vss), U7.21 (Vss), U7.35 (Vss), U7.40 (Vss); also elsewhere on the board

Notes on the sheet:
Populate for slow VRAM cycles
Populate for Trio64V+
