techav-homebrew/PikaPC/Hardware/PikaPC_ViRGE/PikaPC_ViRGE.kicad_pcb

## KiCad design Hardware/PikaPC_ViRGE/PikaPC_ViRGE.kicad_pcb (continued)

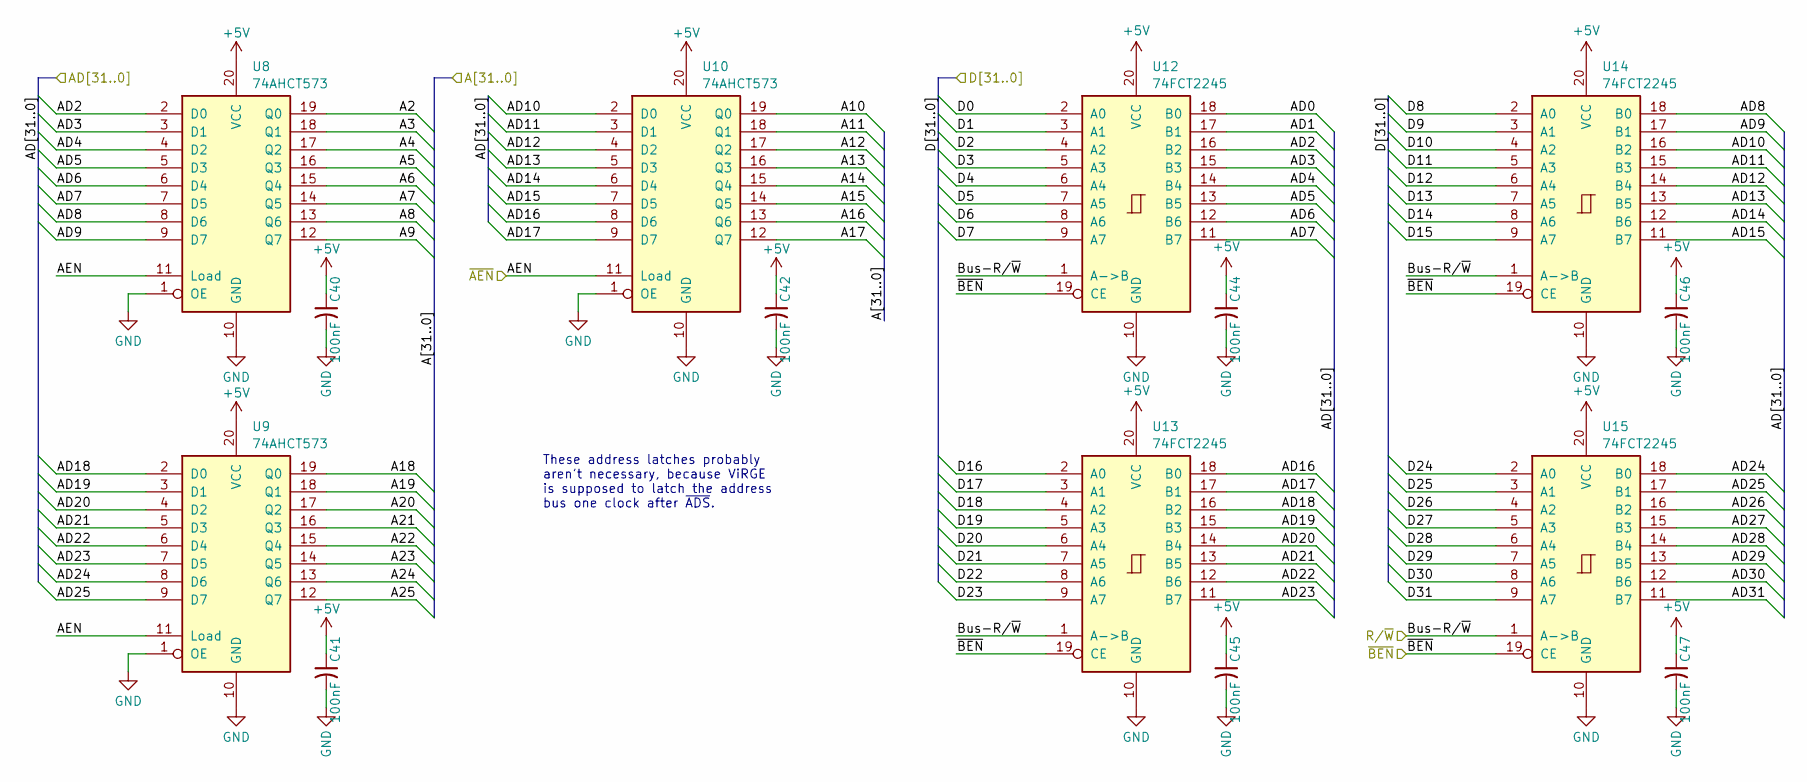
[picture p62: schematic bus_transceivers.kicad_sch]

Parts:
C40, C41, C42, C44, C45, C46, C47: 100nF; C_0805_2012Metric; Mouser 187-CL21B104KACNNNC
U8, U9, U10: 74AHCT573; TSSOP-20_4.4x6.5mm_P0.65mm; Mouser 771-74AHCT573PW-T
U12, U13, U14, U15: 74FCT2245; SOIC-20W_7.5x12.8mm_P1.27mm; Mouser 595-CY74FCT2245TSOCT

Connections:
+5V: C40.1, C41.1, C42.1, C44.1, C45.1, C46.1, C47.1, U8.20 (VCC), U9.20 (VCC), U10.20 (VCC), U12.20 (VCC), U13.20 (VCC), U14.20 (VCC), U15.20 (VCC); also elsewhere on the board
/Main Bus/A2: U8.19 (Q0); also elsewhere on the board
/Main Bus/A3: U8.18 (Q1); also elsewhere on the board
/Main Bus/A4: U8.17 (Q2); also elsewhere on the board
/Main Bus/A5: U8.16 (Q3); also elsewhere on the board
/Main Bus/A6: U8.15 (Q4); also elsewhere on the board
/Main Bus/A7: U8.14 (Q5); also elsewhere on the board
/Main Bus/A8: U8.13 (Q6); also elsewhere on the board
/Main Bus/A9: U8.12 (Q7); also elsewhere on the board
/Main Bus/A10: U10.19 (Q0); also elsewhere on the board
/Main Bus/A11: U10.18 (Q1); also elsewhere on the board
/Main Bus/A12: U10.17 (Q2); also elsewhere on the board
/Main Bus/A13: U10.16 (Q3); also elsewhere on the board
/Main Bus/A14: U10.15 (Q4); also elsewhere on the board
/Main Bus/A15: U10.14 (Q5); also elsewhere on the board
/Main Bus/A16: U10.13 (Q6); also elsewhere on the board
/Main Bus/A17: U10.12 (Q7); also elsewhere on the board
/Main Bus/A18: U9.19 (Q0); also elsewhere on the board
/Main Bus/A19: U9.18 (Q1); also elsewhere on the board
/Main Bus/A20: U9.17 (Q2); also elsewhere on the board
/Main Bus/A21: U9.16 (Q3); also elsewhere on the board
/Main Bus/A22: U9.15 (Q4); also elsewhere on the board
/Main Bus/A23: U9.14 (Q5); also elsewhere on the board
/Main Bus/A24: U9.13 (Q6); also elsewhere on the board
/Main Bus/A25: U9.12 (Q7)
/Main Bus/AD0: U12.18 (B0); also elsewhere on the board
/Main Bus/AD1: U12.17 (B1); also elsewhere on the board
/Main Bus/AD2: U8.2 (D0), U12.16 (B2); also elsewhere on the board
/Main Bus/AD3: U8.3 (D1), U12.15 (B3); also elsewhere on the board
/Main Bus/AD4: U8.4 (D2), U12.14 (B4); also elsewhere on the board
/Main Bus/AD5: U8.5 (D3), U12.13 (B5); also elsewhere on the board
/Main Bus/AD6: U8.6 (D4), U12.12 (B6); also elsewhere on the board
/Main Bus/AD7: U8.7 (D5), U12.11 (B7); also elsewhere on the board
/Main Bus/AD8: U8.8 (D6), U14.18 (B0); also elsewhere on the board
/Main Bus/AD9: U8.9 (D7), U14.17 (B1); also elsewhere on the board
/Main Bus/AD10: U10.2 (D0), U14.16 (B2); also elsewhere on the board
/Main Bus/AD11: U10.3 (D1), U14.15 (B3); also elsewhere on the board
/Main Bus/AD12: U10.4 (D2), U14.14 (B4); also elsewhere on the board
/Main Bus/AD13: U10.5 (D3), U14.13 (B5); also elsewhere on the board
/Main Bus/AD14: U10.6 (D4), U14.12 (B6); also elsewhere on the board
/Main Bus/AD15: U10.7 (D5), U14.11 (B7); also elsewhere on the board
/Main Bus/AD16: U10.8 (D6), U13.18 (B0); also elsewhere on the board
/Main Bus/AD17: U10.9 (D7), U13.17 (B1); also elsewhere on the board
/Main Bus/AD18: U9.2 (D0), U13.16 (B2); also elsewhere on the board
/Main Bus/AD19: U9.3 (D1), U13.15 (B3); also elsewhere on the board
/Main Bus/AD20: U9.4 (D2), U13.14 (B4); also elsewhere on the board
/Main Bus/AD21: U9.5 (D3), U13.13 (B5); also elsewhere on the board
/Main Bus/AD22: U9.6 (D4), U13.12 (B6); also elsewhere on the board
/Main Bus/AD23: U9.7 (D5), U13.11 (B7); also elsewhere on the board
/Main Bus/AD24: U9.8 (D6), U15.18 (B0); also elsewhere on the board
/Main Bus/AD25: U9.9 (D7), U15.17 (B1); also elsewhere on the board
/Main Bus/AD26: U15.16 (B2); also elsewhere on the board
/Main Bus/AD27: U15.15 (B3); also elsewhere on the board
/Main Bus/AD28: U15.14 (B4); also elsewhere on the board
/Main Bus/AD29: U15.13 (B5); also elsewhere on the board
/Main Bus/AD30: U15.12 (B6); also elsewhere on the board
/Main Bus/AD31: U15.11 (B7); also elsewhere on the board
/Main Bus/D0: U12.2 (A0); also elsewhere on the board
/Main Bus/D1: U12.3 (A1); also elsewhere on the board
/Main Bus/D2: U12.4 (A2); also elsewhere on the board
/Main Bus/D3: U12.5 (A3); also elsewhere on the board
/Main Bus/D4: U12.6 (A4); also elsewhere on the board
/Main Bus/D5: U12.7 (A5); also elsewhere on the board
/Main Bus/D6: U12.8 (A6); also elsewhere on the board
/Main Bus/D7: U12.9 (A7); also elsewhere on the board
/Main Bus/D8: U14.2 (A0); also elsewhere on the board
/Main Bus/D9: U14.3 (A1); also elsewhere on the board
/Main Bus/D10: U14.4 (A2); also elsewhere on the board
/Main Bus/D11: U14.5 (A3); also elsewhere on the board
/Main Bus/D12: U14.6 (A4); also elsewhere on the board
/Main Bus/D13: U14.7 (A5); also elsewhere on the board
/Main Bus/D14: U14.8 (A6); also elsewhere on the board
/Main Bus/D15: U14.9 (A7); also elsewhere on the board
/Main Bus/D16: U13.2 (A0); also elsewhere on the board
/Main Bus/D17: U13.3 (A1); also elsewhere on the board
/Main Bus/D18: U13.4 (A2); also elsewhere on the board
/Main Bus/D19: U13.5 (A3); also elsewhere on the board
/Main Bus/D20: U13.6 (A4); also elsewhere on the board
/Main Bus/D21: U13.7 (A5); also elsewhere on the board
/Main Bus/D22: U13.8 (A6); also elsewhere on the board
/Main Bus/D23: U13.9 (A7); also elsewhere on the board
/Main Bus/D24: U15.2 (A0); also elsewhere on the board
/Main Bus/D25: U15.3 (A1); also elsewhere on the board
/Main Bus/D26: U15.4 (A2); also elsewhere on the board
/Main Bus/D27: U15.5 (A3); also elsewhere on the board
/Main Bus/D28: U15.6 (A4); also elsewhere on the board
/Main Bus/D29: U15.7 (A5); also elsewhere on the board
/Main Bus/D30: U15.8 (A6); also elsewhere on the board
/Main Bus/D31: U15.9 (A7); also elsewhere on the board
/Main Bus/~AEN: U8.11 (Load), U9.11 (Load), U10.11 (Load); also elsewhere on the board
/Main Bus/~BEN: U12.19 (CE), U13.19 (CE), U14.19 (CE), U15.19 (CE); also elsewhere on the board
/Main Bus/~WEN: U12.1 (A->B), U13.1 (A->B), U14.1 (A->B), U15.1 (A->B); also elsewhere on the board
GND: C40.2, C41.2, C42.2, C44.2, C45.2, C46.2, C47.2, U8.1 (OE), U8.10 (GND), U9.1 (OE), U9.10 (GND), U10.1 (OE), U10.10 (GND), U12.10 (GND), U13.10 (GND), U14.10 (GND), U15.10 (GND); also elsewhere on the board

Notes on the sheet:
These address latches probably aren't necessary, because ViRGE is supposed to latch the address bus one clock after ~{ADS}.

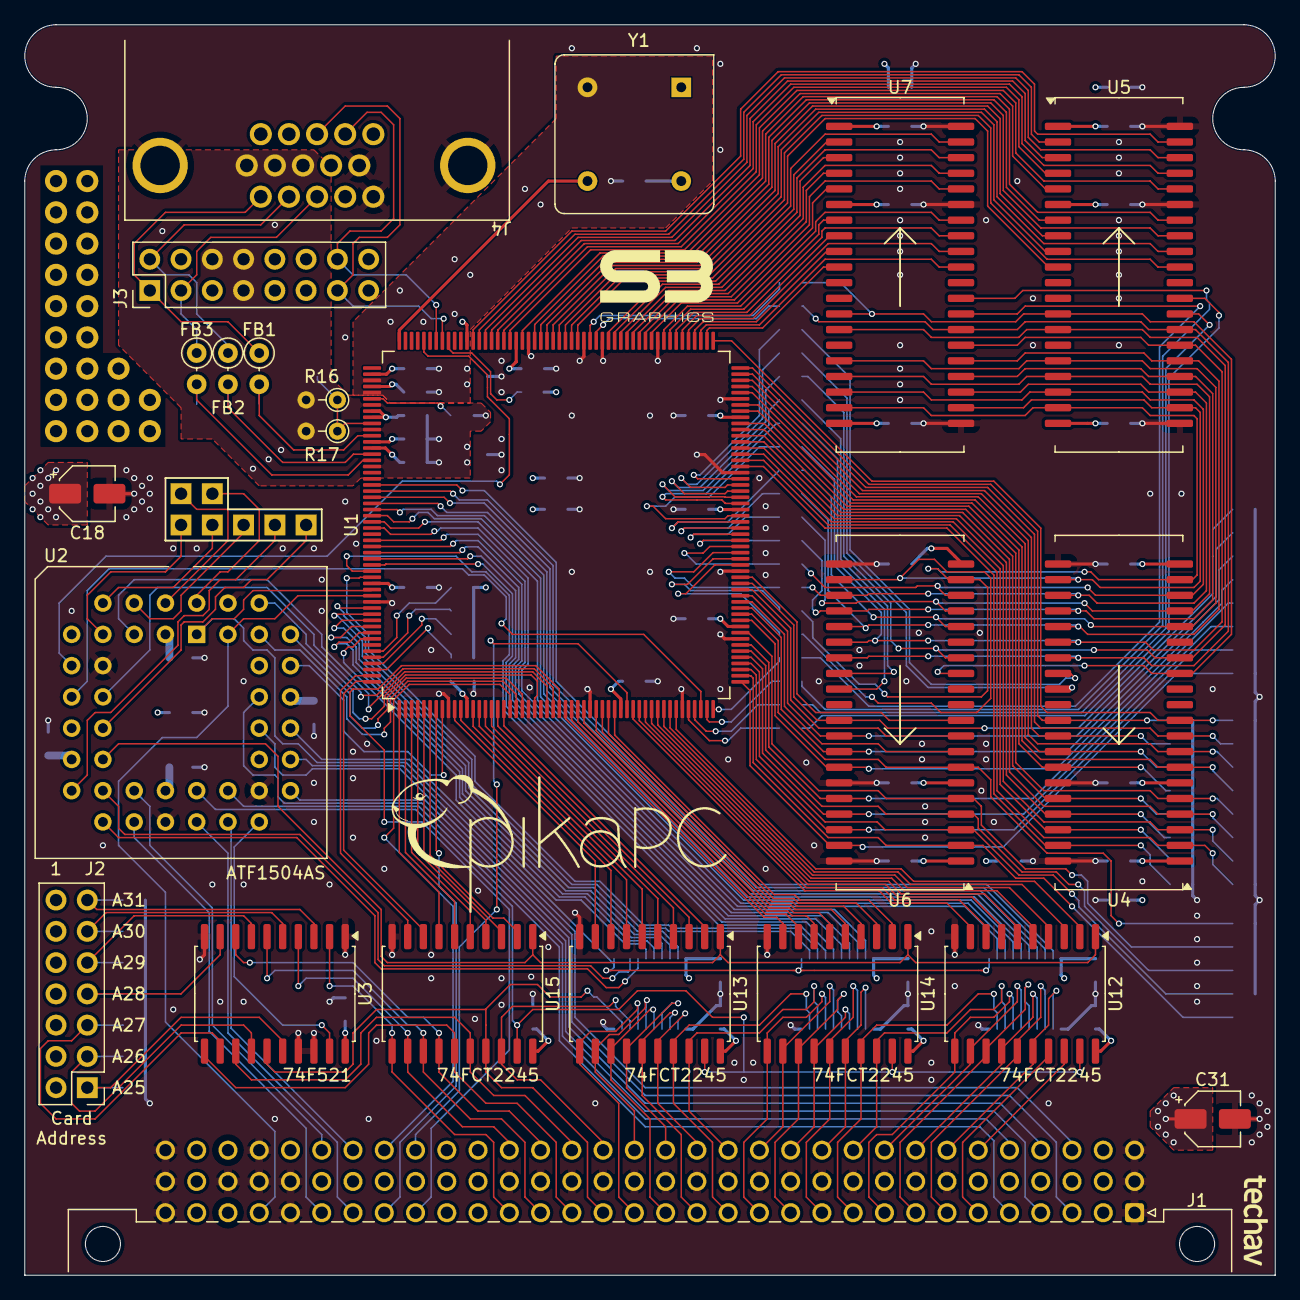
[picture p63: board PikaPC_ViRGE.kicad_pcb from above]

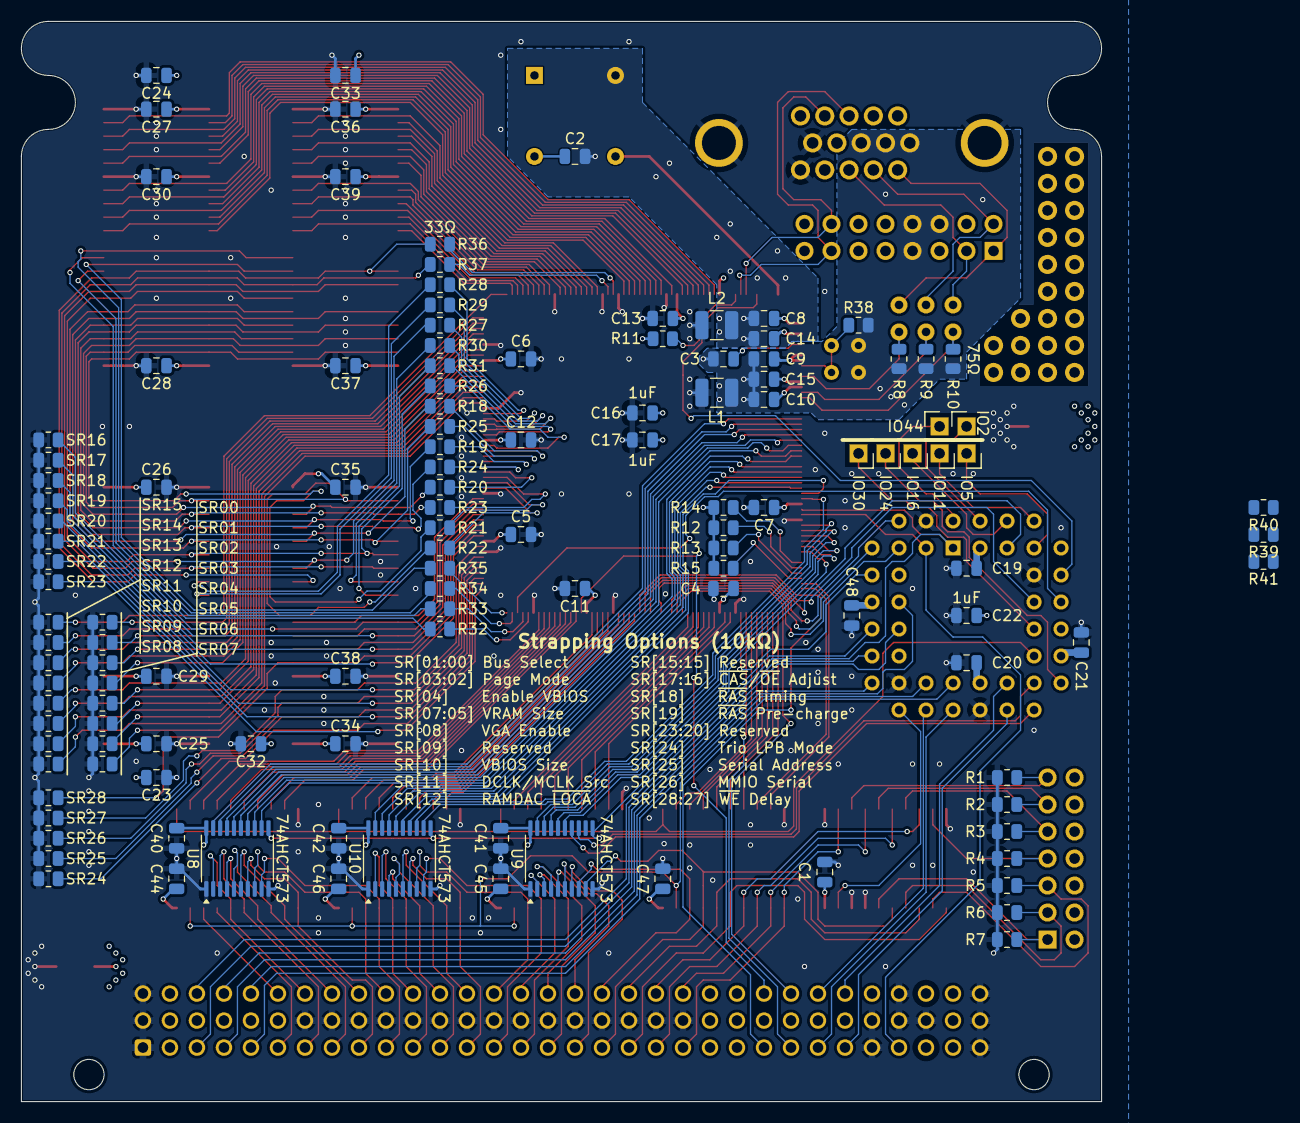
[picture p64: board PikaPC_ViRGE.kicad_pcb from below]

Board: 4 copper layers, 101.6 x 101.6 mm, 148 parts (125 on the bottom side), 253 nets.
