techav-homebrew/PikaPC/(commit log)

2025-10-05 Initial schematic draft
    [PikaPC_Mainboard.kicad_pcb, PikaPC_Mainboard.kicad_sch]
2025-10-05 Change from 72-pin SIMM to SRAM
    [PikaPC_Mainboard.kicad_pcb, PikaPC_Mainboard.kicad_sch]
2025-10-06 initial compile for 403ga
    - change target CPU
    - add conditions for dictionary keywords relying on features no present on 403ga
    - fix incorrectly-formatted comment in local.inc that was preventing successful compile
    - add windows powershell compile script
    - add compiler output files to gitignore
2025-10-08 Rename write strobes
    [PikaPC_Mainboard.kicad_pcb, PikaPC_Mainboard.kicad_sch]
2025-10-13 Add condition for LED I/O not present on 403ga
2025-10-13 use 5V signalling for Rx & CTS
    [PikaPC_Mainboard.kicad_pcb, PikaPC_Mainboard.kicad_sch]
2025-10-18 Format documentation for printing
2025-10-30 Add 8042 PS/2 Keyboard/Mouse controller
    [PikaPC_Mainboard.kicad_sch]
2025-10-31 Keyboard/Mouse controller use '04/'07
    - use tried & true 7404+7407 instead of discrete transistors
    [PikaPC_Mainboard.kicad_pcb, PikaPC_Mainboard.kicad_sch]
2025-11-02 Add vS3 ViRGE video & SD interface
    [PikaPC_Mainboard.kicad_pcb, PikaPC_Mainboard.kicad_sch]
2025-11-04 Peripheral Bus Control logic
    - ATF22V10C control logic for 5V peripheral bus
2025-11-08 cleanup keyboard logic
    - odds & ends found while wiring
    [PikaPC_Mainboard.kicad_pcb, PikaPC_Mainboard.kicad_sch]
2025-11-08 Invert system clock to ViRGE
    [PikaPC_Mainboard.kicad_pcb, PikaPC_Mainboard.kicad_sch]
2025-12-07 ViRGE schematic/layout cleanup
    [PikaPC_Mainboard.kicad_pcb, PikaPC_Mainboard.kicad_sch]
2025-12-07 ViRGE Strapping pulldowns should be on VMD not PD
    [PikaPC_Mainboard.kicad_pcb, PikaPC_Mainboard.kicad_sch]
2025-12-08 VGA output use full-size header, add ferrite beads
    [PikaPC_Mainboard.kicad_pcb, PikaPC_Mainboard.kicad_sch]
2025-12-15 Troubleshooting ViRGE communication
    - use A[25:23] for ViRGE SAUP[2:1] & M/IO# signals
    - add pull-up resistors to ViRGE ready & loca signals
    - adjust bank registers for new memory map
    - add forth test program for VGA init & ID
    [PikaPC_Mainboard.kicad_pcb, PikaPC_Mainboard.kicad_sch]
2025-12-17 ViRGE byte select fixes
    - swap data bus byte order
    - decode low address bits for write byte selects
    [PikaPC_Mainboard.kicad_pcb, PikaPC_Mainboard.kicad_sch]
2025-12-17 ViRGE byte select fixes 2
    - swap byte select output order on bus control logic
    - update VGA initialization forth program
    [PikaPC_Mainboard.kicad_pcb]
2025-12-28 New peripheral bus
    - additional bus transceivers for byte lane steering to VLB
    - replace 22V10 with 1504 for peripheral bus control logic
    [PikaPC_Mainboard.kicad_pcb, PikaPC_Mainboard.kicad_sch]
2026-01-03 New peripheral bus debugging
    - add pull-ups to bus transceiver enable signals for debugging
    - change reset pull-up to 1k to help with rise times
    - update bank registers configuration for new peripheral bus
    [PikaPC_Mainboard.kicad_pcb, PikaPC_Mainboard.kicad_sch]
2026-01-04 New peripheral bus control debugging
    - delay VLB ReadyIn on read cycles, sync to clock on write cycles
    - fix 32-bit VLB byte enable signals
    [PeripheralBus.sv]
2026-01-05 VRAM control debugging
    - add strapping resistors for slow vram cycles
    - fix swapped CAS2 & CAS3 pins on ViRGE symbol
    [PikaPC_Mainboard.kicad_pcb, PikaPC_Mainboard.kicad_sch]
2026-01-25 VRAM control debugging
    - correct clock edge for VLB ReadyIn
    - minor tweaks for S3 ViRGE symbol
    - add series resistors to VRAM control signals
    - add strapping resistor to support Trio64V+
    [PikaPC_Mainboard.kicad_pcb, PikaPC_Mainboard.kicad_sch]
2026-01-28 Start Host card
    initial schematic, start board layout
    [PikaPC_Host.kicad_pcb, PikaPC_Host.kicad_sch, bus_transceivers.kicad_sch, cpu_bus.kicad_sch, main_bus.kicad_sch, power.kicad_sch, rom.kicad_sch, serial.kicad_sch]
2026-01-30 Host card PCB layout
    [PikaPC_Host.kicad_pcb, bus_transceivers.kicad_sch, main_bus.kicad_sch]
2026-01-31 Rework bus pinout
    [PikaPC_Host.kicad_pcb, PikaPC_Host.kicad_sch, cpu_bus.kicad_sch, main_bus.kicad_sch]
2026-02-01 72-pin SIMM Card
    schematic & PCB layout
    [PikaPC_SIMM72.kicad_pcb, PikaPC_SIMM72.kicad_sch, main_bus.kicad_sch, power.kicad_sch, simm_sockets.kicad_sch]
2026-02-01 ViRGE video card initial schematic
    [PikaPC_ViRGE.kicad_sch, Video.kicad_sch, bus_transceivers.kicad_sch, main_bus.kicad_sch, power.kicad_sch, virge.kicad_sch, vram.kicad_sch]
2026-02-02 ViRGE card start PCB layout
    [PikaPC_SIMM72.kicad_sch, PikaPC_ViRGE.kicad_pcb, bus_transceivers.kicad_sch, main_bus.kicad_sch, power.kicad_sch, simm_sockets.kicad_sch, vram.kicad_sch]
2026-02-03 ViRGE card PCB layout
    [PikaPC_Host.kicad_pcb, PikaPC_ViRGE.kicad_pcb, Video.kicad_sch, bus_transceivers.kicad_sch, main_bus.kicad_sch, power.kicad_sch, vram.kicad_sch]
2026-02-04 Host Card refinement
    add main bus clock selection
    silkscreen cleanup
    [PikaPC_Host.kicad_pcb, PikaPC_Host.kicad_sch, bus_transceivers.kicad_sch, cpu_bus.kicad_sch, main_bus.kicad_sch]
2026-02-05 Rework Host Card bus clock
    add optional separate bus oscillator
    [PikaPC_Host.kicad_pcb, main_bus.kicad_sch]
2026-02-05 Power & Bus Termination card
    [PikaPC_Power.kicad_pcb, PikaPC_Power.kicad_sch]
2026-02-07 Add Keyboard Controller card
    [PikaPC_KBC.kicad_pcb, PikaPC_KBC.kicad_sch]
2026-02-07 Un-assign main bus pins 22 & 23
    [PikaPC_Host.kicad_pcb, PikaPC_Power.kicad_pcb, PikaPC_Power.kicad_sch, PikaPC_SIMM72.kicad_pcb, PikaPC_ViRGE.kicad_pcb, main_bus.kicad_sch, simm_sockets.kicad_sch]
2026-02-11 Annotate & prep for output - Host & KBC
    add gerber output to gitignore
    [PikaPC_Host.kicad_pcb, PikaPC_KBC.kicad_pcb, PikaPC_KBC.kicad_sch, bus_transceivers.kicad_sch, cpu_bus.kicad_sch, main_bus.kicad_sch, power.kicad_sch, rom.kicad_sch]
2026-02-15 Prep for output
    [PikaPC_Power.kicad_pcb, PikaPC_SIMM72.kicad_pcb, PikaPC_SIMM72.kicad_sch, PikaPC_ViRGE.kicad_pcb, Video.kicad_sch, bus_transceivers.kicad_sch, main_bus.kicad_sch, power.kicad_sch]
2026-02-15 Add IDE interface card
    [PikaPC_IDE.kicad_pcb, PikaPC_IDE.kicad_sch]
2026-02-28 Add prototyping card
    [PikaPC_IDE.kicad_pcb, PikaPC_Proto.kicad_pcb, PikaPC_Proto.kicad_sch]
2026-03-07 BoM updates
    [PikaPC_IDE.kicad_sch, PikaPC_Proto.kicad_sch]
2026-03-07 Add new bus to wire-wrap mainboard
    [PikaPC_Mainboard.kicad_pcb, PikaPC_Mainboard.kicad_sch]
2026-03-24 new bus control logic
    [PikaPC_Mainboard.kicad_pcb, PikaPC_Mainboard.kicad_sch]
2026-03-25 bus control timing fixes
    - correct sWAIT state to actually wait for ACKn signal
    - force state machine to idle if CSn[7..0] do not indicate active cycle
    - use falling edge of active cycle to reset STARTn immediately at end of cycle
    - assert byte enable signals during address state and through termination state
    [PikaPC_Host_Bus.sv]
2026-03-29 SIMM72 card logic
    [PikaPC_Mainboard.kicad_pcb, PikaPC_Mainboard.kicad_sch]
2026-04-03 fix low two expansion bus address bits
    [PikaPC_Host.kicad_pcb, PikaPC_Mainboard.kicad_pcb, PikaPC_Mainboard.kicad_sch, bus_transceivers.kicad_sch, main_bus.kicad_sch]
2026-04-03 add missing pull-ups on SRDY# & RDYIN#
    [PikaPC_ViRGE.kicad_pcb, main_bus.kicad_sch]
2026-04-03 Assert ADS# on falling edge & reset state on START# rising edge
    [PikaPC_ViRGE.sv]
2026-04-04 Add pull-up to LOCA# on ViRGE card
    [PikaPC_ViRGE.kicad_pcb, main_bus.kicad_sch]
2026-04-08 Fix output enable strobe on ViRGE card
    [PikaPC_ViRGE.sv]
2026-04-19 add pull-down resistors to AD bus
    [PikaPC_Mainboard.kicad_pcb, PikaPC_Mainboard.kicad_sch]
2026-05-01 Remove redundant SIP resistor from mainboard
    [PikaPC_Mainboard.kicad_sch]
2026-05-01 Add mini bus card
    [PikaPC_MiniBus.kicad_pcb, PikaPC_MiniBus.kicad_sch]
2026-05-01 Host Card updates
    - add missing bus pull-ups
    - add on-board DRAM
    - add series termination resistors to AD bus
    - fix DE9 footprint mounting hole location
    - fix double-buffered bus clock
    - use 74'2244 buffer w/series term resistors for bus control signals
    [PikaPC_Host.kicad_pcb, PikaPC_Host.kicad_sch, cpu_bus.kicad_sch, main_bus.kicad_sch, rom.kicad_sch]
2026-05-02 Add 2MB SRAM card
    [PikaPC_SRAM.kicad_pcb, PikaPC_SRAM.kicad_sch]
2026-05-03 updates for gerber output
    [PikaPC_Host.kicad_pcb, PikaPC_SRAM.kicad_pcb, main_bus.kicad_sch, rom.kicad_sch]
2026-05-24 Update ppcforth addresses for rev2 host card main memory
    - currently non-functional because exception handlers cannot branch from
    vector table in RAM to routines in ROM.
2026-05-24 Host card should not route A4/A5 to expansion bus
    [PikaPC_Host.kicad_pcb, bus_transceivers.kicad_sch]
